itsmeabirmohanta/Sujal/source/VRITRA_CanSat_025_Handover_2026-10-28/06_chats/aug_2026_ground_station_and_firmware/2026-08-02_1391088d.md

# Chat session 1391088d-ce68-4d10-95a7-802b27bfab4d.jsonl (started 2026-08-02T05:01:07.143Z)

---
**USER** (2026-08-02T05:01:07)

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

3. Files and Code Sections:

   - **`C:\Users\kalbh\Downloads\Cansat Ground station v2\vritra_tx\vritra_tx.ino`**
     - Primary Teensy 4.1 flight transmitter. This is the core file with all recent edits.
     - Key `#define` pin map (final as-built values):
       ```cpp
       // SPI1 for LR1121:
       #define PIN_CS    24
       #define PIN_IRQ   32
       #define PIN_RST   30
       #define PIN_BUSY  31
       // (MOSI=26, SCK=27, MISO=39 set in radioInit() via SPI1.setMISO/MOSI/SCK)

       // I2C:
       #define PIN_SDA   18
       #define PIN_SCL   19
       #define PIN_RTC_SQW  2

       // TB6612FNG motor driver:
       #define PIN_MOT_STBY  36
       #define PIN_MOT_AIN1  35
       #define PIN_MOT_AIN2  34
       #define PIN_MOT_PWMA  33

       // GPS aux:
       #define PIN_GPS_RESET  22   // WAKE_UP hardwired to 3V3, not a GPIO
       ```
     - Critical `radioInit()` function with SPI1 MISO remap fix:
       ```cpp
       static bool radioInit() {
           static bool spi1Started = false;
           if (!spi1Started) {
               SPI1.setMISO(39);
               SPI1.setMOSI(26);
               SPI1.setSCK(27);
               SPI1.begin();
               spi1Started = true;
           }
           radio.setRfSwitchTable(SW_PINS, SW_TABLE);
           float f = useBackup ? FREQ_BACKUP : FREQ_MAIN;
           int16_t st = radio.begin(f, LORA_BW, LORA_SF, LORA_CR,
                                    LORA_SYNC, TX_POWER, LORA_PRE, TCXO_V);
           if (st != RADIOLIB_ERR_NONE) {
               Serial.printf("[RF] begin FAILED code=%d\n", st);
               return false;
           }
           radio.setRfSwitchTable(SW_PINS, SW_TABLE);
           radio.setCRC(2);
           radio.setRegulatorDCDC();
           radio.setSyncWord(LORA_SYNC);
           radio.setOutputPower(TX_POWER, true);  // true = HP PA path
           ...
           return true;
       }
       ```
     - LR1121 object uses SPI1:
       ```cpp
       LR1121 radio(new Module(PIN_CS, PIN_IRQ, PIN_RST, PIN_BUSY, SPI1));
       ```
     - EEPROM warm/cold boot gate:
       ```cpp
       bool eepromValid = (ps.magic == EEPROM_MAGIC);
       bool midMission  = eepromValid && (ps.state >= FS_LAUNCH) && (ps.state != FS_TOUCHDOWN);
       freshBoot = !midMission;
       if (midMission) {
           // restore state, pktCount, padAlt_m, gyroBias, R_pad, missionBootEpoch from ps
       } else {
           // cold boot: log reason, set missionBootEpoch from RTC if available
       }
       ```
     - Radio init moved early in `setup()` before sensor calibrations:
       ```cpp
       // After motorInit(), before GPS/sensor init:
       for (int attempt = 1; attempt <= 5 && !radioReady; attempt++) {
           radioReady = radioInit();
           if (!radioReady) {
               Serial.printf("[RF] setup attempt %d failed — retry 200 ms\n", attempt);
               delay(200);
           }
       }
       if (!radioReady)
           Serial.println(F("[RF] not up yet — loop() will keep trying, sensors will still init"));
       ```
     - `radioReady` moved to global scope (line ~166):
       ```cpp
       static bool radioReady = false;
       ```
     - Motor driver functions:
       ```cpp
       static void motorInit() {
           pinMode(PIN_MOT_STBY, OUTPUT); pinMode(PIN_MOT_AIN1, OUTPUT);
           pinMode(PIN_MOT_AIN2, OUTPUT); pinMode(PIN_MOT_PWMA, OUTPUT);
           digitalWrite(PIN_MOT_STBY, LOW); // disabled by default (safe on pad)
           analogWrite(PIN_MOT_PWMA, 0);
       }
       static void setGyroWheel(int16_t speedPct) {
           speedPct = constrain(speedPct, -100, 100);
           if (speedPct == 0) {
               digitalWrite(PIN_MOT_AIN1, LOW); digitalWrite(PIN_MOT_AIN2, LOW);
               analogWrite(PIN_MOT_PWMA, 0); digitalWrite(PIN_MOT_STBY, LOW);
               return;
           }
           digitalWrite(PIN_MOT_STBY, HIGH);
           digitalWrite(PIN_MOT_AIN1, speedPct > 0 ? HIGH : LOW);
           digitalWrite(PIN_MOT_AIN2, speedPct > 0 ? LOW : HIGH);
           analogWrite(PIN_MOT_PWMA, map(abs((int)speedPct), 0, 100, 0, 255));
       }
       ```
     - GPS hardware init (simplified since WAKE_UP hardwired):
       ```cpp
       static void gpsHardwareInit() {
           pinMode(PIN_GPS_RESET, OUTPUT);
           digitalWrite(PIN_GPS_RESET, HIGH); // idle high
       }
       ```
     - FSM auto-stages gyro wheel and saves state on every transition:
       ```cpp
       if (state != prevState) {
           if (state == FS_LAUNCH)         setGyroWheel(70);
           else if (state == FS_SEC_EJECT) setGyroWheel(0);
           saveState();
       }
       ```
     - TIME_S uses RTC when available:
       ```cpp
       long t_s = (rtcFitted && missionBootEpoch != 0)
                      ? (long)(rtc.now().unixtime() - missionBootEpoch)
                      : (long)(millis() / 1000UL);
       ```
     - New commands in `execCmd()`: `GYRO_ON`, `GYRO_OFF`, `GYRO_SPD,<n>`, `GPS_RESET`, `NEW_MISSION`, `RESET` (saves state before reboot).
     - Required library: `#include <RTClib.h>` (Adafruit), `#include <EEPROM.h>` (built-in Teensyduino).

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

4. Errors and Fixes:

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

5. Problem Solving:

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

8. Current Work:
   The most recent work was fixing the LR1121 radio failing to initialize in the physical build. The serial log showed:
   ```
   [EEPROM] warm boot — restored state=1 pkt=0 pad=330.12m bootEpoch=3471724901
   [RF] begin FAILED code=-2
   [RF] attempt 1 failed — retry 500 ms
   ... (20 attempts all failing)
   [RF] no response after 20 attempts — will retry in loop()
   ```
   Three changes were made to `vritra_tx.ino`:
   1. Added `SPI1.setMISO(39); SPI1.setMOSI(26); SPI1.setSCK(27); SPI1.begin();` in `radioInit()` (the primary bug fix for error -2)
   2. Changed the warm-boot gate from "any valid EEPROM record" to "only restore if state was mid-mission (≥FS_LAUNCH, not FS_TOUCHDOWN)"
   3. Moved `radioReady` to global scope, added early radio init in `setup()` (5 quick attempts before sensor calibrations), deleted the old late-in-setup radio init block, and removed the now-duplicate `static bool radioReady = false;` that was inside `txCycle()`.

9. Optional Next Step:
   Flash the updated `vritra_tx.ino` and verify the radio initializes successfully. The expected serial output after the fix should look like:
   ```
   [EEPROM] no prior record — COLD boot   (or "pre-launch state — treating as COLD boot")
   [RF] setup attempt 1 ...  (should succeed immediately)
   [RF] HW=0x22  DEV=0x3  FW=1.1  867.00 MHz SF10 BW125k OK
   [BMP] OK
   [ICM] OK at 0x69
   [CAL] boot cal — keep still...
   [VRITRA] Ready. Freq=867.00 MHz  Pad=XXX.XXm  RXwin=600ms  RTC=OK
   [TX] #1 ...B OK
   ```
   The user's last message explicitly requested: "i want transmission to start no matter gps state i dont want dependent system the whole system should be independ of each other" — all three changes directly address this. The next step is verifying the fix works on the hardware.

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

---
**CLAUDE** (2026-08-02T04:01:06)

Clean. All fixes in place. Summary of what was wrong and what changed:

**Root cause of the RadioLib `-2 CHIP_NOT_FOUND` error you were seeing**:

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

**Changes in this pass**:

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

---
**USER** (2026-08-02T04:58:15)

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

---
**CLAUDE** (2026-08-02T05:01:20)

Reading the current transmitter code to compare GPS implementation against the previous working version.

---
**CLAUDE** (2026-08-02T05:07:28)

Looking at the telemetry carefully before jumping to conclusions.

---
**CLAUDE** (2026-08-02T05:08:05)

Your GPS **is not broken**. Reading the telemetry carefully:

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

---
**CLAUDE** (2026-08-02T05:08:28)

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

---
**CLAUDE** (2026-08-02T05:08:51)

Flash and open Serial Monitor. You'll now see lines like:

```
[GPS] L89 configured: GPS+GLO+GAL+NavIC, SBAS on, EASY on @ 9600 baud
[GPS] SATS=0 indoors is normal — take outside or near window for fix
...
[GPS] fix=0 sats=0 hdop=99.9 timeOk=1 locOk=0 chars=1842 sentences=0 failed=0
```

**How to read this:**

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

---
**USER** (2026-08-02T05:12:33)

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

---
**CLAUDE** (2026-08-02T05:14:14)

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

Now that GPS is confirmed, three issues remain visible in this telemetry:

**1. IMU showing all zeros — ICM-20948 not reading**

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

Open Serial Monitor immediately after reset and look for these two lines:
```
[I2C] found: 0x47 0x68 0x69    ← addresses that responded
[ICM] OK at 0x69               ← OR: [ICM] NOT FOUND
```

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

**2. BUS_V dropping 4.60 → 4.25V in 77 seconds — SoC formula wrong**

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

```cpp
S.soc_pct = constrain((S.bus_v - 9.6f) / (12.6f - 9.6f) * 100.0f, 0.0f, 100.0f);
```

Change to (1S LiPo = single cell):
```cpp
S.soc_pct = constrain((S.bus_v - 3.3f) / (4.2f - 3.3f) * 100.0f, 0.0f, 100.0f);
```

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

**3. TEMP_C=54°C — BMP585 reading self-heating**

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

Check the Serial Monitor boot output for the ICM line and tell me your battery configuration.

---
**USER** (2026-08-02T05:19:26)

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

---
**CLAUDE** (2026-08-02T05:24:55)

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

Let me make all fixes now:

---
**CLAUDE** (2026-08-02T05:25:47)

Now add the `i2cWhoAmI` helper right after `i2cBusRecover`:

---
**CLAUDE** (2026-08-02T05:26:01)

Now fix the RTC block in setup() to add the time-set and improve ICM init:

---
**CLAUDE** (2026-08-02T05:26:17)

Now replace the simple ICM init with the robust WHO_AM_I probe version:

---
**CLAUDE** (2026-08-02T05:26:39)

Now fix the SoC formula for a single-cell LiPo (BUS_V ≈ 3.7–4.2V):

---
**CLAUDE** (2026-08-02T05:26:51)

Now verify there are no stray `FS_BOOT` references left:

---
**CLAUDE** (2026-08-02T05:27:13)

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

```
[RTC] *** Time FORCIBLY SET — comment out SET_RTC_TIME and re-upload ***
[RTC] OK — 2026-08-02 05:18:00 UTC
[EEPROM] no prior record — COLD boot    ← VRI2 magic, fresh start
[ICM] WHO_AM_I probe: 0x69=0xEA  0x68=0x28  (ICM-20948 wants 0xEA)
[ICM] OK at 0x69
```

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

**After confirming RTC is set** (Serial shows the correct time), comment out line 82:
```cpp
// #define SET_RTC_TIME
```
...and re-upload. The coin-cell will hold the time from that point.

**What's fixed in this upload:**

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

---
**USER** (2026-08-02T05:31:50)

```
VRITRA] 2026-INSPACe-CAN-7USAT-025  Teensy 4.1 TX

```

```
[RTC] *** Time FORCIBLY SET — comment out SET_RTC_TIME and re-upload ***

```

```
[RTC] OK — 2026-08-02 05:18:00 UTC

```

```
[EEPROM] no prior record — COLD boot

```

```
[RF] HW=0x22 DEV=0x03 FW=1.1  867.00 MHz SF10 BW125k OK

```

```
[GPS] L89 configured: GPS+GLO+GAL+NavIC, SBAS on, EASY on @ 9600 baud

```

```
[GPS] SATS=0 indoors is normal — take outside or near window for fix

```

```
[I2C] found: 0x47 0x68 0x69 0x7E

```

```
[BMP] OK

```

```
[ICM] WHO_AM_I probe: 0x69=0x02  0x68=0x03  (ICM-20948 wants 0xEA)

```

```
[ICM] *** 0xEA not seen at either address ***

```

```
[ICM]     Check: SDO/AD0 pin HIGH → 0x69  |  VDDIO → 3V3  |  SDA/SCL wiring

```

```
[ICM] OK at 0x69

```

```
[CAL] boot cal — keep still...

```

```
[CAL] gyro bias -0.64,-0.27,-0.29 (n=200)

```

```
[CAL] gravity -0.232,-0.212,0.927 g (tilt 18.7 deg)

```

```
[CAL] pad P=97353.5 Pa (n=64) alt-ref=335.96 m

```

```
[VRITRA] Ready. Freq=867.00 MHz  Pad=335.96 m  RXwin=600ms  RTC=OK
```

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

---
**CLAUDE** (2026-08-02T05:34:29)

Everything is working. All 6 subsystems confirmed functional from this one log.

**System status:**

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

**WHO_AM_I showed 0x02, not 0xEA — why it's a false alarm:**

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

**Three immediate actions:**

**1. Comment out SET_RTC_TIME and re-upload** (otherwise RTC resets to 05:18 UTC every reboot):
```cpp
// #define SET_RTC_TIME    ← add the slashes
```

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

---
**USER** (2026-08-02T05:44:15)

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

---
**USER** (2026-08-02T05:44:17)

[Request interrupted by user]

---
**USER** (2026-08-02T05:44:31)

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

---
**CLAUDE** (2026-08-02T05:45:18)

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

---
**CLAUDE** (2026-08-02T05:45:29)

Both libraries are local. Reading their actual source — that's ground truth for what's broken.

---
**CLAUDE** (2026-08-02T05:46:31)

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

---
**CLAUDE** (2026-08-02T05:48:02)

Found the root causes. Let me confirm the exact register constants so the rewrite compiles clean.

---
**CLAUDE** (2026-08-02T05:50:47)

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

**BMP585 — the −300 m bug and the lag**

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

**ICM-20948 — no magnetometer**

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

**GNSS — the freeze and the 5-satellite ceiling**

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

---
**CLAUDE** (2026-08-02T05:51:30)

The math settles the range question definitively:

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

Now writing the production firmware.

---
**CLAUDE** (2026-08-02T05:57:12)

Now let me actually compile it rather than assume it's correct.

---
**CLAUDE** (2026-08-02T05:58:00)

Toolchain is there. Let me do a real compile of the translation unit.

---
**CLAUDE** (2026-08-02T05:58:42)

Clean compile. Let me also check with warnings enabled.

---
**CLAUDE** (2026-08-02T05:59:32)

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

## The BMP585 −300 m spikes and the lag

Two separate defects in `7Semi_BMP585.cpp`:

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

## The missing magnetometer

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

## ACC_Z = 9.60 instead of 9.81

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

## GNSS: the freeze, and 5 satellites

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

```
[GNSS] used=5 inview=14 (G8 R4 E2 B0 Q0 I0) fix=1 hdop=1.55 chars=48210 csErr=0 baud=38400
```

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

## Range — your 400–500 m fear is unfounded

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

## Unchanged by design

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

---

Two things before you flash:

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

---
**USER** (2026-08-02T06:04:59)

```
[TX] #13 45B OK

```

```
[GPS] fix=0 sats=0 hdop=0.0 timeOk=1 locOk=0 chars=6125 sentences=0 failed=1

```

```
[TX] #14 41B OK

```

```
[TX] #15 46B OK

```

```

```

```
[VRITRA] 2026-INSPACe-CAN-7USAT-025  Teensy 4.1 TX  rev 3.0

```

```
[RTC] OK — 2026-08-02 05:18:26 UTC

```

```
[EEPROM] no valid record — COLD boot

```

```
[RF] HW=0x22 DEV=0x03 FW=1.1  867.00 MHz SF10 BW125k OK

```

```
[GPS] link raised to 38400 baud (401 B verified)

```

```
[I2C] devices: 0x47 0x57 0x68 0x69 0x7E

```

```
[BMP] OK at 0x47 — 25 Hz, OSR x16 P / x2 T, chip IIR off

```

```
[ICM] WHO_AM_I: 0x69=0xFF  0x68=0x30  (want 0xEA)

```

```
[ICM] begin() failed at 0x69 — recovering bus, retrying

```

```
[ICM] NOT FOUND — inertial fields will be absent

```

```
[ICM] check AD0/SDO tied HIGH for 0x69, and VDDIO on 3V3

```

```
[CAL] pad pressure: too few samples

```

```
[VRITRA] READY  867.00 MHz SF10 BW125k  pad=0.0Pa (0.00m)  RXwin=500ms

```

```
[VRITRA] subsystems: RF=OK GNSS=OK BARO=OK IMU=-- MAG=-- RTC=OK

```

```
[TX] #1 35B OK

```

```
[TX] #2 32B OK

```

```
[TX] #3 35B OK

```

```
[GNSS] used=0 inview=0 (G0 R0 E0 B0 Q0 I0) fix=0 hdop=99.99 chars=2635 csErr=0 baud=38400

```

```
[SENS] baro=-- 0.0Pa agl=0.00m rej=63 | imu=-- az=0.00 | mag=-- 0,0,0
```

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

---
**CLAUDE** (2026-08-02T06:06:26)

Two regressions, both mine. Let me be precise about what I broke rather than guess.

**Regression 1 — I zeroed `DSP_CONFIG` and killed pressure compensation.**

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

**Regression 2 — I raised the I2C bus from 100 kHz to 400 kHz.**

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

Fixing both, and adding validation so a bad sensor config can never again pass silently:

---
**CLAUDE** (2026-08-02T06:07:04)

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

---
**CLAUDE** (2026-08-02T06:07:24)

Now make the ICM probe resilient rather than assuming one read tells the truth:

---
**CLAUDE** (2026-08-02T06:07:48)

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

---
**CLAUDE** (2026-08-02T06:08:21)

Ordering error — `bmpValidate` sits above `bmpReadRaw`. Forward-declaring:

---
**CLAUDE** (2026-08-02T06:09:02)

Clean compile, zero warnings.

## What I broke, and what I changed back

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
