itsmeabirmohanta/Sujal/research/extracted/frequency_page_1.png

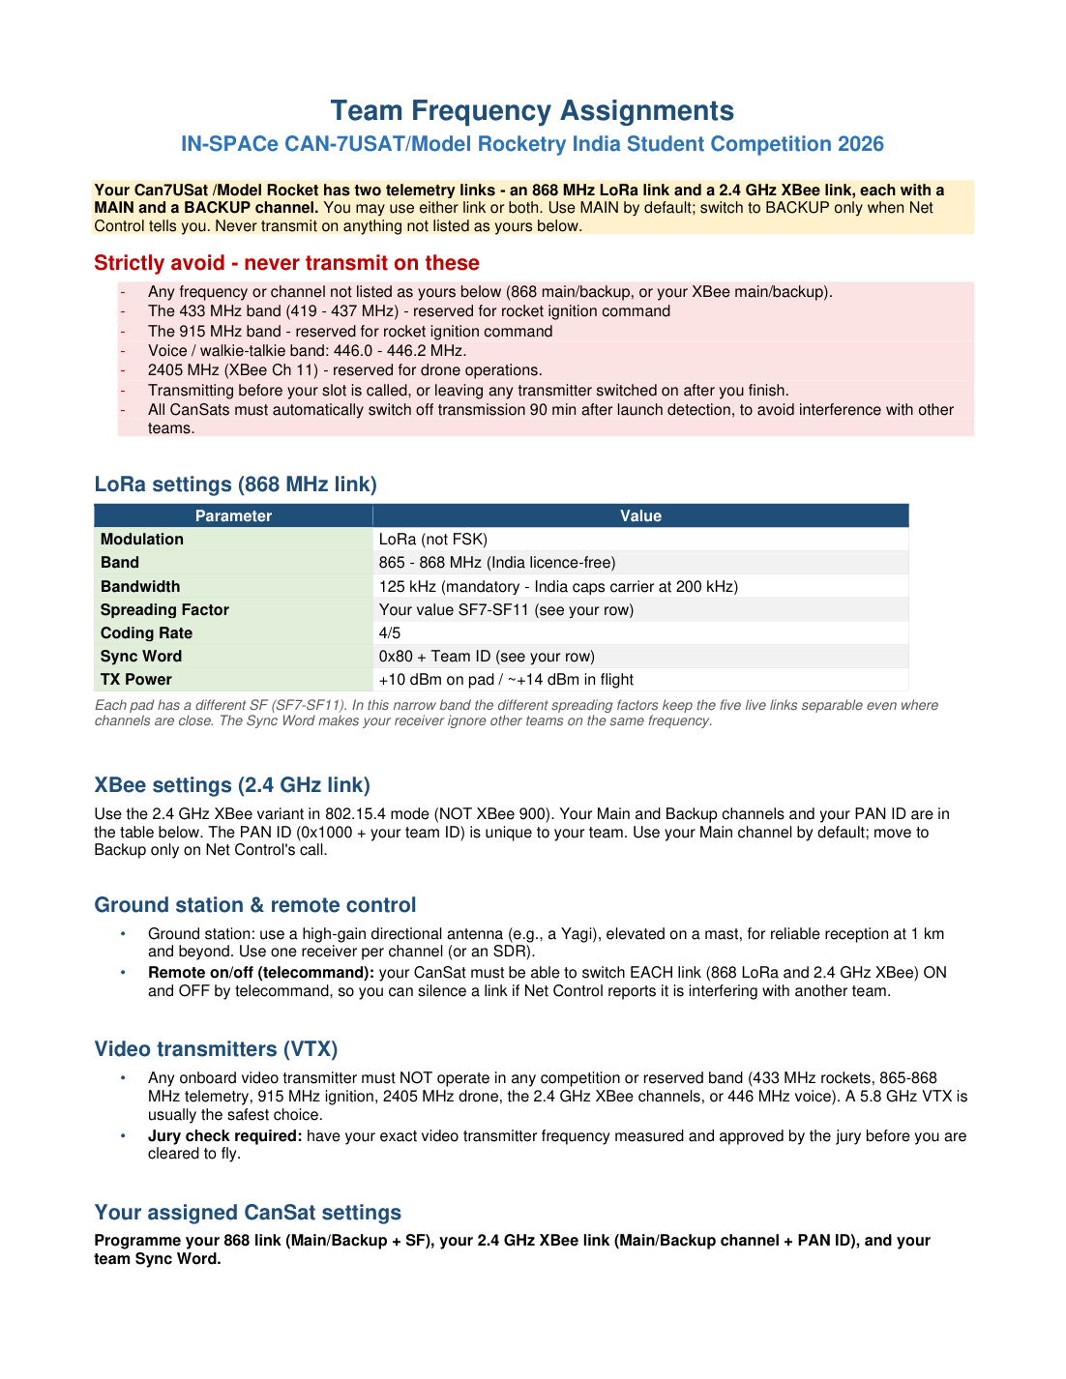
research/extracted/frequency_page_1.png
