itsmeabirmohanta/Sujal/research/extracted/frequency_page_2.png

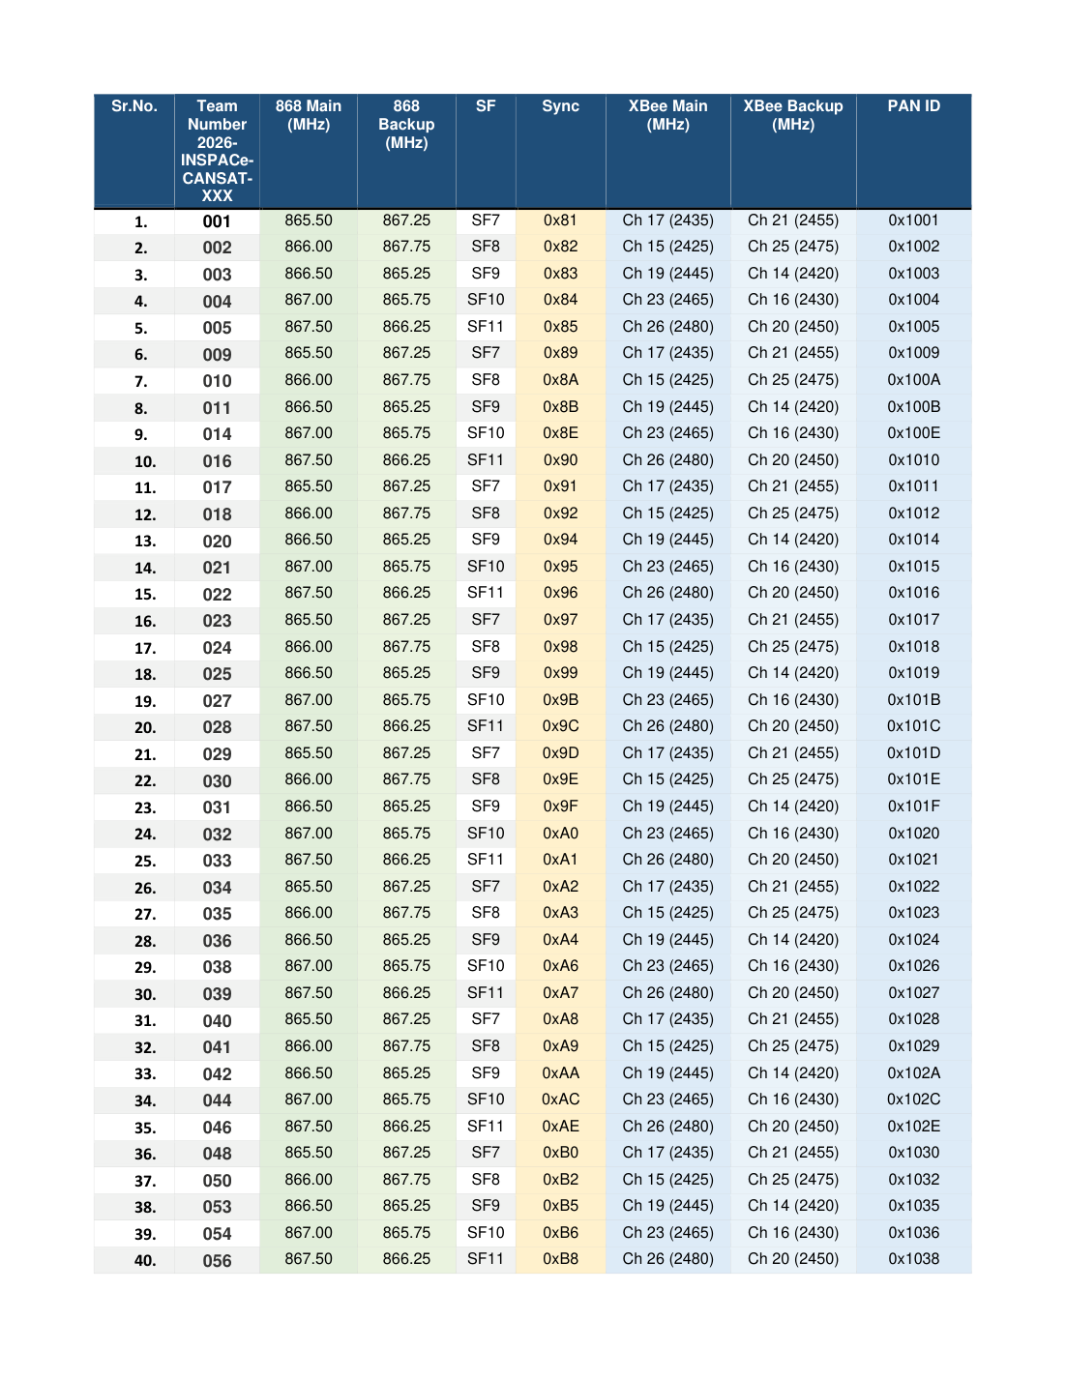
research/extracted/frequency_page_2.png
