itsmeabirmohanta/Sujal/research/extracted/frequency_page_3.png

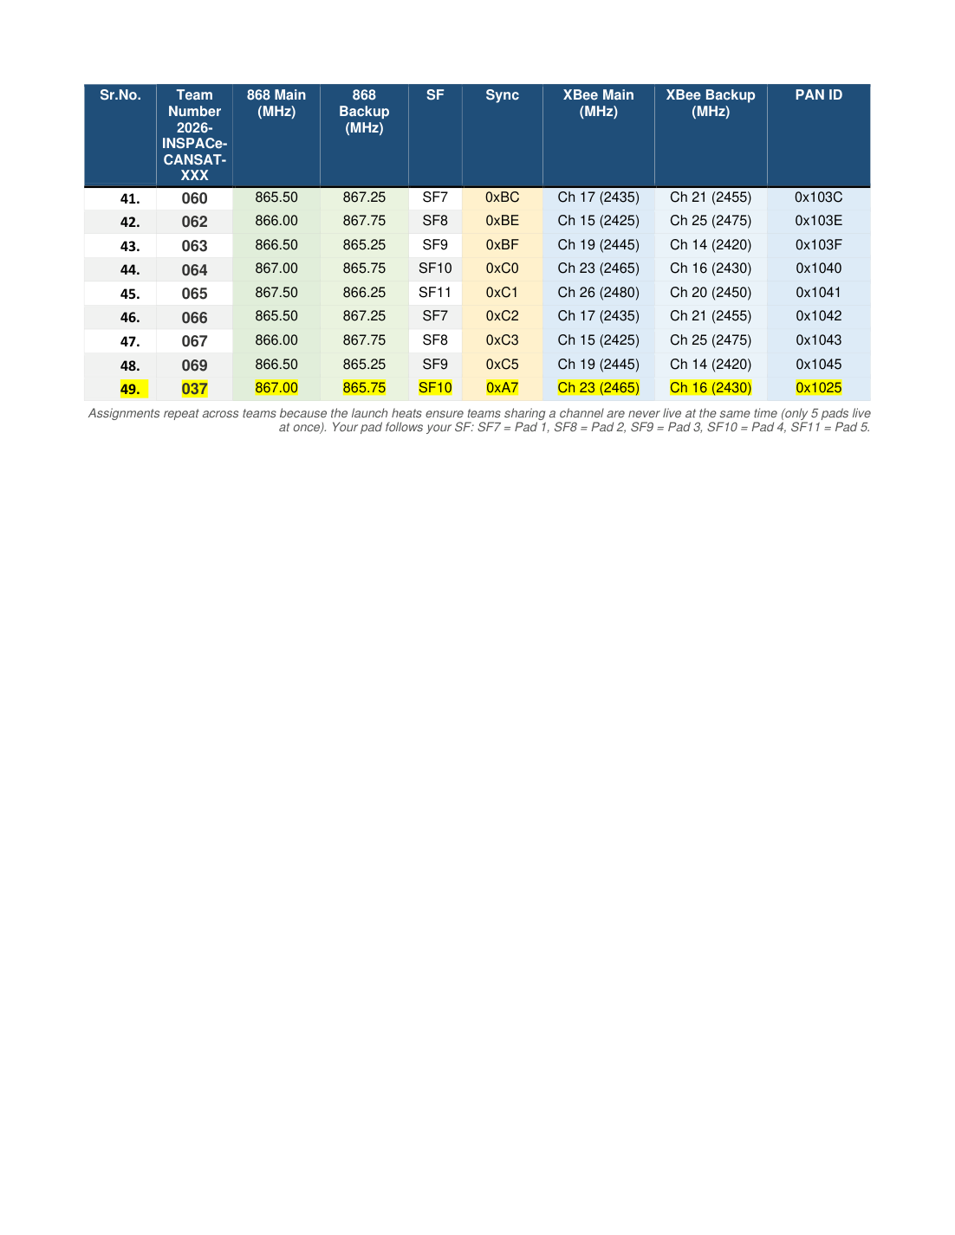
research/extracted/frequency_page_3.png
