itsmeabirmohanta/Sujal/source/VRITRA_CanSat_025_Handover_2026-10-28/03_kicad_current_boards/BOARD1_MAIN_Teensy41/BOARD1_MAIN_1L.png

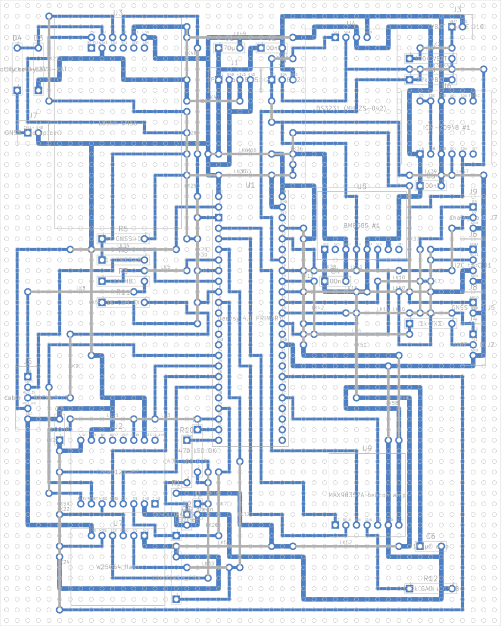
source/VRITRA_CanSat_025_Handover_2026-10-28/03_kicad_current_boards/BOARD1_MAIN_Teensy41/BOARD1_MAIN_1L.png
