itsmeabirmohanta/Sujal/source/VRITRA_CanSat_025_Handover_2026-10-28/03_kicad_current_boards/BOARD2_BACKUP_SENSOR_Teensy41/BOARD2_BACKUP_SENSOR_1L.png

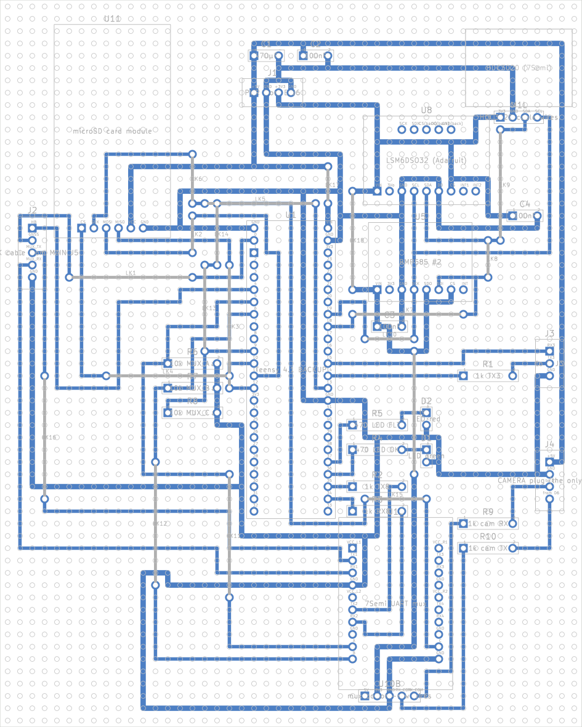
source/VRITRA_CanSat_025_Handover_2026-10-28/03_kicad_current_boards/BOARD2_BACKUP_SENSOR_Teensy41/BOARD2_BACKUP_SENSOR_1L.png
