itsmeabirmohanta/Sujal/source/VRITRA_CanSat_025_Handover_2026-10-28/03_kicad_current_boards/BOARD3_POWER/BOARD3_POWER_1L.png

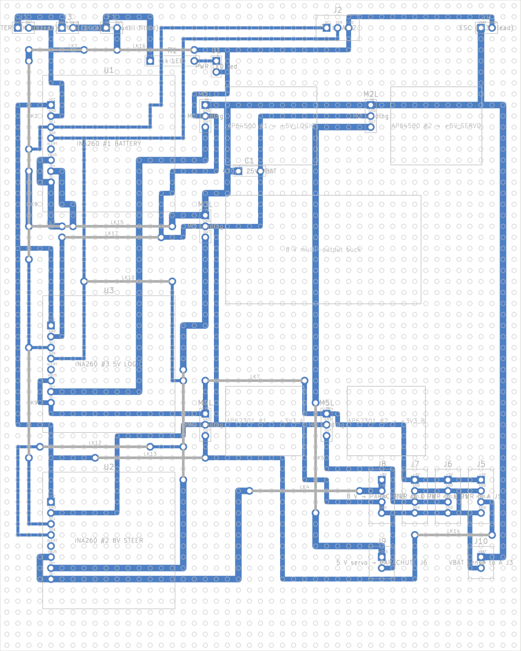
source/VRITRA_CanSat_025_Handover_2026-10-28/03_kicad_current_boards/BOARD3_POWER/BOARD3_POWER_1L.png
