itsmeabirmohanta/Sujal/source/VRITRA_CanSat_025_Handover_2026-10-28/03_kicad_current_boards/BOARD4_PARACHUTE_ESP32-P4-Pico/BOARD4_PICO_BOTTOM.png

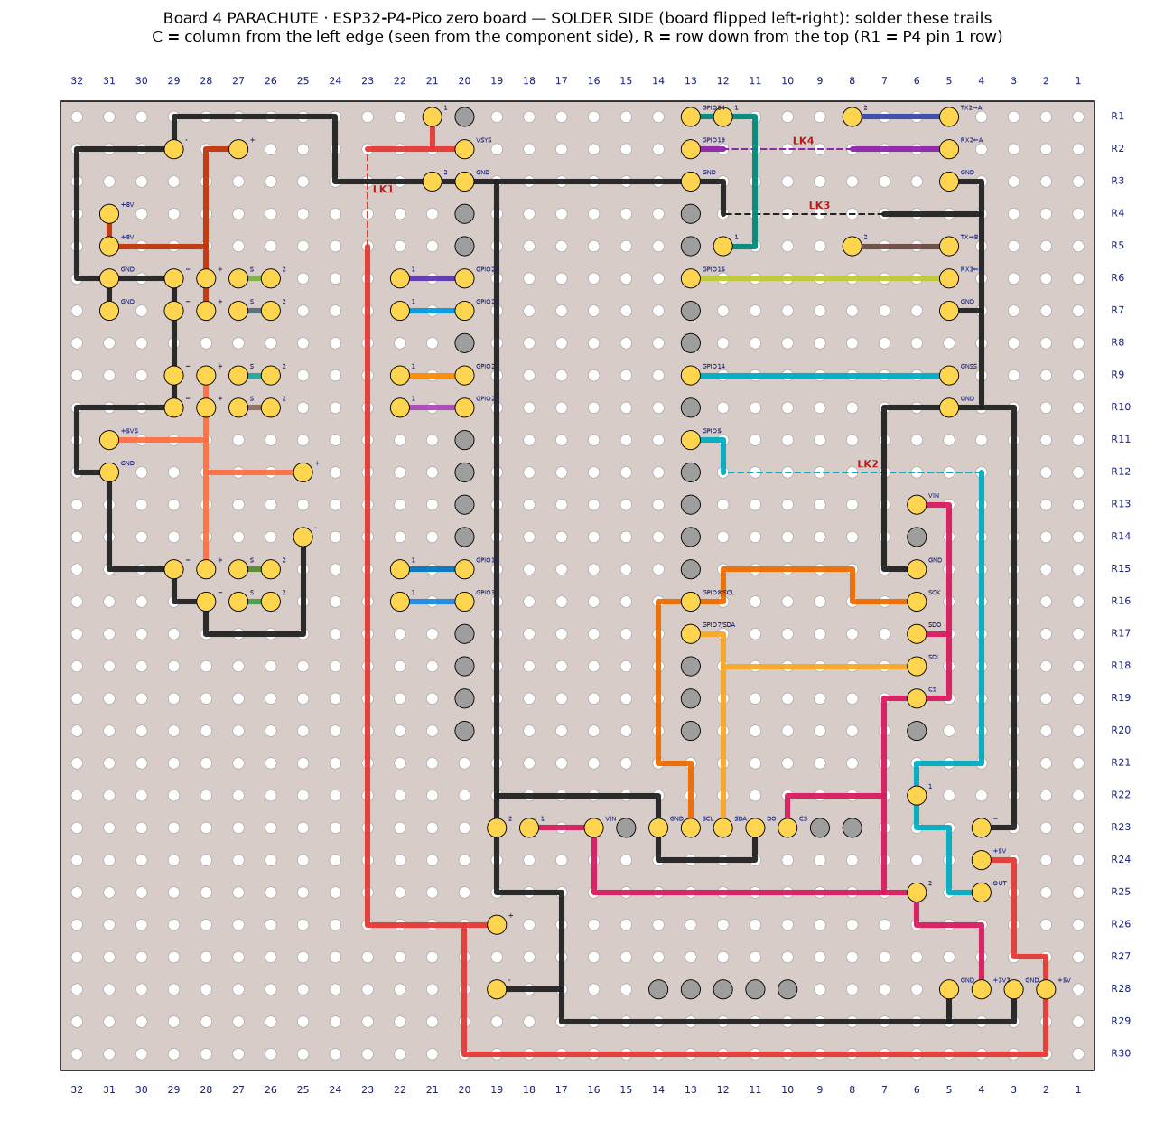
source/VRITRA_CanSat_025_Handover_2026-10-28/03_kicad_current_boards/BOARD4_PARACHUTE_ESP32-P4-Pico/BOARD4_PICO_BOTTOM.png
