itsmeabirmohanta/Sujal/source/VRITRA_CanSat_025_Handover_2026-10-28/03_kicad_current_boards/board_to_board_connectors/BOARD3_POWER_connectors.png

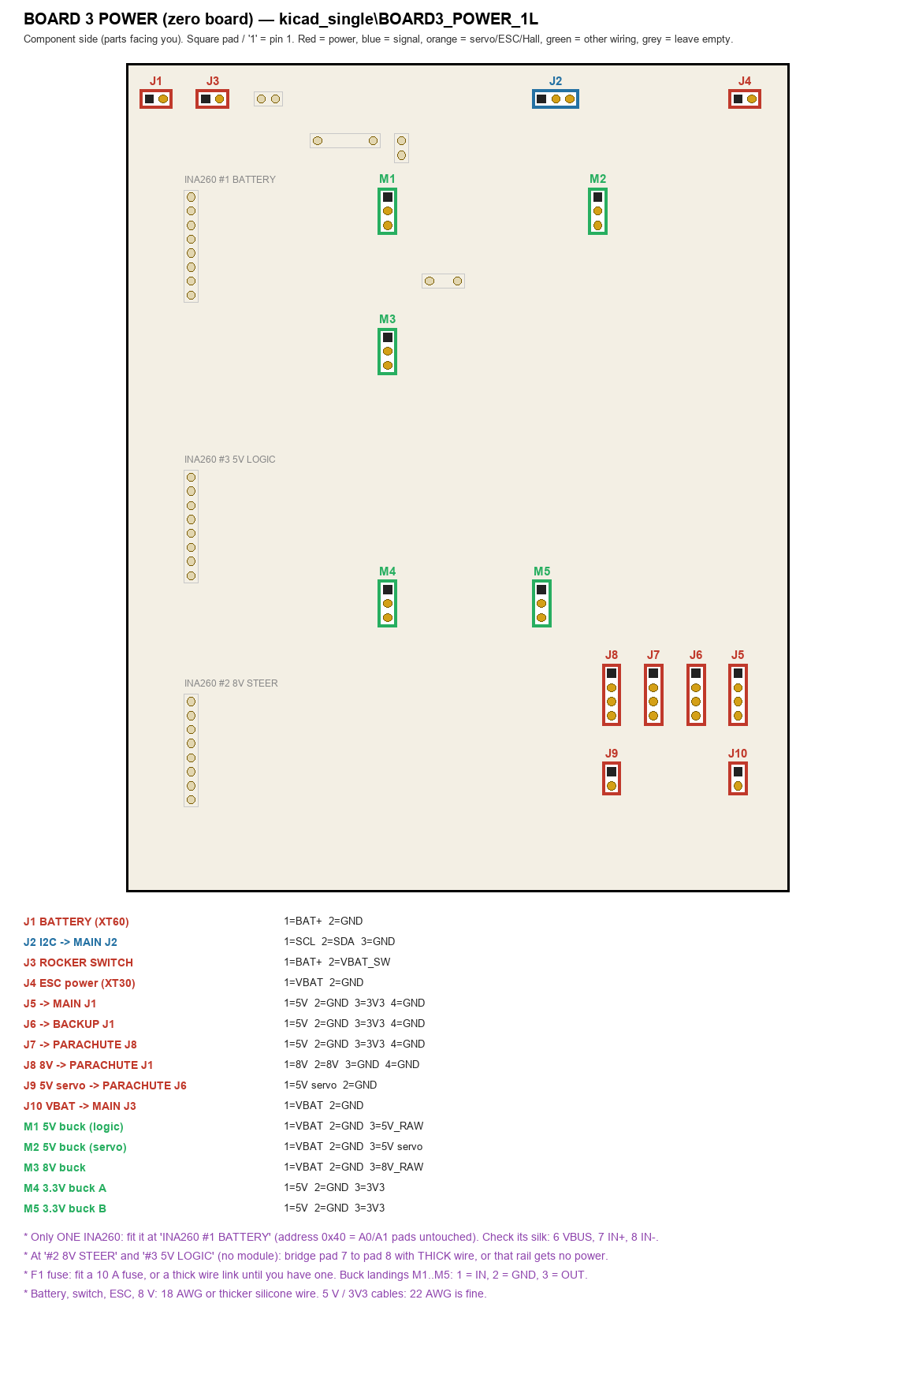
source/VRITRA_CanSat_025_Handover_2026-10-28/03_kicad_current_boards/board_to_board_connectors/BOARD3_POWER_connectors.png
