itsmeabirmohanta/Sujal/source/VRITRA_CanSat_025_Handover_2026-10-28/05_code/vritra-gcs-master_(CURRENT_repo)/firmware/vritra_cam/BOARD2_CAMERA_WIRES.png

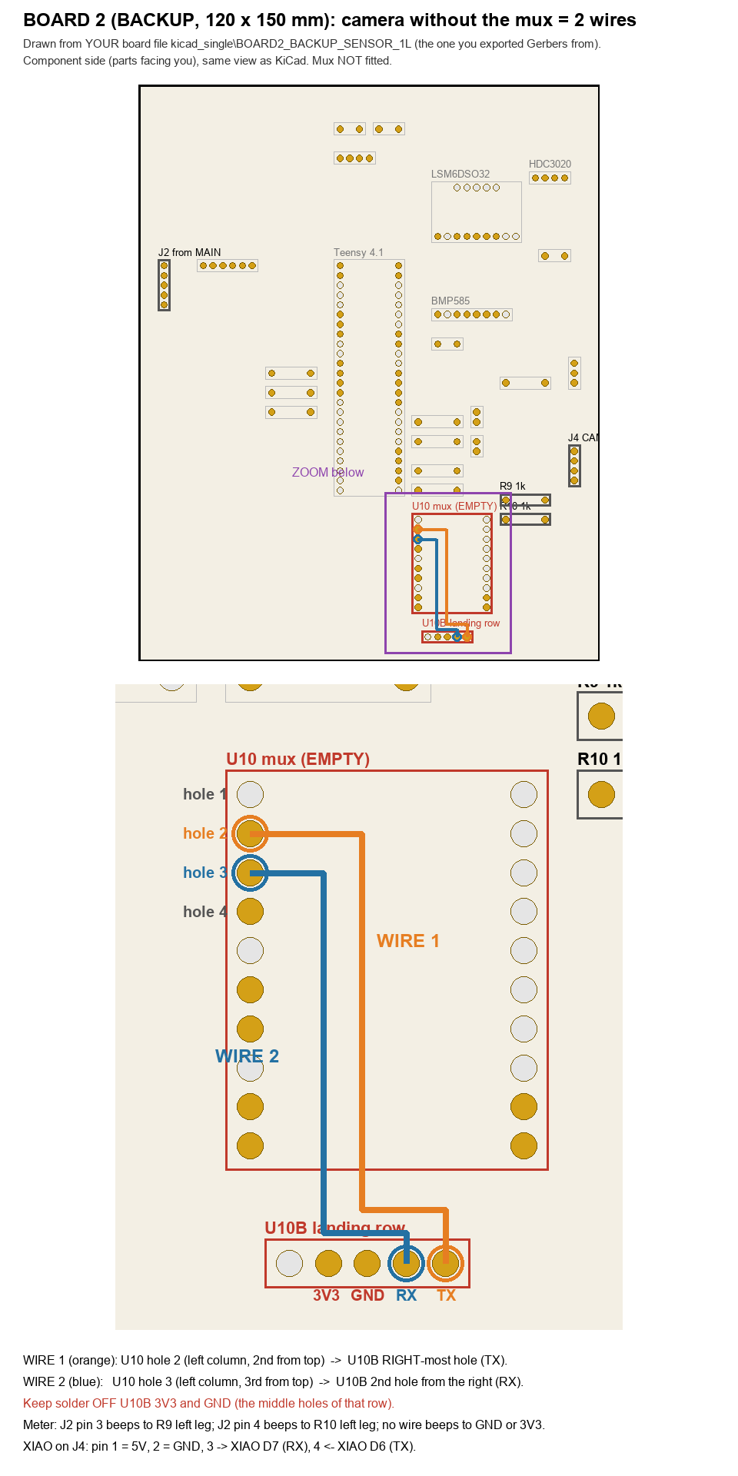
source/VRITRA_CanSat_025_Handover_2026-10-28/05_code/vritra-gcs-master_(CURRENT_repo)/firmware/vritra_cam/BOARD2_CAMERA_WIRES.png
