itsmeabirmohanta/Sujal/deliverables/TEST_EVIDENCE_TEMPLATE.csv

Test_ID | Method_and_acceptance | Status | Named_owner | Build_and_calibration_IDs | Date_UTC | Observed_result | Evidence_path_or_URL | Reviewer
T-PINS | Power-off continuity against ICD; check logic voltages, pull-ups, backfeeding and CS idle states; scope all GNSS listeners at both bauds | PENDING
T-BOOT | Cold/soft resets of each real board; no sweep/throttle; correct journal restore and RF silence; record P4 revision/options | PENDING
T-SENSOR | Read identities/configuration, sample counters and physical units; run supported self-tests; inject disconnects and stuck devices; reject0xFF | PENDING
T-GNSS | Record commands/ACKs/readbacks; measure1/5/10 Hz epochs, UART overflows, constellation trials, reboot and backup retention | PENDING
T-NAV | Reject checksum errors, RMC V, q0/DR, malformed coordinates, NaN, stale GSA, mixed/duplicate epochs, future timestamps and replay/default origins | PENDING
T-BARO | Pressure ramps at glide and drogue rates; physical opening must meet600±10 m including every error and delay | PENDING
T-EVENT | Descending950 m crossing, ascent inhibit, reset below threshold and reset before/during/after10 s exposure; no extra reopening | PENDING
T-INHIBIT | Lift, hover and attached-drone descent without release confirmation; no bay/petri/steering; test delayed/lost confirmation | PENDING
T-FSM | Actual drone profile with transient pressure/shock; correct states0–7, launch clock, pad datum and reset recovery | PENDING
T-LINK | Unplug MAIN, BACKUP and raw GNSS separately; inject CRC/sequence/one-way failures; verify authority and local P4 operation | PENDING
T-TARGET | Partial, repeated, old-session and out-of-area updates; int32 bounds; atomic commit and correct P4 echo | PENDING
T-RF | Capture actual RF CSV/CR/cadence, byte lengths and command slots; test TX ON/OFF, authorised channel switch, power/range and90-minute cutoff | PENDING
T-RESET | Reset at each phase and journal/ACK boundary, including89:59; corrupt one/both slots; no cutoff override or unsafe rollback | PENDING
T-LOG | Disconnect RF; fill/remove/slow SD; force flash timeout; control continues and records retain CRC/source/sample time | PENDING
T-POWER | Actual combined-load endurance for2 h pad plus flight; scope rails at loads; test overshoot, wheel startup, connectors and retention | PENDING
T-HALL/T-WHEEL | Tachometer/PPR agreement, stuck/noisy input, stop response, balance and rotor containment | PENDING
T-TIMING | Capture sample/parse/planner/PWM under full load; verify §8.5 targets, progress watchdog and deadline margins | PENDING
T-GCS/T-ISOLATE | Real serial→plots→judges CSV; missing data stays missing; simulation/replay cannot reach outputs or the flight file | PENDING
T-GLIDE/T-GUIDE | Authorised repeated drops: inflation,1–3 m/s sink, brake sign/response, safe authority, wind observability and independently measured landing error | PENDING
T-BEACON | Measure at least92 dB using the agreed setup, assembled enclosure and representative battery condition | PENDING
