itsmeabirmohanta/Sujal/source/VRITRA_CanSat_025_Handover_2026-10-28/04_handover_and_design_docs/parafoil_study/03_geom/canopy_domed_metres.stl

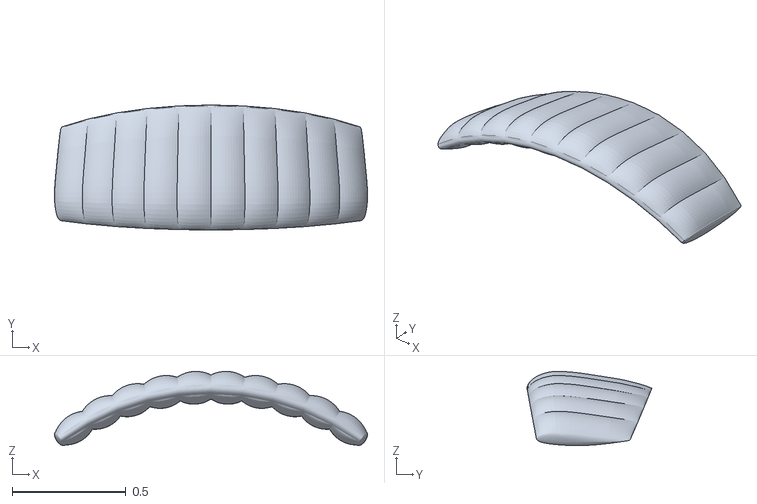
[picture p19: CAD file, 2026-10-28]
source/VRITRA_CanSat_025_Handover_2026-10-28/04_handover_and_design_docs/parafoil_study/03_geom/canopy_domed_metres.stl
1.38 x 0.55 x 0.327
