itsmeabirmohanta/Sujal/source/VRITRA_CanSat_025_Handover_2026-10-28/09_mechanical/VRITRA_CanSat.step

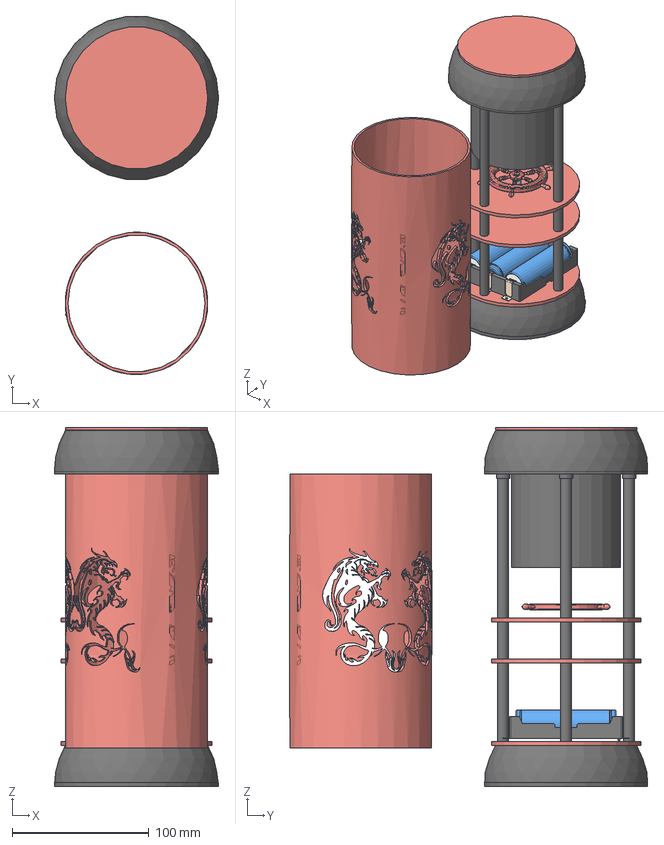
[picture p20: CAD file, 2026-10-28]
source/VRITRA_CanSat_025_Handover_2026-10-28/09_mechanical/VRITRA_CanSat.step
120.0 x 261.6 x 262.1 mm
wholecan
gyroplate x 3
Coreless_Motor_716
Ship wheel
perachute-bay
operplate
shellcanset
Hold_21700_Con_smd_m x 3
Hold_21700_Con_smd_p x 3
Hold_21700-3p_smd
