itsmeabirmohanta/Sujal/source/VRITRA_CanSat_025_Handover_2026-10-28/04_handover_and_design_docs/parafoil_study/03_geom/canopy_lower_metres.stl

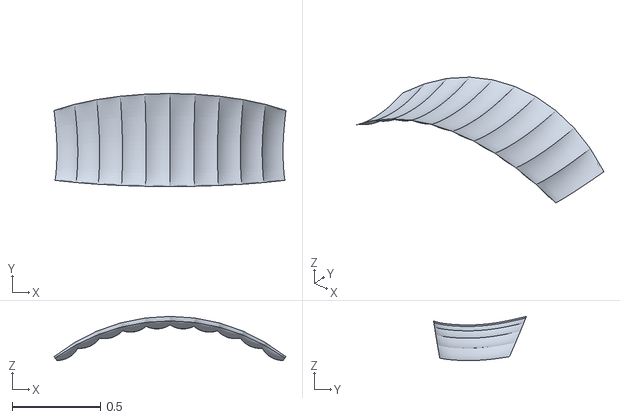
[picture p22: CAD file, 2026-10-28]
source/VRITRA_CanSat_025_Handover_2026-10-28/04_handover_and_design_docs/parafoil_study/03_geom/canopy_lower_metres.stl
1.31 x 0.527 x 0.25
