itsmeabirmohanta/Sujal/(list of files, cad)

Other CAD files:
source/VRITRA_CanSat_025_Handover_2026-10-28/04_handover_and_design_docs/parafoil_study/08_tailor/PF072_cutting_layered.dxf
source/VRITRA_CanSat_025_Handover_2026-10-28/04_handover_and_design_docs/parafoil_study/03_geom/canopy_merged_metres.stl
