itsmeabirmohanta/Sujal/source/VRITRA_CanSat_025_Handover_2026-10-28/03_kicad_current_boards/BOARD1_MAIN_Teensy41/BOARD1_MAIN_1L_BUILD_LIST.md

# VRITRA MAIN board — SINGLE-LAYER build list (same routes as the KiCad file)

Hole = C(column, 1 = left on the component side) R(row, 1 = bottom).
TRAIL = solder trail / bare tinned wire on the solder side, every hole in the run soldered, 90° turns only.
LINK = straight insulated wire link on the component side between the two holes (it jumps over other trails).

## GND
- pins: U1.GND (C27R40), U1.GND (C21R41), U1.GND (C27R27), U2.GND (C14R12), U2.GND (C14R18), U2.GND (C9R18), U3.GND (C14R56), U4.GND (C35R56), U5.GND (C33R36), U6.GND (C42R45), U6.GND (C42R50), U6.FSYNC (C45R50), U7.GND (C9R9), J1.GND (C22R52), J1.GND (C24R52), J2.GND (C28R52), J3.GND (C44R57), J6.GND (C45R33), J9.GND (C45R38), J4.GND (C45R26), J8.GND (C45R30), J5.GND (C3R20), U9.GND (C37R10), R12.2 (C43R4), C6.- (C42R8), J7.GND (C4R47), R8.2 (C43R52), D1.K (C19R11), D2.K (C18R10), C1.- (C23R55), C2.2 (C27R55), C3.2 (C6R20), C4.2 (C33R33), C5.2 (C42R42)
- TRAIL: C27R40→C26R40 · C26R40→C26R43
- TRAIL: C21R43→C21R41
- TRAIL: C21R43→C20R43 · C20R43→C20R45
- TRAIL: C28R45→C31R45 · C31R45→C31R37 · C31R37→C33R37 · C33R37→C33R36
- TRAIL: C33R36→C33R33
- TRAIL: C20R45→C20R56 · C20R56→C27R56 · C27R56→C27R53 · C27R53→C28R53 · C28R53→C28R52
- TRAIL: C23R56→C23R55
- TRAIL: C20R44→C22R44 · C22R44→C22R52
- TRAIL: C22R49→C24R49 · C24R49→C24R52
- TRAIL: C20R54→C15R54 · C15R54→C15R56 · C15R56→C14R56
- TRAIL: C27R56→C27R58 · C27R58→C35R58 · C35R58→C35R56
- TRAIL: C35R58→C44R58 · C44R58→C44R57
- TRAIL: C42R58→C42R52 · C42R52→C43R52
- TRAIL: C42R52→C42R50
- TRAIL: C42R51→C45R51 · C45R51→C45R50
- TRAIL: C42R50→C42R45
- TRAIL: C42R45→C42R42
- TRAIL: C46R43→C46R38 · C46R38→C45R38
- TRAIL: C46R38→C46R33 · C46R33→C45R33
- TRAIL: C46R33→C46R30 · C46R30→C45R30
- TRAIL: C46R30→C46R26 · C46R26→C45R26
- TRAIL: C45R26→C45R25 · C45R25→C28R25 · C28R25→C28R27 · C28R27→C27R27
- TRAIL: C37R18→C37R10
- TRAIL: C37R10→C37R7 · C37R7→C42R7 · C42R7→C42R8
- TRAIL: C42R7→C42R4 · C42R4→C43R4
- TRAIL: C20R46→C4R46 · C4R46→C4R47
- TRAIL: C42R4→C42R3 · C42R3→C29R3 · C29R3→C29R7 · C29R7→C22R7 · C22R7→C22R11 · C22R11→C19R11
- TRAIL: C19R11→C19R10 · C19R10→C18R10
- TRAIL: C18R10→C17R10 · C17R10→C17R11 · C17R11→C14R11 · C14R11→C14R12
- TRAIL: C9R46→C9R36
- TRAIL: C9R26→C10R26 · C10R26→C10R22 · C10R22→C14R22 · C14R22→C14R18
- TRAIL: C11R22→C11R19 · C11R19→C9R19 · C9R19→C9R18
- TRAIL: C11R21→C6R21 · C6R21→C6R20
- TRAIL: C6R20→C3R20
- TRAIL: C3R20→C3R10 · C3R10→C9R10 · C9R10→C9R9
- LINK LK1: C26R43 ↔ C21R43
- LINK LK2: C20R45 ↔ C28R45
- LINK LK3: C42R43 ↔ C46R43
- LINK LK4: C37R25 ↔ C37R18
- LINK LK5: C9R36 ↔ C9R26

## +5V_LOGIC
- pins: J1.+5V (C21R52), U1.VIN (C27R41), C1.+ (C21R55), C2.1 (C25R55), U9.Vin (C38R10), C6.+ (C40R8)
- TRAIL: C21R52→C21R55
- TRAIL: C21R53→C24R53 · C24R53→C24R55 · C24R55→C25R55
- TRAIL: C21R52→C21R45
- TRAIL: C26R45→C27R45 · C27R45→C27R41
- TRAIL: C27R42→C30R42 · C30R42→C30R37 · C30R37→C29R37
- TRAIL: C29R27→C29R26 · C29R26→C38R26
- TRAIL: C38R18→C38R10
- TRAIL: C38R18→C38R21 · C38R21→C33R21 · C33R21→C33R23 · C33R23→C40R23 · C40R23→C40R8
- LINK LK6: C21R45 ↔ C26R45
- LINK LK7: C29R37 ↔ C29R27
- LINK LK8: C38R26 ↔ C38R18

## +3V3_A
- pins: J1.+3V3 (C23R52), U2.3.3V (C8R18), U3.3V3 (C13R56), U3.WAKE (C10R55), U4.VCC (C34R56), U5.VIN (C31R36), U5.SDO (C35R36), U5.CS (C37R36), U6.VIN (C40R45), U7.3V3 (C14R9), R1.2 (C17R13), R2.2 (C17R7), J6.3V3 (C45R34), C3.1 (C6R18), C4.1 (C31R33), C5.1 (C40R42), D3.A (C4R51)
- TRAIL: C23R52→C23R50
- TRAIL: C18R50→C18R52
- TRAIL: C18R57→C13R57 · C13R57→C13R56
- TRAIL: C18R52→C12R52 · C12R52→C12R54 · C12R54→C10R54 · C10R54→C10R55
- TRAIL: C10R54→C6R54 · C6R54→C6R52 · C6R52→C4R52 · C4R52→C4R51
- TRAIL: C18R57→C18R56
- TRAIL: C28R56→C30R56 · C30R56→C30R57 · C30R57→C34R57 · C34R57→C34R56
- TRAIL: C34R56→C34R55 · C34R55→C37R55 · C37R55→C37R57 · C37R57→C41R57 · C41R57→C41R51 · C41R51→C39R51 · C39R51→C39R45 · C39R45→C40R45
- TRAIL: C40R45→C40R42
- TRAIL: C40R42→C40R41 · C40R41→C38R41 · C38R41→C38R37 · C38R37→C37R37 · C37R37→C37R36
- TRAIL: C37R37→C35R37 · C35R37→C35R36
- TRAIL: C35R36→C35R32 · C35R32→C31R32 · C31R32→C31R36
- TRAIL: C41R32→C44R32 · C44R32→C44R34 · C44R34→C45R34
- TRAIL: C34R22→C39R22 · C39R22→C39R8 · C39R8→C38R8
- TRAIL: C28R8→C26R8 · C26R8→C26R10 · C26R10→C23R10 · C23R10→C23R13 · C23R13→C17R13
- TRAIL: C17R8→C17R7
- TRAIL: C17R8→C14R8 · C14R8→C14R9
- TRAIL: C17R7→C21R7 · C21R7→C21R4 · C21R4→C6R4 · C6R4→C6R7
- TRAIL: C6R17→C8R17 · C8R17→C8R18
- TRAIL: C6R17→C6R18
- LINK LK9: C23R50 ↔ C18R50
- LINK LK10: C18R52 ↔ C18R57
- LINK LK11: C18R56 ↔ C28R56
- LINK LK12: C35R32 ↔ C41R32
- LINK LK13: C34R32 ↔ C34R22
- LINK LK14: C38R8 ↔ C28R8
- LINK LK15: C26R8 ↔ C17R8
- LINK LK16: C6R7 ↔ C6R17

## GNSS_VBCKP
- pins: U3.BAT (C10R56), D3.K (C4R55), D4.K (C2R55)
- TRAIL: C10R56→C10R57 · C10R57→C4R57 · C4R57→C4R55
- TRAIL: C4R55→C2R55

## GNSS_CELL
- pins: J7.CELL+ (C3R47), D4.A (C2R51)
- TRAIL: C3R47→C2R47 · C2R47→C2R51

## ICM_1V8
- pins: U6.1V8 (C41R45), U6.CS (C40R50), U6.SDO (C41R50)
- TRAIL: C41R45→C41R50
- TRAIL: C41R50→C40R50

## SDA
- pins: U1.18 (C27R33), U4.SDA (C33R56), U5.SDI (C36R36), U6.SDA (C44R45), J2.SDA (C27R52)
- TRAIL: C27R33→C30R33
- TRAIL: C30R28→C37R28 · C37R28→C37R34 · C37R34→C36R34 · C36R34→C36R36
- TRAIL: C36R35→C39R35 · C39R35→C39R40 · C39R40→C41R40 · C41R40→C41R41 · C41R41→C44R41 · C44R41→C44R45
- TRAIL: C44R44→C46R44 · C46R44→C46R53
- TRAIL: C39R53→C33R53 · C33R53→C33R50 · C33R50→C27R50 · C27R50→C27R52
- TRAIL: C33R53→C33R56
- LINK LK17: C30R33 ↔ C30R28
- LINK LK18: C46R53 ↔ C39R53

## SCL
- pins: U1.19 (C27R34), U4.SCL (C32R56), U5.SCK (C34R36), U6.SCL (C43R45), J2.SCL (C26R52)
- TRAIL: C27R34→C29R34
- TRAIL: C34R34→C34R36
- TRAIL: C34R36→C34R41 · C34R41→C33R41 · C33R41→C33R46 · C33R46→C27R46 · C27R46→C27R48 · C27R48→C38R48 · C38R48→C38R43 · C38R43→C39R43
- TRAIL: C43R43→C43R45
- TRAIL: C27R48→C26R48
- TRAIL: C26R50→C26R52
- TRAIL: C26R52→C26R54
- TRAIL: C28R54→C28R55 · C28R55→C31R55 · C31R55→C31R56 · C31R56→C32R56
- LINK LK19: C29R34 ↔ C34R34
- LINK LK20: C39R43 ↔ C43R43
- LINK LK21: C26R48 ↔ C26R50
- LINK LK22: C26R54 ↔ C28R54

## GNSS_TX
- pins: U3.TX (C11R56), U1.7 (C21R33), R5.1 (C10R37), R6.1 (C10R35)
- TRAIL: C11R56→C11R58 · C11R58→C5R58
- TRAIL: C5R50→C13R50 · C13R50→C13R49 · C13R49→C18R49
- TRAIL: C18R45→C11R45 · C11R45→C11R37 · C11R37→C10R37
- TRAIL: C10R37→C10R35
- TRAIL: C10R36→C15R36 · C15R36→C15R33 · C15R33→C21R33
- LINK LK23: C5R58 ↔ C5R50
- LINK LK24: C18R49 ↔ C18R45

## GNSS_RX
- pins: U3.RX (C12R56), U1.8 (C21R32)
- TRAIL: C12R56→C12R58 · C12R58→C19R58 · C19R58→C19R55
- TRAIL: C19R45→C19R41
- TRAIL: C19R31→C20R31 · C20R31→C20R32 · C20R32→C21R32
- LINK LK25: C19R55 ↔ C19R45
- LINK LK26: C19R41 ↔ C19R31

## GNSS_RST
- pins: U3.RST (C9R56), U1.6 (C21R34)
- TRAIL: C9R56→C5R56 · C5R56→C5R54 · C5R54→C3R54 · C3R54→C3R48 · C3R48→C14R48 · C14R48→C14R47 · C14R47→C18R47
- TRAIL: C18R37→C19R37
- TRAIL: C19R34→C21R34
- LINK LK27: C18R47 ↔ C18R37
- LINK LK28: C19R37 ↔ C19R34

## LORA_CS
- pins: U2.CS (C13R12), U1.29 (C21R21), R1.1 (C17R9)
- TRAIL: C13R12→C13R10 · C13R10→C15R10 · C15R10→C15R9 · C15R9→C17R9
- TRAIL: C17R9→C21R9
- TRAIL: C21R15→C22R15 · C22R15→C22R21 · C22R21→C21R21
- LINK LK29: C21R9 ↔ C21R15

## LORA_BUSY
- pins: U2.BUSY (C8R12), U1.24 (C21R26)
- TRAIL: C8R12→C8R13 · C8R13→C5R13
- TRAIL: C5R23→C5R27 · C5R27→C13R27 · C13R27→C13R26 · C13R26→C21R26
- LINK LK30: C5R13 ↔ C5R23

## LORA_RST
- pins: U2.RESET (C9R12), U1.25 (C21R25)
- TRAIL: C9R12→C9R14 · C9R14→C5R14 · C5R14→C5R19 · C5R19→C7R19 · C7R19→C7R20
- TRAIL: C15R20→C15R25 · C15R25→C21R25
- LINK LK31: C7R20 ↔ C15R20

## LORA_IRQ
- pins: U2.DIO9 (C13R18), U1.30 (C21R20)
- TRAIL: C13R18→C13R20
- TRAIL: C19R20→C21R20
- LINK LK32: C13R20 ↔ C19R20

## MOSI1
- pins: U1.26 (C21R24), U2.MOSI (C11R12), U7.MOSI (C10R9)
- TRAIL: C21R24→C16R24 · C16R24→C16R17 · C16R17→C11R17 · C11R17→C11R12
- TRAIL: C11R15→C6R15
- TRAIL: C6R8→C10R8 · C10R8→C10R9
- LINK LK33: C6R15 ↔ C6R8

## SCK1
- pins: U1.27 (C21R23), U2.CLK (C12R12), U7.SCK (C11R9)
- TRAIL: C21R23→C17R23 · C17R23→C17R15 · C17R15→C12R15 · C12R15→C12R12
- TRAIL: C17R16→C20R16 · C20R16→C20R15
- TRAIL: C20R5→C11R5 · C11R5→C11R9
- LINK LK34: C20R15 ↔ C20R5

## MISO1
- pins: U1.39 (C27R24), U2.MISO (C10R12), U7.MISO (C12R9)
- TRAIL: C27R24→C44R24 · C44R24→C44R2 · C44R2→C6R2
- TRAIL: C6R11→C10R11 · C10R11→C10R12
- TRAIL: C10R11→C12R11 · C12R11→C12R9
- LINK LK35: C6R2 ↔ C6R11

## FLASH_CS
- pins: U1.9 (C21R31), U7.CS (C13R9), R2.1 (C17R3)
- TRAIL: C21R31→C22R31 · C22R31→C22R22 · C22R22→C23R22 · C23R22→C23R16
- TRAIL: C23R6→C22R6
- TRAIL: C18R6→C13R6 · C13R6→C13R9
- TRAIL: C22R6→C22R3 · C22R3→C17R3
- LINK LK36: C23R16 ↔ C23R6
- LINK LK37: C22R6 ↔ C18R6

## HB_OUT
- pins: U1.5 (C21R35), R3.1 (C10R33)
- TRAIL: C21R35→C18R35 · C18R35→C18R34
- TRAIL: C14R34→C12R34 · C12R34→C12R33 · C12R33→C10R33
- LINK LK38: C18R34 ↔ C14R34

## HB_J5
- pins: R3.2 (C14R33), J5.HB (C3R24)
- TRAIL: C14R33→C14R32 · C14R32→C13R32
- TRAIL: C3R32→C3R24
- LINK LK39: C13R32 ↔ C3R32

## CAM_TX
- pins: U1.1 (C21R39), R11.1 (C10R31)
- TRAIL: C21R39→C19R39
- TRAIL: C19R29→C13R29 · C13R29→C13R31 · C13R31→C10R31
- LINK LK40: C19R39 ↔ C19R29

## CAM_TX_J
- pins: R11.2 (C14R31), J5.MUX_TX (C3R22)
- TRAIL: C14R31→C18R31 · C18R31→C18R30 · C18R30→C20R30 · C20R30→C20R28 · C20R28→C7R28
- TRAIL: C7R22→C3R22
- LINK LK41: C7R28 ↔ C7R22

## CAM_RX
- pins: J5.MUX_RX (C3R21), U1.0 (C21R40)
- TRAIL: C3R21→C2R21 · C2R21→C2R36 · C2R36→C7R36
- TRAIL: C17R36→C17R40 · C17R40→C21R40
- LINK LK42: C7R36 ↔ C17R36

## AMP_DIN
- pins: U1.2 (C21R38), U9.DIN (C34R10)
- TRAIL: C21R38→C25R38 · C25R38→C25R34 · C25R34→C26R34 · C26R34→C26R17 · C26R17→C34R17 · C34R17→C34R10

## AMP_LRC
- pins: U1.3 (C21R37), U9.LRC (C32R10)
- TRAIL: C21R37→C24R37 · C24R37→C24R26 · C24R26→C25R26 · C25R26→C25R14 · C25R14→C29R14 · C29R14→C29R11 · C29R11→C32R11 · C32R11→C32R10

## AMP_BCLK
- pins: U1.4 (C21R36), U9.BCLK (C33R10)
- TRAIL: C21R36→C22R36 · C22R36→C22R32 · C22R32→C23R32 · C23R32→C23R25 · C23R25→C24R25 · C24R25→C24R11 · C24R11→C27R11 · C27R11→C27R9 · C27R9→C33R9 · C33R9→C33R10

## AMP_SD
- pins: U1.37 (C27R22), U9.SD (C36R10)
- TRAIL: C27R22→C28R22 · C28R22→C28R20 · C28R20→C36R20 · C36R20→C36R10

## AMP_GAIN
- pins: U9.GAIN (C35R10), R12.1 (C39R4)
- TRAIL: C35R10→C35R9 · C35R9→C36R9 · C36R9→C36R4 · C36R4→C39R4

## TX3
- pins: U1.14 (C27R29), R4.1 (C39R29)
- TRAIL: C27R29→C28R29 · C28R29→C28R28 · C28R28→C29R28
- TRAIL: C39R28→C39R29
- LINK LK43: C29R28 ↔ C39R28

## TX3_J4
- pins: R4.2 (C43R29), J4.TX3 (C45R27)
- TRAIL: C43R29→C43R27 · C43R27→C45R27

## RX3
- pins: U1.15 (C27R30), J4.RX3 (C45R28)
- TRAIL: C27R30→C33R30
- TRAIL: C43R30→C44R30 · C44R30→C44R29 · C44R29→C45R29 · C45R29→C45R28
- LINK LK44: C33R30 ↔ C43R30

## GNSS_D
- pins: R5.2 (C14R37), J8.GNSS (C45R31)
- TRAIL: C14R37→C15R37 · C15R37→C15R43 · C15R43→C18R43
- TRAIL: C28R43→C28R44
- TRAIL: C28R47→C37R47 · C37R47→C37R42 · C37R42→C39R42
- TRAIL: C39R32→C39R31 · C39R31→C45R31
- LINK LK45: C18R43 ↔ C28R43
- LINK LK46: C28R44 ↔ C28R47
- LINK LK47: C39R42 ↔ C39R32

## GNSS_B
- pins: R6.2 (C14R35), J5.GNSS (C3R23)
- TRAIL: C14R35→C11R35 · C11R35→C11R34 · C11R34→C6R34 · C6R34→C6R28 · C6R28→C4R28 · C4R28→C4R23 · C4R23→C3R23

## VBAT_SENSE
- pins: J3.VBAT (C43R57), R7.1 (C39R54)
- TRAIL: C43R57→C43R55
- TRAIL: C40R55→C40R54 · C40R54→C39R54
- LINK LK48: C43R55 ↔ C40R55

## BUS_V
- pins: R7.2 (C43R54), R8.1 (C39R52), U1.20 (C27R35)
- TRAIL: C43R54→C43R53
- TRAIL: C40R53→C40R52 · C40R52→C39R52
- TRAIL: C39R52→C34R52 · C34R52→C34R49 · C34R49→C25R49 · C25R49→C25R39 · C25R39→C26R39 · C26R39→C26R35 · C26R35→C27R35
- LINK LK49: C43R53 ↔ C40R53

## SDA1
- pins: U1.17 (C27R32), J6.SDA1 (C45R36)
- TRAIL: C27R32→C29R32
- TRAIL: C38R32→C38R27 · C38R27→C41R27 · C41R27→C41R30
- TRAIL: C41R36→C45R36
- LINK LK50: C29R32 ↔ C38R32
- LINK LK51: C41R30 ↔ C41R36

## SCL1
- pins: U1.16 (C27R31), J6.SCL1 (C45R35)
- TRAIL: C27R31→C36R31 · C36R31→C36R33
- TRAIL: C40R33→C41R33
- TRAIL: C41R35→C45R35
- LINK LK52: C36R33 ↔ C40R33
- LINK LK53: C41R33 ↔ C41R35

## ENV_UV
- pins: U1.22 (C27R37), J9.UV (C45R39)
- TRAIL: C27R37→C28R37 · C28R37→C28R36 · C28R36→C30R36 · C30R36→C30R34
- TRAIL: C38R34→C43R34
- TRAIL: C43R38→C44R38 · C44R38→C44R39 · C44R39→C45R39
- LINK LK54: C30R34 ↔ C38R34
- LINK LK55: C43R34 ↔ C43R38

## ENV_O3
- pins: U1.23 (C27R38), J9.O3 (C45R40)
- TRAIL: C27R38→C29R38
- TRAIL: C29R29→C34R29 · C34R29→C34R30
- TRAIL: C39R30→C40R30
- TRAIL: C40R36→C40R37 · C40R37→C42R37 · C42R37→C42R40 · C42R40→C45R40
- LINK LK56: C29R38 ↔ C29R29
- LINK LK57: C34R30 ↔ C39R30
- LINK LK58: C40R30 ↔ C40R36

## LED_OK
- pins: U1.31 (C21R19), R9.1 (C19R19)
- TRAIL: C21R19→C19R19

## LED_OK_A
- pins: R9.2 (C19R15), D1.A (C19R12)
- TRAIL: C19R15→C19R14 · C19R14→C20R14
- TRAIL: C20R12→C19R12
- LINK LK59: C20R14 ↔ C20R12

## LED_FLT
- pins: U1.32 (C21R18), R10.1 (C18R18)
- TRAIL: C21R18→C18R18

## LED_FLT_A
- pins: R10.2 (C18R14), D2.A (C18R11)
- TRAIL: C18R14→C16R14 · C16R14→C16R12 · C16R12→C18R12 · C18R12→C18R11
