itsmeabirmohanta/Sujal/source/VRITRA_CanSat_025_Handover_2026-10-28/03_kicad_current_boards/BOARD2_BACKUP_SENSOR_Teensy41/BOARD2_BACKUP_SENSOR_1L_BUILD_LIST.md

# VRITRA BACKUP_SENSOR board — SINGLE-LAYER build list (same routes as the KiCad file)

Hole = C(column, 1 = left on the component side) R(row, 1 = bottom).
TRAIL = solder trail / bare tinned wire on the solder side, every hole in the run soldered, 90° turns only.
LINK = straight insulated wire link on the component side between the two holes (it jumps over other trails).

## GND
- pins: U1.GND (C27R40), U1.GND (C21R41), U1.GND (C27R27), U5.GND (C33R36), U8.GND (C33R44), U8.DO (C36R44), J1.GND (C22R52), J1.GND (C24R52), J2.GND (C3R37), J3.GND (C45R29), J4.GND (C45R21), D1.K (C35R22), D2.K (C35R25), C1.- (C23R55), C2.2 (C27R55), C3.2 (C33R33), C4.2 (C44R42), U10.GND (C29R12), U10.GND (C36R6), U10B.GND (C32R3), R6.2 (C18R30), R7.2 (C18R28), R8.2 (C18R26), U11.GND (C12R41), M1L.GND (C42R50)
- TRAIL: C27R40→C28R40 · C28R40→C28R44 · C28R44→C15R44 · C15R44→C15R41 · C15R41→C21R41
- TRAIL: C15R41→C12R41
- TRAIL: C28R42→C33R42 · C33R42→C33R44
- TRAIL: C33R44→C33R45 · C33R45→C36R45 · C36R45→C36R44
- TRAIL: C33R42→C33R36
- TRAIL: C33R36→C33R33
- TRAIL: C28R44→C28R47 · C28R47→C22R47 · C22R47→C22R53 · C22R53→C24R53 · C24R53→C24R52
- TRAIL: C23R53→C23R55
- TRAIL: C23R54→C27R54 · C27R54→C27R55
- TRAIL: C36R44→C36R41 · C36R41→C44R41 · C44R41→C44R42
- TRAIL: C27R54→C42R54 · C42R54→C42R50
- TRAIL: C25R44→C25R27 · C25R27→C30R27 · C30R27→C30R24 · C30R24→C35R24 · C35R24→C35R25
- TRAIL: C35R24→C36R24 · C36R24→C36R22 · C36R22→C35R22
- TRAIL: C31R24→C31R16 · C31R16→C20R16 · C20R16→C20R25 · C20R25→C18R25 · C18R25→C18R30
- TRAIL: C30R16→C30R12 · C30R12→C29R12
- TRAIL: C36R22→C36R21 · C36R21→C45R21
- TRAIL: C44R21→C44R29 · C44R29→C45R29
- TRAIL: C29R12→C14R12 · C14R12→C14R13 · C14R13→C12R13 · C12R13→C12R2 · C12R2→C32R2 · C32R2→C32R3
- TRAIL: C32R3→C32R6 · C32R6→C36R6
- TRAIL: C20R20→C3R20 · C3R20→C3R37

## +5V_LOGIC
- pins: J1.+5V (C21R52), U1.VIN (C27R41), C1.+ (C21R55), C2.1 (C25R55), J4.+5V (C45R22), U11.VCC (C11R41)
- TRAIL: C21R52→C21R55
- TRAIL: C21R55→C21R56 · C21R56→C25R56 · C25R56→C25R55
- TRAIL: C21R52→C21R46 · C21R46→C27R46
- TRAIL: C27R43→C27R41
- TRAIL: C21R46→C11R46 · C11R46→C11R41
- TRAIL: C25R56→C46R56 · C46R56→C46R22 · C46R22→C45R22
- LINK LK1: C27R46 ↔ C27R43

## +3V3_B
- pins: J1.+3V3 (C23R52), U5.VIN (C31R36), U5.SDO (C35R36), U5.CS (C37R36), U8.VIN (C31R44), U8.CS (C37R44), C3.1 (C31R33), C4.1 (C42R42), U10B.3V3 (C31R3), M1L.3V3 (C41R50)
- TRAIL: C23R52→C23R51 · C23R51→C31R51 · C31R51→C31R44
- TRAIL: C31R48→C37R48 · C37R48→C37R44
- TRAIL: C37R48→C39R48 · C39R48→C39R50 · C39R50→C41R50
- TRAIL: C37R45→C40R45 · C40R45→C40R42 · C40R42→C42R42
- TRAIL: C31R44→C29R44
- TRAIL: C29R36→C31R36
- TRAIL: C31R36→C31R33
- TRAIL: C31R33→C32R33 · C32R33→C32R31 · C32R31→C35R31 · C35R31→C35R36
- TRAIL: C35R35→C37R35 · C37R35→C37R36
- TRAIL: C34R21→C34R7 · C34R7→C31R7 · C31R7→C31R3
- LINK LK2: C29R44 ↔ C29R36
- LINK LK3: C34R31 ↔ C34R21

## SD_CS
- pins: U1.10 (C21R30), U11.CS (C7R41)
- TRAIL: C21R30→C19R30 · C19R30→C19R29
- TRAIL: C9R29→C7R29 · C7R29→C7R41
- LINK LK4: C19R29 ↔ C9R29

## SD_SCK
- pins: U1.13 (C27R28), U11.SCK (C8R41)
- TRAIL: C27R28→C26R28 · C26R28→C26R43
- TRAIL: C17R43→C16R43
- TRAIL: C16R47→C9R47 · C9R47→C9R42 · C9R42→C8R42 · C8R42→C8R41
- LINK LK5: C26R43 ↔ C17R43
- LINK LK6: C16R43 ↔ C16R47

## SD_MOSI
- pins: U1.11 (C21R29), U11.MOSI (C9R41)
- TRAIL: C21R29→C23R29 · C23R29→C23R39 · C23R39→C22R39 · C22R39→C22R42 · C22R42→C16R42
- TRAIL: C16R39→C9R39 · C9R39→C9R41
- LINK LK7: C16R42 ↔ C16R39

## SD_MISO
- pins: U1.12 (C21R28), U11.MISO (C10R41)
- TRAIL: C21R28→C19R28
- TRAIL: C19R38→C19R40 · C19R40→C10R40 · C10R40→C10R41
- LINK LK8: C19R28 ↔ C19R38

## CAM_TX_J
- pins: J2.MUX_TX (C3R39), U10.TX1 (C29R14)
- TRAIL: C3R39→C4R39 · C4R39→C4R29
- TRAIL: C4R19→C4R18 · C4R18→C19R18 · C19R18→C19R15 · C19R15→C28R15 · C28R15→C28R14 · C28R14→C29R14
- LINK LK9: C4R29 ↔ C4R19

## CAM_RX
- pins: J2.MUX_RX (C3R38), U10.RX1 (C29R13)
- TRAIL: C3R38→C2R38 · C2R38→C2R15 · C2R15→C18R15 · C18R15→C18R13 · C18R13→C29R13

## MUX_A
- pins: U1.5 (C21R35), U10.A (C29R7), R6.1 (C14R30)
- TRAIL: C21R35→C18R35 · C18R35→C18R33 · C18R33→C14R33 · C14R33→C14R30
- TRAIL: C14R30→C12R30 · C12R30→C12R21 · C12R21→C19R21
- TRAIL: C19R11→C19R7 · C19R7→C29R7
- LINK LK10: C19R21 ↔ C19R11

## MUX_B
- pins: U1.6 (C21R34), U10.B (C29R6), R7.1 (C14R28)
- TRAIL: C21R34→C19R34 · C19R34→C19R32 · C19R32→C16R32 · C16R32→C16R28 · C16R28→C14R28
- TRAIL: C14R28→C13R28 · C13R28→C13R22
- TRAIL: C13R12→C13R6 · C13R6→C29R6
- LINK LK11: C13R22 ↔ C13R12

## MUX_C
- pins: U1.9 (C21R31), U10.C (C36R7), R8.1 (C14R26)
- TRAIL: C21R31→C17R31 · C17R31→C17R27 · C17R27→C14R27 · C14R27→C14R26
- TRAIL: C17R38→C18R38
- TRAIL: C18R43→C24R43 · C24R43→C24R17 · C24R17→C30R17 · C30R17→C30R19
- TRAIL: C35R19→C35R7 · C35R7→C36R7
- LINK LK12: C17R31 ↔ C17R38
- LINK LK13: C18R38 ↔ C18R43
- LINK LK14: C30R19 ↔ C35R19

## CAM_COM_TX
- pins: U10B.TX_COM (C34R3), R9.1 (C38R17)
- TRAIL: C34R3→C35R3 · C35R3→C35R5 · C35R5→C37R5 · C37R5→C37R17 · C37R17→C38R17

## CAM_TO_XIAO
- pins: R9.2 (C42R17), J4.to D7 (C45R20)
- TRAIL: C42R17→C42R20 · C42R20→C45R20

## CAM_FROM_XIAO
- pins: J4.from D6 (C45R19), R10.2 (C42R15)
- TRAIL: C45R19→C45R15 · C45R15→C42R15

## CAM_COM_RX
- pins: R10.1 (C38R15), U10B.RX_COM (C33R3)
- TRAIL: C38R15→C38R2 · C38R2→C33R2 · C33R2→C33R3

## SDA
- pins: U1.18 (C27R33), U5.SDI (C36R36), U8.SDA (C35R44), M1L.SDA (C43R50)
- TRAIL: C27R33→C29R33 · C29R33→C29R34
- TRAIL: C38R34→C39R34 · C39R34→C39R37 · C39R37→C36R37 · C36R37→C36R36
- TRAIL: C39R37→C40R37
- TRAIL: C40R40→C35R40 · C35R40→C35R44
- TRAIL: C40R40→C41R40
- TRAIL: C41R49→C43R49 · C43R49→C43R50
- LINK LK15: C29R34 ↔ C38R34
- LINK LK16: C40R37 ↔ C40R40
- LINK LK17: C41R40 ↔ C41R49

## SCL
- pins: U1.19 (C27R34), U5.SCK (C34R36), U8.SCL (C34R44), M1L.SCL (C44R50)
- TRAIL: C27R34→C28R34 · C28R34→C28R35 · C28R35→C30R35 · C30R35→C30R32
- TRAIL: C34R32→C34R36
- TRAIL: C34R36→C34R44
- TRAIL: C34R39→C45R39 · C45R39→C45R50 · C45R50→C44R50
- LINK LK18: C30R32 ↔ C34R32

## GNSS_IN
- pins: J2.GNSS (C3R40), U1.0 (C21R40)
- TRAIL: C3R40→C2R40 · C2R40→C2R42 · C2R42→C6R42 · C6R42→C6R37
- TRAIL: C16R37→C20R37 · C20R37→C20R40 · C20R40→C21R40
- LINK LK19: C6R37 ↔ C16R37

## HB_IN
- pins: J2.HB (C3R41), U1.4 (C21R36)
- TRAIL: C3R41→C5R41 · C5R41→C5R28 · C5R28→C10R28 · C10R28→C10R35 · C10R35→C15R35 · C15R35→C15R36 · C15R36→C21R36

## TX3
- pins: U1.14 (C27R29), R1.1 (C38R29)
- TRAIL: C27R29→C38R29

## TX3_J
- pins: R1.2 (C42R29), J3.TX3 (C45R30)
- TRAIL: C42R29→C42R30 · C42R30→C45R30

## RX3
- pins: J3.RX3 (C45R31), U1.15 (C27R30)
- TRAIL: C45R31→C38R31 · C38R31→C38R30 · C38R30→C27R30

## TX8
- pins: U1.35 (C27R20), R2.1 (C29R20)
- TRAIL: C27R20→C29R20

## TX8_J
- pins: R2.2 (C33R20), U10.TX2 (C29R10)
- TRAIL: C33R20→C32R20 · C32R20→C32R10 · C32R10→C29R10

## RX8_J
- pins: U10.RX2 (C29R9), R3.2 (C33R18)
- TRAIL: C29R9→C30R9 · C30R9→C30R8 · C30R8→C33R8 · C33R8→C33R18

## RX8
- pins: R3.1 (C29R18), U1.34 (C27R19)
- TRAIL: C29R18→C29R19 · C29R19→C27R19

## LED_OK
- pins: U1.36 (C27R21), R4.1 (C29R23)
- TRAIL: C27R21→C29R21 · C29R21→C29R23

## LED_OK_A
- pins: R4.2 (C33R23), D1.A (C35R23)
- TRAIL: C33R23→C35R23

## LED_FLT
- pins: U1.37 (C27R22), R5.1 (C29R25)
- TRAIL: C27R22→C28R22 · C28R22→C28R25 · C28R25→C29R25

## LED_FLT_A
- pins: R5.2 (C33R25), D2.A (C35R26)
- TRAIL: C33R25→C33R26 · C33R26→C35R26
