itsmeabirmohanta/Sujal/source/VRITRA_CanSat_025_Handover_2026-10-28/03_kicad_current_boards/BOARD3_POWER/BOARD3_POWER_1L_BUILD_LIST.md

# VRITRA POWER board — SINGLE-LAYER build list (same routes as the KiCad file)

Hole = C(column, 1 = left on the component side) R(row, 1 = bottom).
TRAIL = solder trail / bare tinned wire on the solder side, every hole in the run soldered, 90° turns only.
LINK = straight insulated wire link on the component side between the two holes (it jumps over other trails).

## SCL
- pins: J2.SCL (C30R57), U1.SCL (C5R48), U2.SCL (C5R12), U3.SCL (C5R28)
- TRAIL: C30R57→C15R57 · C15R57→C15R50 · C15R50→C14R50 · C14R50→C14R48 · C14R48→C5R48
- TRAIL: C5R48→C4R48 · C4R48→C4R46 · C4R46→C3R46
- TRAIL: C3R36→C3R28 · C3R28→C5R28
- TRAIL: C3R18→C3R12 · C3R12→C5R12
- LINK LK1: C3R46 ↔ C3R36
- LINK LK2: C3R28 ↔ C3R18

## SDA
- pins: J2.SDA (C31R57), U1.SDA (C5R47), U2.SDA (C5R11), U3.SDA (C5R27)
- TRAIL: C31R57→C31R56 · C31R56→C17R56 · C17R56→C17R47 · C17R47→C5R47
- TRAIL: C8R47→C8R27 · C8R27→C5R27
- TRAIL: C16R34→C16R25 · C16R25→C17R25
- TRAIL: C17R19→C14R19
- TRAIL: C4R19→C2R19 · C2R19→C2R11 · C2R11→C5R11
- LINK LK3: C8R34 ↔ C16R34
- LINK LK4: C17R25 ↔ C17R19
- LINK LK5: C14R19 ↔ C4R19

## GND
- pins: J1.BAT− (C3R57), U1.GND (C5R49), U2.GND (C5R13), U3.GND (C5R29), M1L.GND (C19R49), M2L.GND (C34R49), M3L.GND (C19R39), M4L.GND (C19R21), M5L.GND (C30R21), D1.K (C20R53), J4.GND (C45R57), J2.GND (C32R57), J5.GND (C44R15), J5.GND (C44R13), J6.GND (C41R15), J6.GND (C41R13), J7.GND (C38R15), J7.GND (C38R13), J8.GND (C35R14), J8.GND (C35R13), J9.GND (C35R8), J10.GND (C44R8), C1.- (C24R44)
- TRAIL: C3R57→C5R57 · C5R57→C5R52 · C5R52→C6R52 · C6R52→C6R49 · C6R49→C5R49
- TRAIL: C5R55→C8R55
- TRAIL: C18R55→C21R55 · C21R55→C21R51 · C21R51→C18R51 · C18R51→C18R49 · C18R49→C19R49
- TRAIL: C21R53→C20R53
- TRAIL: C19R49→C20R49 · C20R49→C20R44 · C20R44→C16R44 · C16R44→C16R42 · C16R42→C15R42 · C15R42→C15R38 · C15R38→C17R38 · C17R38→C17R39 · C17R39→C19R39
- TRAIL: C19R39→C24R39 · C24R39→C24R44
- TRAIL: C21R55→C32R55 · C32R55→C32R57
- TRAIL: C24R44→C24R49 · C24R49→C34R49
- TRAIL: C32R57→C32R58 · C32R58→C45R58 · C45R58→C45R57
- TRAIL: C20R39→C20R21 · C20R21→C19R21
- TRAIL: C20R21→C30R21
- TRAIL: C28R21→C28R16 · C28R16→C30R16 · C30R16→C30R14 · C30R14→C35R14
- TRAIL: C35R14→C35R13
- TRAIL: C35R13→C38R13
- TRAIL: C38R13→C42R13 · C42R13→C42R15 · C42R15→C38R15
- TRAIL: C42R13→C44R13
- TRAIL: C42R15→C44R15
- TRAIL: C36R13→C36R8 · C36R8→C35R8
- TRAIL: C43R13→C43R8 · C43R8→C44R8
- TRAIL: C6R38→C6R29 · C6R29→C5R29
- TRAIL: C19R21→C17R21 · C17R21→C17R20 · C17R20→C11R20 · C11R20→C11R13 · C11R13→C5R13
- LINK LK6: C8R55 ↔ C18R55
- LINK LK7: C15R38 ↔ C6R38

## BAT+
- pins: J1.BAT+ (C2R57), J3.SW_A (C6R57)
- TRAIL: C2R57→C2R58 · C2R58→C6R58 · C6R58→C6R57

## VBAT_SW
- pins: J3.SW_B (C7R57), F1.IN (C10R57), R1.1 (C14R54)
- TRAIL: C7R57→C10R57
- TRAIL: C10R57→C10R58 · C10R58→C14R58 · C14R58→C14R54

## VBAT_F
- pins: F1.OUT (C11R57), U1.IN+ (C5R44)
- TRAIL: C11R57→C11R55
- TRAIL: C3R55→C3R54
- TRAIL: C3R44→C3R39
- TRAIL: C7R39→C7R41 · C7R41→C6R41 · C6R41→C6R44 · C6R44→C5R44
- LINK LK8: C11R55 ↔ C3R55
- LINK LK9: C3R54 ↔ C3R44
- LINK LK10: C3R39 ↔ C7R39

## VBAT
- pins: U1.IN- (C5R43), U1.VBUS (C5R45), M1L.IN (C19R50), M2L.IN (C34R50), M3L.IN (C19R40), J4.VBAT (C44R57), J10.VBAT (C44R9), C1.+ (C22R44)
- TRAIL: C5R43→C4R43 · C4R43→C4R45 · C4R45→C5R45
- TRAIL: C5R43→C5R39 · C5R39→C6R39
- TRAIL: C16R39→C16R40 · C16R40→C19R40
- TRAIL: C19R40→C19R42 · C19R42→C21R42 · C21R42→C21R44 · C21R44→C22R44
- TRAIL: C21R44→C21R50 · C21R50→C19R50
- TRAIL: C21R50→C34R50
- TRAIL: C34R50→C44R50 · C44R50→C44R57
- TRAIL: C44R50→C46R50 · C46R50→C46R9 · C46R9→C44R9
- LINK LK11: C6R39 ↔ C16R39

## LED_A
- pins: R1.2 (C18R54), D1.A (C20R54)
- TRAIL: C18R54→C20R54

## 8V_RAW
- pins: M3L.OUT (C19R38), U2.IN+ (C5R8)
- TRAIL: C19R38→C19R30 · C19R30→C17R30 · C17R30→C17R26
- TRAIL: C17R16→C17R8 · C17R8→C5R8
- LINK LK12: C17R26 ↔ C17R16

## +8V_STEER
- pins: U2.IN- (C5R7), U2.VBUS (C5R9), J8.+8V (C35R16), J8.+8V (C35R15)
- TRAIL: C5R7→C4R7 · C4R7→C4R9 · C4R9→C5R9
- TRAIL: C5R7→C22R7 · C22R7→C22R15 · C22R15→C23R15
- TRAIL: C33R15→C35R15
- TRAIL: C35R15→C35R16
- LINK LK13: C23R15 ↔ C33R15

## 5V_RAW
- pins: M1L.OUT (C19R48), U3.IN+ (C5R24)
- TRAIL: C19R48→C19R45 · C19R45→C13R45 · C13R45→C13R24 · C13R24→C5R24

## +5V_LOGIC
- pins: U3.IN- (C5R23), U3.VBUS (C5R25), J5.+5V (C44R16), J6.+5V (C41R16), J7.+5V (C38R16), M4L.IN (C19R22), M5L.IN (C30R22)
- TRAIL: C5R23→C4R23 · C4R23→C4R25 · C4R25→C5R25
- TRAIL: C5R23→C5R22 · C5R22→C19R22
- TRAIL: C19R22→C19R25
- TRAIL: C28R25→C28R22 · C28R22→C30R22
- TRAIL: C30R22→C31R22 · C31R22→C31R21 · C31R21→C37R21 · C37R21→C37R16 · C37R16→C38R16
- TRAIL: C38R16→C41R16
- TRAIL: C41R16→C44R16
- LINK LK14: C19R25 ↔ C28R25

## +5V_SERVO
- pins: M2L.OUT (C34R48), J9.+5VS (C35R9)
- TRAIL: C34R48→C29R48 · C29R48→C29R23
- TRAIL: C29R13→C29R10 · C29R10→C35R10 · C35R10→C35R9
- LINK LK15: C29R23 ↔ C29R13

## +3V3_A
- pins: M4L.OUT (C19R20), J5.+3V3_A (C44R14), U1.VCC (C5R50), U2.VCC (C5R14), U3.VCC (C5R30)
- TRAIL: C19R20→C19R18
- TRAIL: C9R18→C5R18 · C5R18→C5R14
- TRAIL: C5R18→C5R21 · C5R21→C2R21 · C2R21→C2R37 · C2R37→C5R37 · C5R37→C5R30
- TRAIL: C2R37→C2R50 · C2R50→C5R50
- TRAIL: C19R18→C26R18 · C26R18→C26R7 · C26R7→C38R7 · C38R7→C38R11
- TRAIL: C45R11→C45R14 · C45R14→C44R14
- LINK LK16: C19R18 ↔ C9R18
- LINK LK17: C38R11 ↔ C45R11

## +3V3_B
- pins: M5L.OUT (C30R20), J6.+3V3_B (C41R14), J7.+3V3_B (C38R14)
- TRAIL: C30R20→C30R17 · C30R17→C36R17 · C36R17→C36R14 · C36R14→C38R14
- TRAIL: C38R14→C41R14
