itsmeabirmohanta/Sujal/source/VRITRA_CanSat_025_Handover_2026-10-28/03_kicad_current_boards/BOARD4_PARACHUTE_ESP32-P4-Pico/BOARD4_PARACHUTE_PICO_BUILD_LIST.md

# VRITRA Board 4 PARACHUTE — ESP32-P4-Pico zero board — BUILD LIST

**Hole numbers:** C = column counted from the LEFT edge of the board (C1 = the first hole column, beside the LSM6DSO32). R = row counted DOWN from the TOP (R1 = the top hole row = the row of P4 pin 1 / GPIO54).
TRAIL = solder trail / bare tinned wire on the SOLDER side through every hole of the run, 90° turns only.
LINK = insulated wire on the COMPONENT side between the two holes (it jumps over other trails).

## 0. Before you start
- The ESP32-P4-Pico STAYS where it is: left pins in **C13 R1..R20** (pin 1 GPIO54 = C13 R1, the top row), right pins in **C20 R1..R20** (pin 40 VBUS = C20 R1). Count every other hole from these.
- REMOVE the LSM6DSO32, the BMP585 and all temporary header pins / Dupont wires (grey, black, yellow, green).
- Refit the **BMP585** with its 8 pins in **C6 R13..R20**: VIN at the TOP (C6R13), INT at the bottom (C6R20), its board lying to the RIGHT (toward the P4). Chip side up.
- Refit the **LSM6DSO32** with its 9-pin row in **R23 C8..C16**: INT2 at C8, VIN at C16, its board hanging DOWN (toward R29). Chip side up. Do NOT fit the 5-pin back row.
- Both are rotations of how they sat before (no flipping): labels stay readable from above.

## 1. Firmware pin map (ESP32-P4-Pico)

| signal | P4 pin | GPIO |
|---|---|---|
| SCL | 16 | GPIO8 |
| SDA | 17 | GPIO7 |
| STEER_L | 35 | GPIO20 |
| STEER_R | 34 | GPIO21 |
| BAY_LID | 32 | GPIO22 |
| PETRI | 31 | GPIO23 |
| SERVO_X | 26 | GPIO32 |
| ESC | 25 | GPIO33 |
| TX2 | 1 | GPIO54 |
| RX2 | 2 | GPIO19 |
| RX3 | 6 | GPIO16 |
| GNSS_IN | 9 | GPIO14 |
| HALL | 11 | GPIO5 |
| +5V_LOGIC in | 39 | VSYS |
| GND | 3, 38 | GND |

Never connect P4 pins 36 (3V3 OUT), 37 (3V3_EN), 40 (VBUS), 30 (RUN), 19/20 (USB). GPIO46/47/48 (pins 24/22/21) stay free: they run on the microSD LDO supply.

## 2. Parts to fit (hole of every pin)

- **U1** ESP32-P4-Pico: GPIO54 C13R1, GPIO19 C13R2, GND C13R3, GPIO18 C13R4, GPIO17 C13R5, GPIO16 C13R6, GPIO15 C13R7, GND C13R8, GPIO14 C13R9, GPIO6 C13R10, GPIO5 C13R11, GPIO4 C13R12, GND C13R13, GPIO3 C13R14, GPIO2 C13R15, GPIO8/SCL C13R16, GPIO7/SDA C13R17, GND C13R18, GPIO24/DM C13R19, GPIO25/DP C13R20, GPIO48 C20R20, GPIO47 C20R19, GND C20R18, GPIO46 C20R17, GPIO33 C20R16, GPIO32 C20R15, GPIO27 C20R14, GND C20R13, GPIO26 C20R12, RUN C20R11, GPIO23 C20R10, GPIO22 C20R9, GND C20R8, GPIO21 C20R7, GPIO20 C20R6, 3V3_OUT C20R5, 3V3_EN C20R4, GND C20R3, VSYS C20R2, VBUS C20R1
- **U6** LSM6DSO32 (Adafruit): VIN C16R23, 3Vo C15R23, GND C14R23, SCL C13R23, SDA C12R23, DO C11R23, CS C10R23, INT1 C9R23, INT2 C8R23, SCX C14R28, SDX C13R28, CS(back) C12R28, DO(back) C11R28, GND(back) C10R28
- **U5** BMP585 (7Semi): VIN C6R13, 3V3 C6R14, GND C6R15, SCK C6R16, SDO C6R17, SDI C6R18, CS C6R19, INT C6R20
- **R1** 330: 1 C22R6, 2 C26R6
- **R2** 330: 1 C22R7, 2 C26R7
- **R3** 330: 1 C22R9, 2 C26R9
- **R4** 330: 1 C22R10, 2 C26R10
- **R9** 330: 1 C22R15, 2 C26R15
- **R5** 330: 1 C22R16, 2 C26R16
- **J10** A20CLM LEFT steer (8 V): − C29R6, + C28R6, S C27R6
- **J11** A20CLM RIGHT steer (8 V): − C29R7, + C28R7, S C27R7
- **J12** MG90S #1 PARACHUTE BAY: − C29R9, + C28R9, S C27R9
- **J13** MG90S #2 PETRI PLATE: − C29R10, + C28R10, S C27R10
- **J16** MG90S #3 EXTRA: − C29R15, + C28R15, S C27R15
- **J14** ESC signal: − C28R16, S C27R16
- **J1** 8 V steer in (POWER J8): +8V C31R4, +8V C31R5, GND C31R6, GND C31R7
- **C1** 470µF 8V rail: + C27R2, - C29R2
- **J6** 5 V servo in (POWER J9): +5VS C31R11, GND C31R12
- **C2** 470µF 5VS rail: + C25R12, - C25R14
- **R7** 1k TX2→A: 1 C12R1, 2 C8R1
- **J2** UART from MAIN J4: TX2→A C5R1, RX2←A C5R2, GND C5R3
- **R8** 1k TX→B: 1 C12R5, 2 C8R5
- **J3** UART to BACKUP J3: TX→B C5R5, RX3←B C5R6, GND C5R7
- **J5** GNSS from MAIN J8: GNSS C5R9, GND C5R10
- **J15** HALL sensor plug: − C4R23, +5V C4R24, OUT C4R25
- **R6** 10k HALL↑3V3: 1 C6R22, 2 C6R25
- **J8** logic PWR (POWER J7): +5V C2R28, GND C3R28, +3V3 C4R28, GND C5R28
- **C3** 470µF logic: + C19R26, - C19R28
- **C4** 100nF at VSYS: 1 C21R1, 2 C21R3
- **C5** 100nF: 1 C18R23, 2 C19R23

## 3. Every net — trails and links

### GND
- pins: U5.GND (C6R15), J10.− (C29R6), J11.− (C29R7), J12.− (C29R9), J13.− (C29R10), J16.− (C29R15), J14.− (C28R16), J15.− (C4R23), J2.GND (C5R3), J5.GND (C5R10), J3.GND (C5R7), J1.GND (C31R6), J1.GND (C31R7), J6.GND (C31R12), J8.GND (C3R28), J8.GND (C5R28), C1.- (C29R2), C2.- (C25R14), C3.- (C19R28), C4.2 (C21R3), C5.2 (C19R23), U6.GND (C14R23), U6.DO (C11R23), U1.GND (C13R3), U1.GND (C20R3)
- TRAIL: C6R15→C7R15 · C7R15→C7R10 · C7R10→C5R10
- TRAIL: C5R10→C4R10 · C4R10→C4R7 · C4R7→C5R7
- TRAIL: C4R7→C4R3 · C4R3→C5R3
- TRAIL: C4R4→C7R4
- TRAIL: C12R4→C12R3 · C12R3→C13R3
- TRAIL: C13R3→C20R3
- TRAIL: C20R3→C21R3
- TRAIL: C21R3→C24R3 · C24R3→C24R1 · C24R1→C29R1 · C29R1→C29R2
- TRAIL: C29R2→C32R2 · C32R2→C32R6 · C32R6→C29R6
- TRAIL: C29R6→C29R7
- TRAIL: C31R6→C31R7
- TRAIL: C29R7→C29R9
- TRAIL: C29R9→C29R10
- TRAIL: C29R10→C32R10 · C32R10→C32R12 · C32R12→C31R12
- TRAIL: C31R12→C31R15 · C31R15→C29R15
- TRAIL: C29R15→C29R16 · C29R16→C28R16
- TRAIL: C28R16→C28R17 · C28R17→C25R17 · C25R17→C25R14
- TRAIL: C4R10→C3R10 · C3R10→C3R23 · C3R23→C4R23
- TRAIL: C19R3→C19R25 · C19R25→C17R25 · C17R25→C17R29 · C17R29→C3R29 · C3R29→C3R28
- TRAIL: C5R29→C5R28
- TRAIL: C17R28→C19R28
- TRAIL: C19R22→C14R22 · C14R22→C14R23
- TRAIL: C14R23→C14R24 · C14R24→C11R24 · C11R24→C11R23
- LINK LK1: C7R4 ↔ C12R4

### +8V_STEER
- pins: J1.+8V (C31R4), J1.+8V (C31R5), C1.+ (C27R2), J10.+ (C28R6), J11.+ (C28R7)
- TRAIL: C31R4→C31R5
- TRAIL: C31R5→C28R5 · C28R5→C28R6
- TRAIL: C28R6→C28R7
- TRAIL: C28R5→C28R2 · C28R2→C27R2

### +5V_SERVO
- pins: J6.+5VS (C31R11), C2.+ (C25R12), J12.+ (C28R9), J13.+ (C28R10), J16.+ (C28R15)
- TRAIL: C31R11→C28R11 · C28R11→C28R10
- TRAIL: C28R10→C28R9
- TRAIL: C28R11→C28R12 · C28R12→C25R12
- TRAIL: C28R12→C28R15

### +5V_LOGIC
- pins: J8.+5V (C2R28), C3.+ (C19R26), C4.1 (C21R1), J15.+5V (C4R24), U1.VSYS (C20R2)
- TRAIL: C2R28→C2R27 · C2R27→C3R27 · C3R27→C3R24 · C3R24→C4R24
- TRAIL: C2R28→C2R30 · C2R30→C20R30 · C20R30→C20R26 · C20R26→C19R26
- TRAIL: C20R26→C23R26 · C23R26→C23R5
- TRAIL: C23R2→C20R2
- TRAIL: C21R2→C21R1
- LINK LK2: C23R5 ↔ C23R2

### +3V3_B
- pins: J8.+3V3 (C4R28), U5.VIN (C6R13), U5.SDO (C6R17), U5.CS (C6R19), R6.2 (C6R25), C5.1 (C18R23), U6.VIN (C16R23), U6.CS (C10R23)
- TRAIL: C4R28→C4R26 · C4R26→C6R26 · C6R26→C6R25
- TRAIL: C6R25→C7R25 · C7R25→C7R19 · C7R19→C6R19
- TRAIL: C6R19→C5R19 · C5R19→C5R17 · C5R17→C6R17
- TRAIL: C7R22→C10R22 · C10R22→C10R23
- TRAIL: C5R17→C5R13 · C5R13→C6R13
- TRAIL: C7R25→C16R25 · C16R25→C16R23
- TRAIL: C16R23→C18R23

### SDA
- pins: U5.SDI (C6R18), U6.SDA (C12R23), U1.GPIO7/SDA (C13R17)
- TRAIL: C6R18→C12R18 · C12R18→C12R17 · C12R17→C13R17
- TRAIL: C12R18→C12R23

### SCL
- pins: U5.SCK (C6R16), U6.SCL (C13R23), U1.GPIO8/SCL (C13R16)
- TRAIL: C6R16→C8R16 · C8R16→C8R15 · C8R15→C12R15 · C12R15→C12R16 · C12R16→C13R16
- TRAIL: C13R16→C14R16 · C14R16→C14R21 · C14R21→C13R21 · C13R21→C13R23

### GNSS_IN
- pins: J5.GNSS (C5R9), U1.GPIO14 (C13R9)
- TRAIL: C5R9→C13R9

### STEER_L
- pins: R1.1 (C22R6), U1.GPIO20 (C20R6)
- TRAIL: C22R6→C20R6

### STEER_L_S
- pins: R1.2 (C26R6), J10.S (C27R6)
- TRAIL: C26R6→C27R6

### STEER_R
- pins: R2.1 (C22R7), U1.GPIO21 (C20R7)
- TRAIL: C22R7→C20R7

### STEER_R_S
- pins: R2.2 (C26R7), J11.S (C27R7)
- TRAIL: C26R7→C27R7

### BAY_LID
- pins: R3.1 (C22R9), U1.GPIO22 (C20R9)
- TRAIL: C22R9→C20R9

### BAY_LID_S
- pins: R3.2 (C26R9), J12.S (C27R9)
- TRAIL: C26R9→C27R9

### PETRI
- pins: R4.1 (C22R10), U1.GPIO23 (C20R10)
- TRAIL: C22R10→C20R10

### PETRI_S
- pins: R4.2 (C26R10), J13.S (C27R10)
- TRAIL: C26R10→C27R10

### SERVO_X
- pins: R9.1 (C22R15), U1.GPIO32 (C20R15)
- TRAIL: C22R15→C20R15

### SERVO_X_S
- pins: R9.2 (C26R15), J16.S (C27R15)
- TRAIL: C26R15→C27R15

### ESC
- pins: R5.1 (C22R16), U1.GPIO33 (C20R16)
- TRAIL: C22R16→C20R16

### ESC_S
- pins: R5.2 (C26R16), J14.S (C27R16)
- TRAIL: C26R16→C27R16

### RX2
- pins: J2.RX2←A (C5R2), U1.GPIO19 (C13R2)
- TRAIL: C5R2→C8R2
- TRAIL: C12R2→C13R2
- LINK LK3: C8R2 ↔ C12R2

### TX2
- pins: R7.1 (C12R1), R8.1 (C12R5), U1.GPIO54 (C13R1)
- TRAIL: C12R1→C13R1
- TRAIL: C12R1→C11R1 · C11R1→C11R5 · C11R5→C12R5

### TX2_A
- pins: R7.2 (C8R1), J2.TX2→A (C5R1)
- TRAIL: C8R1→C5R1

### TX2_B
- pins: R8.2 (C8R5), J3.TX→B (C5R5)
- TRAIL: C8R5→C5R5

### RX3
- pins: J3.RX3←B (C5R6), U1.GPIO16 (C13R6)
- TRAIL: C5R6→C13R6

### HALL
- pins: J15.OUT (C4R25), R6.1 (C6R22), U1.GPIO5 (C13R11)
- TRAIL: C4R25→C5R25 · C5R25→C5R23 · C5R23→C6R23 · C6R23→C6R22
- TRAIL: C6R22→C6R21 · C6R21→C4R21 · C4R21→C4R12
- TRAIL: C12R12→C12R11 · C12R11→C13R11
- LINK LK4: C4R12 ↔ C12R12

## 4. Test before plugging anything in
1. Meter on beep, NO power: +5V_LOGIC, +3V3_B, +8V_STEER, +5V_SERVO each to GND → must NOT beep. +8V_STEER to +5V_SERVO → must NOT beep.
2. Each signal trail to its neighbours → must NOT beep.
3. POWER board only (no P4 / servos): J8 shows 5 V and 3.3 V on the right pins.
4. Then plug the P4-Pico power, then servos one at a time.
