itsmeabirmohanta/Sujal/source/VRITRA_CanSat_025_Handover_2026-10-28/06_chats/oct_2026_board_build/2026-10-01_849af9bc.md

# Chat session 849af9bc-5c53-44bb-949d-39d1a647c90e.jsonl (started 2026-10-01T17:38:14.201Z)

---
**USER** (2026-10-01T17:38:14)

@"C:\Users\kalbh\Downloads\PROJECT_HANDOFF.md" @"C:\Users\kalbh\Downloads\VRITRA_All_Boards_KiCad10_Guide_rev6.md" @"C:\Users\kalbh\Documents\KiCad\cansat final pcb\Board 1.zip"
read this whole the pcb i was connecting is having some pins errors first read all three file to understand what i am doing then we will do one things explore option how we willl approach this problem new solution and ways we can solve this simple lovely working pcb is what i want first read all also see cansat project from my claude account don't hesitate i want proper working pcbc with kicad design rule followed but in proper structured way

---
**CLAUDE** (2026-10-01T17:38:18)

I've read the handoff. Now the KiCad guide and the Board 1 zip.

---
**CLAUDE** (2026-10-01T17:39:39)

I've read the handoff, the rev 6.3 guide (up to the start of Part D) and the Board 1 project. A search of your other sessions found only ground-station and rocketry work. I found no earlier PCB discussion apart from one hit on the `.history` folder, so the handoff is my source for the PCB history.

## What is wrong with Board 1 right now

The zip shows a schematic with correct pin numbering. Your "pin errors" are not wiring or numbering mistakes.

**Pin and net check (fine)**
- Every symbol pin number matches its footprint pad number: Teensy 48/48, mux 25/25, Core1121 16/16, L89 12/12, and so on.
- The Teensy pins are the guide's 6.3 map, and the mux is wired A→MUX_SEL, B→GND.

**DRC (50 violations)**
- **22 errors are `pth_inside_courtyard`.** U1 (Teensy) and U5 (amp) overlap, and U7 (DS3231) overlaps U4 (flash) and U6 (BMP585).
- **55 unconnected pads.** Nothing has been routed yet, so these are just ratsnest lines.
- **1 keepout hit.** The Ø13 mm antenna-hole footprint sits inside its own keepout. That one is harmless and can be waived.
- **About 25 silkscreen warnings and 7 isolated-copper warnings.** These are cosmetic.

**Audit script (`board_audit_report.txt`)**
- U9 (mux) and U7 (DS3231) are still on Board 1, so neither agreed fix has been applied.
- U2, U5, U7 and U8 are on the opposite side from the placement plan.
- There are about 45 same-side courtyard overlaps. The largest is U3 (L89) over U9 (mux), 35×22 mm.
- The `.history` folder and the `_restore_backup` folder suggest you hit a KiCad restore recently.
- `VRITRA_symbols.kicad_sym` is only 5.8 KB, against 49 KB in the `.bak`. The schematic references `L89_GNSS`, `Teensy_4.1` and others. If you have not already confirmed those are in the current library, I will check before touching anything else.

So the real problem is the one in your handoff: too many large breakout modules for a Ø110 mm disc. Routing before fixing that will not help.

## Ways to solve it

| | Approach | Effort | Risk | Verdict |
|---|---|---|---|---|
| **A** | Re-partition and keep all modules as through-hole breakouts. Delete U7 and use the Teensy's built-in RTC with a CR2032 on VBAT. Move U9 to Board 3. Place the remaining six modules (Teensy, L89, Core1121, flash, amp, BMP585) on the disc. | Low | Low | **Recommended** |
| **B** | Option A, plus drop the W25Q64 and log environmental data to the Teensy's microSD. This frees another 22×18 mm and makes routing much easier. | Low | Low | Good add-on to A |
| **C** | Hybrid bare-SMD chips (L89, flash, BMP585). | High | High | Not for this deadline. It needs new footprints, reflow, and RF/GNSS layout risk. |
| **D** | Use the opposite side properly. A back-mounted module's body can sit under the Teensy as long as no pin hole lands inside another module's body. I would write per-side courtyards. | Medium | Medium | Fallback only if A+B still does not fit |

Option A is already shown to fit by your solver, with 1.2 mm gaps and 1 mm edge margin. B gives routing room for a clean 4-layer layout.

## Plan

1. **Replace the Board 1 layout from scratch.** I would not nudge the current one. The plan:
   - Keep the schematic and libraries.
   - Remove U7 and U9, and add a VBAT/CR2032 pad.
   - Re-place the six modules by script with real courtyards.
   - Put the Teensy at the edge nearest J2, L89 and Core1121 at opposite edges, and the amp away from the L89.
2. **Route power first.** Keep the +3V3 and GND planes as they are. Use 0.2 mm signal tracks, short SPI and I²S runs, and route the L89 and radio away from the amp.
3. **Run DRC to zero.** Waive only the antenna-keepout item.
4. **Check pins against the physical modules.** This covers the footprints marked PHOTO or VERIFY in the guide, especially the Core1121 castellations and the mux bottom row.
5. **Move the mux to Board 3** in the same way, and do Boards 4, 2, 5 and 3 afterward. Board 4 comes first because it feeds the others.

## Two decisions before I edit anything

1. Do you confirm dropping the DS3231 and using Teensy RTC plus CR2032? The mission clock only needs "time since power-up". If you want the time kept across a power loss, keep the CR2032.
2. Should I also drop the W25Q64 (option B), or keep it?

I will not edit your files until KiCad is closed. The `.lck` files are present, and I will work on a copy in a new folder rather than overwriting the original.

---
**USER** (2026-10-01T18:04:25)

i am deleting the board schematic lets work on this again now i think we will do differently so now we will do 4 layer pcb. teensy will mountted on front side and with all other component attached to front side also. we will attach gnss and lora and other main mosule that we can fit from current u1 to u9 properly but this time teensy will have connectors all other board as we are spreadign our other module to other board this connectors will pic data address bus and give it to teensy jst connectors all properly map tell me click by clcick instructuon first see how and which which component we can fix we are changing entire structure of this board so we are freeto put any module any way we like so i need no errors now. simple 3 layers pcb front will be simple, 2 layer will be 3.3v. and gnd and 4 th will be our routing it may also consist of watch or some type of smd compoennt we have to use read entire chat and propsoe an perfect plain mountung board structure remainber i need 4 holes for rod and 12 mm hole for antenna in middle of pcb in circular design 110mm pcb

---
**USER** (2026-10-01T18:04:27)

[Request interrupted by user]
