itsmeabirmohanta/Sujal/source/VRITRA_CanSat_025_Handover_2026-10-28/06_chats/oct_2026_board_build/2026-10-01_d74a0cce.md

# Chat session d74a0cce-95e8-4d7a-af8c-1f3f6454eabe.jsonl (started 2026-10-01T17:38:14.201Z)

---
**USER** (2026-10-01T17:38:14)

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

---
**CLAUDE** (2026-10-01T17:38:18)

I've read the handoff. Now the KiCad guide and the Board 1 zip.

---
**CLAUDE** (2026-10-01T17:39:39)

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

## What is wrong with Board 1 right now

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

## Ways to solve it

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

## Plan

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

## Two decisions before I edit anything

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

---
**USER** (2026-10-01T18:04:40)

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

---
**CLAUDE** (2026-10-01T18:06:32)

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

---
**USER** (2026-10-01T18:10:46)

[Request interrupted by user]

---
**USER** (2026-10-01T18:20:01)

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

---
**CLAUDE** (2026-10-01T18:21:25)

Python's available. Let me measure every footprint's real pad span and courtyard.

---
**CLAUDE** (2026-10-01T18:22:00)

Found the root cause. Let me confirm it directly.

---
**CLAUDE** (2026-10-01T18:22:28)

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

---
**CLAUDE** (2026-10-01T18:24:01)

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

---
**CLAUDE** (2026-10-01T18:37:09)

API Error: Can't reach the API server — check your internet or DNS (ENOTFOUND)

---
**USER** (2026-10-01T18:43:10)

Try again

---
**CLAUDE** (2026-10-01T18:44:00)

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

---
**CLAUDE** (2026-10-01T18:46:00)

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

---
**CLAUDE** (2026-10-01T18:47:37)

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

---
**CLAUDE** (2026-10-01T18:51:50)

Hand-iterating is the exact failure mode from last time. Let me check the constrained solver.

---
**CLAUDE** (2026-10-01T18:53:09)

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

---
**CLAUDE** (2026-10-01T18:54:23)

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

---
**CLAUDE** (2026-10-01T18:54:51)

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

---
**USER** (2026-10-01T22:47:39)

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

---
**CLAUDE** (2026-10-01T22:48:39)

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

## Root cause

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

## The fix

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

Do that swap and tell me once F8 comes back clean — then we move into placement.

---
**USER** (2026-10-01T22:54:43)

[image attached]
i did this and saved still 

<pasted_content id="96c6">
Processing symbol 'C1:Capacitor_THT:CP_Radial_D10.0mm_P5.00mm'.
Processing symbol 'R1:Resistor_THT:R_Axial_DIN0207_L6.3mm_D2.5mm_P10.16mm_Horizontal'.
Processing symbol 'C2:Capacitor_THT:CP_Radial_D10.0mm_P5.00mm'.
Processing symbol 'J6:Connector_JST:JST_EH_B3B-EH-A_1x03_P2.50mm_Vertical'.
Processing symbol 'C3:Capacitor_THT:CP_Radial_D10.0mm_P5.00mm'.
Processing symbol 'R3:Resistor_THT:R_Axial_DIN0207_L6.3mm_D2.5mm_P10.16mm_Horizontal'.
Processing symbol 'J1:Connector_JST:JST_EH_B3B-EH-A_1x03_P2.50mm_Vertical'.
Processing symbol 'J5:Connector_JST:JST_EH_B5B-EH-A_1x05_P2.50mm_Vertical'.
Processing symbol 'J2:Connector_JST:JST_EH_B3B-EH-A_1x03_P2.50mm_Vertical'.
Processing symbol 'J7:Connector_JST:JST_EH_B4B-EH-A_1x04_P2.50mm_Vertical'.
Processing symbol 'J3:Connector_JST:JST_EH_B4B-EH-A_1x04_P2.50mm_Vertical'.
Processing symbol 'R2:Resistor_THT:R_Axial_DIN0207_L6.3mm_D2.5mm_P10.16mm_Horizontal'.
Processing symbol 'J4:Connector_JST:JST_EH_B3B-EH-A_1x03_P2.50mm_Vertical'.
Processing symbol 'J8:Connector_JST:JST_EH_B10B-EH-A_1x10_P2.50mm_Vertical'.
Processing symbol 'R4:Resistor_THT:R_Axial_DIN0207_L6.3mm_D2.5mm_P10.16mm_Horizontal'.
Processing symbol 'R5:Resistor_THT:R_Axial_DIN0207_L6.3mm_D2.5mm_P10.16mm_Horizontal'.
Processing symbol 'R6:Resistor_THT:R_Axial_DIN0207_L6.3mm_D2.5mm_P10.16mm_Horizontal'.
Processing symbol 'R7:Resistor_THT:R_Axial_DIN0207_L6.3mm_D2.5mm_P10.16mm_Horizontal'.
Processing symbol 'R8:Resistor_THT:R_Axial_DIN0207_L6.3mm_D2.5mm_P10.16mm_Horizontal'.
Processing symbol 'R9:Resistor_THT:R_Axial_DIN0207_L6.3mm_D2.5mm_P10.16mm_Horizontal'.
Processing symbol 'U1:VRITRA_footprints:Teensy 4.1_hdr'.
Processing symbol 'U5:VRITRA_footprints:LSM6DSO32_hdr'.
Processing symbol 'U2:VRITRA_footprints:Core1121xf Lora'.
Processing symbol 'U3:VRITRA_footprints:L89_hdr'.
Processing symbol 'U4:VRITRA_footprints:BMP585_hdr8'.
Processing symbol 'U6:VRITRA_footprints:MAX98357A_hdr7'.
Processing symbol 'U7:VRITRA_footprints:W25Q64_hdr6'.
Processing symbol 'U8:Package_TO_SOT_SMD:SOT-23-6'.
Add J8 (footprint 'Connector_JST:JST_EH_B10B-EH-A_1x10_P2.50mm_Vertical').
Add R4 (footprint 'Resistor_THT:R_Axial_DIN0207_L6.3mm_D2.5mm_P10.16mm_Horizontal').
Add C1 (footprint 'Capacitor_THT:CP_Radial_D10.0mm_P5.00mm').
Add R5 (footprint 'Resistor_THT:R_Axial_DIN0207_L6.3mm_D2.5mm_P10.16mm_Horizontal').
Add C2 (footprint 'Capacitor_THT:CP_Radial_D10.0mm_P5.00mm').
Add R6 (footprint 'Resistor_THT:R_Axial_DIN0207_L6.3mm_D2.5mm_P10.16mm_Horizontal').
Add C3 (footprint 'Capacitor_THT:CP_Radial_D10.0mm_P5.00mm').
Add R7 (footprint 'Resistor_THT:R_Axial_DIN0207_L6.3mm_D2.5mm_P10.16mm_Horizontal').
Add J2 (footprint 'Connector_JST:JST_EH_B3B-EH-A_1x03_P2.50mm_Vertical').
Add R8 (footprint 'Resistor_THT:R_Axial_DIN0207_L6.3mm_D2.5mm_P10.16mm_Horizontal').
Add J3 (footprint 'Connector_JST:JST_EH_B4B-EH-A_1x04_P2.50mm_Vertical').
Add R9 (footprint 'Resistor_THT:R_Axial_DIN0207_L6.3mm_D2.5mm_P10.16mm_Horizontal').
Add J4 (footprint 'Connector_JST:JST_EH_B3B-EH-A_1x03_P2.50mm_Vertical').
Add J1 (footprint 'Connector_JST:JST_EH_B3B-EH-A_1x03_P2.50mm_Vertical').
Add J5 (footprint 'Connector_JST:JST_EH_B5B-EH-A_1x05_P2.50mm_Vertical').
Add U2 (footprint 'VRITRA_footprints:Core1121xf Lora').
Add J6 (footprint 'Connector_JST:JST_EH_B3B-EH-A_1x03_P2.50mm_Vertical').
Add U3 (footprint 'VRITRA_footprints:L89_hdr').
Add J7 (footprint 'Connector_JST:JST_EH_B4B-EH-A_1x04_P2.50mm_Vertical').
Add U4 (footprint 'VRITRA_footprints:BMP585_hdr8').
Add U1 (footprint 'VRITRA_footprints:Teensy 4.1_hdr').
Add U5 (footprint 'VRITRA_footprints:LSM6DSO32_hdr').
Add R1 (footprint 'Resistor_THT:R_Axial_DIN0207_L6.3mm_D2.5mm_P10.16mm_Horizontal').
Add U6 (footprint 'VRITRA_footprints:MAX98357A_hdr7').
Add R2 (footprint 'Resistor_THT:R_Axial_DIN0207_L6.3mm_D2.5mm_P10.16mm_Horizontal').
Add U7 (footprint 'VRITRA_footprints:W25Q64_hdr6').
Add R3 (footprint 'Resistor_THT:R_Axial_DIN0207_L6.3mm_D2.5mm_P10.16mm_Horizontal').
Add U8 (footprint 'Package_TO_SOT_SMD:SOT-23-6').
Total warnings: 0, errors: 0.
</pasted_content id="96c6">

---
**CLAUDE** (2026-10-01T22:55:25)

**0 errors, 0 warnings — that's the milestone.** All 28 parts imported clean, every symbol pin matches its footprint pad exactly. Let me confirm the U6 fix actually landed in the saved file before we move on.

---
**CLAUDE** (2026-10-01T22:55:52)

Hold on — the symbol is still `Audio:MAX98357A` (17-pin bare chip), not the swap I recommended. Yet F8 shows 0 errors now. Let me check what actually changed — likely the footprint itself got edited instead.

---
**CLAUDE** (2026-10-01T22:56:12)

That's the concern — **the footprint still only has 7 pads**, same file, unchanged since September. The symbol still has 17 pins. The 0-errors result this time is because you're importing into a **brand-new, empty PCB** — every line says "Add X," not "Update X." When KiCad adds a footprint fresh, it doesn't complain about unmatched pins; it just silently drops any schematic pin that has no corresponding pad. The error only fires when it's trying to *update* an existing placement and finds a pad that used to be there is now missing.

That means **pin 14 (LRCLK) and pin 16 (BCLK) on U6 almost certainly have no copper pad on the PCB right now** — the mismatch didn't get fixed, it just stopped being reported. Let me check the actual PCB file to confirm.

---
**USER** (2026-10-01T22:56:22)

[Request interrupted by user]
