itsmeabirmohanta/Sujal/source/VRITRA_CanSat_025_Handover_2026-10-28/06_chats/oct_2026_board_build/2026-10-19_ba867180.md

# Chat session ba867180-0e4c-46aa-83c8-880180ab871c.jsonl (started 2026-10-19T18:05:31.212Z)

---
**USER** (2026-10-19T18:05:31)

@"D:\Download\Cansat\cansat_competition_guidelines_3 (1).pdf" @"D:\Download\Cansat\2026-INSPACe-CAN-7USAT-025 CDR .pdf" @"C:\Users\kalbh\AppData\Local\Packages\5319275A.WhatsAppDesktop_cv1g1gvanyjgm\LocalState\sessions\559C81B58E53F0EDA6C1FA928A3638EE30225390\transfers\2026-42\CAN7USAT Team_Frequency_Assignments_19_10.pdf" @"C:\Users\kalbh\AppData\Local\Packages\5319275A.WhatsAppDesktop_cv1g1gvanyjgm\LocalState\sessions\559C81B58E53F0EDA6C1FA928A3638EE30225390\transfers\2026-42\A0_PF072-CANSAT-parts.pdf" @"C:\Users\kalbh\AppData\Local\Packages\5319275A.WhatsAppDesktop_cv1g1gvanyjgm\LocalState\sessions\559C81B58E53F0EDA6C1FA928A3638EE30225390\transfers\2026-42\PF072-CANSAT-parts.pdf" @"C:\Users\kalbh\AppData\Local\Packages\5319275A.WhatsAppDesktop_cv1g1gvanyjgm\LocalState\sessions\559C81B58E53F0EDA6C1FA928A3638EE30225390\transfers\2026-42\PF072-CANSAT-parts (1).pdf" @"C:\Users\kalbh\AppData\Local\Packages\5319275A.WhatsAppDesktop_cv1g1gvanyjgm\LocalState\sessions\559C81B58E53F0EDA6C1FA928A3638EE30225390\transfers\2026-42\parachute_LE.zip"

<pasted_content id="f7c9">
CAN-7USAT RAM-AIR PARACHUTE — AUTONOMOUS ENGINEERING VALIDATION AND SIMULATION
<project_identity>
<project_name>CAN-7USAT CanSat Precision Landing System</project_name>
<primary_objective>
Perform a complete, evidence-based engineering validation of my CanSat's
ram-air parachute design, including analytical calculations, GNU Octave
verification, ANSYS simulations, aerodynamic performance evaluation,
structural integrity assessment, flight feasibility, and precision
landing feasibility.
</primary_objective>
<working_mode>
Operate as an autonomous engineering workflow using the available Claude
Code tools, background tasks, terminal, installed applications, scripts,
and simulation interfaces where supported. Minimize my intervention while
asking essential questions whenever missing information prevents reliable
engineering conclusions.
</working_mode>
<engineering_standard>
Prioritize physical correctness, traceability, reproducibility, validated
numerical methods, and evidence-backed conclusions. Never fabricate
simulation results, software capabilities, hardware specifications,
or successful test outcomes.
</engineering_standard>
</project_identity>
<role_and_responsibilities>
Act as a multidisciplinary engineering team with expertise in:

```
1. CanSat systems engineering and competition requirements.
2. Ram-air parachute aerodynamics and parafoil flight mechanics.
3. Parachute inflation, deployment dynamics, and aerodynamic loading.
4. Computational fluid dynamics (CFD) and finite element analysis (FEA).
5. Structural mechanics, textile materials, seams, suspension lines,
   risers, attachment points, and payload integration.
6. Servo-actuated steering, control geometry, and flight dynamics.
7. GNU Octave numerical analysis, independent calculation verification,
   sensitivity analysis, and engineering plotting.
8. ANSYS Workbench and relevant ANSYS solvers, meshing, boundary conditions,
   convergence studies, and post-processing.
9. Automated engineering workflows, background-task monitoring, and
   reproducible technical documentation.

Make decisions using engineering evidence, not assumptions or visual
appearance alone.
```

</role_and_responsibilities>
<project_context>
<mission>
I am developing CAN-7USAT, a CanSat intended to descend from approximately
600 m altitude and achieve a controlled, precise landing using a ram-air
parachute.
</mission>

```
<payload>
    <total_mass unit="kg">1.0</total_mass>
    <mass_definition>
        The stated 1.0 kg is the current nominal total CanSat mass. Verify
        whether this includes the parachute, deployment plate, servos,
        batteries, suspension lines, and all associated hardware. Do not
        assume that every configuration has the same total mass.
    </mass_definition>
</payload>

<deployment_sequence>
    <stage id="1">
        The CanSat descends toward the deployment altitude with the
        currently planned deployment arrangement.
    </stage>
    <stage id="2">
        At approximately 600 m altitude, a servo-actuated mechanism releases
        or ejects the plate carrying the drogue parachute. Determine the
        actual intended function of the drogue, the plate, and the release
        mechanism from the project documents. Do not assume their precise
        sequence or mechanical behavior until verified.
    </stage>
    <stage id="3">
        After the drogue and plate have been released or separated, the
        ram-air parachute is intended to provide the controlled descent.
        The exact inflation, extraction, separation, and transition sequence
        must be established from the CDR, drawings, and my answers.
    </stage>
    <stage id="4">
        From approximately 600 m down to ground level, the intended system
        uses the ram-air parachute to glide toward the designated landing
        area. Servo-actuated steering is intended to adjust the flight path.
    </stage>
</deployment_sequence>

<critical_design_question>
    Verify whether the proposed deployment arrangement is mechanically and
    aerodynamically feasible. In particular, establish how the ram-air
    canopy is extracted, inflates, becomes load-bearing, and is connected
    to the payload. Determine whether the drogue is intended to stabilize,
    extract, or otherwise assist deployment, and whether the plate remains
    attached to any part of the flight system.

    Identify potential line entanglement, canopy inversion, asymmetric
    inflation, excessive opening shock, unstable transition, and payload
    oscillation risks. Evaluate these as engineering questions requiring
    evidence rather than assuming that the mechanism will work.
</critical_design_question>
```

</project_context>
<reference_designs_and_documents>
<source priority="1">
<name>Existing Claude Code CanSat project conversation</name>
<instructions>
Retrieve and review relevant prior project discussions and available
project context using accessible conversation history, files, and
project artifacts. Determine what has already been decided, what
has been calculated, and what remains unresolved. Do not assume
that previous conversation history is accessible if the current
environment does not expose it. If it is unavailable, identify the
limitation and continue using the supplied files.
</instructions>
</source>

```
<source priority="2">
    <name>Critical Design Review (CDR)</name>
    <instructions>
        Read the complete CDR and extract the mission concept, deployment
        sequence, mass budget, dimensions, mechanical arrangement, electronic
        architecture, control strategy, operational constraints, and
        competition requirements. Use the actual document content to
        understand what I am building.
    </instructions>
</source>

<source priority="3">
    <name>Competition guidelines and mission documentation</name>
    <instructions>
        Identify all mandatory deployment, descent, landing, safety, and
        operational requirements. Separate mandatory competition criteria
        from my design preferences. Establish measurable acceptance criteria
        for the parachute system wherever the documents permit.
    </instructions>
</source>

<source priority="4">
    <name>Ram-air parachute design package</name>
    <instructions>
        Inspect every supplied ZIP archive and relevant project file,
        including CAD models, geometry, drawings, dimensions, fabric
        specifications, airfoil sections, rib profiles, cell arrangement,
        suspension-line layout, steering-line attachment locations, control
        dimensions, mass estimates, and previous calculations.

        Inventory the files before modifying or extracting them. Preserve
        the original data and create a separate working directory for
        derived files, scripts, models, meshes, and simulation results.
    </instructions>
</source>

<source priority="5">
    <name>Previous HFSS simulation project</name>
    <instructions>
        Inspect the previous HFSS project and associated screenshots,
        procedures, settings, and result files to understand the existing
        ANSYS installation, project structure, interface conventions, and
        available workflow. Reuse only methods that are technically
        appropriate to the new problem.

        HFSS is an electromagnetic solver. Do not use electromagnetic
        results as evidence of parachute aerodynamic or structural
        performance. Identify the appropriate ANSYS products and solvers
        for fluid flow, structural mechanics, and any required coupled
        analyses.
    </instructions>
</source>
```

</reference_designs_and_documents>
<known_hardware>
<steering_servo>
<manufacturer_model>AGFRC B26CLM V2</manufacturer_model>
<advertised_torque>10.5 kgf-cm, subject to verification</advertised_torque>
<advertised_speed>0.080 s, operating voltage and specified rotation range to be verified</advertised_speed>
<advertised_voltage>8.4 V maximum advertised HV rating; verify the actual allowable voltage range</advertised_voltage>
<advertised_features>
Titanium gears, coreless motor, aluminum middle case,
programmable servo.
</advertised_features>
<reference_url>https://amzn.in/d/059tyStF</reference_url>
<validation_instructions>
Verify the manufacturer's datasheet or reliable product documentation.
Do not treat the advertised torque, speed, or maximum voltage as
sufficient evidence of steering suitability.

```
        Determine the required steering-line force, servo output torque,
        control-arm radius, steering travel, angular range, response time,
        current draw, power supply requirements, and margin against stall.
        Account for mechanical friction, line tension, aerodynamic loads,
        transient loads, and the actual operating voltage.
    </validation_instructions>
</steering_servo>
```

</known_hardware>
<target_landing_site>
<mission_name>CAN-7USAT Competition Landing Site</mission_name>
<latitude unit="degrees_north">26.717535</latitude>
<longitude unit="degrees_east">84.301543</longitude>
<requirement>
The competition specifies the coordinates above as the targeted landing
site. Local wind vectors may cause the actual landing position to vary.
The flight-control software must support adjustment of the target or
associated guidance parameters when permitted by the mission requirements.
</requirement>
<validation_instructions>
Establish a geographic coordinate convention and convert coordinates
consistently when required by the flight-dynamics model. Evaluate how
wind speed, wind direction, wind shear, launch conditions, glide
performance, and control authority influence landing dispersion.

```
    Distinguish the designated target coordinate from the actual launch
    coordinate and initial horizontal position. Do not assume that the
    launch location is the same as the target.

    Do not assume the system has a GPS receiver, wind sensor, altitude
    sensor, or other particular sensor unless verified in the hardware
    inventory or confirmed by me.
</validation_instructions>
```

</target_landing_site>
<phase_0_environment_and_inventory>
<objective>
Establish the actual state of the computer, installed software,
available hardware resources, project files, and simulation tools before
beginning computationally expensive work.
</objective>

```
<tasks>
    <task id="0.1">
        Identify the operating system, version, architecture, CPU model,
        core/thread count, RAM capacity, available memory, GPU model,
        graphics capabilities, storage capacity, available disk space,
        and relevant drivers using safe, read-only system inspection.
    </task>

    <task id="0.2">
        Identify installed engineering software and available licenses,
        including GNU Octave, ANSYS products, Workbench, Fluent, Mechanical,
        SpaceClaim or Discovery, CAD tools, mesh utilities, Python,
        MATLAB if installed, and relevant supporting applications.
    </task>

    <task id="0.3">
        Determine exact application versions and executable locations
        where accessible. Distinguish software that is installed from
        software that can actually launch and run with the available
        license and dependencies.
    </task>

    <task id="0.4">
        Check whether ANSYS Fluent and ANSYS Mechanical are available and
        licensed. Identify any other relevant CFD, structural, explicit
        dynamics, or multiphysics capabilities actually installed.
    </task>

    <task id="0.5">
        Inventory the project directories, ZIP archives, documents,
        spreadsheets, CAD files, images, scripts, solver projects, and
        existing results. Identify corrupted, inaccessible, duplicated,
        missing, or ambiguous files.
    </task>

    <task id="0.6">
        Determine whether headless execution, command-line solving,
        batch scripting, journal files, Python automation, and background
        processes are supported by the installed applications.
    </task>

    <task id="0.7">
        Create an environment report containing detected versions,
        resource limitations, software availability, license status,
        relevant paths, and recommended simulation methods.
    </task>
</tasks>

<restrictions>
    Begin with read-only inspection. Do not change system settings,
    install software, activate licenses, edit environment variables,
    terminate unrelated processes, or modify original project files
    without authorization.

    Never request or expose license credentials, passwords, authentication
    tokens, or other secrets in reports.
</restrictions>
```

</phase_0_environment_and_inventory>
<phase_1_project_understanding>
<objective>
Reconstruct the actual design and requirements from the supplied
documents before making engineering assumptions.
</objective>

```
<tasks>
    <task id="1.1">Read the CDR and competition guidelines completely.</task>
    <task id="1.2">Inspect the ram-air parachute design and all related files.</task>
    <task id="1.3">Reconstruct the deployment mechanism and flight sequence.</task>
    <task id="1.4">Extract all known dimensions, masses, materials, and operating conditions.</task>
    <task id="1.5">Identify previous calculations, assumptions, and simulation results.</task>
    <task id="1.6">Compare the actual design against the competition requirements.</task>
    <task id="1.7">Create a design-parameter register with units, source files, confidence, and status.</task>
</tasks>

<parameter_register>
    Track at least the following where applicable:

    - Total system mass and individual component masses.
    - Canopy span, chord, planform area, aspect ratio, and projected area.
    - Airfoil profile, cell count, rib geometry, inlet geometry, and canopy volume.
    - Fabric type, thickness, density, permeability, and strength.
    - Seam construction and strength.
    - Suspension-line number, length, material, strength, and attachment geometry.
    - Riser and payload attachment geometry.
    - Steering-line attachment points, control-line travel, and mechanical limits.
    - Drogue dimensions, material, mass, and function.
    - Deployment plate dimensions, mass, release geometry, and separation method.
    - Servo model, operating voltage, torque, speed, travel, and control-arm geometry.
    - Deployment altitude, expected air density, wind conditions, and initial velocity.
    - Sensor configuration, actuator interfaces, power budget, and control update rate.
    - Required landing accuracy and permitted landing area.

    For every parameter, record its value, unit, source, uncertainty or
    confidence, and whether it has been measured, calculated, assumed,
    or confirmed by documentation.
</parameter_register>
```

</phase_1_project_understanding>
<phase_2_clarification_gate>
<objective>
Ask me the questions required to establish a defensible simulation model.
</objective>

```
<instructions>
    Review the supplied material first. Do not ask questions whose answers
    are already explicitly available in the files. Group unresolved
    questions by importance.

    Classify each missing item as:
    A. Critical: simulation cannot be trusted without this information.
    B. Important: simulation can proceed with bounded assumptions or
       sensitivity analysis.
    C. Optional: useful for refining later analysis.

    Present a concise, prioritized question list after the initial
    inventory. Ask multiple related questions together when that reduces
    unnecessary interaction.

    Do not wait for my response to perform independent work that does not
    depend on the missing information. Continue inventory, analytical
    setup, software checks, and preliminary calculations using clearly
    labelled provisional assumptions.

    Do not silently replace missing values with invented dimensions,
    material properties, deployment conditions, or control behavior.
</instructions>

<critical_questions_to_resolve>
    Determine whether the 1 kg mass includes all deployment and recovery
    hardware; whether the ram-air canopy is already fabricated or only
    designed; whether a CAD model and exact dimensions are available;
    which material and line specifications are known; how the canopy is
    packed, extracted, and inflated; what happens to the drogue and plate;
    the number and placement of steering servos; the available sensors;
    the actual launch conditions; the required landing accuracy; and the
    wind envelope used for validation.

    These are investigation targets, not assumptions about my answers.
</critical_questions_to_resolve>
```

</phase_2_clarification_gate>
<phase_3_gnu_octave_analytical_validation>
<objective>
Build an independently checkable mathematical model of the descent,
glide, loading, control requirements, and landing dispersion before
relying on ANSYS simulations.
</objective>

```
<rule>
    GNU Octave is the first numerical analysis environment to use. Verify
    its installation and execute small test calculations before developing
    the full model.
</rule>

<required_analyses>
    <analysis id="3.1" name="Mass and weight">
        Verify the mass budget, total mass, gravitational force, and
        component load contributions. Use SI units consistently.
    </analysis>

    <analysis id="3.2" name="Atmospheric properties">
        Determine atmospheric density, pressure, temperature, and
        gravitational assumptions appropriate to the expected altitude.
        Document the selected atmospheric model and environmental limits.
    </analysis>

    <analysis id="3.3" name="Canopy geometry">
        Calculate the relevant geometric quantities from the supplied
        design, including planform area, aspect ratio, chord distribution,
        and any available projected-area or volume estimates.
    </analysis>

    <analysis id="3.4" name="Descent and glide">
        Estimate glide speed, vertical descent rate, horizontal speed,
        glide ratio, descent duration, and approximate range using a
        physically justified aerodynamic model and documented assumptions.
    </analysis>

    <analysis id="3.5" name="Aerodynamic loading">
        Calculate dynamic pressure and estimated aerodynamic forces
        over the defined operating envelope. Evaluate sensitivity to
        velocity, air density, angle of attack, and configuration.
    </analysis>

    <analysis id="3.6" name="Deployment loads">
        Establish a preliminary model for opening and transient loads.
        Identify which parameters are unknown and why steady-state
        aerodynamic calculations cannot predict opening shock reliably.
    </analysis>

    <analysis id="3.7" name="Structural loads">
        Estimate loads on suspension lines, risers, canopy panels,
        seams, attachment points, and payload connections using an
        appropriate load-sharing model. Include asymmetric loading where
        feasible.
    </analysis>

    <analysis id="3.8" name="Servo and steering">
        Estimate steering-line loads, required torque, control travel,
        response requirements, and actuator margin. Compare the calculated
        demand with verified servo specifications.
    </analysis>

    <analysis id="3.9" name="Wind and landing dispersion">
        Simulate a justified range of wind speeds and directions, including
        relevant changes with altitude. Estimate landing-position
        sensitivity and distinguish uncontrolled drift from steerable
        guidance performance.
    </analysis>

    <analysis id="3.10" name="Uncertainty and sensitivity">
        Determine which unknown parameters have the largest effect on
        glide performance, structural loading, and landing accuracy.
        Use parameter sweeps or Monte Carlo analysis when appropriate.
    </analysis>
</required_analyses>

<numerical_quality>
    Use explicit units, dimensional consistency, documented equations,
    physically valid assumptions, and numerical checks. Compare independent
    formulations where practical. Test limiting cases and confirm that
    computed outputs are physically plausible.

    Create readable plots for canopy geometry, descent trajectory,
    velocity, forces, wind sensitivity, steering response, and landing
    dispersion wherever the model supports them.

    Do not present a simplified steady-state calculation as a validated
    transient flight simulation.
</numerical_quality>

<deliverables>
    Save documented Octave scripts, parameter files, calculation outputs,
    plots, and a calculation report in the project working directory.
    Preserve the original design files and make the calculations repeatable.
</deliverables>
```

</phase_3_gnu_octave_analytical_validation>
<phase_4_ansys_simulation_strategy>
<objective>
Select and execute the appropriate ANSYS analyses based on the actual
geometry, available licenses, material data, and computer resources.
</objective>

```
<solver_selection>
    <fluid_analysis>
        Prefer ANSYS Fluent if it is installed, licensed, and suitable for
        the required aerodynamic model. Evaluate other available solvers
        only when technically justified.

        Identify the appropriate steady-state or transient formulation,
        turbulence treatment, fluid domain, inlet and outlet boundaries,
        ground or symmetry conditions where applicable, and the necessary
        near-canopy mesh resolution.

        Model the ram-air parachute as the geometry and physics permit.
        A rigid-canopy external-flow model may provide useful aerodynamic
        information, but it cannot by itself establish flexible-canopy
        inflation, fabric deformation, or deployment reliability.
    </fluid_analysis>

    <structural_analysis>
        Prefer ANSYS Mechanical when it is installed, licensed, and
        appropriate for the available geometry and material information.

        Assess canopy panels, suspension lines, seams, risers, attachment
        points, deployment hardware, and the payload interface. Select
        appropriate structural idealizations and contact or connection
        representations.

        Evaluate stress, strain, deformation, load transfer, and failure
        indicators only to the extent supported by the chosen material
        models and structural representation.
    </structural_analysis>

    <coupled_analysis>
        Determine whether fluid-structure interaction is necessary and
        technically feasible. If it is required but unavailable, document
        the limitation and develop a defensible alternative analysis plan.

        Distinguish static structural loading, transient structural
        response, external-flow aerodynamics, inflation dynamics, and
        coupled fluid-structure behavior. Do not claim that one analysis
        proves all of these phenomena.
    </coupled_analysis>

    <deployment_analysis>
        Treat deployment, inflation, and opening shock as separate
        high-priority engineering questions. Identify the data and solver
        capabilities required to assess them.

        If the actual release mechanism or flexible inflation behavior
        cannot be represented reliably, report that limitation and specify
        the additional modeling or physical testing required.
    </deployment_analysis>
</solver_selection>

<simulation_stages>
    <stage id="4.1">
        Confirm software availability, licensing, geometry compatibility,
        and available compute resources.
    </stage>
    <stage id="4.2">
        Import or reconstruct the design geometry and verify dimensions,
        coordinate systems, orientation, units, and component connections.
    </stage>
    <stage id="4.3">
        Repair geometry only in derived working copies and document every
        modification.
    </stage>
    <stage id="4.4">
        Create a preliminary mesh and inspect quality, thin features,
        gaps, interfaces, and near-wall resolution requirements.
    </stage>
    <stage id="4.5">
        Establish physically justified material properties, boundary
        conditions, operating conditions, and load cases.
    </stage>
    <stage id="4.6">
        Run a low-cost pilot case and confirm solver stability before
        launching expensive simulations.
    </stage>
    <stage id="4.7">
        Evaluate mesh sensitivity and numerical convergence. Where
        appropriate, compare at least three systematically refined meshes.
    </stage>
    <stage id="4.8">
        Execute the primary aerodynamic and structural cases. Add
        transient or coupled cases when the available model and resources
        justify them.
    </stage>
    <stage id="4.9">
        Extract relevant aerodynamic coefficients, pressure distributions,
        force estimates, structural response, load paths, and failure
        indicators.
    </stage>
    <stage id="4.10">
        Compare ANSYS results with independent GNU Octave estimates and
        explain significant discrepancies.
    </stage>
</simulation_stages>

<simulation_matrix>
    Develop a case matrix covering nominal operation, low and high
    operating speeds, relevant atmospheric conditions, reasonable
    geometric or material uncertainty, and asymmetric loading where
    appropriate.

    Include steering configurations or angles of attack only when the
    corresponding geometry and operating range are supported by the design
    data.

    For each case, record the objective, model fidelity, inputs, outputs,
    mesh, convergence status, runtime, and limitations.
</simulation_matrix>

<convergence_and_validation>
    Check solver residuals, force convergence, mass balance where applicable,
    mesh quality, mesh sensitivity, time-step sensitivity for transient
    analyses, and sensitivity to material and boundary-condition assumptions.

    Do not interpret solver completion as proof of physical accuracy.
    Separate numerical convergence from experimental validation.

    If material strength, fabric permeability, seam strength, or line
    strength is unknown, explicitly limit the corresponding safety
    conclusion. Do not invent failure limits.
</convergence_and_validation>
```

</phase_4_ansys_simulation_strategy>
<phase_5_flight_dynamics_and_precision_landing>
<objective>
Determine whether the canopy has a credible path to controlled descent
and precision landing under the actual mission conditions.
</objective>

```
<tasks>
    <task id="5.1">
        Construct a flight-dynamics model appropriate to the available
        aerodynamic data, including horizontal motion, vertical descent,
        wind-relative airspeed, and gravity.
    </task>
    <task id="5.2">
        Establish the relationship between steering-line displacement,
        aerodynamic control input, turning behavior, and flight-path
        response. Do not assume a steering law without supporting data.
    </task>
    <task id="5.3">
        Evaluate whether the remaining altitude after deployment provides
        enough time for extraction, inflation, stabilization, navigation,
        and steering.
    </task>
    <task id="5.4">
        Evaluate descent time and reachable landing regions under multiple
        wind conditions, accounting for the actual initial position.
    </task>
    <task id="5.5">
        Determine whether the available sensors and actuators support
        target-relative navigation and closed-loop steering.
    </task>
    <task id="5.6">
        Identify actuator saturation, insufficient control authority,
        delayed inflation, payload oscillation, and other conditions
        that could prevent precise landing.
    </task>
    <task id="5.7">
        Establish quantitative landing-error metrics using the competition
        tolerance if provided. If no tolerance is available, report the
        predicted dispersion without inventing a pass/fail threshold.
    </task>
</tasks>

<targeting_requirements>
    Use the specified target coordinates as the nominal geographic target.
    Account for actual launch position, navigation uncertainty, local
    wind vectors, and model uncertainty.

    Do not claim that precise landing is achievable solely because the
    canopy can glide. Precision landing additionally requires sufficient
    steering authority, reliable state estimation, adequate control time,
    and a suitable guidance strategy.
</targeting_requirements>
```

</phase_5_flight_dynamics_and_precision_landing>
<phase_6_autonomous_execution_and_background_monitoring>
<objective>
Execute the engineering workflow with minimal intervention while
maintaining visibility, reproducibility, and process safety.
</objective>

```
<background_execution>
    Use Claude Code background tasks, task monitoring, terminal processes,
    and other available mechanisms only where supported by the installed
    environment.

    Determine which long-running tasks can genuinely execute concurrently
    and which must remain sequential. Do not assume that a background task
    continues running after a session ends unless the environment confirms
    that behavior.
</background_execution>

<task_management>
    Maintain a task ledger with:
    - Task identifier and description.
    - Dependencies and priority.
    - Input and output files.
    - Current status.
    - Start time and last observed progress.
    - Exit status and error details.
    - Validation status and next action.

    Monitor actual process output, log files, exit codes, solver progress,
    and generated result files. Distinguish running, completed, failed,
    interrupted, and blocked tasks.
</task_management>

<parallel_execution>
    Run independent activities concurrently when this is safe and efficient,
    such as document inspection, environment inventory, and independent
    preliminary calculations.

    Respect dependencies between geometry preparation, meshing, solver
    execution, and post-processing. Avoid launching multiple memory-intensive
    simulations when the laptop cannot support them.
</parallel_execution>

<failure_recovery>
    On failure, capture the error message and relevant logs, diagnose the
    cause, and make a targeted correction when justified.

    Preserve failed-run evidence. Do not repeatedly retry an identical
    failing task without a reason. Do not silently weaken convergence
    criteria, alter physics, remove components, or change boundary conditions
    simply to obtain a successful run.

    Retry with a reduced pilot case only when doing so helps diagnose the
    problem. Label simplified results accordingly.
</failure_recovery>

<autonomy_limits>
    Proceed autonomously with reversible, low-risk engineering tasks,
    file inspection, scripts, calculations, and simulation setup.

    Ask before destructive file operations, installation or licensing
    changes, system configuration changes, purchases, external uploads,
    or any action that could compromise the computer or project data.

    Do not disable operating-system protections or execute untrusted
    scripts merely to automate a simulation.
</autonomy_limits>
```

</phase_6_autonomous_execution_and_background_monitoring>
<phase_7_quality_assurance>
<objective>
Ensure that every engineering conclusion is traceable, reproducible,
and appropriately qualified.
</objective>

```
<mandatory_checks>
    <check>Verify SI units and coordinate conventions throughout the project.</check>
    <check>Confirm that the modeled geometry matches the supplied design.</check>
    <check>Verify that all mass and load calculations are internally consistent.</check>
    <check>Check input files and model parameters for missing or invalid values.</check>
    <check>Verify that solver logs and exit codes support reported completion.</check>
    <check>Check numerical convergence and mesh sensitivity where applicable.</check>
    <check>Compare analytical predictions with numerical results.</check>
    <check>Document assumptions, uncertainty, and model limitations.</check>
    <check>Confirm that plotted results correspond to actual simulation outputs.</check>
    <check>Ensure that the original source files remain unchanged.</check>
    <check>Re-run relevant scripts to confirm reproducibility.</check>
</mandatory_checks>

<evidence_policy>
    Never invent numerical values, screenshots, solver completion, convergence,
    safety factors, material properties, or test results.

    Clearly distinguish:
    - Verified input data.
    - Assumed input data.
    - Analytical estimates.
    - Numerical simulation outputs.
    - Experimentally validated results.
    - Unresolved questions.

    If a solver or software component is unavailable, report that fact
    instead of simulating its completion in a report.
</evidence_policy>
```

</phase_7_quality_assurance>
<phase_8_final_engineering_report>
<objective>
Produce a professional engineering assessment that answers whether the
current ram-air parachute design is feasible for the intended CanSat
mission and identifies what remains necessary before flight.
</objective>

```
<required_report_sections>
    <section>1. Executive summary and overall assessment.</section>
    <section>2. Mission requirements and competition constraints.</section>
    <section>3. Verified computer, software, and hardware inventory.</section>
    <section>4. Reconstructed parachute design and deployment sequence.</section>
    <section>5. Design parameter register and unresolved inputs.</section>
    <section>6. GNU Octave analytical calculations and validation.</section>
    <section>7. ANSYS solver selection, setup, and simulation methodology.</section>
    <section>8. Mesh quality, convergence, and numerical verification.</section>
    <section>9. Aerodynamic performance and predicted glide behavior.</section>
    <section>10. Structural integrity and load assessment.</section>
    <section>11. Deployment, inflation, and opening-load assessment.</section>
    <section>12. Servo capability and steering-control feasibility.</section>
    <section>13. Wind sensitivity and landing dispersion.</section>
    <section>14. Limitations, uncertainties, and failure modes.</section>
    <section>15. Design modifications ranked by engineering priority.</section>
    <section>16. Physical testing and flight-readiness recommendations.</section>
    <section>17. Final conclusions and outstanding work.</section>
</required_report_sections>

<final_decision>
    Provide separate assessments for:

    A. Steady-state aerodynamic feasibility.
    B. Glide performance and descent time.
    C. Structural strength under modeled loads.
    D. Deployment and inflation feasibility.
    E. Servo and steering authority.
    F. Precision landing feasibility.
    G. Overall mission readiness.

    For each assessment, state:
    - The conclusion.
    - The evidence supporting it.
    - The applicable operating conditions.
    - The remaining uncertainty.
    - The next action required.

    Use one of these statuses where justified:
    PASS — the defined criterion is met by adequate evidence.
    CONDITIONAL — the available evidence supports feasibility only under
    stated assumptions or restricted operating conditions.
    FAIL — the defined criterion is not met.
    NOT VERIFIED — available evidence is insufficient to determine the result.

    Do not issue PASS merely because a simulation completed successfully.
    Do not label the overall system flight-ready without adequate evidence
    for deployment, inflation, structural loading, control, and landing.
</final_decision>
```

</phase_8_final_engineering_report>
<project_directory_and_artifacts>
<instructions>
First identify the existing project root. Use the project's established
directory structure if one exists. Otherwise, create a clearly named
working directory without moving or overwriting original files.

```
    Organize generated files into appropriate subdirectories for:
    - inventory and source references
    - extracted design parameters
    - GNU Octave scripts and results
    - CAD and geometry preparation
    - ANSYS models and solver outputs
    - mesh and convergence studies
    - flight-dynamics and landing analysis
    - plots and figures
    - logs and background-task records
    - engineering reports

    Use descriptive filenames, consistent units, versioned configurations,
    and reproducible scripts. Maintain a manifest that maps results back
    to their inputs and simulation settings.
</instructions>
```

</project_directory_and_artifacts>
<immediate_execution_instructions>
Begin now.

```
1. Inspect the accessible project conversation context and all supplied
   project files.
2. Read the CDR and competition guidelines.
3. Inventory the computer, software, licenses, and computational resources.
4. Inspect the ram-air parachute design and previous HFSS project.
5. Produce an initial findings report identifying what is known, missing,
   contradictory, or potentially infeasible.
6. Ask the prioritized critical questions that cannot be answered from
   the supplied files.
7. Start independent GNU Octave setup and preliminary calculations using
   only clearly labelled assumptions.
8. Select the appropriate ANSYS simulation strategy after confirming
   actual solver availability and input-data adequacy.
9. Execute simulations in stages, monitor progress, validate results,
   and recover from errors when justified.
10. Compare the numerical outputs with analytical calculations.
11. Produce the complete engineering report and a clear readiness assessment.

Do not stop after listing a proposed workflow. Perform the available work,
inspect actual outputs, and report the real progress achieved.

Do not claim access to files, prior conversations, installed applications,
licenses, or background processes that you cannot actually access.

If a required tool is unavailable, continue with the best technically valid
alternative and identify the limitation explicitly.

The ultimate question is:

"Given my actual ram-air parachute geometry, 1 kg nominal CanSat mass,
deployment arrangement at approximately 600 m, available servo and control
hardware, competition requirements, and expected wind conditions, is the
proposed system aerodynamically feasible, structurally adequate, capable
of controlled gliding, and capable of achieving the required landing
accuracy?"

Answer this question using verified data and reproducible engineering
evidence, not assumptions presented as facts.
```

</immediate_execution_instructions
</pasted_content id="f7c9">

---
**CLAUDE** (2026-10-19T18:05:37)

I'll start by reading the source documents and inventorying the environment in parallel.

---
**CLAUDE** (2026-10-19T18:05:43)

PDF rendering needs poppler. Let me check what text-extraction tools exist on this machine.

---
**CLAUDE** (2026-10-19T18:05:57)

Octave isn't on PATH. Let me check for ANSYS, Octave installs, and Python PDF libraries.

---
**CLAUDE** (2026-10-19T18:06:12)

Critical finding: Octave **is** installed, but the only ANSYS products are Electromagnetics (HFSS/Maxwell), Lumerical (photonics), and SCADE — no Fluent, no Mechanical, no Workbench. Let me confirm.

---
**CLAUDE** (2026-10-19T18:06:30)

There's prior project context in the working directory. Let me read it and inspect the parachute package.

---
**CLAUDE** (2026-10-19T18:06:45)

Found the real design data: this is an LEparagliding (open-source paraglider design tool) output package. Let me read the geometry report and line plan directly from the archive.

---
**CLAUDE** (2026-10-19T18:06:56)

Area = 0.71 m², total line length 18.30 m. Now the full geometry report.

---
**CLAUDE** (2026-10-19T18:07:58)

Now I have hard geometry. Let me verify the ANSYS situation and read the remaining design data.

---
**CLAUDE** (2026-10-19T18:08:19)

Confirmed ANSYS location. Let me verify exactly which solvers exist, and extract the PDF text (no PDF tooling is installed, so I'll use Python's stdlib).

---
**CLAUDE** (2026-10-19T18:10:46)

Understood — I'll fold software installation into the plan (I can't install while in plan mode, but I'll pin down exactly what's needed and where it goes). Let me check what install channels are available.

---
**CLAUDE** (2026-10-19T18:10:58)

MATLAB is installed too, plus a full MinGW64 toolchain (gcc/gfortran/cmake). Let me read the ANSYS scan result.

---
**CLAUDE** (2026-10-19T18:11:15)

Correction: the **full** ANSYS 2026 R1 stack is actually installed — Fluent, CFX, MAPDL/Mechanical, LS-DYNA, Workbench, SpaceClaim and System Coupling are all present. My earlier read of the registry was incomplete. The open question is now licensing.

---
**CLAUDE** (2026-10-19T18:11:45)

Octave 11.3.0 is verified working. MATLAB is deactivated (`.deact` license, no `matlab.exe`) — so Octave is the correct choice. Now the decisive question: does ANSYS licensing actually grant Fluent/Mechanical?

---
**CLAUDE** (2026-10-19T18:12:08)

Decisive finding: ANSYS binaries are all present, but **no license path is configured and no features can be retrieved** — it's set to web/elastic licensing, which needs an Ansys account sign-in. Now let me extract the PDF text (no PDF tooling exists, so I'll use Python stdlib).

---
**CLAUDE** (2026-10-19T18:12:18)

The heredoc mangled backslashes. Let me avoid them entirely.

---
**CLAUDE** (2026-10-19T18:14:33)

While that runs, let me verify the core feasibility numbers in Octave (computation only, no files written).

---
**CLAUDE** (2026-10-19T18:15:09)

Real numbers now. Let me check the PDF extraction.

---
**CLAUDE** (2026-10-19T18:15:19)

The regex is too slow. Let me use a linear scanner instead.

---
**CLAUDE** (2026-10-19T18:15:33)

Text is there but mixed with binary. Let me filter to printable text and search for the requirements.

---
**CLAUDE** (2026-10-19T18:17:07)

I have enough to plan. Let me resolve four decisions that materially change the work.

---
**CLAUDE** (2026-10-19T18:26:52)

Good — and you're right to push back on the ANSYS conclusion. My `-printavail` query returned *"Requested action STATUS is not supported in Ansys Common Licensing"*, which means the **query method** is unsupported for web/elastic licensing — not that you lack a license. Let me verify properly.

---
**CLAUDE** (2026-10-19T18:27:02)

No FlexLM variables — consistent with account-based elastic licensing. Let me find the actual checkout evidence in the licensing logs.

---
**CLAUDE** (2026-10-19T18:27:25)

There's a Fluent license log from today. Let me read it (skipping the auth token file — that holds credentials).

---
**CLAUDE** (2026-10-19T18:27:41)

**Confirmed — you were right and I was wrong.** Fluent checked out `cfd_base`, `cfd_solve_level1` and `cfd_solve_level2` ("Shared Web") at 23:52:47 today and was still heartbeating at 23:56:42. The `-printavail` failure was purely a CLI limitation under Ansys Common Licensing, exactly as its error said. Let me check what else is entitled and look up your cord.

---
**CLAUDE** (2026-10-19T18:28:32)

Everything needed is now established. Writing the plan.

---
**CLAUDE** (2026-10-19T18:37:27)

Understood — headless/batch first, GUI only as a later visual check, and independently verify that LEparagliding's own numbers are right. Let me confirm the headless entry points and check whether the zip's STLs are actually meshable.

---
**CLAUDE** (2026-10-19T18:38:20)

Found a critical issue. Let me settle it by computing the STL surface area — this is decisive.

---
**CLAUDE** (2026-10-19T18:39:21)

**Decisive finding — and it validates the design tool.** The STLs are in **centimetres**, not mm: the lower-surface area computes to 0.7057 m² against LEparagliding's stated 0.71 m² (0.6% agreement), and the projected areas match 0.67 m². Importing these as mm would make the canopy 10× too small and 100× off in area — silently invalidating every CFD result.

---
**CLAUDE** (2026-10-19T18:39:35)

Let me rewrite the plan with headless-first execution.

---
**CLAUDE** (2026-10-19T18:41:40)

Plan approved. Starting with Step 1 — installs — and setting up the working tree in parallel.

---
**CLAUDE** (2026-10-19T18:41:49)

While conda runs, let me build the working tree and stage read-only source copies.

---
**CLAUDE** (2026-10-19T18:42:17)

Now Step 2 — test MAPDL/LS-DYNA entitlement with a trivial batch job.

---
**CLAUDE** (2026-10-19T18:43:10)

MAPDL **ran and completed successfully** — structural track is unblocked. Let me confirm the license feature and the solve result.

---
**CLAUDE** (2026-10-19T18:43:24)

Both tracks confirmed licensed: **`ansys` = Ansys Mechanical Enterprise**, plus `HPC_PARALLEL` (4 cores) and the Fluent CFD features. (The test's UZMAX=0 is a quirk of my node-selection order, not a solver problem — the purpose was the license check, which passed.) Let me check the installs.

---
**CLAUDE** (2026-10-19T18:43:38)

Conda is still resolving. Let me check it and run pip in the meantime — far faster for these wheels.

---
**CLAUDE** (2026-10-19T18:46:49)

pip reported a **package hash mismatch** — worth diagnosing rather than forcing past. Let me check the conda result and pip's configuration.

---
**CLAUDE** (2026-10-19T18:47:05)

Diagnosed: **network instability, not tampering** — conda hit repeated `IncompleteRead`/"Connection broken" errors and pip's hash mismatch is the same truncated download. No proxy, no pip config, no condarc. Retrying resiliently, smallest-and-most-critical first.

---
**CLAUDE** (2026-10-19T18:48:56)

All installed. Now the critical gap — reading the actual competition rules and CDR.

---
**CLAUDE** (2026-10-19T18:49:12)

Got the real rules (40 pages). Now the sections that actually constrain the parafoil.

---
**CLAUDE** (2026-10-19T18:49:46)

Verbatim rules secured — and one **major** finding. Let me extract the CDR and record the requirements.

---
**CLAUDE** (2026-10-19T18:50:29)

Significant conflicts surfacing. Let me pull the CDR's parafoil design section and mass budget in full.

---
**CLAUDE** (2026-10-19T18:50:55)

Found a major problem: **the CDR describes a completely different canopy from the one in the zip.** Let me get the mass budget, then record everything.

---
**CLAUDE** (2026-10-19T18:51:31)

Now I have the full picture. Let me record the discrepancy register and build the Octave model.

---
**CLAUDE** (2026-10-19T18:52:36)

Now the core Octave model with full drag build-up.

---
**CLAUDE** (2026-10-19T18:53:51)

Important — and this **overturns my earlier hypothesis**. The build-up gives GR *higher* than LE's claim, not lower, and it surfaces a more serious problem. Let me bracket the sensitivity and check the sizing.

---
**CLAUDE** (2026-10-19T18:54:28)

The picture is now clear and it inverts my earlier concern. Let me get the real wind and elevation data — that decides the precision-landing verdict.

---
**CLAUDE** (2026-10-19T18:54:43)

Let me check what wind the CDR itself assumed, and search better sources.

---
**CLAUDE** (2026-10-19T18:54:54)

The CDR's wind analysis cites a MATLAB simulation but **states no wind speed and no dispersion radius** — and MATLAB is deactivated here, so it can't be reproduced. Let me get real wind data.

---
**CLAUDE** (2026-10-19T18:55:29)

Good data: **October/November are the calmest months** at the nearest station (Gorakhpur, ~50 km) — mean surface wind ~1.3–2.0 m/s. But winds at 600 m are stronger. Let me build the trajectory and dispersion model, which is the actual mission answer.

---
**CLAUDE** (2026-10-19T19:00:02)

The deterministic cases reveal the real problem — and it's a guidance issue, not an aerodynamic one. Let me verify by fixing the guidance.

---
**CLAUDE** (2026-10-19T19:09:45)

The Monte Carlo is slow in interpreted Octave — letting it run. Meanwhile, Step 6 geometry prep with the unit gate.

---
**CLAUDE** (2026-10-19T19:10:08)

Unit gate passes on all four checks. Now the guidance comparison result.

---
**CLAUDE** (2026-10-19T19:10:25)

My energy-managed law underperformed — that's a bug in my implementation (its final phase drops target tracking), not a verdict on energy management. But the Monte Carlo reveals the real driver: **21% of cases have wind exceeding airspeed**, which no guidance law can fix. Let me fix the guidance and test the smaller canopy.

---
**CLAUDE** (2026-10-19T19:11:03)

While that runs, let me prepare the CFD geometry. The STLs are open surfaces, so let me examine the boundary loops to close them headlessly.

---
**CLAUDE** (2026-10-19T19:11:26)

Clean topology — 264 boundary edges in exactly 6 loops, zero non-manifold. Let me close it headlessly.

---
**CLAUDE** (2026-10-19T19:11:56)

Watertight. But the enclosed volume (8.7 L) is below my expectation, so let me verify the airfoil profile directly rather than trust it.

---
**CLAUDE** (2026-10-19T19:12:24)

That measurement is invalid — slicing a *arched* wing in global z captures the vault slope, not the local profile (hence thickness wrongly growing toward the tip). The profile must be read from the 2D rib data instead; noting that limitation and moving on, since Fluent will give the real coefficients. Let me check the decisive area trade-off.

---
**CLAUDE** (2026-10-19T19:12:45)

Letting that run. Let me check the Fluent license seat situation before launching batch — the earlier checkout showed `1/1/1/1`, i.e. a single seat.

---
**CLAUDE** (2026-10-19T19:13:14)

Seat is free (previous Fluent exited at 23:59:26, no Ansys processes running). Let me run a cheap Fluent Meshing pilot to validate the headless path.

---
**CLAUDE** (2026-10-19T19:20:51)

Fluent Meshing launches headless correctly — but `read-boundary-mesh` is the wrong command for STL. Let me query the actual import menu.

---
**CLAUDE** (2026-10-19T19:21:34)

Menu listing doesn't echo in journal mode. Let me write an ASCII STL and test the likely commands directly.

---
**CLAUDE** (2026-10-19T19:27:22)

Let me find the valid TUI command names directly from the installation.

---
**CLAUDE** (2026-10-19T19:27:39)

Fluent's TUI is compiled, so let me probe candidates empirically — one per run, since a TUI error aborts the journal.

---
**CLAUDE** (2026-10-19T19:33:23)

The area trade-off finished — that's the decisive result. Let me read it, and see what arguments `/file/import/cad` wants.

---
**CLAUDE** (2026-10-19T19:36:16)

**That is the decisive result.** Let me capture it, then continue the Fluent import chain.

---
**CLAUDE** (2026-10-19T19:38:59)

Found the critical prompt — **"Length unit"**, which is exactly where the unit trap bites. My STL is already in metres. Let me continue the chain.

---
**CLAUDE** (2026-10-19T19:44:37)

**Fluent headless import proven** — 15624 facets, `LengthUnit: [m]`, bounding box 1.368 × 0.550 × 0.324 m, exactly matching the unit gate. Let me save the validated recipe and write up the findings, since the canopy-area result is time-critical for cutting cloth.

---
**USER** (2026-10-19T19:47:59)

go with the design the software created as the cdr design was rough please take the github software design parameter

---
**CLAUDE** (2026-10-19T19:48:14)

Locking in the LEparagliding geometry — 0.71 m², 11 cells. That's your call and it's a reasonable one: it's the tool-generated design with real rib geometry, versus the CDR's hand-sized estimate. The wind-penetration risk stays on the record, and I'll quantify what it costs you in the final report rather than re-litigating it.

Let me get the authoritative design parameters, starting with the rib profile I couldn't measure off the arched 3D surface.

---
**CLAUDE** (2026-10-19T19:48:36)

This is the 2D cutting data in **mm** (the STLs were cm — two different units in one package, worth noting). It confirms LE's areas again: 0.7146 / 0.6694 m². Let me extract the real rib profile.

---
**CLAUDE** (2026-10-19T19:48:54)

Good — 6 ribs, 5 extrados, 7 intrados panels (consistent with 12 ribs / 11 cells mirrored). Let me check the polyline format.

---
**CLAUDE** (2026-10-19T19:49:04)

Now I have the format — the `seam` closed polyline is the true aerodynamic profile. Let me extract all six ribs.

---
**CLAUDE** (2026-10-19T19:49:51)

**Chord validation is exact** — all six measured seam chords match `lep-out.txt` to the millimetre (55.00/54.45/52.80/50.05/46.20/41.25 cm). LEparagliding's output is internally consistent. But my chord axis ran TE→LE, so let me fix the orientation.

---
**CLAUDE** (2026-10-19T19:50:27)

Now clean and consistent across all ribs: **t/c = 19.1% at x/c = 0.308**, camber only **~1.1%**, TE gap 0.89%. The CDR's claimed 14% thickness and 9% camber are both wrong; its 32% thickness position was right.

That low camber matters — it means my assumed CL0 = 0.40 was too high. Let me correct it from the real profile.

---
**CLAUDE** (2026-10-19T19:51:22)

This materially improves the verdict — and **the three sources now converge**: GR 2.37 (measured profile) against LE's 2.70 and the CDR's 2.50. Let me re-run the dispersion with the corrected aero.

---
**CLAUDE** (2026-10-19T19:51:47)

While that runs, let me check the LEparagliding source to confirm its parameter conventions.

---
**CLAUDE** (2026-10-19T19:52:13)

LEparagliding isn't on GitHub — it's GPL Fortran from laboratoridenvol.com (its own run-log confirms: *"Pere Casellas, GNU GPL 3.0"*). I've taken the parameters from its actual output files for your wing, which is the better source anyway. Now the Fluent meshing chain.

---
**CLAUDE** (2026-10-19T19:57:23)

Fluent 2026 R1's meshing TUI is restructured — the classic commands are gone, replaced by the Python workflow API. Let me test the `-py` journal path.

---
**CLAUDE** (2026-10-19T20:02:40)

**Breakthrough** — the Python workflow API works: Watertight Geometry workflow with 11 tasks. Let me read the dispersion result and introspect the workflow arguments.

---
**CLAUDE** (2026-10-19T20:02:52)

Good result with the real parameters: **CEP50 = 29.5 m, 88% within 100 m, R-08 satisfied in 99.3% of runs**, and the blow-away risk drops to 12.3%. Now the Fluent mesh — let me introspect the workflow arguments.

---
**CLAUDE** (2026-10-19T20:03:56)

Arguments return empty until set — I'll set them directly. For external flow I'll build the farfield box into the STL so one mesh serves all angles of attack (velocity vector changes, not the mesh).

---
**CLAUDE** (2026-10-19T20:04:26)

Now the full meshing journal, run in background since meshing takes time.

---
**CLAUDE** (2026-10-19T20:04:48)

While the mesh builds, let me update the findings with the corrected results for your chosen design.

---
**CLAUDE** (2026-10-19T20:05:38)

Fix is clear — `MeshUnit` implied a mesh-file import. Let me set the format explicitly.

---
**CLAUDE** (2026-10-19T20:06:23)

Fluent is telling me STL counts as a *mesh* file, not CAD. Let me use `FileFormat="Mesh"`.

---
**CLAUDE** (2026-10-19T20:06:57)

While the mesh builds, let me close out the structural gap (D-03) analytically — LE never solved the line loads.

---
**CLAUDE** (2026-10-19T20:07:28)

Significant structural finding. Let me check the mesh.

---
**CLAUDE** (2026-10-19T20:07:36)

Need the exact argument names. Let me introspect the task state properly.

---
**CLAUDE** (2026-10-19T20:08:25)

No schema introspection available. For `Mesh` format the argument is `MeshFileName`, not `FileName`. Let me test the variants.

---
**CLAUDE** (2026-10-19T20:09:22)

**Import works** — `MeshFileName` + `MeshUnit`. Fluent imported 15584 faces and auto-fixed 177 reversed normals on my cap triangles. Running the full mesh now.

---
**USER** (2026-10-19T20:11:46)

<task-notification>
<task-id>bw6nscgak</task-id>
<tool-use-id>toolu_01Jq4kqV2WPiwH4s5LeDkUYj</tool-use-id>
<output-file>C:\Users\kalbh\AppData\Local\Temp\claude\D--linux-Software-Claude\ba867180-0e4c-46aa-83c8-880180ab871c\tasks\bw6nscgak.output</output-file>
<status>completed</status>
<summary>Background command "Wait for pilot mesh to finish" completed (exit code 0)</summary>
</task-notification>

---
**CLAUDE** (2026-10-19T20:12:05)

Out of memory during surface meshing — my `MinSize` 6 mm with proximity sizing across a 300 m³ domain exploded the size field. Let me coarsen the pilot and scope sizing to curvature only.

---
**CLAUDE** (2026-10-19T20:12:44)

While the mesh retries, let me build an independent vortex-lattice check using LE's own rib arch angles — this also validates the geometry a third way.

---
**CLAUDE** (2026-10-19T20:13:27)

**Geometry now validated four independent ways** — rebuilding the arch from LE's rib beta angles reproduces projected span 1.3243 m (states 1.32), vault arrow 0.2215 m (states 0.22), flat span 1.4200 m (exact), flattening 0.067 (states 0.06) and flat area 0.7146 m² (matches its 2D file exactly).

My hand-rolled VLM is wrong though — negative CL and a lift slope ~8× too high. I won't report those numbers; Fluent is the authoritative tool and is already running. Let me check it.

---
**CLAUDE** (2026-10-19T20:13:34)

Still surface meshing. Let me record the geometry validation and set a wait.

---
**CLAUDE** (2026-10-19T20:14:25)

Failing while writing the size-function file — the octree spanning 0.02 m to a 300 m³ box is blowing up memory. Let me pre-tessellate the box faces myself and skip Fluent's surface remeshing entirely.

---
**CLAUDE** (2026-10-19T20:14:45)

Domain rebuilt: 45 m³, 18120 facets, farfield pre-tessellated. Disk has 312 GB free so that wasn't it. Let me volume-mesh directly, skipping Fluent's surface remeshing.

---
**CLAUDE** (2026-10-19T20:16:21)

All workflow tasks now pass except the final volume fill — poly-hexcore refines its octree to my ~10 mm canopy facets, which exhausts memory. Let me remesh the canopy coarser and use tetrahedral fill.

---
**CLAUDE** (2026-10-19T20:18:45)

Now it's failing to allocate just ~2 GB on a 25 GB machine — that points to system memory pressure, not mesh size. Let me check before coarsening further.

---
**CLAUDE** (2026-10-19T20:19:05)

13.4 GB free but only **8.1 GB free commit** — and there are orphaned `fl2610`/`cx2610` processes from my failed runs. Let me check and clean those up.

---
**CLAUDE** (2026-10-19T20:19:13)

All six are orphans from my own failed runs (00:43, 00:51, 01:27). Cleaning them up.

---
**CLAUDE** (2026-10-19T20:20:01)

Can't terminate those (need elevation), but they only hold ~1.4 GB. The binding limit is **8.1 GB free commit**. Let me make one focused attempt with a half-model and symmetry plane, which halves everything.

---
**CLAUDE** (2026-10-19T20:23:20)

The allocation request is **identical (1.94 GB) for both a 300 m³ full model and a 22.5 m³ half model** — so this isn't mesh size, it's a fixed ~2 GB allocation the OS refuses. Further coarsening is pointless. But the "skip surface meshing" path failed differently, so let me try that on the half model.

---
**CLAUDE** (2026-10-19T20:24:21)

Mesh written. But `cells: 0` is suspicious for a 680 KB file — let me verify it actually has volume cells by loading it in the solver.

---
**CLAUDE** (2026-10-19T20:25:36)

Confirmed: **the mesh has zero volume cells** — "invalid grid". The skip-surface path produced a surface-only mesh because Share Topology's intersect failed. Fluent itself points to SpaceClaim for the boolean.

I've made six substantive 3D meshing attempts; two independent blockers, both environmental. I'll stop there and report it honestly rather than fake a result. Let me instead run the structural FEA, building the model directly from my triangle data — no mesher needed.

---
**CLAUDE** (2026-10-19T20:26:40)

Membrane-only shells have no bending stiffness, so unconstrained regions are singular — classic element formulation error. Let me use a full shell and a linear first pass.

---
**CLAUDE** (2026-10-19T20:27:46)

The FEA converged with zero errors, but the numbers are **not trustworthy** and I won't report them as results: 0.53 m deflection on a 0.55 m chord and 842 MPa in nylon (≈10× its strength) mean the model is under-constrained — my 24 heuristic fixed nodes don't represent 24 lines in tension, and a membrane this floppy needs geometric nonlinearity, which failed on excessive thickness change.

Let me record that honestly and consolidate the final report.

---
**USER** (2026-10-19T20:34:05)

Run a 2D RANS of the rib section instead - it avoids the 3D meshing blocker and pins down CD0, which is the dominant assumption.

---
**CLAUDE** (2026-10-19T20:34:48)

Good call — 2D sidesteps the blocker entirely and pins the dominant unknown. Let me start by cleaning up the airfoil coordinates.

---
**CLAUDE** (2026-10-19T20:35:38)

Clean closed loop: 64 points, upper/lower both monotonic, TE gap 0.75% chord, total thickness 19.4%. Now the structured O-grid.

---
**CLAUDE** (2026-10-19T20:36:46)

Grid is valid — all 26640 cells have consistent orientation (uniformly negative by my formula, no sign crossings), first layer exactly 6×10⁻⁵ m, outer radius 13.75 m. Now writing the Fluent mesh, determining face orientation geometrically.

---
**USER** (2026-10-19T20:36:49)

[Request interrupted by user]

---
**USER** (2026-10-20T05:02:43)

--continue

---
**CLAUDE** (2026-10-20T05:02:52)

Continuing — writing the Fluent `.msh` with geometrically-determined face orientation.

---
**CLAUDE** (2026-10-20T05:03:22)

Face count satisfies the Euler check exactly: (4×26640 + 480)/2 = 53520. Let me verify Fluent accepts it.

---
**CLAUDE** (2026-10-20T05:04:40)

A clean global orientation flip — all faces left-handed, all volumes negative. My cell-column order is inverted from Fluent's convention. Let me swap and retest.

---
**CLAUDE** (2026-10-20T05:05:47)

SIGSEGV — the swap was the wrong fix. The real issue is grid *handedness*: my quad ordering is clockwise because the airfoil loop is CCW with fluid outside. Let me reverse the loop so cells come out CCW, and regenerate.

---
**CLAUDE** (2026-10-20T05:08:14)

My cell areas are now all positive, yet Fluent still reports negative volumes — proving the sign comes from my **face normal convention**, not grid handedness. I used normal = (dy, −dx); Fluent uses the +90° rotation (−dy, dx). Let me flip just that.

---
**CLAUDE** (2026-10-20T05:10:03)

Mesh is valid now — **all volumes positive**, total 524 m³, only 5 of 53520 faces left-handed. One degenerate cell sits at the blunt trailing edge. Let me improve it and set up the solve.

---
**CLAUDE** (2026-10-20T05:20:24)

My script lacked `exit()` so Fluent hung at the prompt. Let me kill it and use the Python solver API with try/except ladders — in Python mode exceptions are catchable, so I can discover the right calls in a single run.

---
**CLAUDE** (2026-10-20T05:21:37)

Full Python API works. Let me set up the case and run the first AoA, learning the remaining attribute names in the same run.

---
**CLAUDE** (2026-10-20T05:31:56)

Learned what I needed: `velocity_specification_method` accepts 'Components', and report definitions must be created before access. Let me write the complete solve.

---
**CLAUDE** (2026-10-20T05:40:30)

CL/CD came back `None` and it finished suspiciously fast — iteration likely never ran. Let me check.

---
**CLAUDE** (2026-10-20T05:41:44)

**It did solve** — 363 iteration lines and full `.dat.h5` solution files for all four angles. Only the CL/CD *retrieval* failed (`get_active_value` doesn't exist). Let me extract the coefficients from the saved solutions.

---
**CLAUDE** (2026-10-20T05:43:08)

Those are wrong — CL *decreasing* with AoA and only ~0.05. Let me check whether the inlet velocity was actually applied.

---
**CLAUDE** (2026-10-20T05:44:39)

Inlet was applied correctly ([4.6965, 0.7111] = 4.75 m/s at 8.61°). But the lift slope is ~170× too small, so the flow isn't responding to AoA at all. Let me check convergence.

---
**CLAUDE** (2026-10-20T05:46:07)

Flow is solving correctly (inlet 4.75 m/s, no-slip wall, 970 iterations/case, velocity residuals ~1e-6 though continuity plateaued at ~3e-3). So the issue is the coefficient itself. Let me get the raw force in newtons and normalise by hand.

---
**CLAUDE** (2026-10-20T05:47:53)

**All four cases have bit-identical forces** (Fx = 0.2148 N, Fy = 0.4182 N) — the AoA change never took effect; my differing CL values were just the same force rotated. State carried over inside my loop. Let me run each angle in its own clean Fluent process.

---
**CLAUDE** (2026-10-20T06:02:51)

Now AoA takes effect and the magnitudes are right (lift slope ≈ 0.096/deg = 5.5/rad, textbook for a thick section at Re 1.7×10⁵). But the sign is inverted — `(cos α, −sin α)` is *negative* incidence. Let me re-run with the correct sign.

---
**CLAUDE** (2026-10-20T06:03:02)

While that runs (~28 min for 7 angles), let me build a parameterised mesh generator for the independence check.

---
**CLAUDE** (2026-10-20T06:03:51)

Three grid levels ready (13 280 / 26 640 / 53 640 cells, ~2× refinement). Let me check the sweep.

---
**CLAUDE** (2026-10-20T06:21:14)

Negative drag is unphysical — let me check whether my `sed` actually applied and look at the raw forces.

---
**CLAUDE** (2026-10-20T06:21:24)

My `sed` missed line 18 (it's combined with `ux=` on one line), so the freestream was still at negative incidence while the force rotation used positive — hence the nonsense. Let me fix it properly.

---
**CLAUDE** (2026-10-20T06:40:29)

Now the polar is physically sound: lift slope 0.109/deg (= 6.26/rad ≈ 2π, textbook), CL0 = 0.033 consistent with the 1.1% camber, CD0 = 0.029, max L/D ≈ 17.6 near 11°. Let me get the two pending points and run mesh independence.

---
**CLAUDE** (2026-10-20T06:40:50)

While those run, let me prepare the CFD-calibrated Octave model.

---
**CLAUDE** (2026-10-20T06:41:26)

Strong result — and it validates both published glide ratios. Let me check mesh independence and re-run the dispersion with CFD-calibrated aero.

---
**CLAUDE** (2026-10-20T06:52:36)

While that completes, let me write up the CFD results.

---
**CLAUDE** (2026-10-20T06:53:25)

Design point confirmed: **CL 0.863, CD 0.0529, L/D 16.3 at 8.61°** — matching the 0.053 I used. Let me get the Monte Carlo.

---
**CLAUDE** (2026-10-20T06:53:33)

Nine Fluent processes are competing for CPU (mesh-independence runs plus leftovers), slowing Octave. Let me wait for both.

---
**CLAUDE** (2026-10-20T06:54:11)

Something's stuck — 9 Fluent processes and no output for ~15 min. Given there's only one CFD license seat, leftovers may be holding it. Let me check.

---
**CLAUDE** (2026-10-20T06:54:37)

Nothing is stuck — there are **2 CFD seats** (not 1), both mesh-independence runs are progressing, and the Monte Carlo is just slow (3.3M interpreted loop steps). But I accidentally launched Octave twice. Let me kill the duplicate and wait.

---
**CLAUDE** (2026-10-20T06:59:45)

The 2D RANS is done and it pinned the assumption everything rested on.

**Design point (8.61°, Re 1.68×10⁵, k-ω SST):** CL 0.863, CD 0.053, L/D 16.3. Full polar from 0–14°, lift slope 0.109/deg (= 2π, textbook).

**Two independent confirmations fell out of it:**
- Reducing the CFD 2D lift slope by Helmbold for AR 2.62 gives **3.11 /rad** against the **3.108** the analytical model had been using with no CFD input — agreement to three figures.
- Both published glide ratios turn out physically reachable: LE's 2.70 needs an inlet/roughness drag increment of 0.075, the CDR's 2.50 needs 0.090, and both sit inside Lingard's published 0.05–0.13 band for ram-air canopies. **I withdraw my earlier suggestion that LE's 2.70 was optimistic** — my own first-pass 3.54 was the outlier, caused by assuming CL0 = 0.40 before the profile was measured.

**Recalibrated mission result** (3000-run Monte Carlo): GR 2.59, Vz 2.24 m/s, Vx 5.80 m/s. The tail improves sharply because airspeed is ~30% higher than my pre-CFD estimate — CEP90 falls 299 → 92.5 m, CEP95 527 → 183 m, and blow-away probability 19.8% → **7.7%**. Median accuracy is unchanged at ~30 m; the area question only ever affected the tail.

**Two things you should not read past:**
1. **Mesh independence is not demonstrated.** Coarse→medium moved CD by 14% and L/D by 17%, so the medium grid isn't in the asymptotic range. Treat CD 0.053 as ±15% until the fine grid (53 640 cells, running now) lands.
2. **R-08 compliance dropped to 95%**, from 99.3%. The CFD-measured CL0 of 0.033 (not the 0.13 I'd assumed) lowers trim CL and raises sink rate, so ~1 run in 20 breaches the 3 m/s ceiling. The violation is on the **fast** side, which means rigging the canopy with *less* incidence than the designed 8.61° is the dangerous build error — keep suspended mass ≤ ~0.9 kg and err nose-up.

Worth noting on method: each angle had to run in its own Fluent process. A shared-session loop silently reused one converged field and returned identical forces at every angle — I caught that and discarded those numbers.

While the fine grid finishes, what would you like next — the **final consolidated 17-section engineering report with the readiness assessment**, or should I **rebuild the canopy FEA** properly using LE's actual line-anchor coordinates as LINK180 tension elements (the earlier attempt gave invalid numbers I rejected)?

---
**USER** (2026-10-20T07:03:56)

<task-notification>
<task-id>bs8tptx93</task-id>
<tool-use-id>toolu_01KMdGZjcxAZYDhqvXS6Ut53</tool-use-id>
<output-file>C:\Users\kalbh\AppData\Local\Temp\claude\D--linux-Software-Claude\ba867180-0e4c-46aa-83c8-880180ab871c\tasks\bs8tptx93.output</output-file>
<status>completed</status>
<summary>Background command "Fix freestream sign and rerun full sweep" completed (exit code 0)</summary>
</task-notification>

---
**CLAUDE** (2026-10-20T07:04:01)

That notification is the already-collected sweep. Let me check the fine-grid result, which closes the mesh-independence caveat.

---
**CLAUDE** (2026-10-20T07:04:10)

The fine-grid run crashed. Let me diagnose.

---
**CLAUDE** (2026-10-20T07:04:24)

Zero iterations — it segfaulted during mesh partitioning, so the fine mesh itself is likely malformed. My generator never validated cell areas for the coarse/fine grids. Let me check.

---
**CLAUDE** (2026-10-20T07:04:56)

Found it: **the fine grid has 64 crossed cells** (negative area) near the outer blending zone — my generator's fault, not Fluent's. Coarse and medium are clean. Let me fix the generator with a pure radial fan outboard, which can't cross.

---
**CLAUDE** (2026-10-20T07:05:30)

The gate correctly refused to write a bad mesh — but the 64 crossed cells aren't in the outer zone, so my fan fix missed them. Let me locate them precisely.

---
**CLAUDE** (2026-10-20T07:05:59)

Found it: the fan started at j=134 (4.8 m out) but the crossings are at j≈117–122, inside the *marching* region. Let me start the fan much earlier — beyond ~1.5 chords a radial far field is perfectly adequate.

---
**CLAUDE** (2026-10-20T07:06:28)

Worse — the abrupt switch to the fan jumps each point radially, creating bad cells. The fan must preserve the marched radius at j0 and grow from there. Let me fix that. (Coarse and medium from the earlier successful run are still valid on disk.)

---
**CLAUDE** (2026-10-20T07:06:49)

All three grids are now clean, fine included. Since the generator changed, let me re-run all three at the design point for a consistent study.

---
**CLAUDE** (2026-10-20T07:17:24)

CL is now converging well (+0.8% coarse→medium, vs −5.8% before the generator fix), though CD still moves +9%. Note the medium CD shifted 0.0529 → 0.0495 on the corrected mesh. Let me get the fine grid.

---
**CLAUDE** (2026-10-20T07:17:38)

The three-grid study is nearly done — coarse and medium are in, fine is solving.

**Mesh independence so far** (design point 8.61°):

| Grid | Cells | CL | CD | L/D |
|---|---|---|---|---|
| coarse | 13 280 | 0.9076 | 0.0454 | 19.99 |
| medium | 26 640 | 0.9147 | 0.0495 | 18.48 |
| fine | 53 640 | solving | | |

Two things worth flagging:

**I had to fix my own mesh generator, and it changed the answer.** The fine grid originally segfaulted Fluent with zero iterations. That wasn't Fluent's fault — my generator was producing 64 cells with negative area where the normal-marching blended into the far field. Starting a radial fan at 2 chords and anchoring it to the marched radius (rather than jumping to an absolute radius) fixed it, and I added a hard validation gate that refuses to write any mesh containing non-positive cells. All three grids now pass at zero.

**The corrected mesh supersedes the design-point number I sent earlier.** CD at 8.61° moves from 0.0529 to **0.0495**, and CL from 0.863 to 0.915. That's within the ±15% band I flagged, and it also makes CL convergence much healthier — coarse→medium is now +0.8% on CL (it was −5.8% before the fix). CD is still moving +9% between those two levels, so the fine grid is the one that decides whether this is converged.

The mission conclusions don't shift materially from this: a ~6% lower CD nudges the glide ratio slightly favourable, and nothing in the dispersion or R-08 picture depends on that margin. I'll re-run the Richardson extrapolation and update the aerodynamic numbers once the fine grid lands.

I'll report the completed study when it finishes. In the meantime the choice from before still stands — the **final consolidated 17-section engineering report with the readiness assessment**, or **rebuilding the canopy FEA** with LE's actual line-anchor coordinates as LINK180 tension elements? If you don't have a preference I'll start on the report, since it's the deliverable the competition documentation needs and the FEA can follow.

---
**USER** (2026-10-20T07:21:36)

Rebuild the canopy FEA using LE's actual line anchor coordinates as LINK180 tension elements with geometric nonlinearity.

---
**CLAUDE** (2026-10-20T07:22:21)

Good — this is worth doing properly. LE gives per-line midpoint coordinates plus exact lengths, so I can reconstruct the whole cascade geometry exactly and self-validate it against the stated lengths.

---
**CLAUDE** (2026-10-20T07:22:51)

Topology is clear from the `ap` column: riser (carries 3) → 2 mains (carry 2 and 1) → 3 uppers at ribs 2/4/6. Let me reconstruct the node positions and validate against the stated lengths.

---
**CLAUDE** (2026-10-20T07:23:51)

**Plans A, B and C reconstruct to within 0.08%** — all validated. Plan 4 (brakes) fails because brake lines route to the servo, not the karabiner; LE's own load column shows 0.00 for them, so excluding them from a flight/opening load case is physically correct.

One correction this surfaces: the 24 listed lines are **one side only** (3 risers + 6 mains + 9 uppers + 6 brakes), so the full canopy needs ~36.6 m of cord, ~43 m with loops — against your 60 m. Tighter than the 21.66 m I quoted earlier.

---
**CLAUDE** (2026-10-20T07:24:31)

Anchors snap within 13–29 mm and the z values track the arch correctly. Now building the model with tension-only links and geometric nonlinearity.

---
**CLAUDE** (2026-10-20T07:26:20)

"DOF LIMIT EXCEEDED" — and the cause is a physics error on my part: **uniform internal pressure on a closed surface produces zero net force**, so the lines never tensioned and the canopy drifted as a rigid body. The load must be the net aerodynamic force. Let me apply it as distributed nodal lift instead, which is unambiguous.

---
**CLAUDE** (2026-10-20T07:26:53)

Mesh independence finished. Let me collect it while the FEA runs.

---
**CLAUDE** (2026-10-20T07:27:14)

Full three-grid study with Richardson extrapolation:

---
**CLAUDE** (2026-10-20T07:27:50)

Both cases still diverge. The root cause is fundamental: a 0.05 mm membrane held by 18 tension-only lines has no stiffness until it tensions, and quasi-static membrane inflation genuinely doesn't converge — that's why real parafoil work uses explicit dynamics.

So let me answer the actual engineering question instead: **how is load shared between the lines?** That needs the cascade truss and the load distribution, not the fabric.

---
**CLAUDE** (2026-10-20T07:28:40)

Key finding: **load sharing is 4.76:1, not equal.** Let me also note why a pure truss FEA can't work here — each anchor connects to only one line, so it has 2 unrestrained DOF (the fabric provides that restraint). The cascade is statically determinate, so let me solve it exactly instead.

---
**CLAUDE** (2026-10-20T07:29:15)

This converged and is **self-validating in two independent ways**: the riser force vector sum closes to 2.6% of the applied load, and its chordwise tilt is 12.4° — matching LE's stated canopy assiette of 11.71°.

---
**CLAUDE** (2026-10-20T07:30:20)

Now the final consolidated report.

---
**CLAUDE** (2026-10-20T07:32:04)

Shell quoting broke on the long document. Let me use the Write tool instead.

---
**USER** (2026-10-20T08:13:10)

Can I give that dimension inzip file to my tailor so he can stitch that parachute will it work that is what I want check the simulation also I think monte carlo simulation failed

---
**CLAUDE** (2026-10-20T08:13:24)

Two things to answer. Let me check the Monte Carlo first, since you may be right.

---
**CLAUDE** (2026-10-20T08:13:37)

The Monte Carlo **did** complete — exit code 0 with full results. What got killed were two `until … sleep` polling loops I'd started to watch for the result, not the simulation. But your instinct deserves a real check rather than reassurance, so let me re-run it to confirm reproducibility while I answer the tailor question.

---
**CLAUDE** (2026-10-20T08:14:17)

Now I can answer the tailor question concretely. Let me check the DXF layer structure, which is what a plotter/tailor actually needs.

---
**CLAUDE** (2026-10-20T08:15:10)

Now the key practical findings. Let me build what your tailor actually needs — the raw DXF isn't usable as-is.

---
**CLAUDE** (2026-10-20T08:15:48)

DXF validates: 2428 polylines, 36 labelled parts, layers separated, units declared. Now the instruction sheet.

---
**CLAUDE** (2026-10-20T08:16:48)

Octave is running (163 s CPU so far). Let me wait for it so I can answer your Monte Carlo question definitively.

---
**CLAUDE** (2026-10-20T08:20:46)

Both runs are **byte-identical, line for line** — the Monte Carlo is fine and exactly reproducible.

---
**CLAUDE** (2026-10-20T08:21:09)

The Monte Carlo did not fail — I re-ran it in a fresh Octave session and got byte-identical results, exit code 0. For the tailor I built a layered, mirrored, unit-declared cutting DXF plus an instruction sheet, because the zip's DXF is genuinely not usable as it is.

**On the Monte Carlo.** What you saw stop were two *polling loops* I'd started — shell `until grep …; do sleep; done` watchers that sit there checking for the result. Killing those had no effect on the simulation, which had already finished. To be sure rather than just reassuring you, I ran it again from scratch; both runs agree to the last digit (CEP50 30.6 m, CEP90 92.5 m, 91.5% within 100 m, R-08 met in 95.0%). The RNG is seeded, so that's a genuine reproducibility check, not a coincidence.

**On giving the zip to your tailor — don't, not as-is.** Three things in it would wreck the canopy:

1. **Cut lines, stitch lines and alignment marks are all on one layer** (layer "0"). He physically cannot tell which line to cut and which to sew.
2. **8 mm seam allowance is already included** in the cut line. If he adds his own on top — which any tailor would assume — every panel comes out 8 mm oversize and nothing assembles.
3. **Only half the wing is in the file.** It has 6 ribs and 10 panels; the canopy needs **12 ribs and 20 panels**. Everything must be cut twice, mirrored.

The two files I just sent fix all three: separate CUT (red) / SEAM (green) / MARK (blue) layers, all 36 parts already mirrored and labelled, millimetres declared in the header.

Two things in the instructions that genuinely matter:

- **The ribs have 4 vent holes each** that must be cut out (≈33×81, 33×80, 33×64, 21×42 mm). Miss them and the cells can't equalise pressure.
- **Grain direction is a guess.** The design file tags it `grainSource: "assumed-from-plan-layout"` — the software picked 90°, the designer never specified it. Ripstop stretches far more on the bias, so this needs a deliberate decision before cutting.

**Will it work?** The pattern produces exactly the canopy I analysed, and that canopy is sound: descent 2.2 m/s (inside the 1–3 m/s rule), glide ratio 2.5–2.7, forward speed 5.8 m/s, line strength margin ≥9× even at opening shock. Two caveats stitching can't fix: **inflation is still unverified** (nobody has specified the fabric's permeability — only a drop test settles it), and **line-length accuracy is critical** — below about 7° angle of attack the descent rate breaches 3 m/s, and the design trim is 8.61°, so you have only ~1.6° of margin. Err nose-up.

Also tell him to buy **~3.5 m of 1.5 m-wide ripstop 40D**, and to verify the plot before cutting: part `rib-1-R` must measure 559.8 mm on the red line and 550.0 mm on the green one.

Would you like me to **add a stitching assembly order** (which panel joins which rib, in sequence) **and a line-rigging jig sheet** with cut lengths under tension — that's the other half of what a tailor and you would need? Or should I leave the tailor pack as it is and go after the **CanSat structure at 20–30 g**, which is the one outright FAIL item in the report?

---
**USER** (2026-10-20T08:35:06)

Can you do simulation and then perform those simulation in ansys fluid in gui so I will get exact idea how that parachute will work in cansat 1 kg at 600m. And the zip ok but weather the dimension in it are right my tailor can make exact parachute given in that zip file

---
**CLAUDE** (2026-10-20T08:35:31)

Two things: verify the zip's dimensions are *sewable* (a different check from what I've done), and give you something visual. Let me start with the dimension check since that's blocking your tailor.

---
**CLAUDE** (2026-10-20T08:36:11)

My proxy was wrong — half the perimeter of a long thin panel is one long edge *plus* one short edge, which is exactly the ~160–180 mm discrepancy (the panel width). Let me isolate the long edges properly.

---
**CLAUDE** (2026-10-20T08:36:48)

**That settles it — and the answer is yes.** Look at the consecutive panels: `extrados-panel-2`'s shorter edge is 587.00 mm and `extrados-panel-3`'s longer edge is 586.92 mm. Panel 4→5 share 539.57 mm *exactly*. My independently measured edges also reproduce LE's own section-6 verification numbers (592.90, 586.97, 569.18, 539.53, 498.03, 440.54) to within 0.04 mm.

The ~16 mm gap against my rib-arc figure is my comparison being wrong, not the pattern — the rib outline I measured isn't the same path the panel attaches along.

---
**CLAUDE** (2026-10-20T08:37:17)

Understood — you want a straight go/no-go: **stitch it or not, and will it survive the fall.** Let me run exactly that at your 1.0 kg.

---
**CLAUDE** (2026-10-20T08:37:44)

Clear answer. Let me write it up.

---
**CLAUDE** (2026-10-20T08:38:31)

Now the visual side. Let me solve the design point and render the flow fields.

---
**CLAUDE** (2026-10-20T08:38:52)

While that solves, let me generate the mission plots — the 600 m descent at 1 kg.

---
**CLAUDE** (2026-10-20T08:39:43)

gnuplot isn't available so it fell back to fltk, which needs a display. Let me check what toolkits exist.

---
**CLAUDE** (2026-10-20T08:39:57)

gnuplot *is* available — my `graphics_toolkit` call didn't stick. Let me set it properly.

---
**CLAUDE** (2026-10-20T08:40:14)

The `\n` became a literal newline. Let me fix that line.

---
**CLAUDE** (2026-10-20T08:40:33)

The gnuplot toolkit isn't initialising (its binary isn't on PATH). Rather than keep fighting it, let me have Octave emit the data and plot with matplotlib, which is headless-safe.

---
**CLAUDE** (2026-10-20T08:42:19)

The heredoc ate a backslash, turning `\t` into a tab. Let me use forward slashes.

---
**CLAUDE** (2026-10-20T08:42:52)

Let me check the Fluent render and then open the GUI as you asked.

---
**CLAUDE** (2026-10-20T08:44:00)

Solved at your 1 kg trim: **CL 0.902, CD 0.047, L/D 19.0** at Re 2.37×10⁵. Let me check the image step and open the GUI.

---
**CLAUDE** (2026-10-20T08:44:14)

The headless run can't render — I launched with `-g` (no graphics), so the display commands are stuck. Since you want the GUI anyway, let me launch it properly with the converged case loaded.

---
**CLAUDE** (2026-10-20T08:45:17)

Fluent GUI is open — window title confirms `[2d, dp, pbns, sstkw, 4-processes]`, so the SST k-ω case loaded. Let me confirm the data came in.

---
**CLAUDE** (2026-10-20T08:45:53)

**Yes — stitch it.** The minimum safety factor anywhere in the canopy is 6.2× at the worst opening shock the rules allow, and at your 1.0 kg it descends at 2.41 m/s, inside the required 1–3 m/s. The zip's dimensions are verified correct two independent ways. The Fluent GUI is now open with the converged case.

**Will it survive the fall? Yes, comfortably.**

| Load case | g on 1 kg | worst line | safety factor |
|---|---|---|---|
| Steady glide | 1.0 | 1.1 N | **177×** |
| Opening at 14.4 m/s | 12.2 | 13.8 N | **14.5×** |
| Opening at 18 m/s | 19.1 | 21.5 N | **9.3×** |
| Opening at 22 m/s (worst the rules allow) | 28.4 | 32.1 N | **6.2×** |

Fabric and seams are at **under 0.5% of capacity** (203–2188× margin). The fabric will not tear and the seams will not pull. Recovery systems are normally designed to 1.5–2×, so you have three to four times more margin than you need.

**Are the zip dimensions right? Yes.** Consecutive panels must share an edge length or they can't be sewn — `extrados-panel-4` and `-5` share 539.57 mm *identically*, and the others match within 0.08 mm. My measurements also reproduce LEparagliding's own verification numbers to 0.04 mm, from a separate file. The pattern is self-consistent to under a tenth of a millimetre.

I need to correct something: earlier in this turn I printed a check showing 16–36 mm mismatches. **That was my error, not the pattern's** — I compared panel edges against the wrong path around the rib outline. The pattern is fine.

**At your 1.0 kg from 600 m:** descent 2.41 m/s, 249 s (4.1 min) to ground, forward speed 6.25 m/s, glide range 1555 m. CFD at that trim gives CL 0.902, CD 0.047, L/D 19.0 at Re 2.37×10⁵. The four plots show the descent profile, ground tracks (it loops to burn off surplus altitude, then lands 15–46 m from the pad), the 400-run dispersion (CEP50 32 m), and the measured polar.

**Two things stitching won't settle**, so don't skip them:
- **Will it inflate properly?** Unknown — nobody has specified the fabric's air permeability. The canopy won't break, but it could open slowly or unevenly. Only a drop test from 100–400 m answers this.
- **Your CanSat, not the parachute.** Opening shock is 12–28 g; your CDR sized the structure for 11.1 G. The parachute is fine — the body and riser anchor are the open question.

Also: cut **everything twice, mirrored** (12 ribs, 20 panels, 4 tabs), don't miss the **4 vent holes per rib**, and remember the 8 mm seam allowance is already in the cut line.

Would you like me to **walk you through reading the pressure and velocity contours in the Fluent window** that's now open, or shall I move on to **checking whether the CanSat body and riser attachment survive 20–30 g** — the one remaining FAIL item?

---
**USER** (2026-10-20T08:50:52)

@"C:\Users\kalbh\AppData\Local\Packages\5319275A.WhatsAppDesktop_cv1g1gvanyjgm\LocalState\sessions\559C81B58E53F0EDA6C1FA928A3638EE30225390\transfers\2026-42\parachute_LE.zip"
is this zip ok so this dimension are right? and will it slow my cansat while falling from 600m meter will it show it down to 3m/s. and i want you to build exactly this parachute in gui simualtion no dummy and verify this zip file dimension i can stitch

---
**CLAUDE** (2026-10-20T08:51:16)

Let me take your third point seriously — the real 3D canopy, not the 2D section. I haven't tried inspecting what the region detection actually produces, which is where it failed before.

---
**CLAUDE** (2026-10-20T08:52:49)

Now I can see the real cause: **"1 disconnected regions detected"** and the canopy faces are being treated as **baffles** (zero-thickness internal walls), not as the boundary of a void — because I stripped the root cap off the half model. Let me use the full closed canopy and inspect the regions properly.

---
**CLAUDE** (2026-10-20T08:54:02)

**Breakthrough** — with the full closed canopy, Capping succeeds and it finds **3 regions, 0 voids**: the outer fluid plus the two canopy lobes (the design has a zero-thickness central cell, so it caps as two closed bodies). And `volumetric_regions` exposes `list` / `change_type` / `tet`. Let me set the region types explicitly and mesh.

---
**CLAUDE** (2026-10-20T08:54:20)

While that builds, let me restate the two answers precisely, because the 3 m/s question has a subtlety worth being exact about.

---
**CLAUDE** (2026-10-20T08:55:49)

**The 3D mesh built — 26.2 MB**, and "delete dead zones" confirms the canopy interiors were removed leaving the fluid. Let me verify it has real cells.

---
**CLAUDE** (2026-10-20T08:57:10)

Stray text in my command. Let me read the log.

---
**CLAUDE** (2026-10-20T08:57:41)

**The 3D mesh is real and valid: 907,419 tetrahedral cells**, 1.82 M faces, all volumes positive, total 45.000 m³ matching the domain exactly. Now let me solve the actual 3D canopy at your 1 kg / 600 m condition.

---
**CLAUDE** (2026-10-20T09:08:12)

The 3D solve is running (907k cells). Let me check its progress.

---
**CLAUDE** (2026-10-20T09:08:29)

Good — only one fluid zone (`bot_zm`), so the canopy interiors were correctly deleted, and the canopy surfaces are proper wall zones. 135 of 400 iterations done. Let me wait for it.

---
**CLAUDE** (2026-10-20T09:18:58)

280/400 done, ~9 min left. The continuity residual has climbed to ~4700 though, which suggests the sliver cells at the canopy centreline are hurting convergence. Let me see it through.

---
**CLAUDE** (2026-10-20T09:29:08)

The 3D run **diverged** — continuity residual climbed monotonically from 0.39 to 3×10⁷ and the forces came out as 10²¹ N, which is pure garbage. **I'm discarding those numbers; they are not a result.**

The cause is the sliver cells I flagged: the design's zero-thickness central cell means my two capped canopy lobes nearly touch at x=0, giving orthogonal quality 3×10⁻⁸. Let me retry with the standard remedy for poor-quality meshes.

---
**CLAUDE** (2026-10-20T09:29:31)

Let me check the retry's trend before reporting.

---
**CLAUDE** (2026-10-20T09:33:01)

Pseudo-transient is holding — continuity at 0.10 and falling, versus the previous run which climbed. ~30 min to go.

---
**USER** (2026-10-20T09:51:58)

Yes - open the converged 3D case in the Fluent GUI and show me the pressure and velocity on the canopy.

---
**CLAUDE** (2026-10-20T09:52:03)

Let me wait for the solve to finish, then open it.

---
**CLAUDE** (2026-10-20T10:02:23)

Stable now (no divergence) but **plateaued** — continuity oscillating 0.19–0.37 with no downward trend across 429 iterations. Let me see the forces.

---
**CLAUDE** (2026-10-20T10:08:02)

Still non-physical — 2.68×10⁸ N of lift, i.e. "27 million kg". **Two 3D attempts, both garbage; I'm not going to dress either up as a result.** Let me confirm the diagnosis before telling you what's actually wrong.

---
**CLAUDE** (2026-10-20T10:09:54)

Diagnosis confirmed, and it's decisive: **inlet pressure ranges −3.8 MPa to +53.8 MPa**, where physically it should be within ±50 Pa. Six orders of magnitude wrong. The zone list also shows `interior--canopy` with wall/shadow pairs — so the canopy interiors are **sealed fluid pockets with no pressure datum**, which makes pressure run away, compounded by the sliver cells.

Let me open the GUI with what I can honestly show you.

---
**CLAUDE** (2026-10-20T10:11:03)

GUI is open with the converged case (`rib_1kg_design`). Let me also render the images — my earlier attempt failed only because I used `-g` (no graphics).

---
**USER** (2026-10-20T10:23:27)

Fix the 3D geometry - remove the trapped interior fluid pockets and the sliver cells at the centreline, then re-solve.

---
**CLAUDE** (2026-10-20T10:23:53)

Let me look at the actual root-loop geometry first — merging the two lobes is the fix that kills both problems at once, but only if the point sets can be welded.

---
**CLAUDE** (2026-10-20T10:24:36)

**Found it, and the fix is simple.** The two root loops sit at x = +0.0001 and −0.0001 m — a **0.2 mm slot** at the centreline (LEparagliding's zero-thickness central cell), and their (y,z) point sets are *identical*. My capping sealed each lobe separately, leaving that 0.2 mm gap as a fluid slot. Snapping to x=0 and welding merges them into one body.

---
**CLAUDE** (2026-10-20T10:25:06)

**Fixed.** The two root loops merged and vanished (264 → 136 boundary edges), it's now **watertight, zero non-manifold, and ONE single connected body** instead of two. The 0.2 mm slot is gone. Volume 8.73 L, bbox unchanged at 1.368 × 0.550 × 0.324 m. Let me rebuild the domain and mesh.

---
**CLAUDE** (2026-10-20T10:26:40)

Now **2 regions instead of 3** (one merged interior), and the canopy region was deleted. Let me verify the slivers are actually gone — that's the critical check.

---
**CLAUDE** (2026-10-20T10:28:06)

**Decisive improvement: minimum orthogonal quality is now 0.1005, up from 3.46×10⁻⁸** — a factor of three million. Only one fluid zone. Let me re-solve and check the pressure magnitudes immediately.

---
**CLAUDE** (2026-10-20T10:38:43)

**This is converging properly now** — continuity at 1.9×10⁻³ (was 3×10⁷), velocities at 10⁻⁷, all dropping monotonically. The merged geometry plus deleting the interior cell zone fixed it. ~34 min to run.

---
**USER** (2026-10-20T10:45:14)

<task-notification>
<task-id>bepnk7pmt</task-id>
<tool-use-id>toolu_01FrhyzoaRVZ4gnpdosX2mXa</tool-use-id>
<output-file>C:\Users\kalbh\AppData\Local\Temp\claude\D--linux-Software-Claude\ba867180-0e4c-46aa-83c8-880180ab871c\tasks\bepnk7pmt.output</output-file>
<status>completed</status>
<summary>Background command "Collect fixed 3D solve result" completed (exit code 0)</summary>
</task-notification>

---
**CLAUDE** (2026-10-20T10:45:29)

Residuals are already excellent — continuity 4.7×10⁻⁴, velocities 3.6×10⁻⁸. Let me let it finish.

---
**CLAUDE** (2026-10-20T10:55:46)

365/600 done, residuals fully converged (continuity 3.1×10⁻⁴). ~18 min left.

---
**CLAUDE** (2026-10-20T11:06:04)

500/600. Let me wait for the last stretch.

---
**CLAUDE** (2026-10-20T11:15:05)

**The 3D solve is now numerically valid.** Inlet pressure max is **0.94 Pa** (was 54 MPa), residuals fully converged (continuity 2.6×10⁻⁴, velocities 2.2×10⁻⁸).

But note what it says: CD = 0.0290, CL = −0.0328. That's **zero angle of attack** — I set the freestream straight along the chord. And it's a striking cross-check: the 2D run at α=0 gave CD 0.0290 and |CL| 0.0334. Identical. Let me now run it at the actual 8.61° trim.

---
**USER** (2026-10-20T11:46:39)

Open the converged 3D trim case in the Fluent GUI when it finishes and report CL, CD and the lift in kg.

---
**CLAUDE** (2026-10-20T11:46:53)

Freestream set correctly at 8.61° (0, 6.6245, 1.0030 m/s), 418/600 done, converged. Let me wait for it.

---
**CLAUDE** (2026-10-20T12:02:04)

Pressures are now physical (Cp from −2.9 to +1.03, textbook airfoil range) and it's converged — but **lift is only 0.61 N, supporting 0.062 kg instead of 1.0 kg.** That's wrong by ~16×, so let me find out why before reporting it as a result.

---
**CLAUDE** (2026-10-20T12:03:58)

Found the real cause. Area integrates to 1.6043 m² — the full canopy, so the force integration is complete. But look at the lift slope: CL went from −0.033 at 0° to +0.035 at 8.61°, i.e. **0.008/deg against an expected 0.054/deg — seven times too small.** Let me confirm why.

---
**CLAUDE** (2026-10-20T12:05:40)

Confirmed definitively: **y+ on the canopy averages 100 (range 0.45–260) with no prism boundary layers at all** — the first cell sits up to 13 mm off a 0.55 m chord. That cannot resolve circulation, which is exactly why the lift slope is 7× too low. The 2D mesh had y+ ≈ 1 with 112 graded layers.

Let me open the GUI on it as you asked.

---
**USER** (2026-10-20T12:25:02)

Add prism boundary layers to the 3D mesh so y+ is around 1, then re-solve and report the corrected 3D lift.

---
**CLAUDE** (2026-10-20T12:25:27)

Let me compute the required first-layer height and add scoped prism layers.

---
**CLAUDE** (2026-10-20T12:25:49)

Physical BL thickness at the trailing edge is 17.1 mm (3.1% chord), so **20 layers at growth 1.20 gives 18.4 mm** — a good match. First layer 9.84×10⁻⁵ m puts the cell centre at y+ ≈ 1. Let me add them, scoped to the canopy only.

---
**CLAUDE** (2026-10-20T12:36:25)

**Prism layers added successfully** — 20 layers, h1 = 9.84×10⁻⁵ m, rate 1.2, scoped to the canopy. Volume meshing now. Let me wait.

---
**CLAUDE** (2026-10-20T12:39:03)

Mesh written at **52.9 MB** (double the previous), consistent with 20 prism layers. Let me verify it before solving.

---
**CLAUDE** (2026-10-20T12:40:43)

Prism layers are in — **1,650,664 cells** with 1,484,156 mixed (wedge+tet) in the fluid zone. One concern: minimum orthogonal quality is 3.7×10⁻⁵ at the wingtip, where prisms collapse on the capped tip. Pseudo-transient handled worse before, and I have the pressure sanity gate to catch garbage. Let me solve.

---
**CLAUDE** (2026-10-20T12:51:26)

1.48M cells makes this much slower — ~1.75 h estimated. Let me watch the trend to see if it's converging before committing to the wait.

---
**CLAUDE** (2026-10-20T13:00:43)

It's **diverging exponentially** — continuity 1.0 → 2.8 → 7×10⁸ → 7×10¹² → 2×10¹⁸. No point running the remaining 417 iterations.

---
**CLAUDE** (2026-10-20T13:01:02)

Let me record this properly.

---
**USER** (2026-10-20T13:16:28)

Rebuild the wingtip geometry with smoothly curved closures so the prism layers do not collapse, then re-mesh and re-solve.

---
**CLAUDE** (2026-10-20T13:16:53)

Let me build smooth ellipsoidal tip closures instead of flat fans.

---
**CLAUDE** (2026-10-20T13:17:30)

Watertight and one body, but **130 non-manifold edges** — my last ring collapses onto the apex (at θ=π/2 all points coincide), creating degenerate triangles. Let me fix the ring distribution.

---
**CLAUDE** (2026-10-20T13:18:03)

**Watertight manifold now** — 0 boundary edges, 0 non-manifold, one body, span only +9.1 mm (0.7%). Let me rebuild the domain and re-mesh with prisms; orthogonal quality is the decisive test.

---
**CLAUDE** (2026-10-20T13:35:11)

My tip diagnosis was **wrong**. The bad cell is at (0.656, 0.451, −0.227) — that's 82% of chord, i.e. the **trailing edge**, not the tip, and it's unchanged by the domes (4.01e-5 vs 3.68e-5).

The real cause: my 18.4 mm prism stack is **thicker than the 3 mm trailing edge**, so layers from the upper and lower skins collide. Let me size the stack to fit.

---
**CLAUDE** (2026-10-20T13:45:40)

The table shows 10 layers = 2.55 mm, which still exceeds the 1.5 mm budget — I should have picked 6. Let me see the quality it gives, then correct.

---
**CLAUDE** (2026-10-20T13:56:09)

Still meshing, and there's a telling warning: duplicate nodes at y = 0.528 m — 96% of chord, the trailing edge again. That confirms the collision. Let me see the quality it lands on.

---
**USER** (2026-10-20T14:14:18)

<task-notification>
<task-id>biwxu5870</task-id>
<tool-use-id>toolu_018HgHaX7B1oDqiGgU3GVv2Y</tool-use-id>
<output-file>C:\Users\kalbh\AppData\Local\Temp\claude\D--linux-Software-Claude\ba867180-0e4c-46aa-83c8-880180ab871c\tasks\biwxu5870.output</output-file>
<status>completed</status>
<summary>Background command "Final check of 10-layer mesh quality" completed (exit code 0)</summary>
</task-notification>

---
**CLAUDE** (2026-10-20T14:14:50)

The 10-layer attempt never produced a mesh — it hung in volume meshing and I've stopped waiting on it. That's consistent with the arithmetic rather than surprising: a 2.55 mm stack into a 3 mm trailing edge means the layers from both skins interpenetrate, and the mesher reported duplicate nodes at 96% of chord before stalling.

**Where the 3D stands, plainly:**

What I did fix is real and verified — the centreline fault. LEparagliding leaves a 0.2 mm slot between the two half-wings, my capping turned that into two lobes with a sliver gap, and welding them into one body took minimum orthogonal quality from 3.5×10⁻⁸ to **0.1005**. That mesh solves cleanly: continuity 2.6×10⁻⁴, pressures 0.94 Pa where they had been 54 MPa, and Cp from −2.9 to +1.03. It also cross-validates the 2D work — **at zero incidence both give CD = 0.0290**, independently.

What I could not fix is the lift. That needs y+ ≈ 1, which needs prism layers, and:

| tip treatment | layers | stack | min ortho quality | worst cell |
|---|---|---|---|---|
| none | 0 | — | **0.1005** | — |
| flat fan | 20 | 18.4 mm | 3.68×10⁻⁵ | 82% chord |
| **smooth dome** | 20 | 18.4 mm | **4.01×10⁻⁵** | 82% chord |

The domes changed nothing, which told me my tip diagnosis was wrong. The blocker is the **3 mm trailing edge**: a stack must stay under ~1.5 mm, so only 4–6 layers fit, and that resolves about 1 mm of a 17 mm boundary layer. Fewer layers is therefore not a route to a trustworthy lift either — it would still under-predict by a large factor.

So I'm not going to produce a 3D lift number by tuning layer counts, and I won't quote the ones I got (CL 0.035, lift 0.062 kg) as anything but evidence of an under-resolved mesh.

**What this does not change:** the 2D RANS stands on its own — y+ ≈ 1, 112 graded layers, three systematically refined grids, Richardson extrapolation with GCI 9.4%, and it reproduces both LEparagliding's stated glide ratio of 2.70 and the CDR's 2.50 with physically reasonable inlet drag. Your descent rate of 2.41 m/s at 1.0 kg, the 9.3× minimum structural margin, the CEP50 of ~30 m, and the decision to stitch all rest on that and on the closed-form work — none of it on the 3D case.

Two ways forward, and I'd genuinely recommend the first: **stop the 3D here**, since it would refine numbers rather than change any conclusion, and the drop test is what would actually tell you something new. Or if you want it closed out properly, I can **add local trailing-edge size controls** — a refined TE surface mesh with a locally thinned prism stack — which is the correct fix but a real meshing exercise with no guarantee on this machine's memory. Which would you prefer?

---
**USER** (2026-10-20T14:34:00)

<task-notification>
<task-id>bc1lwft78</task-id>
<tool-use-id>toolu_01MAGB6FZYbYN7jea8PpG2Bp</tool-use-id>
<output-file>C:\Users\kalbh\AppData\Local\Temp\claude\D--linux-Software-Claude\ba867180-0e4c-46aa-83c8-880180ab871c\tasks\bc1lwft78.output</output-file>
<status>completed</status>
<summary>Background command "Size prism stack to fit the trailing edge and re-mesh" completed (exit code 0)</summary>
</task-notification>

---
**CLAUDE** (2026-10-20T14:34:44)

The 10-layer attempt has now reported in, and it also failed — with an additional cause I should correct the record on: `Error: Invalid object domain_domed`. My `sed` renamed the geometry file but the mesher's internal object reference didn't match cleanly, so the run errored before producing a mesh. So that attempt tells us nothing about whether 10 layers would have meshed — it died for a scripting reason, not a geometric one.

That doesn't change the conclusion, though. The arithmetic stands on its own: a 10-layer stack is 2.55 mm into a 3 mm trailing edge, so the layers would collide regardless, and the mesher had already warned about duplicate nodes at 96% of chord on the earlier run. Only 4–6 layers fit, and those resolve ~1 mm of a 17 mm boundary layer — not enough to give a trustworthy lift.

So the position is unchanged from my last message:

- **Fixed and verified:** the centreline fault — min orthogonal quality 3.5×10⁻⁸ → 0.1005, solve converges, pressures physical, and 3D matches 2D at zero incidence (CD 0.0290 both).
- **Not achieved:** a trustworthy 3D lift. It needs proper trailing-edge mesh treatment, not a different layer count.
- **Unaffected:** descent rate 2.41 m/s at 1.0 kg, 9.3× minimum structural margin, CEP50 ≈ 30 m, and the decision to stitch — all rest on the 2D RANS and closed-form work.

My question from before is still open: **stop the 3D here** (my recommendation — it would refine numbers rather than change any conclusion, and a drop test would tell you far more), or have me **add local trailing-edge size controls** with a locally thinned prism stack to close it out properly?

---
**USER** (2026-10-20T14:34:54)

Stop the 3D work. The 2D result and the stitching decision are what matter.

---
**CLAUDE** (2026-10-20T14:34:59)

Understood — stopping the 3D work there. Let me clean up and verify the deliverables are intact.

---
**USER** (2026-10-20T16:26:37)

so should i do stich the parachute from zip file that that opensource software gavee

---
**CLAUDE** (2026-10-20T16:27:07)

**Yes. Stitch it.**

The dimensions in that zip are correct. I verified them two independent ways — LEparagliding's own panel-vs-rib check agrees to 0.009 mm, and my own measurement found consecutive panels share their edge lengths to under 0.1 mm (panels 4 and 5 share 539.57 mm exactly). The pattern is self-consistent to under a tenth of a millimetre, so your tailor can make the exact canopy from it.

And it will survive. Minimum safety factor anywhere in the canopy is **6.2×** at the worst opening shock the rules allow; fabric and seams sit under 0.5% of capacity. At your 1.0 kg it descends at **2.41 m/s**, inside the required 1–3 m/s.

Three things though, or it will go wrong:

1. **Give him `PF072_cutting_layered.dxf`, not the raw zip.** The zip's DXF has cut lines, stitch lines and alignment marks all on one layer so he can't tell them apart — and it already includes 8 mm seam allowance. If he adds his own on top, every panel comes out oversize and nothing assembles.
2. **Cut everything twice, mirrored** — 12 ribs, 20 panels, 4 tabs. The zip only contains half the wing.
3. **Cut the 4 vent holes in every rib.** Miss them and the cells can't equalise pressure.

Then two things that aren't the tailor's job but decide whether it works:

- **Line lengths.** The canopy is designed to hang at 8.61°; below about 7° the descent rate breaks the 3 m/s rule, so you have ~1.6° of margin. Measure under light tension and err slightly nose-up.
- **Drop test it from 100–400 m before the rocket.** Inflation depends on the fabric's air permeability, which nobody has specified — that's the one thing no simulation here could settle, and the only remaining unknown about the canopy itself.

Go ahead and cut the cloth.

---
**USER** (2026-10-20T16:27:55)

so you simulated that parachute  in ansys right what is it proper desent rate how much will it slow my cansat

---
**CLAUDE** (2026-10-20T16:28:21)

Yes — but let me be precise about what ANSYS actually did, because it matters.

**What ANSYS Fluent computed:** the airflow over your rib section — lift and drag coefficients. At the 8.61° design point: **CL 0.90 ± 0.015, CD 0.056 ± 0.005**, sectional L/D ≈ 16. That ran on three systematically refined meshes with y+ ≈ 1 and Richardson extrapolation (GCI 9.4%), so those coefficients are solid.

**What ANSYS did not compute:** the descent rate itself. No CFD does — you get coefficients, then solve the force balance. That part is the Octave calculation, fed by the Fluent numbers.

I should also be straight that the **3D** Fluent run never gave usable lift — that's the work you just told me to stop. The trustworthy aerodynamics is the 2D section plus the low-aspect-ratio correction, which Fluent itself confirmed (its 2D lift slope reduced by Helmbold gives 3.11/rad against the 3.108 I'd assumed).

**How much it slows your CanSat, at 1.0 kg:**

| | speed |
|---|---|
| Under the drag chute, before deployment | ~18 m/s |
| **Under the parafoil, at 600 m** | **2.41 m/s** |
| Near the ground (denser air) | 2.34 m/s |
| Forward speed at touchdown | 6.25 m/s |

So it slows the fall from about **18 m/s to 2.4 m/s — a factor of roughly 7.5**. Descent takes **249 s (4.1 minutes)** from 600 m.

Against the competition requirement of 1–3 m/s, **2.41 m/s sits in the middle of the band** — about 0.6 m/s of margin on the fast side and 1.4 m/s on the slow side. Across my full uncertainty sweep (drag, mass, trim angle) it stays in roughly 2.0–2.6 m/s, and the rule was met in 95% of 3000 Monte Carlo runs. The 5% that failed were all on the *fast* side, from rigging the canopy flatter than 8.61° — which is why I keep pressing on line-length accuracy.

One thing to expect: it lands moving **forward at 6.25 m/s**, not dropping vertically. It's a glider, so plan the recovery and the beacon for a canopy that arrives with horizontal speed.

---
**USER** (2026-10-22T09:50:26)

<task-notification>
<task-id>bygwgi1ke</task-id>
<tool-use-id>toolu_01QuceG6cqYp4EVxTcczvsiZ</tool-use-id>
<status>stopped</status>
<summary>Background shell command didn't finish before the previous session ended</summary>
<note>No completion record was found for it in the previous session. It may have been stopped (via the UI, Monitor timeout, or agent teardown — these leave no transcript marker), or it may have been running when the previous Claude Code process exited. Check the output file for partial results before assuming it completed.</note>
</task-notification>
