itsmeabirmohanta/Sujal/source/VRITRA_CanSat_025_Handover_2026-10-28/06_chats/oct_2026_board_build/2026-10-22_7410ad31.md

# Chat session 7410ad31-36ff-475f-af06-3a5aa0db1baf.jsonl (started 2026-10-22T11:29:07.142Z)

---
**USER** (2026-10-22T11:29:07)

@"D:\Download\Cansat\cansat_competition_guidelines_3 (1).pdf" @"D:\Download\Cansat\2026-INSPACe-CAN-7USAT-025 CDR .pdf" @"C:\Users\kalbh\AppData\Local\Packages\5319275A.WhatsAppDesktop_cv1g1gvanyjgm\LocalState\sessions\38FF2A4DC39F78F10F356A7EEC2BB7B8A8105F52\transfers\2026-43\CAN7USAT Team_Frequency_Assignments_19_10.pdf"
this is most important project we have i need your full attentation here i have kicad  circuit and pcb here. i want you you to do:-

1. see all pcb circuit and schematic and verify if i do this pin in real life then will that circuit will operate properly without any error espically bootstrap and difffent type of hardware pin error
2. use your embedded skills to verify if those are correct take a look at my cdr understand what i am doing what my project it and what my approcah is.in cdr there are images i want you to properly see those to. install any pdfskill you want for it which will consume less tokens. also create a folder in which there will four files in that folder which will serve as your memory so even when i message or ask something or ask you to change as you are professional hardware enginner. so when i ask to do some thing or tell you to do chages in code you can see whole file and properly apply there your ai will not hallincate and dont give any pin that you  think will work i need proper pin connection properly after verifiying the module and weather the next pin will owrk properly as this is a satellite project.
3. read guidelines and understand what i am doing and what exactly i need. 
4. first i did build pcb but i need to verify weather all my system is working. fortunately i am building a tht pcb. so i already all the modules. i am assemblying zero board but this zero board is final i want to do structrual testing in diffent design but still same i want all this connection like i am fitting this double side zero pcb in my final cansat. i have (4) dual side 12cm width and 15 cm length zero board. i am building a circuit on this to keep it in my cansat. this three board will be places vertically in middle of my cansat. and 1 board will be dedicated to stir the ram air parachute.
5. i want you to first arrange all component that i currently have in proper order or spacing and show me that in image so i can place component accordingly. so i can run traces or proper soldered pcb lines properly . i am thinking of teensy primary place on 1 board which faces outward which will have with it gnss. 
6. i currently have :-

7semi BMP585 Pressure and altitude sensing 3 (Quantity-2) 
LSM6DSO32 (Adafruit) 6-DOF IMU and gyroscope 2 
7semi ICM-20948 7Semi 9-DOF IMU and magnetometer 8 (Quantity-2) 
7Semi HDC3020 RH Digital Relative Humidity & Temperature Sensor 1

7semi W25Q64 SPI Flash In-flight data backup 1.5 
INA226 Voltage and current monitoring 5 
memory card module
DS3231N RTC Real-time clock 3 
Teensy 4.1 Primary and backup flight controller MCU 12 (Quantity-2) 
XIAO ESP32-S3 Sense Camera module 1
Teensy 4.0 Secondary ejection control MCU 10 
LR1121 LoRa Transceiver Telemetry communication 2 
Bandwidth  T antenna 865 MHz CanSat antenna  
L89ha GPS NavIC, GPS, and GLONASS GNSS module 6.7 
AGFRC A20BHM Paraglider line control 18 (Quantity-2) 
MG90S Servo Secondary deployment/ Bio gel lid 12.5 (Quantity-2) 
2205 2300KV BLDC Motor
40A ESC 
AP64500 5V 5A Buck 
Servo power regulator 
AP62301 3.3V 2A Buck 
1.8V voltage regulation 
XT30 Connector Battery connection 
Capacitors (470µF + 0.1µF) 
Power filtering and stabilization 
Resistors (0.1Ω, 4.7kΩ, 330Ω, 10kΩ) Signal conditioning and protection 
Diodes  
Protection and switching 
Molicell 21700 5000mAh 3s Lithium-ion battery 
M9N GPS module for gnss module

1 teensy 4.1 is primary
1 teensy 4.1 for backup
1 teensy 4.0 is for servo paraglide control 

i need 2 mg90s servo output one to release the drogue parachute.
1 is to open petri plate 

the paraglide servo is this https://www.agf-rc.com/agfrc-a20clm-10-2kg-compact-coreless-digital-servo-p6530997.html i am using 2 of this. to steir the ram air parachute.

ask any question you want first read all cdr and all and also check this C:\Users\kalbh\Downloads\vritra-gcs-master\vritra-gcs-master this is gcs install this gcs software and also add autodetect in com port which is working read all ask all the quesstion you hvae dont assume anything ask me everthing. also if you have any doubt ask. i will do additional senor or environement senor i have afterward check all data properly do that

---
**CLAUDE** (2026-10-22T11:30:08)

Installed PyMuPDF so I can pull text from the three PDFs cheaply and render only the pages that matter as images. Extracting them now.

---
**CLAUDE** (2026-10-22T11:30:44)

Reading the rest of the CDR (FSM, algorithm, test results), then I'll render the schematic/layout figures as images.

---
**CLAUDE** (2026-10-22T11:31:37)

Still reading — CDR done (text + schematic/layout figures); now the competition guidelines.

---
**CLAUDE** (2026-10-22T11:32:28)

Guidelines read. Now exporting netlists from all five KiCad schematics so I can check every Teensy/module pin against the real pin capabilities.

---
**CLAUDE** (2026-10-22T11:33:26)

Netlists checked. Now looking at the GCS source to see how it picks the COM port.

---
**CLAUDE** (2026-10-22T11:34:06)

Writing the COM-port auto-detect into the GCS now (backing up the original file first), then I'll install its dependencies and test it.

---
**CLAUDE** (2026-10-22T11:35:29)

Order is safe (UI built before the first mode call). Now testing the detector with a simulated gateway and launching the GCS headless.

---
**CLAUDE** (2026-10-22T11:37:21)

Same crash on the original, untouched GCS — so it's pre-existing, not from my change. Pinning down where it crashes with Python's faulthandler.

---
**CLAUDE** (2026-10-22T11:38:12)

GCS auto-detect works: unit tests pass and the headless GUI scan finds the fake gateway and connects. Now building the standalone `VRITRA_GCS.exe` in the background while I write the memory files.

---
**CLAUDE** (2026-10-22T11:38:28)

While the .exe builds, I'm confirming the steering-servo specs from the AGFRC page you linked (voltage and current decide the power rail).

---
**CLAUDE** (2026-10-22T11:39:25)

Specs confirmed (A20CLM: 4.8–8.4 V, 6.8 kg·cm at 5 V / 10.2 at 8.4 V, stall current not published). Now writing the 4-file project memory folder.

---
**CLAUDE** (2026-10-22T11:42:34)

.exe built. Adding a pointer to this folder in my persistent memory, then I'll report back.

---
**CLAUDE** (2026-10-22T11:43:08)

I've read everything, checked the KiCad design pin by pin, built your memory folder and added auto-detect to the GCS. I have not drawn the board layout yet: I need your answers first, especially on board orientation (Q1).

## 1. Important: your radio settings have changed
The organisers' sheet from 19 Oct gives team 025 different settings from your CDR, GCS and firmware:

| | CDR / GCS / firmware now | Official 19-Oct sheet |
|---|---|---|
| Main | 867.00 MHz | **866.50 MHz** |
| Backup | 865.75 MHz | **865.25 MHz** |
| Spreading factor | SF10 | **SF9** (launch pad 3) |
| Sync word | 0x98 | **0x99** |

The sheet also requires:
- a telecommand that switches each radio link on and off;
- automatic transmit-off 90 minutes after launch;
- Wi-Fi and Bluetooth turned off on the XIAO camera.

I haven't changed the GCS or firmware constants yet; that's Q13.

## 2. KiCad check (rev E, all 5 boards)
I exported the netlists and checked every Teensy pin against what that pin can actually do (serial, SPI, I²C, PWM, analog, the power-off and program pins). **I found no pin errors.** The I²S pins, the UART pairs (Serial1/2/3/7/8), the PWM pins for servos and ESC, and the ICM-20948 CS/SDO pins on the module's 1.8 V pin are all correct.

The real risk is the difference between the KiCad design and the parts you own. The design uses parts not on your list: TPL5010, the SN74 logic chips, MAX98357A, INA260, DFR1015 and the UART mux. So the zero board needs its own simplified wiring. I've drafted it in `03_PIN_MAP_AND_WIRING.md`, reusing the already-checked Board 1 pins wherever possible.

## 3. Hardware traps for the zero board
- **INA226:** if your module's shunt resistor is 0.1 Ω, it can only measure up to 0.82 A. Use it for bus voltage only (telemetry field 7), and never run servo or ESC current through it.
- **microSD module:** the common blue module doesn't release its MISO line, so it must be the only device on its SPI bus. That's why it goes alone on the Teensy 4.0. The two 4.1s use their built-in card slots.
- **DS3231 (ZS-042):** this module tries to charge its backup cell. Remove the charging resistor if you use a CR2032.
- **ICM-20948:** connect CS and SDO to the module's 1V8 pin, never to 3.3 V. Set the address to 0x69 so it doesn't clash with the DS3231 at 0x68.
- **XIAO Sense:** don't use D8, D9 or D10 (the camera's SD card uses them). Leave D2 free, because it's a boot strapping pin.
- **Teensy:**
  - Nothing connects to the On/Off or Program pins.
  - Cut the VIN–VUSB pad if USB and external 5 V will be connected together.
  - None of the pins tolerate 5 V, so pull the Hall sensor output up to 3.3 V.
- **Signals between boards:** put a 1 kΩ resistor in series at the driving end of every one, so a powered board can't feed current into an unpowered Teensy.
- **A20CLM servo:** at 5 V it gives only 6.8 kg·cm (10.2 needs 8.4 V), and AGFRC publishes no stall current, so you'll need to measure it. Your CDR says A20BHM, but the part you own is the A20CLM.
- **Missing from your list but required by the rules:** a beacon of at least 92 dB, a Hall sensor for the gyro spin rate (field 14), an external switch with LED, and a BMS.

## 4. Board geometry problem (blocks the layout image)
A 120 mm-wide board standing upright inside your Ø124 mm body only fits within about 15 mm of the centre. The four rods (at 47 mm from centre) also cut across any board through the middle. If "vertical" instead means stacked like the CDR, the 12×15 boards must be cut down to Ø110 discs.

## 5. Memory folder: [VRITRA_ZeroBoard_Memory](VRITRA_ZeroBoard_Memory)
- `01_PROJECT_CONTEXT.md`: the mission rules, the radio assignment and the architecture.
- `02_HARDWARE_INVENTORY.md`: every part you own, with what I verified and what I haven't.
- `03_PIN_MAP_AND_WIRING.md`: the draft pin map and power tree.
- `04_DECISIONS_CHANGELOG.md`: the open questions, decisions, change log, and the rules I'll follow before touching any pin or code.

## 6. GCS
- Dependencies are installed and `gcs\dist\VRITRA_GCS.exe` is built.
- There's a new **Auto-detect** button. It listens on each COM port without sending anything. It connects to the port showing the gateway's startup message, or failing that to one carrying your telemetry lines. It also runs automatically if you start Live mode without choosing a port.
- My tests and a headless run of the GCS passed. I haven't tried it with your real gateway yet.
- The original file is saved as `vritra_gcs.py.orig_before_autodetect`.

## Questions (also in file 04)
1. **Q1:** Does "vertical" mean boards standing on edge along the can's axis, or the stacked plates from the CDR? What are the inner diameter and rod positions of the new structure, and will you cut the boards?
2. **Q2:** How many do you actually own of: LR1121, L89HA, INA226, AP64500, AP62301, XIAO, GNSS antennas and T-antennas? Your list gives masses in grams, not quantities.
3. **Q3:** Which LR1121 module is it? A photo of the pin labels would help.
4. **Q4:** Which microSD module, and which MCU is it for?
5. **Q5:** Which DS3231 module, and what backup cell?
6. **Q6:** Which M9N breakout, and does it have its own antenna?
7. **Q7:** What is the INA226 shunt value, and do you need current or only voltage?
8. **Q8:** Is the AP64500 fixed at 5 V? Are the steering servos OK at 5 V, or do you need 7.4–8.4 V?
9. **Q9:** Do you have a beacon, Hall sensor, switch with LED, and BMS? Which parts?
10. **Q10:** Can you buy a third BMP585 for the Teensy 4.0, or should it get altitude from the primary? The second option means one failure stops the 600 m trigger.
11. **Q11:** Does the "drogue release" MG90S cut the primary parachute free, or open the parafoil bay? Rule 5.4.iv says the primary must stay attached with no ejection mechanism on it.
12. **Q12:** What is the 1.8 V regulator for?
13. **Q13:** Can I update the GCS and firmware to 866.50 / 865.25 MHz, SF9, sync 0x99?
14. **Q14:** Do the power parts (bucks, BMS, XT30s) go on one of the three middle boards, or near the battery?

Photos of each module's pin labels would let me move the remaining unverified items in file 02 to verified.

---
**USER** (2026-10-22T11:50:16)

<pasted_content id="735a">
Traceback (most recent call last):
  File "pyi_rth_pkgres.py", line 177, in <module>
  File "pyi_rth_pkgres.py", line 44, in _pyi_rthook
  File "pyimod02_importers.py", line 457, in exec_module
  File "pkg_resources\__init__.py", line 42, in <module>
  File "pyimod02_importers.py", line 457, in exec_module
  File "plistlib.py", line 70, in <module>
  File "pyimod02_importers.py", line 457, in exec_module
  File "xml\parsers\expat.py", line 4, in <module>
ImportError: DLL load failed while importing pyexpat: The operating system cannot run %1.
</pasted_content id="735a">

---
**CLAUDE** (2026-10-22T11:50:22)

The .exe crashes at startup because a DLL called `libexpat` failed to load. That usually means the build bundled the wrong one, so I'm checking which copy went into the .exe.

---
**CLAUDE** (2026-10-22T11:52:59)

My spec edits were refused because I hadn't opened the file with the Read tool yet, so that rebuild used the unchanged spec. Applying the edits properly now.

---
**CLAUDE** (2026-10-22T11:55:24)

Now it bundles Miniconda's own `libexpat.dll`. Next I'm launching the real .exe for 15 seconds to confirm it starts and stays up.

---
**CLAUDE** (2026-10-22T11:55:46)

The rebuilt .exe starts and shows the main window. Logging the fix in the memory changelog.

---
**CLAUDE** (2026-10-22T11:55:56)

The GCS .exe now starts. I rebuilt it and ran it for 15 seconds: it stayed open with the "VRITRA GCS · 2026-INSPACe-CAN-7USAT-025" window up.

**What was wrong:** your PATH includes an Oracle Database folder (`Downloads\WINDOWS.X64_213000_db_home\bin`) that has its own `libexpat.dll`. When building the .exe, PyInstaller picked up that copy instead of Miniconda's. It doesn't work with this Python, so the .exe crashed at startup with "DLL load failed while importing pyexpat". The bug wasn't in the GCS code itself.

**The fix, in [VRITRA_GCS.spec](../../../Users/kalbh/Downloads/vritra-gcs-master/vritra-gcs-master/gcs/VRITRA_GCS.spec):**
- The build now looks in the Python installation's own DLL folders first, so it always bundles the matching `libexpat.dll` (now from `miniconda3\Library\bin`).
- If a foreign `libexpat` ever gets picked up again, the build stops with a clear error instead of producing a broken .exe.

Your rebuilt file is at `gcs\dist\VRITRA_GCS.exe`. If you rebuild later, `build_exe.bat` uses the same spec, so the fix carries over. I've logged it in `04_DECISIONS_CHANGELOG.md`.

The zero-board layout image still needs your answers to the 14 questions from my previous message, especially Q1 on board orientation and Q2 on how many of each part you have.

---
**USER** (2026-10-22T12:20:58)

[image attached]
[image attached]
[image attached]
[image attached]
1. vertical” mean boards standing on edge along the can’s axis. rod is 8mm in diameter and this pcb will be attached in slots after i 3d print a mount for this pcb which will help it to stay there.
2. waveshare LR1121xf  (2 sender and receiver i am omiting the extra i will use t antenna with this module),  7semi L89HA(1) mounted on primary board, 7semi INA260 (i have 3, 1 is enough all are not required mainly i need battery status and line see the frr review file it will tell you what they expect), 7semi AP64500 (2),  7semi AP62301 (2), XIAO camera (1) , GNSS antennas (1)  and T-antennas (2), also whip antenna that came with lora (2). i also have 4 (KCD1-5-103W-Waterproof Round Rocker Switch-3Pin(ON-OFF-ON) i also have 5 xt60pw-f30gy. i also have red and green led.
3. i have  Core1121 LF/HF Dual-Band LoRa Module, Based on Low-Power LR1121 Transceiver, Suitable For Sub-GHz And 2.4GHz Frequency Bands (https://www.waveshare.com/core1121-xf.htm?sku=31899)
4. i have snl74hc125 module on my sdcard adapter i have also shared pic
5. i have shared the image of rtc clock
6. i dont have m9n antenna i have the gps navic antenna i have shared image of that too. 
7. see the frr document and guide line and gss i think as many as parameter i can show it is better 
8. the buck are of fixed value but for stering servo i have seprate 8v buck 5v buck is for teensyt and other component which required seprate 5v power. remainber two sterring servo gets power from seprate multi output buck
9. i have Hall sensor, switch with LED. omit bms,beacon.
10. i can buy third
11. mg90 dosent relase the drogue shoot or let go of drogue shoot it is attache to ram air parchute. the mg90s open the ram air parachute which will glide the cansat which will be driven by 2 servo which i shared earlier 7 v one. 
12. nothing 
13. yes
14. i think near the battery is good add one more board 

if you have more question please ask

---
**CLAUDE** (2026-10-22T12:22:49)

Thanks, that settles most of it. A few answers change the design. You have one Core1121 in the CanSat (the other is for the ground station), so the backup Teensy has no radio of its own. You have only one GNSS antenna, so the M9N can't work. The INA260 replaces the INA226. The power board becomes a fifth board. I'll update the plan, check the new parts and draw the layout.

---
**CLAUDE** (2026-10-22T12:30:05)

GCS done. Now the flight-computer config.

---
**CLAUDE** (2026-10-22T12:30:46)

Radio settings are updated everywhere. Before finalising the zero-board pins, I'm checking which pins the existing flight firmware already uses. Matching it means less code to change before FRR.

---
**CLAUDE** (2026-10-22T12:34:10)

Real module sizes are extracted. Now solving where three upright boards fit inside the Ø124 mm body alongside four Ø8 mm rods.

---
**CLAUDE** (2026-10-22T12:39:41)

The memory files are updated. The .exe rebuild with the new radio settings is still running; I'll check it when it finishes.

---
**CLAUDE** (2026-10-22T12:40:09)

The placement drawings are ready, and the GCS and firmware now use the new radio settings. The GCS .exe is still rebuilding with those settings, so the copy in `gcs\dist` is the old one until it finishes.

**FRR is in 4 days: 26 Oct, 10:34 AM, on Webex.** You'll show demo videos and results for the mission GUI, telemetry, and battery status and provisions, with the CanSat on camera. Launch is 31 Oct to 3 Nov. So build board A (primary) and board E (power) first.

## Placement sheets
They're in [layout](layout), drawn to scale on your real 120 × 150 mm boards. Grey dots are holes at 2.54 mm pitch, solid boxes are parts you own, and dashed boxes are reserved for parts you don't have yet.

| File | Content |
|---|---|
| `00_cross_section.png` | Top view of the can: how the 3 upright boards, 4 rods and the shell fit together |
| `01_board_A_primary.png` | Teensy 4.1 #1, Core1121, L89HA, BMP585, ICM-20948, DS3231, W25Q64, LEDs, connectors. Every Teensy pin is labelled with its wire |
| `02_board_B_backup.png` | Teensy 4.1 #2, BMP585 #2, LSM6DSO32, XIAO cable connector |
| `03_board_C_environment.png` | HDC3020, plus reserved space for the environmental sensors |
| `04_board_D_parafoil.png` | Teensy 4.0, ICM-20948 #2, SD module, 6 servo/ESC/Hall plugs |
| `05_board_E_power.png` | XT60 battery input, switch, 3× INA260, 2× AP64500, 2× AP62301, 8 V buck, XT30 to ESC |
| `06_harness_overview.png` | Every cable between boards |

**Why the boards aren't all full width:** inside a Ø124 mm body, a 120 mm board only fits exactly on the centre line, and two rods would pass through it. So:
- **A** (primary) keeps the central 100 mm (trim 10 mm per side).
- **B** (backup) is cut to 84 mm and slides between the rods at ±47 mm, which act as its side rails.
- **C** (environment) keeps the central 100 mm.
- **D** (parafoil) and **E** (power) are drawn with 100 mm kept too, as a placeholder until I know where they mount.

## What I changed because of your answers
- **Board A uses the pin map of your working flight firmware (`vritra_fc`), not the KiCad design.** That firmware already runs:
  - the LoRa radio on pins 24/25/26/27/29/30/39;
  - the L89 GNSS on pins 7/8, with reset on pin 6;
  - the battery voltage reading on pin 20;
  - pins 2/3/4/37 kept for the beacon amplifier.

  Wiring it this way means no firmware pin changes for FRR. Pins marked `*` on the sheet are new and will need code.
- **Radio settings:** GCS and all firmware builds now use **866.50 / 865.25 MHz, SF9, sync 0x99**. Nothing has been flashed or tested over the air yet.
- **Battery status for FRR:** three INA260 monitors measure the battery bus, the 8 V steering rail and the 5 V logic rail. Those feed fields the GCS already shows: bus voltage, current, state of charge, servo voltage and current, power, and energy. You'll need firmware to read the INA260s.
- **Only one Core1121 flies,** so backup board B can log but can't transmit.
- **The L89HA has its own built-in antennas** (Quectel datasheet), and its default 9600 baud matches your firmware. Your NavIC antenna is spare, so it could go to the M9N.
- **DS3231:** remove the charging resistor next to the diode, because it would try to charge your non-rechargeable CR2032.
- **SD module:** power it from 5 V, and keep it as the only device on board D's SPI bus.

## Still open (in `04_DECISIONS_CHANGELOG.md`)
- **Q15:** the new structure's inner diameter, rod circle and free height (the box below asks for these).
- **Q16:** check the print on your Core1121 says **HF**. The LF version can't transmit at 866.5 MHz.
- **Q17:** the 8 V buck model and size, the Hall sensor model, and the switch's current rating. The whole battery current flows through that switch.
- **Q18:** you said to leave out the beacon, but rule 5.2.v requires one of at least 92 dB, and FRR checks provisions.
- **Q19 to Q21:** where the NavIC antenna goes, whether to buy a third Core1121 so the backup can transmit, and a photo of the back of an INA260 so I can set its address pads.

There is no Teensy 4.0 parafoil firmware yet, and backup board B and the INA260s need new code. I can start on whichever matters most for FRR once you confirm the dimensions.

Sources: [Waveshare Core1121-XF product page](https://www.waveshare.com/core1121-xf.htm?sku=31899), [Waveshare Core1121-XF wiki](https://www.waveshare.com/wiki/Core1121-XF), [AGFRC A20CLM](https://www.agf-rc.com/agfrc-a20clm-10-2kg-compact-coreless-digital-servo-p6530997.html), [Hubtronics 7Semi INA260](https://hubtronics.in/sensors/ina260-voltage-current-power-monitor-sensor), [Adafruit INA260 pinouts](https://learn.adafruit.com/adafruit-ina260-current-voltage-power-sensor-breakout/pinouts), [TI INA260 EVM guide](https://ti.com/document-viewer/lit/html/SBOU180B/GUID-A6F48B15-120A-413D-9BEA-778901F31B67), [Hubtronics L89HA breakout](https://hubtronics.in/l89ha-breakout-multi-gnss), [Quectel forum: L89HA PSTM commands](https://forums.quectel.com/t/problem-with-pstm-commands-for-l89ha-gnss-module/48222), [Quectel forum: L89 and IRNSS](https://forums.quectel.com/t/use-of-l89-gnss-engine-for-irnss/4335?page=3), [Hubtronics L89HA-S90](https://hubtronics.in/quectel-l89ha-s90-dual-band-gnss-module), [Evelta 7Semi L89 USB dongle](https://evelta.com/7semi-l89-usb-gps-dongle-multi-gnss-engine-for-gps-irnss-glonass-beidou-galileo-and-qzss/), [DigiKey L89HA EVB](https://www.digikey.it/en/products/detail/quectel/L89HAEVB-KIT/16903732), and your `L89-datasheet.pdf`.

---
**USER** (2026-10-22T12:40:18)

<task-notification>
<task-id>b3szzdsd0</task-id>
<tool-use-id>toolu_01KD8c3qKh6pyciJHPPodcCA</tool-use-id>
<output-file>C:\Users\kalbh\AppData\Local\Temp\claude\D--linux-Software-Claude\7410ad31-36ff-475f-af06-3a5aa0db1baf\tasks\b3szzdsd0.output</output-file>
<status>completed</status>
<summary>Background command "Rebuild GCS exe with new radio constants" completed (exit code 0)</summary>
</task-notification>

---
**CLAUDE** (2026-10-22T12:40:42)

The rebuilt GCS .exe is ready at `gcs\dist\VRITRA_GCS.exe` (built 22 Oct, 18:10) and uses the new radio settings: 866.50 / 865.25 MHz, SF9, sync 0x99. I launched it and it ran for 15 seconds with the main window open.

The radios themselves are not on the new settings yet. You still need to flash `vritra_fc` to the CanSat Teensy and `vritra_gs` to the ground-station gateway.

Nothing else has changed. The layout is still waiting on the new structure's inner diameter, rod circle and free height (question Q15).

---
**USER** (2026-10-22T13:08:15)

the cansat is total 13 cm diameter outer and height is 40 cm inner diaameter is 12 cm rod outer dimension is 8 mm

---
**CLAUDE** (2026-10-22T13:09:12)

Thanks, those numbers matter. The inner diameter is **120 mm**, not the 124 mm I assumed, so the usable radius drops to 59 mm (allowing 1 mm wall clearance). That changes which parts fit near board edges. You didn't give the rod-circle diameter. I'll check whether the 94 mm circle from the CDR still fits; if you can choose, it's the one I'd recommend. I'll also add an automatic fit check that tests every part's height against the shell curve at its position, instead of the single 15 mm envelope.

---
**USER** (2026-10-22T13:09:41)

[Request interrupted by user]
