itsmeabirmohanta/Sujal/source/VRITRA_CanSat_025_Handover_2026-10-28/06_chats/oct_2026_board_build/2026-10-22_82db8d36.md

# Chat session 82db8d36-3829-40ca-92d8-a3612cf1d4dd.jsonl (started 2026-10-22T11:29:07.142Z)

---
**USER** (2026-10-22T11:29:07)

@"D:\Download\Cansat\cansat_competition_guidelines_3 (1).pdf" @"D:\Download\Cansat\2026-INSPACe-CAN-7USAT-025 CDR .pdf" @"C:\Users\kalbh\AppData\Local\Packages\5319275A.WhatsAppDesktop_cv1g1gvanyjgm\LocalState\sessions\38FF2A4DC39F78F10F356A7EEC2BB7B8A8105F52\transfers\2026-43\CAN7USAT Team_Frequency_Assignments_19_10.pdf"
this is most important project we have i need your full attentation here i have kicad  circuit and pcb here. i want you you to do:-

1. see all pcb circuit and schematic and verify if i do this pin in real life then will that circuit will operate properly without any error espically bootstrap and difffent type of hardware pin error
2. use your embedded skills to verify if those are correct take a look at my cdr understand what i am doing what my project it and what my approcah is.in cdr there are images i want you to properly see those to. install any pdfskill you want for it which will consume less tokens. also create a folder in which there will four files in that folder which will serve as your memory so even when i message or ask something or ask you to change as you are professional hardware enginner. so when i ask to do some thing or tell you to do chages in code you can see whole file and properly apply there your ai will not hallincate and dont give any pin that you  think will work i need proper pin connection properly after verifiying the module and weather the next pin will owrk properly as this is a satellite project.
3. read guidelines and understand what i am doing and what exactly i need. 
4. first i did build pcb but i need to verify weather all my system is working. fortunately i am building a tht pcb. so i already all the modules. i am assemblying zero board but this zero board is final i want to do structrual testing in diffent design but still same i want all this connection like i am fitting this double side zero pcb in my final cansat. i have (4) dual side 12cm width and 15 cm length zero board. i am building a circuit on this to keep it in my cansat. this three board will be places vertically in middle of my cansat. and 1 board will be dedicated to stir the ram air parachute.
5. i want you to first arrange all component that i currently have in proper order or spacing and show me that in image so i can place component accordingly. so i can run traces or proper soldered pcb lines properly . i am thinking of teensy primary place on 1 board which faces outward which will have with it gnss. 
6. i currently have :-

7semi BMP585 Pressure and altitude sensing 3 (Quantity-2) 
LSM6DSO32 (Adafruit) 6-DOF IMU and gyroscope 2 
7semi ICM-20948 7Semi 9-DOF IMU and magnetometer 8 (Quantity-2) 
7Semi HDC3020 RH Digital Relative Humidity & Temperature Sensor 1

7semi W25Q64 SPI Flash In-flight data backup 1.5 
INA226 Voltage and current monitoring 5 
memory card module
DS3231N RTC Real-time clock 3 
Teensy 4.1 Primary and backup flight controller MCU 12 (Quantity-2) 
XIAO ESP32-S3 Sense Camera module 1
Teensy 4.0 Secondary ejection control MCU 10 
LR1121 LoRa Transceiver Telemetry communication 2 
Bandwidth  T antenna 865 MHz CanSat antenna  
L89ha GPS NavIC, GPS, and GLONASS GNSS module 6.7 
AGFRC A20BHM Paraglider line control 18 (Quantity-2) 
MG90S Servo Secondary deployment/ Bio gel lid 12.5 (Quantity-2) 
2205 2300KV BLDC Motor
40A ESC 
AP64500 5V 5A Buck 
Servo power regulator 
AP62301 3.3V 2A Buck 
1.8V voltage regulation 
XT30 Connector Battery connection 
Capacitors (470µF + 0.1µF) 
Power filtering and stabilization 
Resistors (0.1Ω, 4.7kΩ, 330Ω, 10kΩ) Signal conditioning and protection 
Diodes  
Protection and switching 
Molicell 21700 5000mAh 3s Lithium-ion battery 
M9N GPS module for gnss module

1 teensy 4.1 is primary
1 teensy 4.1 for backup
1 teensy 4.0 is for servo paraglide control 

i need 2 mg90s servo output one to release the drogue parachute.
1 is to open petri plate 

the paraglide servo is this https://www.agf-rc.com/agfrc-a20clm-10-2kg-compact-coreless-digital-servo-p6530997.html i am using 2 of this. to steir the ram air parachute.

ask any question you want first read all cdr and all and also check this C:\Users\kalbh\Downloads\vritra-gcs-master\vritra-gcs-master this is gcs install this gcs software and also add autodetect in com port which is working read all ask all the quesstion you hvae dont assume anything ask me everthing. also if you have any doubt ask. i will do additional senor or environement senor i have afterward check all data properly do that

---
**CLAUDE** (2026-10-22T11:30:08)

Installed PyMuPDF so I can pull text from the three PDFs cheaply and render only the pages that matter as images. Extracting them now.

---
**CLAUDE** (2026-10-22T11:30:44)

Reading the rest of the CDR (FSM, algorithm, test results), then I'll render the schematic/layout figures as images.

---
**CLAUDE** (2026-10-22T11:31:37)

Still reading — CDR done (text + schematic/layout figures); now the competition guidelines.

---
**CLAUDE** (2026-10-22T11:32:28)

Guidelines read. Now exporting netlists from all five KiCad schematics so I can check every Teensy/module pin against the real pin capabilities.

---
**CLAUDE** (2026-10-22T11:33:26)

Netlists checked. Now looking at the GCS source to see how it picks the COM port.

---
**CLAUDE** (2026-10-22T11:34:06)

Writing the COM-port auto-detect into the GCS now (backing up the original file first), then I'll install its dependencies and test it.

---
**CLAUDE** (2026-10-22T11:35:29)

Order is safe (UI built before the first mode call). Now testing the detector with a simulated gateway and launching the GCS headless.

---
**CLAUDE** (2026-10-22T11:37:21)

Same crash on the original, untouched GCS — so it's pre-existing, not from my change. Pinning down where it crashes with Python's faulthandler.

---
**CLAUDE** (2026-10-22T11:38:12)

GCS auto-detect works: unit tests pass and the headless GUI scan finds the fake gateway and connects. Now building the standalone `VRITRA_GCS.exe` in the background while I write the memory files.

---
**CLAUDE** (2026-10-22T11:38:28)

While the .exe builds, I'm confirming the steering-servo specs from the AGFRC page you linked (voltage and current decide the power rail).

---
**CLAUDE** (2026-10-22T11:39:25)

Specs confirmed (A20CLM: 4.8–8.4 V, 6.8 kg·cm at 5 V / 10.2 at 8.4 V, stall current not published). Now writing the 4-file project memory folder.

---
**CLAUDE** (2026-10-22T11:42:34)

.exe built. Adding a pointer to this folder in my persistent memory, then I'll report back.

---
**CLAUDE** (2026-10-22T11:43:08)

I've read everything, checked the KiCad design pin by pin, built your memory folder and added auto-detect to the GCS. I have not drawn the board layout yet: I need your answers first, especially on board orientation (Q1).

## 1. Important: your radio settings have changed
The organisers' sheet from 19 Oct gives team 025 different settings from your CDR, GCS and firmware:

| | CDR / GCS / firmware now | Official 19-Oct sheet |
|---|---|---|
| Main | 867.00 MHz | **866.50 MHz** |
| Backup | 865.75 MHz | **865.25 MHz** |
| Spreading factor | SF10 | **SF9** (launch pad 3) |
| Sync word | 0x98 | **0x99** |

The sheet also requires:
- a telecommand that switches each radio link on and off;
- automatic transmit-off 90 minutes after launch;
- Wi-Fi and Bluetooth turned off on the XIAO camera.

I haven't changed the GCS or firmware constants yet; that's Q13.

## 2. KiCad check (rev E, all 5 boards)
I exported the netlists and checked every Teensy pin against what that pin can actually do (serial, SPI, I²C, PWM, analog, the power-off and program pins). **I found no pin errors.** The I²S pins, the UART pairs (Serial1/2/3/7/8), the PWM pins for servos and ESC, and the ICM-20948 CS/SDO pins on the module's 1.8 V pin are all correct.

The real risk is the difference between the KiCad design and the parts you own. The design uses parts not on your list: TPL5010, the SN74 logic chips, MAX98357A, INA260, DFR1015 and the UART mux. So the zero board needs its own simplified wiring. I've drafted it in `03_PIN_MAP_AND_WIRING.md`, reusing the already-checked Board 1 pins wherever possible.

## 3. Hardware traps for the zero board
- **INA226:** if your module's shunt resistor is 0.1 Ω, it can only measure up to 0.82 A. Use it for bus voltage only (telemetry field 7), and never run servo or ESC current through it.
- **microSD module:** the common blue module doesn't release its MISO line, so it must be the only device on its SPI bus. That's why it goes alone on the Teensy 4.0. The two 4.1s use their built-in card slots.
- **DS3231 (ZS-042):** this module tries to charge its backup cell. Remove the charging resistor if you use a CR2032.
- **ICM-20948:** connect CS and SDO to the module's 1V8 pin, never to 3.3 V. Set the address to 0x69 so it doesn't clash with the DS3231 at 0x68.
- **XIAO Sense:** don't use D8, D9 or D10 (the camera's SD card uses them). Leave D2 free, because it's a boot strapping pin.
- **Teensy:**
  - Nothing connects to the On/Off or Program pins.
  - Cut the VIN–VUSB pad if USB and external 5 V will be connected together.
  - None of the pins tolerate 5 V, so pull the Hall sensor output up to 3.3 V.
- **Signals between boards:** put a 1 kΩ resistor in series at the driving end of every one, so a powered board can't feed current into an unpowered Teensy.
- **A20CLM servo:** at 5 V it gives only 6.8 kg·cm (10.2 needs 8.4 V), and AGFRC publishes no stall current, so you'll need to measure it. Your CDR says A20BHM, but the part you own is the A20CLM.
- **Missing from your list but required by the rules:** a beacon of at least 92 dB, a Hall sensor for the gyro spin rate (field 14), an external switch with LED, and a BMS.

## 4. Board geometry problem (blocks the layout image)
A 120 mm-wide board standing upright inside your Ø124 mm body only fits within about 15 mm of the centre. The four rods (at 47 mm from centre) also cut across any board through the middle. If "vertical" instead means stacked like the CDR, the 12×15 boards must be cut down to Ø110 discs.

## 5. Memory folder: [VRITRA_ZeroBoard_Memory](VRITRA_ZeroBoard_Memory)
- `01_PROJECT_CONTEXT.md`: the mission rules, the radio assignment and the architecture.
- `02_HARDWARE_INVENTORY.md`: every part you own, with what I verified and what I haven't.
- `03_PIN_MAP_AND_WIRING.md`: the draft pin map and power tree.
- `04_DECISIONS_CHANGELOG.md`: the open questions, decisions, change log, and the rules I'll follow before touching any pin or code.

## 6. GCS
- Dependencies are installed and `gcs\dist\VRITRA_GCS.exe` is built.
- There's a new **Auto-detect** button. It listens on each COM port without sending anything. It connects to the port showing the gateway's startup message, or failing that to one carrying your telemetry lines. It also runs automatically if you start Live mode without choosing a port.
- My tests and a headless run of the GCS passed. I haven't tried it with your real gateway yet.
- The original file is saved as `vritra_gcs.py.orig_before_autodetect`.

## Questions (also in file 04)
1. **Q1:** Does "vertical" mean boards standing on edge along the can's axis, or the stacked plates from the CDR? What are the inner diameter and rod positions of the new structure, and will you cut the boards?
2. **Q2:** How many do you actually own of: LR1121, L89HA, INA226, AP64500, AP62301, XIAO, GNSS antennas and T-antennas? Your list gives masses in grams, not quantities.
3. **Q3:** Which LR1121 module is it? A photo of the pin labels would help.
4. **Q4:** Which microSD module, and which MCU is it for?
5. **Q5:** Which DS3231 module, and what backup cell?
6. **Q6:** Which M9N breakout, and does it have its own antenna?
7. **Q7:** What is the INA226 shunt value, and do you need current or only voltage?
8. **Q8:** Is the AP64500 fixed at 5 V? Are the steering servos OK at 5 V, or do you need 7.4–8.4 V?
9. **Q9:** Do you have a beacon, Hall sensor, switch with LED, and BMS? Which parts?
10. **Q10:** Can you buy a third BMP585 for the Teensy 4.0, or should it get altitude from the primary? The second option means one failure stops the 600 m trigger.
11. **Q11:** Does the "drogue release" MG90S cut the primary parachute free, or open the parafoil bay? Rule 5.4.iv says the primary must stay attached with no ejection mechanism on it.
12. **Q12:** What is the 1.8 V regulator for?
13. **Q13:** Can I update the GCS and firmware to 866.50 / 865.25 MHz, SF9, sync 0x99?
14. **Q14:** Do the power parts (bucks, BMS, XT30s) go on one of the three middle boards, or near the battery?

Photos of each module's pin labels would let me move the remaining unverified items in file 02 to verified.

---
**USER** (2026-10-22T11:50:16)

<pasted_content id="735a">
Traceback (most recent call last):
  File "pyi_rth_pkgres.py", line 177, in <module>
  File "pyi_rth_pkgres.py", line 44, in _pyi_rthook
  File "pyimod02_importers.py", line 457, in exec_module
  File "pkg_resources\__init__.py", line 42, in <module>
  File "pyimod02_importers.py", line 457, in exec_module
  File "plistlib.py", line 70, in <module>
  File "pyimod02_importers.py", line 457, in exec_module
  File "xml\parsers\expat.py", line 4, in <module>
ImportError: DLL load failed while importing pyexpat: The operating system cannot run %1.
</pasted_content id="735a">

---
**CLAUDE** (2026-10-22T11:50:22)

The .exe crashes at startup because a DLL called `libexpat` failed to load. That usually means the build bundled the wrong one, so I'm checking which copy went into the .exe.

---
**CLAUDE** (2026-10-22T11:52:59)

My spec edits were refused because I hadn't opened the file with the Read tool yet, so that rebuild used the unchanged spec. Applying the edits properly now.

---
**CLAUDE** (2026-10-22T11:55:24)

Now it bundles Miniconda's own `libexpat.dll`. Next I'm launching the real .exe for 15 seconds to confirm it starts and stays up.

---
**CLAUDE** (2026-10-22T11:55:46)

The rebuilt .exe starts and shows the main window. Logging the fix in the memory changelog.

---
**CLAUDE** (2026-10-22T11:55:56)

The GCS .exe now starts. I rebuilt it and ran it for 15 seconds: it stayed open with the "VRITRA GCS · 2026-INSPACe-CAN-7USAT-025" window up.

**What was wrong:** your PATH includes an Oracle Database folder (`Downloads\WINDOWS.X64_213000_db_home\bin`) that has its own `libexpat.dll`. When building the .exe, PyInstaller picked up that copy instead of Miniconda's. It doesn't work with this Python, so the .exe crashed at startup with "DLL load failed while importing pyexpat". The bug wasn't in the GCS code itself.

**The fix, in [VRITRA_GCS.spec](../../../Users/kalbh/Downloads/vritra-gcs-master/vritra-gcs-master/gcs/VRITRA_GCS.spec):**
- The build now looks in the Python installation's own DLL folders first, so it always bundles the matching `libexpat.dll` (now from `miniconda3\Library\bin`).
- If a foreign `libexpat` ever gets picked up again, the build stops with a clear error instead of producing a broken .exe.

Your rebuilt file is at `gcs\dist\VRITRA_GCS.exe`. If you rebuild later, `build_exe.bat` uses the same spec, so the fix carries over. I've logged it in `04_DECISIONS_CHANGELOG.md`.

The zero-board layout image still needs your answers to the 14 questions from my previous message, especially Q1 on board orientation and Q2 on how many of each part you have.

---
**USER** (2026-10-22T12:20:58)

[image attached]
[image attached]
[image attached]
[image attached]
1. vertical” mean boards standing on edge along the can’s axis. rod is 8mm in diameter and this pcb will be attached in slots after i 3d print a mount for this pcb which will help it to stay there.
2. waveshare LR1121xf  (2 sender and receiver i am omiting the extra i will use t antenna with this module),  7semi L89HA(1) mounted on primary board, 7semi INA260 (i have 3, 1 is enough all are not required mainly i need battery status and line see the frr review file it will tell you what they expect), 7semi AP64500 (2),  7semi AP62301 (2), XIAO camera (1) , GNSS antennas (1)  and T-antennas (2), also whip antenna that came with lora (2). i also have 4 (KCD1-5-103W-Waterproof Round Rocker Switch-3Pin(ON-OFF-ON) i also have 5 xt60pw-f30gy. i also have red and green led.
3. i have  Core1121 LF/HF Dual-Band LoRa Module, Based on Low-Power LR1121 Transceiver, Suitable For Sub-GHz And 2.4GHz Frequency Bands (https://www.waveshare.com/core1121-xf.htm?sku=31899)
4. i have snl74hc125 module on my sdcard adapter i have also shared pic
5. i have shared the image of rtc clock
6. i dont have m9n antenna i have the gps navic antenna i have shared image of that too. 
7. see the frr document and guide line and gss i think as many as parameter i can show it is better 
8. the buck are of fixed value but for stering servo i have seprate 8v buck 5v buck is for teensyt and other component which required seprate 5v power. remainber two sterring servo gets power from seprate multi output buck
9. i have Hall sensor, switch with LED. omit bms,beacon.
10. i can buy third
11. mg90 dosent relase the drogue shoot or let go of drogue shoot it is attache to ram air parchute. the mg90s open the ram air parachute which will glide the cansat which will be driven by 2 servo which i shared earlier 7 v one. 
12. nothing 
13. yes
14. i think near the battery is good add one more board 

if you have more question please ask

---
**CLAUDE** (2026-10-22T12:22:49)

Thanks, that settles most of it. A few answers change the design. You have one Core1121 in the CanSat (the other is for the ground station), so the backup Teensy has no radio of its own. You have only one GNSS antenna, so the M9N can't work. The INA260 replaces the INA226. The power board becomes a fifth board. I'll update the plan, check the new parts and draw the layout.

---
**CLAUDE** (2026-10-22T12:30:05)

GCS done. Now the flight-computer config.

---
**CLAUDE** (2026-10-22T12:30:46)

Radio settings are updated everywhere. Before finalising the zero-board pins, I'm checking which pins the existing flight firmware already uses. Matching it means less code to change before FRR.

---
**CLAUDE** (2026-10-22T12:34:10)

Real module sizes are extracted. Now solving where three upright boards fit inside the Ø124 mm body alongside four Ø8 mm rods.

---
**CLAUDE** (2026-10-22T12:39:41)

The memory files are updated. The .exe rebuild with the new radio settings is still running; I'll check it when it finishes.

---
**CLAUDE** (2026-10-22T12:40:09)

The placement drawings are ready, and the GCS and firmware now use the new radio settings. The GCS .exe is still rebuilding with those settings, so the copy in `gcs\dist` is the old one until it finishes.

**FRR is in 4 days: 26 Oct, 10:34 AM, on Webex.** You'll show demo videos and results for the mission GUI, telemetry, and battery status and provisions, with the CanSat on camera. Launch is 31 Oct to 3 Nov. So build board A (primary) and board E (power) first.

## Placement sheets
They're in [layout](layout), drawn to scale on your real 120 × 150 mm boards. Grey dots are holes at 2.54 mm pitch, solid boxes are parts you own, and dashed boxes are reserved for parts you don't have yet.

| File | Content |
|---|---|
| `00_cross_section.png` | Top view of the can: how the 3 upright boards, 4 rods and the shell fit together |
| `01_board_A_primary.png` | Teensy 4.1 #1, Core1121, L89HA, BMP585, ICM-20948, DS3231, W25Q64, LEDs, connectors. Every Teensy pin is labelled with its wire |
| `02_board_B_backup.png` | Teensy 4.1 #2, BMP585 #2, LSM6DSO32, XIAO cable connector |
| `03_board_C_environment.png` | HDC3020, plus reserved space for the environmental sensors |
| `04_board_D_parafoil.png` | Teensy 4.0, ICM-20948 #2, SD module, 6 servo/ESC/Hall plugs |
| `05_board_E_power.png` | XT60 battery input, switch, 3× INA260, 2× AP64500, 2× AP62301, 8 V buck, XT30 to ESC |
| `06_harness_overview.png` | Every cable between boards |

**Why the boards aren't all full width:** inside a Ø124 mm body, a 120 mm board only fits exactly on the centre line, and two rods would pass through it. So:
- **A** (primary) keeps the central 100 mm (trim 10 mm per side).
- **B** (backup) is cut to 84 mm and slides between the rods at ±47 mm, which act as its side rails.
- **C** (environment) keeps the central 100 mm.
- **D** (parafoil) and **E** (power) are drawn with 100 mm kept too, as a placeholder until I know where they mount.

## What I changed because of your answers
- **Board A uses the pin map of your working flight firmware (`vritra_fc`), not the KiCad design.** That firmware already runs:
  - the LoRa radio on pins 24/25/26/27/29/30/39;
  - the L89 GNSS on pins 7/8, with reset on pin 6;
  - the battery voltage reading on pin 20;
  - pins 2/3/4/37 kept for the beacon amplifier.

  Wiring it this way means no firmware pin changes for FRR. Pins marked `*` on the sheet are new and will need code.
- **Radio settings:** GCS and all firmware builds now use **866.50 / 865.25 MHz, SF9, sync 0x99**. Nothing has been flashed or tested over the air yet.
- **Battery status for FRR:** three INA260 monitors measure the battery bus, the 8 V steering rail and the 5 V logic rail. Those feed fields the GCS already shows: bus voltage, current, state of charge, servo voltage and current, power, and energy. You'll need firmware to read the INA260s.
- **Only one Core1121 flies,** so backup board B can log but can't transmit.
- **The L89HA has its own built-in antennas** (Quectel datasheet), and its default 9600 baud matches your firmware. Your NavIC antenna is spare, so it could go to the M9N.
- **DS3231:** remove the charging resistor next to the diode, because it would try to charge your non-rechargeable CR2032.
- **SD module:** power it from 5 V, and keep it as the only device on board D's SPI bus.

## Still open (in `04_DECISIONS_CHANGELOG.md`)
- **Q15:** the new structure's inner diameter, rod circle and free height (the box below asks for these).
- **Q16:** check the print on your Core1121 says **HF**. The LF version can't transmit at 866.5 MHz.
- **Q17:** the 8 V buck model and size, the Hall sensor model, and the switch's current rating. The whole battery current flows through that switch.
- **Q18:** you said to leave out the beacon, but rule 5.2.v requires one of at least 92 dB, and FRR checks provisions.
- **Q19 to Q21:** where the NavIC antenna goes, whether to buy a third Core1121 so the backup can transmit, and a photo of the back of an INA260 so I can set its address pads.

There is no Teensy 4.0 parafoil firmware yet, and backup board B and the INA260s need new code. I can start on whichever matters most for FRR once you confirm the dimensions.

Sources: [Waveshare Core1121-XF product page](https://www.waveshare.com/core1121-xf.htm?sku=31899), [Waveshare Core1121-XF wiki](https://www.waveshare.com/wiki/Core1121-XF), [AGFRC A20CLM](https://www.agf-rc.com/agfrc-a20clm-10-2kg-compact-coreless-digital-servo-p6530997.html), [Hubtronics 7Semi INA260](https://hubtronics.in/sensors/ina260-voltage-current-power-monitor-sensor), [Adafruit INA260 pinouts](https://learn.adafruit.com/adafruit-ina260-current-voltage-power-sensor-breakout/pinouts), [TI INA260 EVM guide](https://ti.com/document-viewer/lit/html/SBOU180B/GUID-A6F48B15-120A-413D-9BEA-778901F31B67), [Hubtronics L89HA breakout](https://hubtronics.in/l89ha-breakout-multi-gnss), [Quectel forum: L89HA PSTM commands](https://forums.quectel.com/t/problem-with-pstm-commands-for-l89ha-gnss-module/48222), [Quectel forum: L89 and IRNSS](https://forums.quectel.com/t/use-of-l89-gnss-engine-for-irnss/4335?page=3), [Hubtronics L89HA-S90](https://hubtronics.in/quectel-l89ha-s90-dual-band-gnss-module), [Evelta 7Semi L89 USB dongle](https://evelta.com/7semi-l89-usb-gps-dongle-multi-gnss-engine-for-gps-irnss-glonass-beidou-galileo-and-qzss/), [DigiKey L89HA EVB](https://www.digikey.it/en/products/detail/quectel/L89HAEVB-KIT/16903732), and your `L89-datasheet.pdf`.

---
**USER** (2026-10-22T12:40:18)

<task-notification>
<task-id>b3szzdsd0</task-id>
<tool-use-id>toolu_01KD8c3qKh6pyciJHPPodcCA</tool-use-id>
<output-file>C:\Users\kalbh\AppData\Local\Temp\claude\D--linux-Software-Claude\7410ad31-36ff-475f-af06-3a5aa0db1baf\tasks\b3szzdsd0.output</output-file>
<status>completed</status>
<summary>Background command "Rebuild GCS exe with new radio constants" completed (exit code 0)</summary>
</task-notification>

---
**CLAUDE** (2026-10-22T12:40:42)

The rebuilt GCS .exe is ready at `gcs\dist\VRITRA_GCS.exe` (built 22 Oct, 18:10) and uses the new radio settings: 866.50 / 865.25 MHz, SF9, sync 0x99. I launched it and it ran for 15 seconds with the main window open.

The radios themselves are not on the new settings yet. You still need to flash `vritra_fc` to the CanSat Teensy and `vritra_gs` to the ground-station gateway.

Nothing else has changed. The layout is still waiting on the new structure's inner diameter, rod circle and free height (question Q15).

---
**USER** (2026-10-22T13:08:15)

the cansat is total 13 cm diameter outer and height is 40 cm inner diaameter is 12 cm rod outer dimension is 8 mm

---
**CLAUDE** (2026-10-22T13:09:12)

Thanks, those numbers matter. The inner diameter is **120 mm**, not the 124 mm I assumed, so the usable radius drops to 59 mm (allowing 1 mm wall clearance). That changes which parts fit near board edges. You didn't give the rod-circle diameter. I'll check whether the 94 mm circle from the CDR still fits; if you can choose, it's the one I'd recommend. I'll also add an automatic fit check that tests every part's height against the shell curve at its position, instead of the single 15 mm envelope.

---
**USER** (2026-10-22T13:10:10)

also can you show routes the zero pcb is 12 cm wide and height is 15cm of the pcb properly give me pin diagram and component placement and traces

---
**CLAUDE** (2026-10-22T13:22:57)

Now writing the full board-A definition on the 120 × 150 mm board.

---
**CLAUDE** (2026-10-22T13:24:11)

Board A now routes with **0 problems and 0 long jumpers**. Checking how many short hop wires it used, then looking at the images.

---
**CLAUDE** (2026-10-22T13:24:57)

That's 133 short hop wires, too many for a clean hand build; the hop cost I set was too cheap. Testing higher hop costs to find the best balance between hops and trace length.

---
**CLAUDE** (2026-10-22T13:32:05)

My patch script garbled two characters (an encoding issue in the shell heredoc). Fixing the file directly.

---
**CLAUDE** (2026-10-22T13:36:29)

Writing the definitions for boards B, C, D and E. Every Teensy pin on each board gets an independent cross-check against the pin map, just like board A.

---
**CLAUDE** (2026-10-22T13:38:56)

Every board passes placement now. Routing all five and rendering.

---
**CLAUDE** (2026-10-22T13:39:53)

All five boards route with **0 problems**: fully connected, no shared holes, no overlaps, Teensy pins matching the pin map. Hops: A 20, B 0, C 3, D 4, E 0. Spot-checking the D and E sheets.

---
**CLAUDE** (2026-10-22T13:41:11)

Now the whole-CanSat view: every cable, pin to pin, with an automatic check that both ends of each wire carry the same signal.

---
**CLAUDE** (2026-10-22T13:43:43)

All five boards are now placed and routed on the full 120 × 150 mm boards, down to which hole each module pin goes in and which holes every trace runs through. The automatic checks found 0 problems on every board, and all 13 cables check out pin to pin.

**What you get for each board** (in [routing](VRITRA_ZeroBoard_Memory/routing)):
- **`X_top.png` (component side):** each module's outline and the hole every pin goes in, labelled with the pin name and its signal. Thick right-angled lines are the insulated power wires (GND black, 3.3 V orange, 5 V red).
- **`X_bottom.png` (solder side):** what you see after turning the board over, so column 1 is on the right. Solid lines are traces: solder-bridge the holes shown, or lay tinned wire along them. Small arches are hops: a short insulated wire over another trace. Don't solder the hole in the middle of a hop.
- **`X_wiring.md`:** the same thing as a hole list per signal (for example `C21R33→C21R40`), so you can tick it off as you solder.
- **Holes are counted from the bottom-left corner of the component side** (C1 R1). There's a 3 mm clear margin on every edge for your slot mounts.

**Whole CanSat:** `SYSTEM_interconnect.png` shows all five boards, the 13 cables (W1–W13) and the 14 external connections. `CABLES.md` gives every cable pin by pin with wire gauge. Every cable is straight-through (pin 1 to pin 1), so it can't be built crossed.

| Board | Contents | Hops |
|---|---|---|
| A primary | Teensy 4.1, Core1121, L89HA, BMP585, ICM-20948, DS3231, W25Q64, LEDs, J7 GNSS backup cell | 20 |
| B backup | Teensy 4.1, BMP585, LSM6DSO32, XIAO camera connector | 0 |
| C environment | HDC3020 plus ready headers for the future sensors | 3 |
| D parafoil | Teensy 4.0, ICM-20948, BMP585 #3 (to buy), microSD, 2 steering + 2 MG90S servo plugs, ESC, Hall | 4 |
| E power | 3 INA260s, 5 buck modules, battery, switch, fuse, LED, ESC power, all power outputs | 0 |

**Mounting rules I followed, because they change how you solder:**
- **DS3231:** use its 4-pin end with a straight header so it lies flat. The 6-pin right-angle end would make it stand 38 mm tall. Remove the charging resistor, since it would try to charge the CR2032.
- **microSD module:** swap its right-angle header for a straight one so it lies flat, with the card slot at the board edge. Power it from 5 V.
- **GNSS backup:** the L89's BAT pin is fed from 3.3 V and from the coin cell on J7, each through a diode, so the cell can never be charged.
- **Servo and ESC signals:** each goes through a 330 Ω resistor. The Hall sensor output is pulled up to 3.3 V, never 5 V.
- **Battery, ESC and 8 V paths:** thick wire only, never traces. INA260 IN+/IN− take that wire directly.

**Pin changes from the last version** (all logged in file 03):
- **Flash chip-select:** pin 38 → pin 9.
- **UV sensor input:** pin 40 → pin 22.
- **BMP585 and ICM-20948 interrupts:** not wired, because the firmware only polls those sensors.

The firmware needs those updates, plus code for the INA260s and the links to boards B and D.

**Not verified yet:**
- The 7Semi buck modules' pin layout isn't confirmed. Board E gives each one IN/GND/OUT landing holes; run short wires from the module's own labelled pads, so no pin order is assumed.
- The INA260 address pads (0x40 / 0x41 / 0x45) need confirming with an I²C scan.

**Still to answer:**
- Are any of your diodes Schottky type (1N5819, BAT54, SS14)? The two on board A's GNSS backup need one.
- Do you have a coin-cell holder with leads for J7?
- Connector type for the cables: JST-XH (locking, better for the 30 g shock) or Dupont?
- Do you have female headers for all three Teensys?

---
**USER** (2026-10-22T13:55:44)

can you write table of each induviaul model and the pins i am to connect them if i have to add resistory in middle its pin shuld be propely expalined there only

---
**CLAUDE** (2026-10-22T13:56:05)

I'll generate these tables straight from the verified board definitions rather than writing them by hand, so they can't disagree with the routing sheets. Each module gets its own table: every pin, where it goes (Teensy pin or other module pin, with the exact hole), and any resistor, diode or capacitor in between, including which resistor leg goes where.

---
**CLAUDE** (2026-10-22T13:56:45)

The tables come out correctly, but the wording needs work: nested parts all say "on this pin", the GND source is listed twice, and the Teensy pins aren't in numeric order. Tidying that up.

---
**CLAUDE** (2026-10-22T13:57:47)

The tables are in [MODULE_PIN_TABLES.md](VRITRA_ZeroBoard_Memory/routing/MODULE_PIN_TABLES.md), one per module and connector on boards A to E. I generated them from the same board data the routing sheets use, so the two can't disagree.

Each table has four columns:
- **pin:** the module's own pin name.
- **hole:** where that pin goes on the board, as column/row (C21 R35 = column 21 from the left on the component side, row 35 from the bottom).
- **signal:** the signal name, the same one shown on the routing sheets.
- **connect to:** the destination module and pin, with its hole.

**Where a resistor, diode or capacitor sits in the path, both legs are explained in that same row.** For example, Teensy pin 31 on board A reads:

> through **R9 470 LED OK**: leg 1 in C19 R19 (joined to this signal), leg 2 in C19 R15 → through **D1 LED green**: leg A in C19 R12, leg K in C19 R11 → GND rail

So you know which hole each leg goes in and what the far leg connects to. Other examples are the 1 kΩ resistors on the links between boards, the 330 Ω resistors on every servo and ESC signal, the 100k/22k battery-voltage divider, and the two diodes on the GNSS backup cell.

Other things in the file:
- **Unused pins** are marked "not connected — leave open", with the reason where it matters. For example, Teensy pins 33–36 are still driven by the firmware, and the Teensy 3V3 pin must never join the 3.3 V rail.
- **Pins joined on the same module** say so explicitly, such as the ICM-20948's 1V8, CS and SDO.
- **Each board ends with a parts list:** every resistor, LED, diode and capacitor, with both legs' holes and signals and a note on which leg is which polarity.
- **GND, 3.3 V and 5 V** are listed as "rail" connections, insulated wires on the component side. The table names the connector where each rail comes onto the board.

If you change anything in the layout, re-run the generator with `python pin_tables.py` in the `routing` folder and the tables update with it.

---
**USER** (2026-10-23T08:05:10)

ok now tell me all connection properly in chat component wise dont use difficult name use easy name jst connector 2 to 5. properly tell me all pins

---
**CLAUDE** (2026-10-23T08:06:07)

You want every connection listed in plain words, one component at a time, using JST connectors of 2 to 5 pins. Two connectors on my boards have 6 pins (Main board → Sensor board, on both ends), and I sized the JST housings too small (a real 2.5 mm JST-XH housing is wider than its pins). I'll fix both on the boards and re-run all the checks. Then I'll generate the plain-language list from the verified data, so the chat text can't drift from the drawings.

---
**CLAUDE** (2026-10-23T08:07:53)

The shell choked on the long inline script, so I'll write it to a file instead.

---
**CLAUDE** (2026-10-23T08:08:38)

One collision left on the Main board: the I²C-to-Power plug now touches the RTC module, because the real JST housing is wider. Moving the RTC one hole to the right.

---
**CLAUDE** (2026-10-23T08:09:00)

Placement is clean on all five boards. Updating the cable list for the split connector, then re-routing everything.

---
**CLAUDE** (2026-10-23T08:10:11)

All checks pass with the real JST sizes: 5 boards routed with 0 problems, 14 cables with 0 pin mismatches. Generating the plain-language list from that verified data.

---
**CLAUDE** (2026-10-23T08:11:41)

Every connected pin now appears in the list. A second, independent check against the board data found 0 missing lines. Logging the change, then writing it out for you.

---
**CLAUDE** (2026-10-23T08:12:32)

Here is every connection, board by board and module by module. All plugs between boards are **JST-XH 2.5 mm**, in 2-, 3- and 4-pin sizes. Your old 6-pin Main→Sensor plug is now one JST-4 and one JST-3. The JST change has been re-checked: all five boards and all 14 cables pass with 0 problems.

**How to read it**
- **Board names:** Main board (Teensy 4.1 #1), Backup board (Teensy 4.1 #2), Sensor board, Parachute board (Teensy 4.0), Power board.
- **Three shared wires:** "GND wire", "3.3V wire" and "5V wire" are common wires on each board that every GND / 3.3 V / 5 V pin joins to.
- **Resistors in the path** are written in order. For example, "pin 5 → 1k resistor → plug" means one resistor leg goes on pin 5 and the other leg goes to the plug.
- **LED and diode legs:** the anode leg is the long leg (no stripe); the cathode leg is the short leg (stripe side).

---

## MAIN board

**Teensy 4.1 (main)**
- 5 → 1k resistor → JST-3 "to Backup" pin 1
- 6 → GPS RST
- 7 → GPS TX, also 1k resistor → JST-2 "GPS to Parachute" pin 1, also 1k resistor → JST-3 "to Backup" pin 2
- 8 → GPS RX
- 9 → Flash CS, also 10k resistor → 3.3V wire
- 14 → 1k resistor → JST-3 "UART to Parachute" pin 2
- 15 → JST-3 "UART to Parachute" pin 1
- 16 → JST-4 "I2C to Sensor" pin 2
- 17 → JST-4 "I2C to Sensor" pin 1
- 18 → RTC SDA + pressure sensor SDI + IMU SDA + JST-3 "I2C to Power" pin 2
- 19 → RTC SCL + pressure sensor SCK + IMU SCL + JST-3 "I2C to Power" pin 1
- 20 → 100k resistor → JST-2 "Battery sense" pin 1, also 22k resistor → GND wire
- 22 → JST-3 "Analog to Sensor" pin 2
- 23 → JST-3 "Analog to Sensor" pin 1
- 24 → LoRa BUSY
- 25 → LoRa RESET
- 26 → LoRa MOSI + Flash MOSI
- 27 → LoRa CLK + Flash SCK
- 29 → LoRa CS, also 10k resistor → 3.3V wire
- 30 → LoRa DIO9
- 31 → 470Ω resistor → green LED anode; green LED cathode → GND wire
- 32 → 470Ω resistor → red LED anode; red LED cathode → GND wire
- 39 → LoRa MISO + Flash MISO
- all 3 GND pins → GND wire
- VIN → 5V wire
- **Leave empty:** 0, 1, 2, 3, 4, 10, 11, 12, 13, 21, 28, 33–38, 40, 41, and the Teensy's own 3V3 pin (never join it to the 3.3V wire)

**LoRa radio (Core1121)**
- 3.3V → 3.3V wire
- all 3 GND pins → GND wire
- CS → Teensy 29
- CLK → Teensy 27
- MOSI → Teensy 26
- MISO → Teensy 39
- RESET → Teensy 25
- BUSY → Teensy 24
- DIO9 → Teensy 30
- **Leave empty:** 2.4G, DIO8, DIO7, NC, LORA_ANT pad. The T-antenna goes on the module's small u.FL socket.

**GPS (L89HA)**
- 3V3 → 3.3V wire
- GND → GND wire
- WAKE → 3.3V wire
- RST → Teensy 6
- TX → Teensy 7, and the 1k resistors to the Parachute and Backup plugs (see Teensy pin 7)
- RX → Teensy 8
- BAT → cathode of diode D3 (D3 anode → 3.3V wire), also cathode of diode D4 (D4 anode → JST-2 "GPS coin cell" pin 1)
- **Leave empty:** 3D_FIX, SDA, SCL, GEO, JAM

**RTC clock (DS3231)** — use its 4-pin end
- SCL → Teensy 19
- SDA → Teensy 18
- VCC → 3.3V wire
- GND → GND wire
- Remove the charging resistor next to the diode, because a CR2032 must not be charged.

**Pressure sensor (BMP585)**
- VIN → 3.3V wire
- GND → GND wire
- SCK → Teensy 19
- SDI → Teensy 18
- SDO → 3.3V wire (this sets I²C address 0x47)
- CS → 3.3V wire
- **Leave empty:** 3V3, INT

**IMU (ICM-20948)**
- VIN → 3.3V wire
- both GND pins → GND wire
- FSYNC → GND wire
- SCL → Teensy 19
- SDA → Teensy 18
- 1V8, CS and SDO → join these 3 pins to each other only (never to 3.3 V)
- **Leave empty:** ACL, ADA, INT

**Flash memory (W25Q64)**
- 3V3 → 3.3V wire
- GND → GND wire
- CS → Teensy 9
- MOSI → Teensy 26
- SCK → Teensy 27
- MISO → Teensy 39

**Main board plugs** (pin 1 first)
- JST-4 "Power in": +5V, GND, 3.3V, GND
- JST-3 "I2C to Power": SCL, SDA, GND
- JST-2 "Battery sense": VBAT, GND
- JST-3 "UART to Parachute": RX, TX, GND
- JST-2 "GPS to Parachute": GPS, GND
- JST-3 "to Backup": Heartbeat, GPS, GND
- JST-4 "I2C to Sensor": SDA, SCL, 3.3V, GND
- JST-3 "Analog to Sensor": Ozone, UV, GND
- JST-2 "GPS coin cell": Cell+, GND

**Other parts:** a 470µF capacitor and a 100nF capacitor go from the 5V wire to the GND wire, near VIN (470µF + leg on 5V). A 100nF capacitor goes from the 3.3V wire to the GND wire next to the radio, the pressure sensor and the IMU.

---

## BACKUP board

**Teensy 4.1 (backup)**
- 0 → JST-3 "from Main" pin 2
- 4 → JST-3 "from Main" pin 1
- 14 → 1k resistor → JST-3 "to Parachute" pin 2
- 15 → JST-3 "to Parachute" pin 1
- 18 → pressure sensor SDI + IMU SDA
- 19 → pressure sensor SCK + IMU SCL
- 34 → 1k resistor → JST-4 "Camera" pin 4
- 35 → 1k resistor → JST-4 "Camera" pin 3
- 36 → 470Ω resistor → green LED anode; cathode → GND wire
- 37 → 470Ω resistor → red LED anode; cathode → GND wire
- all 3 GND pins → GND wire
- VIN → 5V wire
- **Leave empty:** all other pins, and the Teensy's own 3V3 pin

**Pressure sensor (BMP585 #2)**
- VIN → 3.3V wire
- GND → GND wire
- SCK → Teensy 19
- SDI → Teensy 18
- SDO → 3.3V wire
- CS → 3.3V wire
- **Leave empty:** 3V3, INT

**IMU (LSM6DSO32)**
- VIN → 3.3V wire
- GND → GND wire
- SCL → Teensy 19
- SDA → Teensy 18
- DO → GND wire (this sets I²C address 0x6A)
- CS → 3.3V wire
- **Leave empty:** 3Vo, INT1, INT2

**Backup board plugs**
- JST-4 "Power in": +5V, GND, 3.3V, GND
- JST-3 "from Main": Heartbeat, GPS, GND
- JST-3 "to Parachute": RX, TX, GND
- JST-4 "Camera": +5V, GND, to XIAO D7, from XIAO D6

**Other parts:** 470µF + 100nF capacitors on the 5V wire; 100nF next to each sensor.

---

## SENSOR board (no Teensy)
- JST-4 "I2C from Main": SDA, SCL, 3.3V, GND
- JST-3 "Analog from Main": Ozone, UV, GND
- JST-2 "5V in": +5V (ozone heater only), GND
- HDC3020 cable, soldered: + → 3.3V wire, − → GND wire, D → SDA, C → SCL
- Two spare JST-4 sensor plugs: 3.3V, GND, SDA, SCL
- JST-3 UV sensor plug: 3.3V, GND, UV signal → "Analog from Main" pin 2
- JST-3 ozone sensor plug: +5V, GND, AO
  - AO → 10k resistor → "Analog from Main" pin 1
  - From that same pin 1, a 20k resistor (two 10k in series) goes to GND. This keeps the signal below 3.3 V.
- 4.7k resistors from SDA to 3.3V and from SCL to 3.3V: fit them only if the I²C scan fails.

---

## PARACHUTE board

**Teensy 4.0 (parachute)**
- 0 → JST-2 "GPS from Main" pin 1
- 2 → 330Ω resistor → LEFT steering servo signal
- 3 → 330Ω resistor → RIGHT steering servo signal
- 4 → 330Ω resistor → MG90S #1 (parachute-bay) signal
- 5 → 330Ω resistor → MG90S #2 (petri lid) signal
- 6 → 330Ω resistor → ESC signal
- 7 → JST-3 "UART from Main" pin 2
- 8 → 1k resistor → JST-3 "UART from Main" pin 1, also a second 1k resistor → JST-3 "to Backup" pin 1
- 9 → Hall sensor OUT, also 10k resistor → 3.3V wire
- 10 → SD CS
- 11 → SD MOSI
- 12 → SD MISO
- 13 → SD SCK
- 15 → JST-3 "to Backup" pin 2
- 18 → pressure sensor SDI + IMU SDA
- 19 → pressure sensor SCK + IMU SCL
- both GND pins → GND wire
- VIN → 5V wire
- **Leave empty:** 1, 14, 16, 17, 20–23, and the Teensy's own 3V3 pin

**Pressure sensor (BMP585 #3, to buy)**
- Same wiring as the others: VIN → 3.3V, GND → GND, SCK → Teensy 19, SDI → Teensy 18, SDO → 3.3V, CS → 3.3V

**IMU (ICM-20948 #2)**
- Same wiring as the Main board IMU: VIN → 3.3V, GND → GND, FSYNC → GND, SCL → Teensy 19, SDA → Teensy 18, 1V8 + CS + SDO joined together

**SD card module**
- CS → Teensy 10
- SCK → Teensy 13
- MOSI → Teensy 11
- MISO → Teensy 12
- VCC → 5V wire (it must be 5 V)
- GND → GND wire

**Servo and sensor plugs** (3-pin header: − , + , S)
- LEFT and RIGHT steering servos: − → GND, + → 8V-servo wire, S → 330Ω → Teensy 2 / 3
- MG90S #1 and #2: − → GND, + → 5V-servo wire, S → 330Ω → Teensy 4 / 5
- ESC signal: − → GND, + → leave empty (never use the ESC's red wire), S → 330Ω → Teensy 6
- Hall sensor: − → GND, + → 5V wire, OUT → Teensy 9

**Parachute board plugs**
- JST-4 "Power in": +5V, GND, 3.3V, GND
- JST-3 "UART from Main": TX, RX, GND
- JST-2 "GPS from Main": GPS, GND
- JST-3 "to Backup": TX, RX, GND
- Thick-wire pads: 8V + GND, and 5V-servo + GND
- 470µF capacitors: one on the 8V-servo wire to GND, one on the 5V-servo wire to GND

---

## POWER board
- **Battery and switch path:**
  - Battery + → switch pad 1. Switch pad 2 → fuse → INA260 #1 IN+. INA260 #1 IN− → battery+ wire.
  - Red power LED: switch pad 2 → 1k resistor → LED anode; LED cathode → GND.
  - Battery − → GND wire.
- **INA260 #1 (battery):** VCC → 3.3V wire, GND → GND, SCL / SDA → JST-3 "I2C to Main", VBUS → battery+ wire
- **INA260 #2 (8 V servo line):** VCC → 3.3V, GND → GND, SCL / SDA to the same I²C, IN+ → 8V buck OUT, IN− and VBUS → 8V thick-wire pad
- **INA260 #3 (5 V line):** VCC → 3.3V, GND → GND, SCL / SDA to the same I²C, IN+ → 5V buck #1 OUT, IN− and VBUS → 5V wire
- **5V buck #1:** IN → battery+ wire, GND → GND, OUT → INA260 #3 IN+
- **5V buck #2 (servos):** IN → battery+ wire, GND → GND, OUT → 5V-servo thick-wire pad
- **8V buck:** IN → battery+ wire, GND → GND, OUT → INA260 #2 IN+
- **3.3V buck #1:** IN → 5V wire, GND → GND, OUT → 3.3V wire for the Main board, Sensor board and the INA260s
- **3.3V buck #2:** IN → 5V wire, GND → GND, OUT → pin 3 of "Power to Backup" and "Power to Parachute"
- **ESC:** thick-wire pads battery+ and GND
- **Plugs:**
  - JST-4 "Power to Main", "Power to Backup" and "Power to Parachute": +5V, GND, 3.3V, GND
  - JST-3 "I2C to Main": SCL, SDA, GND
  - JST-2 "Battery sense to Main": VBAT, GND
  - JST-2 "5V to Sensor": +5V, GND

---

## CABLES (every cable is straight: pin 1 to pin 1, pin 2 to pin 2)

| Cable | From | To | Pins |
|---|---|---|---|
| W1 | Power "Power to Main" | Main "Power in" | +5V, GND, 3.3V, GND |
| W2 | Power "Power to Backup" | Backup "Power in" | +5V, GND, 3.3V, GND |
| W3 | Power "Power to Parachute" | Parachute "Power in" | +5V, GND, 3.3V, GND |
| W4 | Power 8V pads | Parachute 8V pads | +8V, GND (18 AWG, thick) |
| W5 | Power 5V-servo pads | Parachute 5V-servo pads | +5V, GND (20 AWG) |
| W6 | Power "I2C to Main" | Main "I2C to Power" | SCL, SDA, GND |
| W7 | Power "Battery sense" | Main "Battery sense" | VBAT, GND |
| W8 | Power "5V to Sensor" | Sensor "5V in" | +5V, GND |
| W9 | Main "to Backup" | Backup "from Main" | Heartbeat, GPS, GND |
| W10 | Main "UART to Parachute" | Parachute "UART from Main" | RX, TX, GND |
| W11 | Main "GPS to Parachute" | Parachute "GPS from Main" | GPS, GND |
| W12 | Backup "to Parachute" | Parachute "to Backup" | RX, TX, GND |
| W13 | Main "I2C to Sensor" | Sensor "I2C from Main" | SDA, SCL, 3.3V, GND |
| W14 | Main "Analog to Sensor" | Sensor "Analog from Main" | Ozone, UV, GND |

**Files in `VRITRA_ZeroBoard_Memory\routing`:**
- `EASY_CONNECTIONS.md` — this same list, generated from the checked board data.
- `MODULE_PIN_TABLES.md` — adds the exact hole for every pin.
- The routing drawings (`A_top.png` to `E_bottom.png`) are regenerated with the new JST plugs.

---
**USER** (2026-10-23T08:17:08)

now ssee all the pin except three buck pcb i want all three sensor board. images and their traces in placement. now remeber i want you to remeber all this traces i want all lines properly run but in pcb way so i want to see all compeont there properly place on three plates and their traces in a way that i am supposed to route but in zero pcb way not like professional pcb. read all our last message gentate image accoridng to table you gave upside

---
**CLAUDE** (2026-10-23T08:17:25)

You want one clear picture for each of the three middle plates (Main, Backup, Sensor), skipping the Power board. Each picture should show the parts in place and every line running along the holes perfboard-style, matching the tables. Right now the parts and the traces are on two separate sheets, and the trace sheet is mirrored. I'll make one combined view per board: parts, every pin, every signal line along the holes, every power wire, with a colour legend in plain words. All of it is drawn from the same verified data as the tables.

---
**CLAUDE** (2026-10-23T08:19:36)

Here are the three middle plates, each as one picture with every part placed and every line routed on your 120 × 150 mm zero board. The Power board is left out, as you asked. I drew them from the same data as the tables I gave you earlier, and all three passed the checks with 0 errors.

**How to read each picture**
- It is drawn as you look at the **component side**, with holes numbered by column (1–47, left to right) and row (1–59, bottom to top).
- **Each part** is a shaded outline. Every pin is a coloured dot with its pin name next to it.
- **A thin line along the holes** is a solder trail or bare tinned wire on the bottom of the board. It's drawn as if you could see through the board, so left and right match the parts on top and you don't have to mirror anything.
- **A small arch** is a short insulated wire jumping over another line. Don't put solder in the hole under the arch.
- **A thick pale line** is an insulated power wire on the top side: GND black, 3.3 V orange, 5 V red.
- **The legend** on the right gives each colour in plain words, such as "GPS TX → Teensy 7", "LoRa CS (29)" or "heartbeat → Backup plug".

**What's on each plate**
- **MAIN:**
  - Left side: the LoRa radio, flash memory, GPS and the GPS coin-cell plug.
  - Right side: the RTC, pressure sensor and IMU.
  - Middle: the Teensy, upright, with USB at the top and the SD card at the bottom (keep both clear).
  - JST plugs on the edges.
  - It needs 21 short hop wires; everything else is a straight solder line.
- **BACKUP:** Teensy, pressure sensor, IMU, camera plug and LEDs, with no hop wires. The dashed area is kept free for a second LoRa radio if you buy one.
- **SENSOR:** the HDC3020 plus ready plugs for future sensors, with no hop wires. I moved the dashed "future sensor" areas into the empty lower half so they no longer sit on top of the plugs.

The board data, router and picture script are saved in `VRITRA_ZeroBoard_Memory\routing`, and the memory notes now point to these three pictures as your build reference. The PARACHUTE board (Teensy 4.0, servos, SD card) has its own placement and trace sheets in the same folder (`D_top.png` and `D_bottom.png`).

---
**USER** (2026-10-23T09:23:49)

[image attached]
Adafruit LSM6DSO32 6-DoF Accelerometer and Gyroscope have 13 legs see image i share

---
**CLAUDE** (2026-10-23T09:24:34)

Thanks for the photo. Counting the holes in it, this board actually has **14 holes, not 13**:
- **Front row (9):** VIN, 3Vo, GND, SCL, SDA, DO, CS, I1, I2
- **Back row (5):** SCX, SDX, CS, DO, GND

Your KiCad footprint also has all 14, so the hole spacing is right. But my Backup-board plan only placed the 9 front holes, so a trace could in theory run through a back-row hole. If you then solder a header there, that would short. I'll add the back row so those 5 holes are kept free, then re-route and re-check.

---
**CLAUDE** (2026-10-23T09:24:53)

The same shell encoding problem as before garbled that line. Fixing it directly in the file.

---
**CLAUDE** (2026-10-23T09:25:02)

Now all 14 holes are placed: front row C31–C39 R44, back row C33–C37 R49. Re-routing the Backup board and regenerating every output that depends on it.

---
**CLAUDE** (2026-10-23T09:25:32)

The Backup board now shows all of the LSM6DSO32's holes. In your photo there are **14 holes, not 13**. Count the back row again: it has 5 holes (SCX, SDX, CS, DO, GND), not 4.

My earlier plan only placed the 9 front holes, so a trace could have run through a back-row hole. I added the back row and re-routed the board. The result: 0 problems, no trace uses any back-row hole, and the cables still match. The updated picture is `B_COMBINED.png`.

**How to fit it on the Backup board**
- **Front row, 9 pins**, at C31 to C39, row 44. Solder a pin header here.

| Pin | Connect to |
|---|---|
| VIN | 3.3V wire |
| 3Vo | leave empty |
| GND | GND wire |
| SCL | Teensy pin 19 (and BMP585 SCK) |
| SDA | Teensy pin 18 (and BMP585 SDI) |
| DO | GND wire (sets I²C address 0x6A) |
| CS | 3.3V wire (selects I²C mode) |
| I1 | leave empty |
| I2 | leave empty |

- **Back row, 5 pins**, at C33 to C37, row 49: SCX, SDX, CS, DO, GND. Don't connect anything to these. The board keeps those holes empty, so if you leave the back row unsoldered, nothing is lost. SCX and SDX are the chip's extra sensor interface, which we don't use.

The 5 back-row hole positions come from your KiCad footprint (12.7 mm behind the front row, starting above the third front pin). Before soldering, set the module on the board and check that the back row lines up with C33 to C37. If it doesn't, tell me and I'll move it.

The pin tables and the plain-word list are updated too.

---
**USER** (2026-10-23T09:42:50)

my camera will not transmitt video signal it has its own esp32 i want just to tell teensy even that will be of primary teensy to start recording and then continue recording no matter what and also i have 7 semi 4 channel mux that you missed and primary teensy will be on no matter what when it fail mux will switch or boot the backup teensy from deep sleep. and the parachute teensy will also get gnss data and priamry board data it should have to make precision landing even tho it has its own sensor in addition to that i mean. also gnss data will be shared between primary teensy and backup and also parachute teensy

---
**CLAUDE** (2026-10-23T09:43:56)

Three of your points are already in the design, and two need changes:
- **Already in:** GPS shared by all three Teensys, the Parachute Teensy getting GPS plus the Main board's data, and the camera recording on its own SD card (no video over radio).
- **Changes:** the camera should be commanded by the **Main** Teensy (right now it hangs off the Backup board), and I missed your **7Semi 4-channel mux**.

Your old KiCad design (rev E) used that mux to switch the camera's UART between Teensys. I'll read its exact pinout from your KiCad files before wiring anything.

---
**CLAUDE** (2026-10-23T09:48:00)

Both boards route with 0 problems and the cables check out. The Backup board's trace length jumped a lot, so I'm looking at both pictures before calling it done.

---
**CLAUDE** (2026-10-23T09:48:57)

I've added the camera control, the 7Semi mux and the Adafruit amp, and re-routed the MAIN and BACKUP boards. Both pass all the checks (0 errors) and all 14 cables still match. The images are updated.

**Camera (record only, commanded by MAIN)**
- MAIN Teensy pin 1 (TX) goes through a 1k resistor to the cable to BACKUP. MAIN pin 0 (RX) comes back on the same cable. This MAIN↔BACKUP cable is now a **JST-5**: Heartbeat, GPS, CAM TX, CAM RX, GND.
- On the BACKUP board, the cable goes to **mux channel 1**. The BACKUP Teensy's own camera port (pin 35 TX, pin 34 RX, each through 1k) goes to **mux channel 2**. The mux's common TX/RX goes through two 1k resistors to the camera plug, then to XIAO D7 (RX) and D6 (TX).
- **Mux control pins:** A = BACKUP pin 5, B = pin 6, C = pin 9. **Each has a 10k resistor to GND**, so the camera stays on MAIN unless the BACKUP Teensy is awake and switches it.
- **Mux power:** its 3V3 pin goes to the 3.3V wire. Set the DIP switches OFF and the VCC jumper to 3V3.
- **Mux bottom row** (5V, 3V3, GND, RX_COM, TX_COM): it sits half a hole off the grid, so solder header pins pointing up and run 5 short wires to the marked holes just below it.
- **XIAO firmware:** start recording on the "REC" command, never stop once started, and keep Wi-Fi and Bluetooth off.

**Beacon amp (Adafruit MAX98357A, on MAIN)** — it uses the pins your flight firmware already drives:

| Amp pin | Connect to |
|---|---|
| LRC | Teensy pin 3 |
| BCLK | Teensy pin 4 |
| DIN | Teensy pin 2 |
| SD | Teensy pin 37 |
| GAIN | 100k resistor to GND (loudest setting, 15 dB) |
| Vin | 5V wire, with a 100µF capacitor |
| GND | GND wire |

The speaker goes on the amp's own screw terminal. Neither speaker terminal is ground.

**Two things I need to be honest about**
1. **The mux cannot switch on its own.** A dead MAIN can't flip it, so the BACKUP Teensy has to notice the missing heartbeat and switch it. Also, the mux can only hand over the camera (two wires). It **cannot hand over the LoRa radio**, which needs 7 SPI and control wires. For real radio failover the BACKUP needs its own second Core1121.
2. **Deep sleep for the BACKUP is risky.** Waking from deep sleep needs a signal change on the heartbeat pin, but a hung MAIN can freeze that line without changing it, so the BACKUP would never wake. Staying awake costs about 0.3 Ah over 3 hours, out of your 5 Ah battery, and the BACKUP can keep logging the whole time. The wiring is the same either way; only the firmware differs.

**Already in the design, no change needed**
- **GPS shared:** the L89 TX goes to MAIN pin 7, and through 1k resistors to BACKUP pin 0 and PARACHUTE pin 0.
- **PARACHUTE data:** it gets that GPS stream plus MAIN's data over the UART cable, on top of its own pressure sensor and IMU, for the precision landing.

**To check**
- MAIN now needs **38 short hop wires**, up from 21. The amp could only go in the free lower-right corner, so its three wires to Teensy pins 2–4 cross under the Teensy. It's buildable; each hop is one short insulated wire.
- **The mux chip:** please read the marking on its main chip. I assumed a 74HC4052-type, which passes signals both ways and selects channel 1 when A, B and C are all low. If it's a different chip, the direction or default channel may change.

The firmware changes this needs are listed in `04_DECISIONS_CHANGELOG.md`. The main one: pins 0 and 1 on MAIN are now the camera port, so the GPS auto-detect must stop using Serial1. I haven't changed the firmware yet.

Sources: [ST M74HC4052](https://st.com/en/switches-and-multiplexers/m74hc4052.html), [ST M74HC4052 (JP)](https://www.st.com/ja/switches-and-multiplexers/m74hc4052.html), [M74HC4052 datasheet](https://www.alldatasheet.com/datasheet-pdf/pdf/23097/STMICROELECTRONICS/M74HC4052.html), [74VHC4052 (Cirkit)](https://docs.cirkitdesigner.com/component/23dba6a0-054b-4bf0-9d6f-1b174d324dc4/74vhc4052), [4052 pinout wiki](https://wiki.adom.inc/p/pg_7sradsj9wv), [74HC4052 datasheet (Integral)](https://integral.by/sites/default/files/pdf/74hc4052e.pdf), [SparkFun 9907](https://sparkfun.com/products/9907), [SparkFun 19539](https://www.sparkfun.com/products/19539), [SparkFun UART Mux Click](https://www.sparkfun.com/mikroe-uart-mux-click.html), [Tayda CD74HC4052](https://www.taydaelectronics.com/cd74hc4052-74hc4052-744052-ic-4-channel-multiplexer.html)

---
**USER** (2026-10-23T09:49:13)

also my  esc and my gyro wheel motor one thing my cyclone 45a blhell_s 2-6s lipo esc can rotate the motor clock wise or anti clock wise no matter how it is connection now its positive and negative is directly connected to my battery but its has 2 pin coming outside of it also place that

---
**CLAUDE** (2026-10-23T09:49:28)

Your Cyclone 45A BLHeli_S ESC: its two thick wires take battery power, and its two small wires are the **signal** and **ground**. Those go on the Parachute board, since the Parachute Teensy (pin 6) controls the wheel. I'll swap the 3-pin ESC header for a proper 2-pin one and re-route that board.

---
**CLAUDE** (2026-10-23T09:50:31)

I've placed your Cyclone 45A ESC on the **PARACHUTE board**. The board re-routed with 0 errors and the cables still match. The updated picture is `D_COMBINED.png`.

**The ESC's 2 small wires** go to a new 2-pin plug on the left edge of the PARACHUTE board, row 33:

| Plug pin | Hole | Connect to |
|---|---|---|
| 1 (−) | C3 R33 | ESC ground wire (usually black or brown) → GND wire |
| 2 (S) | C4 R33 | ESC signal wire (usually white or yellow) → 330Ω resistor → Teensy 4.0 pin 6 |

**The ESC's 2 thick wires (+ and −):** right now they go straight to the battery. Please move them to the **ESC pads on the POWER board**. There they come after the ON/OFF switch, the fuse and INA260 #1. If you leave them on the battery:
- the external switch can't turn the motor off, which is a competition rule;
- the battery status shown at FRR won't include the motor's current.

**Motor direction:** with BLHeli_S, direction is a **setting**, not wiring. You change it in BLHeliSuite or ESC-Configurator through the signal wire:
- **Normal or Reversed** suits a gyro wheel that always spins one way. The Teensy sends 1000 µs (stopped) to 2000 µs (full) at 50 Hz, and must send 1000 µs for about 2 s at power-up to arm the ESC.
- **Bidirectional (3D)** if you want to change direction in flight. Then 1500 µs = stopped, below 1500 spins one way, above 1500 the other.

**One risk to check:** when the 70 g wheel spins up, the motor can briefly draw more than 10 A. That could blow the 10 A fuse, exceed the INA260's 15 A rating or overload the rocker switch. Have the Teensy ramp the throttle up slowly over 3–5 seconds, and measure the current on the bench before flight.

The spin rate for telemetry field 14 still comes from the Hall sensor on PARACHUTE pin 9; this ESC can't report RPM over a plain PWM signal.

---
**USER** (2026-10-23T09:59:46)

[image attached]
[image attached]
as i said that mux is also in case the primary teensy shut down during launchor have any error also for speaker and camera also you missed microsdcard module it has cs,sck,mosi,miso,vcc,gnd it should store everthing that is happening in system with time stamp in excel format on system itself also see that mux properly as shown in image i have done my connection of board 1 check all

---
**CLAUDE** (2026-10-23T10:00:37)

You sent back my own MAIN and BACKUP drawings. You want the mux to cover the **speaker** as well as the camera, you want the **microSD module** to log everything, and you want me to check Board 1 fully. Before answering, I'll run an independent check that doesn't reuse the router:
- every Teensy pin on MAIN against the pin numbers in your flight firmware (`Config.h`)
- every module's supply voltage
- no 5 V or 8 V net touching a Teensy pin
- no two outputs fighting on one line
- unique I²C addresses on each bus

---
**CLAUDE** (2026-10-23T10:01:03)

Those 3 are false alarms: on the POWER board, part "U1" is the INA260, not a Teensy. Fixing the audit to look only at real Teensys.

---
**CLAUDE** (2026-10-23T10:01:44)

I re-checked all five boards with a separate audit that doesn't reuse the routing tool. It found **0 problems**:
- every module gets the right supply voltage
- no Teensy pin touches 5 V, 8 V or the battery
- no line has two outputs fighting each other
- all I²C addresses are unique on each bus
- every MAIN Teensy pin for the LoRa radio, GPS, I²C sensors and beacon amp matches the pin numbers in your flight firmware (`Config.h`)

**The mux, as drawn on the BACKUP board, is correct**

| Mux pin | Connects to |
|---|---|
| TX1 / RX1 (channel 1) | MAIN Teensy, over the MAIN↔BACKUP cable (camera TX / RX) |
| TX2 | BACKUP Teensy pin 35, through 1k |
| RX2 | BACKUP Teensy pin 34, through 1k |
| A / B / C | BACKUP pins 5 / 6 / 9, each with a 10k resistor to GND |
| common TX | 1k resistor → XIAO D7 (RX) |
| common RX | 1k resistor → XIAO D6 (TX) |
| 3V3 | 3.3 V wire |
| GND | GND wire |
| 5V and the VCC_L / VCC_R pins | leave empty |

Because of the pull-downs, the camera stays on MAIN until the BACKUP Teensy deliberately switches it.

**The speaker can't go on the same mux**

Your 7Semi mux switches only **2 wires** (one common TX/RX pair), and the camera already uses them. The amp needs **3 signal wires** (DIN, LRC, BCLK) plus its on/off pin. You have two options; the question box asks which:
- **Buy one 74HC157** (DIP-16, a cheap 4-way switch chip). I'd move the amp and this chip to the BACKUP board. MAIN's sound signals would go there over one JST-5 cable: DIN, LRC, BCLK, SD, GND.
- **Use two more 7Semi muxes**, which give 4 switchable wires.

If the MAIN Teensy only crashes, its firmware watchdog normally reboots it in about a second. The switch-over only matters if MAIN dies completely.

**The microSD module is already in the design**

It's on the **PARACHUTE board** (U7, bottom middle of the picture I just sent):

| SD pin | Connect to |
|---|---|
| CS | Teensy 4.0 pin 10 |
| MOSI | Teensy 4.0 pin 11 |
| MISO | Teensy 4.0 pin 12 |
| SCK | Teensy 4.0 pin 13 |
| VCC | 5 V |
| GND | GND |

That board receives everything: the GPS data, all of MAIN's data and the BACKUP link, plus its own sensors. So it's the right place for the black-box log. It can write a **CSV file**, which opens directly in Excel, with one row per reading and a timestamp from GPS time plus mission seconds. Both Teensy 4.1s also log to their own built-in SD slots. That logging firmware isn't written yet.

**Checking your soldered Board 1**

The two pictures you sent are my drawings, not your board. To check your actual soldering, send clear photos of **both sides** of Board 1, straight from above in good light. I'll compare them hole by hole against the plan.

---
**USER** (2026-10-23T10:03:39)

but i have only one camera and your board 1 and 2 both have connectors for cmaera in total system has 3 camera connecotr

---
**CLAUDE** (2026-10-23T10:03:49)

You have one camera and the system has **only one camera plug**. My labels made it look like three, sorry.

| Plug | What it really is |
|---|---|
| BACKUP **J4** | The **only camera plug**. The XIAO's cable goes here (5V, GND, D7, D6). |
| MAIN **J5** and BACKUP **J2** | The **two ends of one cable** between MAIN and BACKUP (cable W9). Two of its 5 wires carry MAIN's camera commands to the mux, so I labelled those pins "CAM_TX / CAM_RX". |

So the camera signal path is MAIN → cable → mux → J4 → camera. I'll rename those two cable pins so they can't be mistaken for camera plugs, and re-draw.

---
**CLAUDE** (2026-10-23T10:04:59)

There is only **one camera plug** in the whole system. My labels made it look like three, so I've renamed them; the wiring itself hasn't changed.

**The camera plug** is BACKUP board J4, a JST-4. Your XIAO's cable goes here and nowhere else:

| J4 pin | Connect to |
|---|---|
| 1 | +5V |
| 2 | GND |
| 3 | XIAO D7 (RX) |
| 4 | XIAO D6 (TX) |

**MAIN J5 and BACKUP J2 are the two ends of one cable**, the "LINK cable". Nothing plugs into them except that cable. It carries 5 wires between the MAIN and BACKUP Teensys:

| Pin | Name | What it carries |
|---|---|---|
| 1 | HB | MAIN's "I'm alive" heartbeat |
| 2 | GNSS | Copy of the GPS data |
| 3 | MUX_TX | MAIN's camera commands, going to mux channel 1 |
| 4 | MUX_RX | The camera's reply, coming back to MAIN |
| 5 | GND | Ground |

**Camera path:** MAIN Teensy pins 1/0 → LINK cable → mux channel 1 → camera plug J4 → camera. If the MAIN Teensy dies, the BACKUP Teensy switches the mux to channel 2 and takes over the same camera through the same J4 plug.

All checks still pass after the rename: 0 routing problems, 14 cables matching, and 0 audit findings. The updated pictures are attached, and the pin tables and plain-word list now use the new names.

---
**USER** (2026-10-23T22:35:18)

<pasted_content id="33fd">
MAIN board

Teensy 4.1 (main)

5 → 1k resistor → JST-3 “to Backup” pin 1
6 → GPS RST
7 → GPS TX, also 1k resistor → JST-2 “GPS to Parachute” pin 1, also 1k resistor → JST-3 “to Backup” pin 2
8 → GPS RX
9 → Flash CS, also 10k resistor → 3.3V wire
14 → 1k resistor → JST-3 “UART to Parachute” pin 2
15 → JST-3 “UART to Parachute” pin 1
16 → JST-4 “I2C to Sensor” pin 2
17 → JST-4 “I2C to Sensor” pin 1
18 → RTC SDA + pressure sensor SDI + IMU SDA + JST-3 “I2C to Power” pin 2
19 → RTC SCL + pressure sensor SCK + IMU SCL + JST-3 “I2C to Power” pin 1
20 → 100k resistor → JST-2 “Battery sense” pin 1, also 22k resistor → GND wire
22 → JST-3 “Analog to Sensor” pin 2
23 → JST-3 “Analog to Sensor” pin 1
24 → LoRa BUSY
25 → LoRa RESET
26 → LoRa MOSI + Flash MOSI
27 → LoRa CLK + Flash SCK
29 → LoRa CS, also 10k resistor → 3.3V wire
30 → LoRa DIO9
31 → 470Ω resistor → green LED anode; green LED cathode → GND wire
32 → 470Ω resistor → red LED anode; red LED cathode → GND wire
39 → LoRa MISO + Flash MISO
all 3 GND pins → GND wire
VIN → 5V wire
Leave empty: 0, 1, 2, 3, 4, 10, 11, 12, 13, 21, 28, 33–38, 40, 41, and the Teensy’s own 3V3 pin (never join it to the 3.3V wire)

LoRa radio (Core1121)

3.3V → 3.3V wire
all 3 GND pins → GND wire
CS → Teensy 29
CLK → Teensy 27
MOSI → Teensy 26
MISO → Teensy 39
RESET → Teensy 25
BUSY → Teensy 24
DIO9 → Teensy 30
Leave empty: 2.4G, DIO8, DIO7, NC, LORA_ANT pad. The T-antenna goes on the module’s small u.FL socket.

GPS (L89HA)

3V3 → 3.3V wire
GND → GND wire
WAKE → 3.3V wire
RST → Teensy 6
TX → Teensy 7, and the 1k resistors to the Parachute and Backup plugs (see Teensy pin 7)
RX → Teensy 8
BAT → cathode of diode D3 (D3 anode → 3.3V wire), also cathode of diode D4 (D4 anode → JST-2 “GPS coin cell” pin 1)
Leave empty: 3D_FIX, SDA, SCL, GEO, JAM

RTC clock (DS3231) — use its 4-pin end

SCL → Teensy 19
SDA → Teensy 18
VCC → 3.3V wire
GND → GND wire
Remove the charging resistor next to the diode, because a CR2032 must not be charged.

Pressure sensor (BMP585)

VIN → 3.3V wire
GND → GND wire
SCK → Teensy 19
SDI → Teensy 18
SDO → 3.3V wire (this sets I²C address 0x47)
CS → 3.3V wire
Leave empty: 3V3, INT

IMU (ICM-20948)

VIN → 3.3V wire
both GND pins → GND wire
FSYNC → GND wire
SCL → Teensy 19
SDA → Teensy 18
1V8, CS and SDO → join these 3 pins to each other only (never to 3.3 V)
Leave empty: ACL, ADA, INT

Flash memory (W25Q64)

3V3 → 3.3V wire
GND → GND wire
CS → Teensy 9
MOSI → Teensy 26
SCK → Teensy 27
MISO → Teensy 39

Main board plugs (pin 1 first)

JST-4 “Power in”: +5V, GND, 3.3V, GND
JST-3 “I2C to Power”: SCL, SDA, GND
JST-2 “Battery sense”: VBAT, GND
JST-3 “UART to Parachute”: RX, TX, GND
JST-2 “GPS to Parachute”: GPS, GND
JST-3 “to Backup”: Heartbeat, GPS, GND
JST-4 “I2C to Sensor”: SDA, SCL, 3.3V, GND
JST-3 “Analog to Sensor”: Ozone, UV, GND
JST-2 “GPS coin cell”: Cell+, GND

Other parts: a 470µF capacitor and a 100nF capacitor go from the 5V wire to the GND wire, near VIN (470µF + leg on 5V). A 100nF capacitor goes from the 3.3V wire to the GND wire next to the radio, the pressure sensor and the IMU.

BACKUP board

Teensy 4.1 (backup)

0 → JST-3 “from Main” pin 2
4 → JST-3 “from Main” pin 1
14 → 1k resistor → JST-3 “to Parachute” pin 2
15 → JST-3 “to Parachute” pin 1
18 → pressure sensor SDI + IMU SDA
19 → pressure sensor SCK + IMU SCL
34 → 1k resistor → JST-4 “Camera” pin 4
35 → 1k resistor → JST-4 “Camera” pin 3
36 → 470Ω resistor → green LED anode; cathode → GND wire
37 → 470Ω resistor → red LED anode; cathode → GND wire
all 3 GND pins → GND wire
VIN → 5V wire
Leave empty: all other pins, and the Teensy’s own 3V3 pin

Pressure sensor (BMP585 #2)

VIN → 3.3V wire
GND → GND wire
SCK → Teensy 19
SDI → Teensy 18
SDO → 3.3V wire
CS → 3.3V wire
Leave empty: 3V3, INT

IMU (LSM6DSO32)

VIN → 3.3V wire
GND → GND wire
SCL → Teensy 19
SDA → Teensy 18
DO → GND wire (this sets I²C address 0x6A)
CS → 3.3V wire
Leave empty: 3Vo, INT1, INT2

Backup board plugs

JST-4 “Power in”: +5V, GND, 3.3V, GND
JST-3 “from Main”: Heartbeat, GPS, GND
JST-3 “to Parachute”: RX, TX, GND
JST-4 “Camera”: +5V, GND, to XIAO D7, from XIAO D6

Other parts: 470µF + 100nF capacitors on the 5V wire; 100nF next to each sensor.

SENSOR board (no Teensy)
JST-4 “I2C from Main”: SDA, SCL, 3.3V, GND
JST-3 “Analog from Main”: Ozone, UV, GND
JST-2 “5V in”: +5V (ozone heater only), GND
HDC3020 cable, soldered: + → 3.3V wire, − → GND wire, D → SDA, C → SCL
Two spare JST-4 sensor plugs: 3.3V, GND, SDA, SCL
JST-3 UV sensor plug: 3.3V, GND, UV signal → “Analog from Main” pin 2
JST-3 ozone sensor plug: +5V, GND, AO
AO → 10k resistor → “Analog from Main” pin 1
From that same pin 1, a 20k resistor (two 10k in series) goes to GND. This keeps the signal below 3.3 V.
4.7k resistors from SDA to 3.3V and from SCL to 3.3V: fit them only if the I²C scan fails.
PARACHUTE board

Teensy 4.0 (parachute)

0 → JST-2 “GPS from Main” pin 1
2 → 330Ω resistor → LEFT steering servo signal
3 → 330Ω resistor → RIGHT steering servo signal
4 → 330Ω resistor → MG90S #1 (parachute-bay) signal
5 → 330Ω resistor → MG90S #2 (petri lid) signal
6 → 330Ω resistor → ESC signal
7 → JST-3 “UART from Main” pin 2
8 → 1k resistor → JST-3 “UART from Main” pin 1, also a second 1k resistor → JST-3 “to Backup” pin 1
9 → Hall sensor OUT, also 10k resistor → 3.3V wire
10 → SD CS
11 → SD MOSI
12 → SD MISO
13 → SD SCK
15 → JST-3 “to Backup” pin 2
18 → pressure sensor SDI + IMU SDA
19 → pressure sensor SCK + IMU SCL
both GND pins → GND wire
VIN → 5V wire
Leave empty: 1, 14, 16, 17, 20–23, and the Teensy’s own 3V3 pin

Pressure sensor (BMP585 #3, to buy)

Same wiring as the others: VIN → 3.3V, GND → GND, SCK → Teensy 19, SDI → Teensy 18, SDO → 3.3V, CS → 3.3V

IMU (ICM-20948 #2)

Same wiring as the Main board IMU: VIN → 3.3V, GND → GND, FSYNC → GND, SCL → Teensy 19, SDA → Teensy 18, 1V8 + CS + SDO joined together

SD card module

CS → Teensy 10
SCK → Teensy 13
MOSI → Teensy 11
MISO → Teensy 12
VCC → 5V wire (it must be 5 V)
GND → GND wire

Servo and sensor plugs (3-pin header: − , + , S)

LEFT and RIGHT steering servos: − → GND, + → 8V-servo wire, S → 330Ω → Teensy 2 / 3
MG90S #1 and #2: − → GND, + → 5V-servo wire, S → 330Ω → Teensy 4 / 5
ESC signal: − → GND, + → leave empty (never use the ESC’s red wire), S → 330Ω → Teensy 6
Hall sensor: − → GND, + → 5V wire, OUT → Teensy 9

Parachute board plugs

JST-4 “Power in”: +5V, GND, 3.3V, GND
JST-3 “UART from Main”: TX, RX, GND
JST-2 “GPS from Main”: GPS, GND
JST-3 “to Backup”: TX, RX, GND
Thick-wire pads: 8V + GND, and 5V-servo + GND
470µF capacitors: one on the 8V-servo wire to GND, one on the 5V-servo wire to GND
POWER board
Battery and switch path:
Battery + → switch pad 1. Switch pad 2 → fuse → INA260 #1 IN+. INA260 #1 IN− → battery+ wire.
Red power LED: switch pad 2 → 1k resistor → LED anode; LED cathode → GND.
Battery − → GND wire.
INA260 #1 (battery): VCC → 3.3V wire, GND → GND, SCL / SDA → JST-3 “I2C to Main”, VBUS → battery+ wire
INA260 #2 (8 V servo line): VCC → 3.3V, GND → GND, SCL / SDA to the same I²C, IN+ → 8V buck OUT, IN− and VBUS → 8V thick-wire pad
INA260 #3 (5 V line): VCC → 3.3V, GND → GND, SCL / SDA to the same I²C, IN+ → 5V buck #1 OUT, IN− and VBUS → 5V wire
5V buck #1: IN → battery+ wire, GND → GND, OUT → INA260 #3 IN+
5V buck #2 (servos): IN → battery+ wire, GND → GND, OUT → 5V-servo thick-wire pad
8V buck: IN → battery+ wire, GND → GND, OUT → INA260 #2 IN+
3.3V buck #1: IN → 5V wire, GND → GND, OUT → 3.3V wire for the Main board, Sensor board and the INA260s
3.3V buck #2: IN → 5V wire, GND → GND, OUT → pin 3 of “Power to Backup” and “Power to Parachute”
ESC: thick-wire pads battery+ and GND
Plugs:
JST-4 “Power to Main”, “Power to Backup” and “Power to Parachute”: +5V, GND, 3.3V, GND
JST-3 “I2C to Main”: SCL, SDA, GND
JST-2 “Battery sense to Main”: VBAT, GND
JST-2 “5V to Sensor”: +5V, GND
CABLES (every cable is straight: pin 1 to pin 1, pin 2 to pin 2)
Cable	From	To	Pins
W1	Power “Power to Main”	Main “Power in”	+5V, GND, 3.3V, GND
W2	Power “Power to Backup”	Backup “Power in”	+5V, GND, 3.3V, GND
W3	Power “Power to Parachute”	Parachute “Power in”	+5V, GND, 3.3V, GND
W4	Power 8V pads	Parachute 8V pads	+8V, GND (18 AWG, thick)
W5	Power 5V-servo pads	Parachute 5V-servo pads	+5V, GND (20 AWG)
W6	Power “I2C to Main”	Main “I2C to Power”	SCL, SDA, GND
W7	Power “Battery sense”	Main “Battery sense”	VBAT, GND
W8	Power “5V to Sensor”	Sensor “5V in”	+5V, GND
W9	Main “to Backup”	Backup “from Main”	Heartbeat, GPS, GND
W10	Main “UART to Parachute”	Parachute “UART from Main”	RX, TX, GND
W11	Main “GPS to Parachute”	Parachute “GPS from Main”	GPS, GND
W12	Backup “to Parachute”	Parachute “to Backup”	RX, TX, GND
W13	Main “I2C to Sensor”	Sensor “I2C from Main”	SDA, SCL, 3.3V, GND
W14	Main “Analog to Sensor”	Sensor “Analog from Main”	Ozone, UV, GND
</pasted_content id="33fd">

i want you to crate a proper image with all proper line with all traces or in kicad make a project on rectrangular box like my zero pcb i want  you it make a perfect traces and all lines. i want all proper because in images you missed some traces which is problem

---
**CLAUDE** (2026-10-23T22:39:12)

Before building anything, two things:

1. **The list you pasted is out of date.** It's from before the camera mux, the amp and the ESC changes. For example, it still has a JST-3 "to Backup" plug instead of the JST-5 LINK cable, and no amp or mux. The current list is `routing\EASY_CONNECTIONS.md`. I'll build from the current design.
2. **Why the pictures looked like they missed lines.** Every connection exists in the data, and the checker proves it. But I drew the GND / 3.3 V / 5 V wires as pale, see-through lines that overlap and hide under modules, so some pins looked unconnected. That's my drawing's fault.

The fix is what you asked for: a **real KiCad project** for each board, a 120 × 150 mm rectangle on the 2.54 mm hole grid, where **every** connection, power included, is an actual track. Bottom tracks are solder trails; top tracks are insulated wires along the holes. Then **KiCad's own DRC** must report 0 errors and 0 unconnected, which independently proves nothing is missing. The images will be exported from KiCad itself.

---
**CLAUDE** (2026-10-23T22:44:08)

KiCad's own DRC on the SENSOR board: **0 violations of any severity, 0 unconnected**. Building the other four and running KiCad DRC on each.

---
**CLAUDE** (2026-10-23T22:48:27)

**All 5 KiCad boards: 0 DRC violations at every severity, 0 unconnected.** Now exporting the pictures straight from KiCad, so the image is exactly the KiCad design.

---
**CLAUDE** (2026-10-23T22:51:22)

Final independent check: I'll reload each saved KiCad file and confirm every pad's net matches the design data exactly, then archive the old pictures.

---
**CLAUDE** (2026-10-23T22:51:34)

All checks pass. Recording this as the authoritative build reference, then sending the pictures.

---
**CLAUDE** (2026-10-23T22:52:13)

All 5 zero boards are now real KiCad projects. Each is a 120 × 150 mm rectangle with the 2.54 mm hole grid, and every connection, power included, is drawn as an actual track. **KiCad's own DRC reports 0 errors and 0 unconnected items on every board**, so no line is missing.

**Where the files are:** `VRITRA_ZeroBoard_Memory\kicad\`, one folder per board (`ZB_A_MAIN`, `ZB_B_BACKUP`, `ZB_C_SENSOR`, `ZB_D_PARACHUTE`, `ZB_E_POWER`). Each folder has:
- `.kicad_pro` / `.kicad_pcb`: open in KiCad 10 to zoom, click a pad to see its pin name and net, or view in 3D.
- `_KiCad.png`: the picture I just sent, exported by KiCad itself.
- `_BUILD_LIST.md`: every connection as a hole list, so you can tick them off while soldering.

**How to read the pictures**
- **Blue line:** a solder trail or bare tinned wire on the **bottom** side, along the holes shown.
- **Red line:** an **insulated wire on the top** side, lying along the holes. Only its two ends are soldered.
- **Small ring where red meets blue:** the wire goes **through an empty hole** from one side to the other.
- **Square pad:** pin 1. Every pad shows its pin name (VIN, SDA, CS and so on).
- **Hole numbering:** column 1 is on the left and row 1 at the bottom, as seen from the component side.

**Why the old pictures looked like they missed lines:** they drew GND, 3.3 V and 5 V as pale see-through wires that overlapped and hid under the modules. Now every power connection is a solid red or blue line like everything else. I moved the old pictures into `routing\old_superseded_single_layer\` so you don't build from them by mistake.

**One real change:** on the PARACHUTE board, the five servo plugs were stacked in touching rows. That boxed each middle "+" pin in with no free hole beside it, so it couldn't be wired at all. They now have one empty row between each: rows 38, 36, 34, 32 and 30, with the Hall plug at row 28.

**Checks that passed**
- KiCad DRC at every severity: 0 / 0 on all 5 boards.
- Reloading each saved KiCad file: every pad's net matches the design exactly.
- The independent electrical audit and all 14 cable checks still pass.

**The list you pasted is out of date.** It's from before the camera mux, the beacon amp and the ESC were added. For example, it still shows a JST-3 "to Backup" plug instead of the JST-5 LINK cable, and it has no amp or mux. Please use the KiCad files or the current `routing\EASY_CONNECTIONS.md`.

**Count of top wires going through holes:** MAIN 32, BACKUP 6, SENSOR 5, PARACHUTE 7, POWER 15.

---
**USER** (2026-10-23T22:53:34)

can you make it single layer like we are doing in zer board wiyh 90 degree turn

---
**CLAUDE** (2026-10-23T22:53:58)

You want everything on **one layer**: all lines on the solder side, with only straight runs and 90° turns, like normal zero-board work.

On a single layer, two lines can't cross. A real single-sided board solves that the standard way: a short **wire link** (jumper) on the component side that hops over the other line. So my plan:
- all copper on the bottom only, 90° turns only
- a straight wire link wherever two lines must cross
- each link is a proper part in KiCad, so DRC can still prove everything is connected

First I'm checking whether KiCad 10 lets a two-pad link count as one connection.

---
**CLAUDE** (2026-10-23T22:54:05)

KiCad 10 supports wire-link parts: two pads with the same number, flagged as a jumper, count as one connection. Now writing the single-layer router.

---
**CLAUDE** (2026-10-23T23:10:10)

All five still route with the stricter rules: MAIN 55 links, BACKUP 13, SENSOR 6, PARACHUTE 12, POWER 15. Exporting all to KiCad and running DRC.

---
**CLAUDE** (2026-10-23T23:49:00)

API Error: Can't reach the API server — check your internet or DNS (ENOTFOUND)

---
**USER** (2026-10-24T04:29:54)

Try again

---
**CLAUDE** (2026-10-24T04:30:24)

Saved files confirmed: every pad's net matches the design, **0 copper on the top layer** (truly single-layer), and the link counts are as reported. Exporting the pictures from KiCad.

---
**CLAUDE** (2026-10-24T04:31:11)

All five boards are now **single layer**, the way you build a zero board. All copper is on the bottom, with only straight runs and 90° turns. **KiCad's own DRC reports 0 errors and 0 unconnected on every board.** I also reloaded each saved file: every pad's net matches the design, and there is no copper at all on the top layer.

**How to read the pictures**
- **Blue line:** a solder trail on the bottom. Solder every hole along it, or lay bare tinned wire along those holes.
- **Grey line (LK1, LK2…):** a **straight insulated wire link** on the component side. It's only needed where two trails would cross. Solder its two ends; it jumps over the trails underneath.
- **Square pad:** pin 1. Every pad shows its pin name.

**Wire links per board:** MAIN 59, BACKUP 10, SENSOR 4, PARACHUTE 10, POWER 18. MAIN has the most because the Teensy, radio, GPS, flash, amp and five I²C parts all crowd onto one board. I tuned the router to keep that number as low as possible.

**Rules every wire link follows** (both the router and an independent checker enforce them):
- Both ends sit in an **empty hole**, clear of every part, so no end lands under a JST plug, a module or a resistor.
- A link never passes over a component pin or a part that sits flat on the board. The only exception is under a Teensy, which sits up on female headers.
- At most one link end per hole, and no link joins straight onto another link.

**Files, one folder per board in `VRITRA_ZeroBoard_Memory\kicad_single\`:**
- `.kicad_pro` / `.kicad_pcb`: open in KiCad 10 to zoom in, click any pad, or view in 3D.
- `_1L_KiCad.png`: the picture I just sent, exported by KiCad.
- `_1L_BUILD_LIST.md`: every connection as hole runs, such as "TRAIL: C21R33→C21R40" and "LINK LK5: C9R44 ↔ C17R44", so you can tick them off while soldering.

The earlier two-layer version is still in `VRITRA_ZeroBoard_Memory\kicad\` if you ever want it, but **build from the single-layer `kicad_single` files**.

---
**USER** (2026-10-24T06:23:42)

Ok now listen we have much space board 1 is ok but see this i think we should merge board 2 and 3 and 4 will be of power and 5 will be of parachute control i am not putting the senior i don't have see which which sensor i have told in entire chat and put it there with mux and memory card module and create there single layer pcb

---
**CLAUDE** (2026-10-24T06:24:53)

Here's the new plan:

| Board | What it holds |
|---|---|
| **Board 1 MAIN** | Unchanged |
| **Board 2 BACKUP + SENSOR** (merged) | Backup Teensy 4.1, only the sensors you actually own, the 7Semi mux + camera plug, and the **microSD card module** |
| **Board 4 POWER** | Unchanged, except the "5V to Sensor" plug is no longer needed |
| **Board 5 PARACHUTE** | Same as before, minus the microSD module, which moves to Board 2 |

From everything you've told me, the sensors you own are BMP585 ×2, LSM6DSO32 ×1, ICM-20948 ×2 and HDC3020 ×1. The environmental sensors (SCD41, SEN0290, BMV080, AS7343, ML8511, MQ-131) are not owned, so they all go. That makes Board 2 the backup BMP585 #2 + LSM6DSO32 + **HDC3020**. MAIN keeps its BMP585 #1 + ICM-20948 #1, and PARACHUTE keeps ICM-20948 #2 plus the third BMP585 you're buying. Reading the board definitions to edit.

---
**CLAUDE** (2026-10-24T06:25:05)

Applying the merge to the board definitions (backed up first).

---
**CLAUDE** (2026-10-24T06:25:34)

The old microSD line on the Parachute board ran over two lines and my patch only removed the first. Removing the leftover line.

---
**CLAUDE** (2026-10-24T06:25:45)

The HDC3020 wire landing touches the LSM6DSO32 outline by about 1 mm. Moving it one hole to the right.

---
**CLAUDE** (2026-10-24T06:25:52)

All four boards pass placement and the Teensy pin checks. Now updating the helper scripts (cable list, audit, plain list, pin tables, KiCad export) for the four-board layout.

---
**USER** (2026-10-24T06:27:58)

[summary of earlier part of the chat]
This session is being continued from a previous conversation that ran out of context. The summary below covers the earlier portion of the conversation.

<tools-used-before-summary>Bash, Edit, PowerShell, Read, SendUserFile, TaskStop, ToolSearch, WebFetch, WebSearch, Write, mcp__ccd_turn__update_plan, mcp__ccd_turn__wrap_up</tools-used-before-summary>
Summary:
1. Primary Request and Intent:
   - Overall project: Team VRITRA (IN-SPACe CAN-7USAT 2026, Team ID 2026-INSPACe-CAN-7USAT-025) CanSat. The user wants a fully verified, hallucination-free hardware design built on 12 cm × 15 cm double-sided zero (perfboard) boards, with exact pin connections, placement, and traces ("treat this zero board like real board"), plus GCS software with COM autodetect, and a 4-file memory folder to keep context.
   - Earlier explicit requests (completed): verify KiCad schematics/PCB pins (bootstrap/hardware pin errors); read CDR (incl. images), guidelines, frequency assignment; create memory folder (4 files); install GCS and add COM-port autodetect; arrange components on boards with images; per-module pin tables with resistor legs explained; plain-language component-wise connection list using JST connectors of 2–5 pins; combined placement+trace images; KiCad projects with perfect traces (after "images missed some traces"); then SINGLE-LAYER zero-board style with 90° turns.
   - Hardware facts from user: boards stand on edge in can; can OD 130 mm, ID 120 mm, height 400 mm, rods Ø8 mm; boards are full 120 W × 150 H rectangles mounted in 3D-printed slots; only ONE camera (XIAO ESP32-S3 Sense, record-only, MAIN Teensy commands start and it keeps recording); 7Semi 4-channel UART mux (for failover of camera, and user also wants speaker failover); Adafruit MAX98357A amp + speaker; Cyclone 45A BLHeli_S 2–6S ESC (2 thin wires signal+GND; thick wires to battery); GNSS shared to MAIN, BACKUP, PARACHUTE Teensys; parachute Teensy gets GNSS + MAIN data for precision landing; microSD card module (CS, SCK, MOSI, MISO, VCC, GND) should log everything with timestamps in Excel (CSV) format.
   - MOST RECENT REQUEST (in progress): "Ok now listen we have much space board 1 is ok but see this i think we should merge board 2 and 3 and 4 will be of power and 5 will be of parachute control i am not putting the senior i don't have see which which sensor i have told in entire chat and put it there with mux and memory card module and create there single layer pcb"

2. Key Technical Concepts:
   - Teensy 4.1/4.0 pin capabilities (Serial1–8, SPI/SPI1 26/27/39, Wire/Wire1/Wire2, SAI1/SAI2 I²S, PWM, 3.3 V-only I/O, never wire On/Off/Program, Teensy 3V3 pin not to be joined to 3V3 rails).
   - Firmware vritra_fc pin map (MAIN follows it): LoRa CS29 BUSY24 RST25 IRQ30 SPI1 MOSI26 SCK27 MISO39; L89 Serial2 RX7/TX8, RST6; I²C 18/19 @100 kHz; VBAT divider 100k/22k on A6=pin20; beacon SAI2 DIN2 LRCLK3 BCLK4 SD37; pins 33–36 driven by firmware (old TB6612) → keep free.
   - Radio assignment 19-10-2026: 866.50 MHz main / 865.25 backup, SF9, BW125, CR4/5, sync 0x99; TCXO 1.6 V; RF switch DIO5/6.
   - Hole grid: 2.54 mm pitch, 47 columns × 59 rows; hole C1 R1 = bottom-left from component side; X0=(120−46·2.54)/2, Y0=(150−58·2.54)/2; 3 mm edge margin.
   - Routers: single-layer negotiated-congestion (PathFinder) with wire links (zb_router1), 2-layer (zb_router2), earlier single-layer with hops (zb_engine.route).
   - KiCad 10.0.6 pcbnew Python (C:\Program Files\KiCad\10.0\bin\python.exe), kicad-cli DRC (json, --severity-all) and SVG export, PyMuPDF SVG→PNG; jumper pads via fp.SetDuplicatePadNumbersAreJumpers(True).
   - I²C addresses: BMP585 0x47 (SDO→3V3), ICM-20948 0x69 (CS+SDO tied to module 1V8), DS3231 0x68 + AT24C32 0x57, INA260 0x40/0x41/0x45, LSM6DSO32 0x6A (DO→GND, CS→3V3), HDC3020 0x44.
   - microSD (74xx125 buffered) module: VCC 5 V, MISO never tri-states → must be alone on its SPI bus.
   - 7Semi mux BO-10145 assumed 74HC4052-like (bidirectional); A,B,C (C=INH) pulled down 10k → channel 1 (MAIN) default; bottom row (5V,3V3,GND,RX_COM,TX_COM) off-grid → 5 wires to U10B landing holes; DIP OFF, VCC jumper 3V3.

3. Files and Code Sections:
   - D:\linux\Software\Claude\VRITRA_ZeroBoard_Memory\01_PROJECT_CONTEXT.md, 02_HARDWARE_INVENTORY.md, 03_PIN_MAP_AND_WIRING.md (v0.3 header notes boards.py authoritative), 04_DECISIONS_CHANGELOG.md (all decisions/changes logged incl. single-layer build reference entry, open questions Q15–Q25, firmware TODO).
   - C:\Users\kalbh\.claude\projects\D--linux-Software-Claude\memory\project-cansat-zeroboard.md + MEMORY.md index line (auto-memory; latest: single-layer build reference = kicad_single).
   - GCS: C:\Users\kalbh\Downloads\vritra-gcs-master\vritra-gcs-master\gcs\vritra_gcs.py (added §11b COM-port auto-detect: AUTODETECT_LISTEN_S, GATEWAY_MARKERS, classify_serial_line, probe_port, autodetect_candidates, PortAutoDetect; toolbar Auto-detect button; _autodetect_port/_autodetect_poll; auto-scan when LIVE with no port; radio constants 866.50/865.25 SF9 0x99, LORA_SENS_DBM −129.5); VRITRA_GCS.spec (PATH fix for libexpat + guard); backup vritra_gcs.py.orig_before_autodetect; dist\VRITRA_GCS.exe rebuilt.
   - Firmware radio constants updated: firmware\vritra_fc\Config.h, vritra_gs\vritra_gs.ino, esp32rec\esp32rec.ino, vritra_tx\vritra_tx.ino, cdr_tests\test_rf_rx/test_rf_tx (backups *.orig_before_freq19-10). Not flashed.
   - routing\zb_engine.py: Board/Part/Net dataclasses, load_fp/place_fp (from VRITRA_footprints.pretty), place_row (jst=True gives JST-XH body 2.45 along/2.9 across, 2..5 pins), place_2pin (R, C, CP, LED_G, LED_R, D), place_box, fit_check, usable (EDGE=3.0), old route/verify/render.
   - routing\boards.py (SOURCE OF TRUTH): board_a (MAIN), board_b (now "Board 2 BACKUP + SENSOR"), board_c (SENSOR, now removed from BOARDS), board_d (PARACHUTE), board_e (POWER); EXPECT_A/B/D, FORBIDDEN_*; dicts T41_NAMES, T40_NAMES, CORE, L89, BMP, ICM, W25, LSM (14 pins incl. back row SCX, SDX, CS(back), DO(back), GND(back)), MUX, AMP, INA. Backups: boards.py.bak_before_jst, .bak_before_cam_amp, .bak_before_servo_gap, .bak_before_merge.
     - Latest merge edits (applied, checks pass for A,B,D,E):
       ```
       sd = place_row(b, "U11", 7, 41, ["CS","SCK","MOSI","MISO","VCC","GND"], "microSD card module", height=8.0, color=C_SENS, note="straight header, module FLAT\ncard slot → top edge · VCC = 5 V")
       sd.body = (hx(7)+6.35-12.0, hy(41)-2.0, hx(7)+6.35+12.0, hy(41)+42.0)
       place_box(b, "M1", 96.0, 128.0, 118.0, 144.0, "HDC3020 (7Semi)", C_SENS, height=6.0, note="2× M2 screws · JST-PH cable\n+ - D C → 3V3 GND SDA SCL · 0x44")
       place_row(b, "M1L", 41, 50, ["3V3","GND","SDA","SCL"], "HDC3020 cable wires", height=3.0, color=C_SENS)
       Net("SD_CS",[T("10"),("U11","1")]), Net("SD_SCK",[T("13"),("U11","2")]), Net("SD_MOSI",[T("11"),("U11","3")]), Net("SD_MISO",[T("12"),("U11","4")])
       GND += ("U11","6"),("M1L","2"); +5V_LOGIC += ("U11","5"); +3V3_B += ("M1L","1"); SDA += ("M1L","3"); SCL += ("M1L","4")
       EXPECT_B = {"10":"SD_CS","11":"SD_MOSI","12":"SD_MISO","13":"SD_SCK","0":"GNSS_IN",...}
       ```
       Removed dashed U9 2nd-Core1121 box from B; removed U7 SD and its nets from D and EXPECT_D (10–13); removed E J11 and its GND/+5V refs; removed "C" from BOARDS.
     - Other current B content: Teensy U1 (21,40,rot270), BMP585 U5 (31,36), LSM6DSO32 U8 (31,44), J1 PWR (21,52), J2 LINK JST-5 (3,41 down: HB,GNSS,MUX_TX,MUX_RX,GND), J3 to D (45,31), J4 CAMERA plug (45,22: +5V,GND,to D7,from D6), mux U10 (29,15) pins 1–20 + U10B (30,3), R1 1k TX3, R2/R3 1k Serial8 (35 TX/34 RX) to mux ch2, R9/R10 1k cam, R6–R8 10k pull-downs MUX_A(5)/B(6)/C(9), LEDs on 36/37.
     - MAIN (A): unchanged per user; includes amp U9 MAX98357A (32,10) pins LRC3 BCLK4 DIN2 SD37 GAIN→R12 100k→GND, C6 100µF; camera UART Serial1 pin1 TX→R11 1k→J5.3, J5.4→pin0; J6 (I2C to sensor, now spare) and J9 (analog, now spare); J7 GNSS coin cell + D3/D4 Schottky to L89 BAT.
     - PARACHUTE (D): servo headers rows 38/36/34/32/30 (J14 ESC 2-pin ["−","S"] at col 3), Hall J15 row 28, R6 row 26.
   - routing\zb_router1.py: single-layer router; link_blocks(b) (no_end: pins + holes within body ±1.2 mm; no_span: pins + bodies of non-Teensy parts); route1 (STEP 1.0, TURN 0.6, LINK_COST 80.0, LINK_PER_HOLE 0.6, JMAX 10, ITERATIONS 70; no U-turn; no link after link; link_ends per net), split1 → {"trails","links"}, verify1 (connectivity, holes ownership, link rules, no doubled trails, one link end per hole).
   - routing\zb_router2.py (2-layer), routing\kicad_export.py (2-layer KiCad; helpers P, H, mm, rect, text, width, _runs, NAMES={"A":"MAIN","B":"BACKUP","C":"SENSOR","D":"PARACHUTE","E":"POWER"}, write_build_list), routing\kicad_export1.py (single-layer KiCad: link_footprint with jumper pads, OUT=../kicad_single, folder ZB_<X>_<NAME>_1L, BUILD_LIST.md; default loop list("ABCDE")).
   - routing\system_view.py (CABLES W1–W14, EXTERNAL X1–X15, check straight-through, CABLES.md, SYSTEM_interconnect.png), audit.py (SUPPLY, DRIVERS, I2C, FW_PINS vs Config.h; loops "ABCDE"), easy_list.py (EASY_CONNECTIONS.md; BOARD/PART/PLUG maps; loops "ABCDE"), pin_tables.py (MODULE_PIN_TABLES.md; loop "ABCDE"), combined_view.py (old images), old images archived in routing\old_superseded_single_layer\.
   - Outputs: kicad\ZB_<X>_<NAME>\ (2-layer, DRC 0/0), kicad_single\ZB_<X>_<NAME>_1L\ (single-layer, DRC 0/0, links A59 B10 C4 D10 E18) — these predate the merge and must be regenerated.

4. Errors and fixes:
   - GCS exe pyexpat DLL load failure → Oracle DB libexpat on PATH; spec prepends Python DLL dirs and aborts build if libexpat from outside.
   - Offscreen GUI test segfault from QMessageBox in constructor (pre-existing) → test fakes comports/patches warning; added combo addItem if port not listed.
   - Bash heredoc encoding garbled “·”/“→” in boards.py (twice) → fixed with Edit tool; write patch scripts to scratchpad files instead of heredocs.
   - easy_list dedupe bug dropped GND lines across modules → per-module dedupe + independent missing-line check (0 missing).
   - audit false positive (E U1 is INA260) → restrict Teensy check to boards A,B,D.
   - D stacked servo headers boxed in “+” pins (router raised) → one empty row between headers.
   - Single-layer link issues found by KiCad DRC (pth_inside_courtyard, holes_co_located, track_dangling from U-turn loophole) → link_blocks margin, no chained links, one link end per hole, no U-turns, verifier checks; LINK_COST tuned to 80 (45 produced verify problems; exporter refuses unverified boards).
   - Merge patch left a dangling continuation line in board_d → replaced with comment.
   - M1L overlapped LSM6DSO32 body → moved to col 41.
   - User feedback: images missed traces (pale power wires) → KiCad projects with all nets as tracks; user wanted single layer with 90° turns → single-layer router; pasted outdated list → told user current list is EASY_CONNECTIONS.md; only one camera plug (labels confusing) → renamed LINK cable pins.

5. Problem Solving:
   - All routing verified by independent checkers + KiCad DRC (0 violations, 0 unconnected) and reload pad-net comparison (0 mismatches, 0 F.Cu tracks for single layer).
   - Open decisions: speaker failover (buy 74HC157 and move amp to BACKUP, or two more 7Semi muxes); backup Teensy deep sleep (advised always-awake); mux chip marking verification; INA260 address pads; Core1121 HF variant; Schottky diodes; coin-cell holder; connector type; female headers; firmware changes (camera on Serial1 pins 0/1 so remove GNSS Serial1 autodetect, FLASH_CS 9, UV 22, Serial3 link, heartbeat pin 5, LEDs 31/32, INA260 ×3, XIAO REC protocol, backup takeover, parachute firmware, CSV logging).

6. All user messages:
   - Initial long request (verify KiCad pins/bootstrap; read CDR with images, install PDF skill; create 4-file memory folder "so even when i message ... you can see whole file and properly apply ... dont give any pin that you think will work"; read guidelines; zero-board build 4× 12×15 boards, 3 vertical in middle + 1 for ram-air steering; arrange components image; list of parts; teensy roles; MG90S drogue/petri; AGFRC A20CLM link; check GCS at vritra-gcs-master, install, add COM autodetect; "ask any question ... dont assume anything").
   - Pasted traceback of exe pyexpat DLL failure.
   - Answers 1–14 with photos (Core1121, SD module, DS3231, NavIC antenna): boards vertical in slots, rod 8 mm; quantities; INA260 ×3; switches, XT60, LEDs; omit BMS, beacon; buy third BMP585; MG90S opens ram-air; 1.8V nothing; yes update radio; power board near battery (add board).
   - FRR PDFs attached + pasted FRR email excerpt.
   - "the board are rectrangle 12 cm width and 15 cm height"
   - "the cansat is total 13 cm diameter outer and height is 40 cm inner diaameter is 12 cm rod outer dimension is 8 mm"
   - "also can you show routes the zero pcb is 12 cm wide and height is 15cm of the pcb properly give me pin diagram and component placement and traces"
   - "no i think you misunderstoof i cut pcb in 12x15 i want to mount my compoent on zero pcb and route them i need it to be properl done. so i am asking image represnetaion of how i shall attach module and you can generate how i should route traces on zero board and place component"
   - "treat this zero board like real board"
   - "i want all connector like gnss bat connection i want to see how my final cansat will work"
   - "can you write table of each induviaul model and the pins i am to connect them if i have to add resistory in middle its pin shuld be propely expalined there only"
   - "ok now tell me all connection properly in chat component wise dont use difficult name use easy name jst connector 2 to 5. properly tell me all pins"
   - "now ssee all the pin except three buck pcb i want all three sensor board. images and their traces in placement. now remeber i want you to remeber all this traces i want all lines properly run but in pcb way ... read all our last message gentate image accoridng to table you gave upside"
   - Photo of Adafruit LSM6DSO32: "Adafruit LSM6DSO32 6-DoF Accelerometer and Gyroscope have 13 legs see image i share"
   - "my camera will not transmitt video signal it has its own esp32 i want just to tell teensy even that will be of primary teensy to start recording and then continue recording no matter what and also i have 7 semi 4 channel mux that you missed and primary teensy will be on no matter what when it fail mux will switch or boot the backup teensy from deep sleep. and the parachute teensy will also get gnss data and priamry board data ... also gnss data will be shared between primary teensy and backup and also parachute teensy"
   - "also you missed the amp adafruit"
   - "also my esc and my gyro wheel motor one thing my cyclone 45a blhell_s 2-6s lipo esc can rotate the motor clock wise or anti clock wise no matter how it is connection now its positive and negative is directly connected to my battery but its has 2 pin coming outside of it also place that"
   - Sent back MAIN/BACKUP images: "as i said that mux is also in case the primary teensy shut down during launchor have any error also for speaker and camera also you missed microsdcard module it has cs,sck,mosi,miso,vcc,gnd it should store everthing that is happening in system with time stamp in excel format on system itself also see that mux properly as shown in image i have done my connection of board 1 check all"
   - "but i have only one camera and your board 1 and 2 both have connectors for cmaera in total system has 3 camera connecotr"
   - Pasted old plain-language list + "i want you to crate a proper image with all proper line with all traces or in kicad make a project on rectrangular box like my zero pcb i want you it make a perfect traces and all lines. i want all proper because in images you missed some traces which is problem"
   - "can you make it single layer like we are doing in zer board wiyh 90 degree turn"
   - "Try again"
   - "Ok now listen we have much space board 1 is ok but see this i think we should merge board 2 and 3 and 4 will be of power and 5 will be of parachute control i am not putting the senior i don't have see which which sensor i have told in entire chat and put it there with mux and memory card module and create there single layer pcb"
   - No explicit security constraints given by the user (general rules apply).

7. Pending Tasks:
   - Finish the merge: update helper scripts for 4 boards (A MAIN = Board 1, B BACKUP+SENSOR = Board 2, E POWER = Board 4, D PARACHUTE = Board 5): system_view.py (remove W8, W13, W14; X12 → board B M1L HDC3020 cable; pos/colors/titles without "C"; render positions), audit.py (iterate boards.BOARDS keys; I2C table: ("B","SDA") add ("HDC3020",0x44), remove ("A","SDA1"); SUPPLY add ("B","U11","VCC"): V5, remove ("D","U7","VCC")), easy_list.py (BOARD names e.g. "BACKUP + SENSOR board (Board 2)", PLUG/PART for U11, M1L, remove C entries, loops over BOARDS), pin_tables.py (BOARD_TITLE, loop), kicad_export.py NAMES (B → BACKUP_SENSOR) and loops, kicad_export1.py loop + folder naming with board numbers (e.g., ZB1_MAIN_1L, ZB2_BACKUP_SENSOR_1L, ZB4_POWER_1L, ZB5_PARACHUTE_1L), archive old kicad_single C folder.
   - Route single-layer, run KiCad DRC (target 0/0), reload pad-net check, export PNG images, build lists; send images; update 03/04 docs and auto-memory; tell user MAIN J6/J9 are now spare, SD now on Board 2 (backup Teensy pins 10–13), parachute logs via backup over W12 (firmware), env sensors dropped.
   - Still-open user decisions: speaker failover method; backup deep sleep vs awake; photos of soldered Board 1 for checking; various Q22–Q25; firmware work.

8. Current Work:
   Implementing the user's latest request to merge Board 2 (BACKUP) and Board 3 (SENSOR) with only owned sensors (BMP585 #2, LSM6DSO32, HDC3020) plus mux, camera plug and microSD card module, keep Board 1 unchanged, Board 4 = power, Board 5 = parachute, and produce single-layer PCBs. boards.py has been patched and placement/pin checks pass ("A [] B [] D [] E []"). I had just grepped helper scripts for SENSOR-board references:
   ```
   system_view.py:31 W8 ... "C","J3"; :36 W13 "C","J1"; :37 W14 "C","J7"; :53 X12 "C","J2"; :111 pos includes "C"; :113 colors; :116 titles
   audit.py:41 ("A","SDA1"): [("HDC3020",0x44)]; :54 for bk in "ABCDE"
   easy_list.py:11 BOARD includes "C"; :30-32 C plugs; :157,:168 loops "ABCDE"
   pin_tables.py:19 BOARD_TITLE includes C; :133 loop "ABCDE"
   kicad_export.py:30 NAMES; :230 list("ABCDE"); kicad_export1.py:188 list("ABCDE")
   ```

9. Optional Next Step:
   Continue the merge task per the user's request "merge board 2 and 3 and 4 will be of power and 5 will be of parachute control ... put it there with mux and memory card module and create there single layer pcb": update system_view.py, audit.py, easy_list.py, pin_tables.py, kicad_export.py/kicad_export1.py for the 4-board set (no board C), then run `python system_view.py`, `python audit.py`, and `"C:\Program Files\KiCad\10.0\bin\python.exe" kicad_export1.py A B D E`, run kicad-cli DRC on each (expect 0 violations / 0 unconnected), export SVG→PNG, verify pad nets, send the four board images (Board 1 MAIN, Board 2 BACKUP+SENSOR, Board 4 POWER, Board 5 PARACHUTE) and update the memory/changelog.

If you need specific details from before compaction (like exact code snippets, error messages, or content you generated), read the full transcript at: C:\Users\kalbh\.claude\projects\D--linux-Software-Claude\82db8d36-3829-40ca-92d8-a3612cf1d4dd.jsonl
Continue the conversation from where it left off without asking the user any further questions. Resume directly — do not acknowledge the summary, do not recap what was happening, do not preface with "I'll continue" or similar. Pick up the last task as if the break never happened.

The messages after this summary are the most recent messages from before compaction, kept verbatim. The summary was written without seeing them, so something it says has not happened yet may already have happened in them.

---
**CLAUDE** (2026-10-24T06:28:30)

Now route the four boards single-layer and export KiCad.

---
**CLAUDE** (2026-10-24T06:29:07)

Waiting for the router to finish (it negotiates congestion for 70 iterations per board).

---
**CLAUDE** (2026-10-24T06:29:20)

The router is running for the four boards (Board 1, 2, 4, 5). I'll pick up as soon as it finishes, then run KiCad DRC and make the images.

---
**USER** (2026-10-24T06:32:39)

<task-notification>
<task-id>bjydx38ed</task-id>
<tool-use-id>toolu_01MpMa7wnVsGhL3peHJp8Mb4</tool-use-id>
<output-file>C:\Users\kalbh\AppData\Local\Temp\claude\D--linux-Software-Claude\82db8d36-3829-40ca-92d8-a3612cf1d4dd\tasks\bjydx38ed.output</output-file>
<status>completed</status>
<summary>Background command "Archive old boards and export 4 single-layer boards" completed (exit code 0)</summary>
</task-notification>

---
**CLAUDE** (2026-10-24T06:33:04)

All four boards pass KiCad DRC with 0/0. Let me look at the Board 2 picture.

---
**CLAUDE** (2026-10-24T06:33:09)

Board 2 is fully routed on one layer. Now updating the memory files.

---
**CLAUDE** (2026-10-24T06:33:55)

Boards 2 and 3 are now merged, so the CanSat has **4 boards**. All four are routed on one layer (bottom solder trails, straight lines and 90° turns only). KiCad's design check found **0 errors and 0 unconnected pins** on every board. I also reloaded each saved file: every pin is on the right connection and nothing is on the top copper layer.

**The 4 boards**
- **Board 1 MAIN:** no change. Two of its plugs, **J6** (the I²C plug) and **J9** (the analog plug), used to feed the old sensor board. They're now spare, so don't fit them.
- **Board 2 BACKUP + SENSOR:**
  - Backup Teensy 4.1, BMP585 #2 and LSM6DSO32.
  - **HDC3020:** its 4 cable wires solder straight to the board (+ = 3V3, − = GND, D = SDA, C = SCL).
  - 7Semi mux and the one camera plug.
  - **microSD card module:** CS → pin 10, SCK → 13, MOSI → 11, MISO → 12. VCC goes to **5 V**, not 3.3 V. Nothing else shares its SPI bus.
- **Board 4 POWER:** I removed the 5 V plug that fed the sensor board.
- **Board 5 PARACHUTE:** the microSD is gone, so Teensy 4.0 pins 10–13 are free. The parachute data is meant to reach the logger on Board 2 through the 3-wire link cable W12 (the Board 2 ↔ Board 5 link), but the firmware for that isn't written yet.
- **Removed:** the ozone sensor, the UV sensor, the spare sensor sockets and the dashed second radio, because you don't have them. Three cables are gone too (5 V to the sensor board, I²C from MAIN and analog from MAIN), so the harness is **11 cables**. They're still all pin 1 to pin 1, with no mismatches.

**Wire links** (short wires that jump over a trail): Board 1 has 59, Board 2 has 19, Board 4 has 18 and Board 5 has 8.

**What isn't done yet**
- **Firmware:** none of it is written yet. The backup Teensy should log everything to the microSD as a timestamped CSV file that opens in Excel.
- **Old 2-layer files:** the `kicad/` folder still holds the old 5-board version. Use only the single-layer files below. The old single-layer set is moved to `kicad_single/_old_5_boards/`.

I updated the memory folder (files 03 and 04) and my own notes. I also added [check_single.py](VRITRA_ZeroBoard_Memory/routing/check_single.py), which re-runs the design check, the pin check and the pictures in one go.

The pictures are sent above. For each board, the folder has the picture, the KiCad project and a build list of every trail, hole by hole:
- [BOARD1_MAIN_1L](VRITRA_ZeroBoard_Memory/kicad_single/BOARD1_MAIN_1L)
- [BOARD2_BACKUP_SENSOR_1L](VRITRA_ZeroBoard_Memory/kicad_single/BOARD2_BACKUP_SENSOR_1L)
- [BOARD4_POWER_1L](VRITRA_ZeroBoard_Memory/kicad_single/BOARD4_POWER_1L)
- [BOARD5_PARACHUTE_1L](VRITRA_ZeroBoard_Memory/kicad_single/BOARD5_PARACHUTE_1L)

Should I write the CSV logging firmware for the microSD on Board 2 next, or leave it for now?

---
**USER** (2026-10-24T06:50:51)

why is sdo of bmp attached to 3v3

---
**CLAUDE** (2026-10-24T06:51:06)

On the BMP585, **SDO picks the I²C address**. It isn't a data line here.

- SDO → GND gives address **0x46**
- SDO → 3V3 gives address **0x47**

The chip has to see one or the other, so SDO can't be left floating. If it floats, the address can change from one power-up to the next and the Teensy may not find the sensor.

**Why 3V3 and not GND:** your flight firmware ([Config.h:245](C:/Users/kalbh/Downloads/vritra-gcs-master/vritra-gcs-master/firmware/vritra_fc/Config.h:245)) has a comment saying 0x47 showed up in your own I²C scan and 0x46 didn't. That means SDO was already tied high on the board you tested. I copied that so Board 1 behaves the same as the board your firmware already works with.

**On Board 2 it's mainly for consistency.** The other chips on that bus are the LSM6DSO32 (0x6A) and the HDC3020 (0x44), so neither choice would clash. GND would work too, because the firmware tries 0x47 first, then 0x46, and checks the chip ID either way. I kept 3V3 so every BMP585 uses the same wiring and the same address.

Some breakout boards already tie SDO high or low with a resistor or solder jumper. If yours has a jumper set to GND, my 3V3 wire would short it. Check your module before you solder that wire.

---
**USER** (2026-10-24T13:20:20)

11.8 HEIGHT 15 CM WIDTH CAN YOU MAKE THIS AS A PCB SINGLE LAYER THAT I WILL MAKE MY ETCHING PCB TRY TO PUT THE COMPONENT AS CLOSE AS POSSIBLE MAINLY I WANT TO MAKE BOARD 1 AND 2. 3 WILL XERO BOARD OF ZERO BOARD YOU DONT HAVE TO MAKE THAT. MAKE BOARD 4 ALL PROPER ALL JST CONNECOTOR AND FOLLOW ALL BOARD AND DESIGNING RULE AS THIS IS NORMAL COPPER PLATE WITH COPPER TRACES ETCHIED ON IT MAKE IT NATURAL I DONT WANT ANY PROBLEM ALL COMPOENT SHOULD BE PROPERLY PUT AS I AM MAKING A ETCHING PCB AS WEIGHT IS TOO MUCH I AM THINKING OF REDUCING BOARD I WILL STILL USE JST CONNECTOR. MAKE ALL PCB PROPERLY CHECK THAT PCB AND EXPORT THE GREBER FILE.

---
**CLAUDE** (2026-10-24T13:28:09)

Before placing anything I need each module's exact pin pattern and outline, so I'm dumping that from your footprint library.

---
**CLAUDE** (2026-10-24T13:33:22)

I have the footprint geometry I need. Next I'm making the engine's board size configurable so the same verified netlists can be placed on a 150 × 118 mm etched board.

---
**CLAUDE** (2026-10-24T13:33:29)

Now the etched-board router. It works like the zero-board router, but signal traces may also run at 45° (the natural PCB look), and acute corners are banned because etchant gets trapped in them.

---
**CLAUDE** (2026-10-24T13:38:07)

Board 4 now takes the 8 V servo power on a 4-pin JST, with 2 pins for + and 2 for GND, so up to 6 A. That changes the Board 3 end of the same cable, so I'm updating both netlists.

---
**CLAUDE** (2026-10-24T13:39:40)

Netlists still verify. Let me look at the etched placement previews before routing.

---
**CLAUDE** (2026-10-24T13:41:05)

Running the router and KiCad export for all three boards in parallel.

---
**CLAUDE** (2026-10-24T13:41:15)

While that runs, I'll check the Board 2 and Board 4 placement previews.

---
**CLAUDE** (2026-10-24T13:41:33)

Placements look right on all three. While the router runs, I'll check the kicad-cli options for Gerber, drill and PDF export.

---
**CLAUDE** (2026-10-24T13:42:00)

The router is still running on all three boards. I'll continue when it finishes: KiCad DRC, pin checks, then Gerbers.
