itsmeabirmohanta/Sujal/source/VRITRA_CanSat_025_Handover_2026-10-28/06_chats/oct_2026_board_build/2026-10-24_c609f89e.md

# Chat session c609f89e-9d70-467c-b852-69f64ee21810.jsonl (started 2026-10-24T06:27:58.355Z)

---
**USER** (2026-10-24T06:27:58)

[summary of earlier part of the chat]
This session is being continued from a previous conversation that ran out of context. The summary below covers the earlier portion of the conversation.

<tools-used-before-summary>Bash, Edit, PowerShell, Read, SendUserFile, TaskStop, ToolSearch, WebFetch, WebSearch, Write, mcp__ccd_turn__update_plan, mcp__ccd_turn__wrap_up</tools-used-before-summary>
Summary:
1. Primary Request and Intent:
   - Overall project: Team VRITRA (IN-SPACe CAN-7USAT 2026, Team ID 2026-INSPACe-CAN-7USAT-025) CanSat. The user wants a fully verified, hallucination-free hardware design built on 12 cm × 15 cm double-sided zero (perfboard) boards, with exact pin connections, placement, and traces ("treat this zero board like real board"), plus GCS software with COM autodetect, and a 4-file memory folder to keep context.
   - Earlier explicit requests (completed): verify KiCad schematics/PCB pins (bootstrap/hardware pin errors); read CDR (incl. images), guidelines, frequency assignment; create memory folder (4 files); install GCS and add COM-port autodetect; arrange components on boards with images; per-module pin tables with resistor legs explained; plain-language component-wise connection list using JST connectors of 2–5 pins; combined placement+trace images; KiCad projects with perfect traces (after "images missed some traces"); then SINGLE-LAYER zero-board style with 90° turns.
   - Hardware facts from user: boards stand on edge in can; can OD 130 mm, ID 120 mm, height 400 mm, rods Ø8 mm; boards are full 120 W × 150 H rectangles mounted in 3D-printed slots; only ONE camera (XIAO ESP32-S3 Sense, record-only, MAIN Teensy commands start and it keeps recording); 7Semi 4-channel UART mux (for failover of camera, and user also wants speaker failover); Adafruit MAX98357A amp + speaker; Cyclone 45A BLHeli_S 2–6S ESC (2 thin wires signal+GND; thick wires to battery); GNSS shared to MAIN, BACKUP, PARACHUTE Teensys; parachute Teensy gets GNSS + MAIN data for precision landing; microSD card module (CS, SCK, MOSI, MISO, VCC, GND) should log everything with timestamps in Excel (CSV) format.
   - MOST RECENT REQUEST (in progress): "Ok now listen we have much space board 1 is ok but see this i think we should merge board 2 and 3 and 4 will be of power and 5 will be of parachute control i am not putting the senior i don't have see which which sensor i have told in entire chat and put it there with mux and memory card module and create there single layer pcb"

2. Key Technical Concepts:
   - Teensy 4.1/4.0 pin capabilities (Serial1–8, SPI/SPI1 26/27/39, Wire/Wire1/Wire2, SAI1/SAI2 I²S, PWM, 3.3 V-only I/O, never wire On/Off/Program, Teensy 3V3 pin not to be joined to 3V3 rails).
   - Firmware vritra_fc pin map (MAIN follows it): LoRa CS29 BUSY24 RST25 IRQ30 SPI1 MOSI26 SCK27 MISO39; L89 Serial2 RX7/TX8, RST6; I²C 18/19 @100 kHz; VBAT divider 100k/22k on A6=pin20; beacon SAI2 DIN2 LRCLK3 BCLK4 SD37; pins 33–36 driven by firmware (old TB6612) → keep free.
   - Radio assignment 19-10-2026: 866.50 MHz main / 865.25 backup, SF9, BW125, CR4/5, sync 0x99; TCXO 1.6 V; RF switch DIO5/6.
   - Hole grid: 2.54 mm pitch, 47 columns × 59 rows; hole C1 R1 = bottom-left from component side; X0=(120−46·2.54)/2, Y0=(150−58·2.54)/2; 3 mm edge margin.
   - Routers: single-layer negotiated-congestion (PathFinder) with wire links (zb_router1), 2-layer (zb_router2), earlier single-layer with hops (zb_engine.route).
   - KiCad 10.0.6 pcbnew Python (C:\Program Files\KiCad\10.0\bin\python.exe), kicad-cli DRC (json, --severity-all) and SVG export, PyMuPDF SVG→PNG; jumper pads via fp.SetDuplicatePadNumbersAreJumpers(True).
   - I²C addresses: BMP585 0x47 (SDO→3V3), ICM-20948 0x69 (CS+SDO tied to module 1V8), DS3231 0x68 + AT24C32 0x57, INA260 0x40/0x41/0x45, LSM6DSO32 0x6A (DO→GND, CS→3V3), HDC3020 0x44.
   - microSD (74xx125 buffered) module: VCC 5 V, MISO never tri-states → must be alone on its SPI bus.
   - 7Semi mux BO-10145 assumed 74HC4052-like (bidirectional); A,B,C (C=INH) pulled down 10k → channel 1 (MAIN) default; bottom row (5V,3V3,GND,RX_COM,TX_COM) off-grid → 5 wires to U10B landing holes; DIP OFF, VCC jumper 3V3.

3. Files and Code Sections:
   - D:\linux\Software\Claude\VRITRA_ZeroBoard_Memory\01_PROJECT_CONTEXT.md, 02_HARDWARE_INVENTORY.md, 03_PIN_MAP_AND_WIRING.md (v0.3 header notes boards.py authoritative), 04_DECISIONS_CHANGELOG.md (all decisions/changes logged incl. single-layer build reference entry, open questions Q15–Q25, firmware TODO).
   - C:\Users\kalbh\.claude\projects\D--linux-Software-Claude\memory\project-cansat-zeroboard.md + MEMORY.md index line (auto-memory; latest: single-layer build reference = kicad_single).
   - GCS: C:\Users\kalbh\Downloads\vritra-gcs-master\vritra-gcs-master\gcs\vritra_gcs.py (added §11b COM-port auto-detect: AUTODETECT_LISTEN_S, GATEWAY_MARKERS, classify_serial_line, probe_port, autodetect_candidates, PortAutoDetect; toolbar Auto-detect button; _autodetect_port/_autodetect_poll; auto-scan when LIVE with no port; radio constants 866.50/865.25 SF9 0x99, LORA_SENS_DBM −129.5); VRITRA_GCS.spec (PATH fix for libexpat + guard); backup vritra_gcs.py.orig_before_autodetect; dist\VRITRA_GCS.exe rebuilt.
   - Firmware radio constants updated: firmware\vritra_fc\Config.h, vritra_gs\vritra_gs.ino, esp32rec\esp32rec.ino, vritra_tx\vritra_tx.ino, cdr_tests\test_rf_rx/test_rf_tx (backups *.orig_before_freq19-10). Not flashed.
   - routing\zb_engine.py: Board/Part/Net dataclasses, load_fp/place_fp (from VRITRA_footprints.pretty), place_row (jst=True gives JST-XH body 2.45 along/2.9 across, 2..5 pins), place_2pin (R, C, CP, LED_G, LED_R, D), place_box, fit_check, usable (EDGE=3.0), old route/verify/render.
   - routing\boards.py (SOURCE OF TRUTH): board_a (MAIN), board_b (now "Board 2 BACKUP + SENSOR"), board_c (SENSOR, now removed from BOARDS), board_d (PARACHUTE), board_e (POWER); EXPECT_A/B/D, FORBIDDEN_*; dicts T41_NAMES, T40_NAMES, CORE, L89, BMP, ICM, W25, LSM (14 pins incl. back row SCX, SDX, CS(back), DO(back), GND(back)), MUX, AMP, INA. Backups: boards.py.bak_before_jst, .bak_before_cam_amp, .bak_before_servo_gap, .bak_before_merge.
     - Latest merge edits (applied, checks pass for A,B,D,E):
       ```
       sd = place_row(b, "U11", 7, 41, ["CS","SCK","MOSI","MISO","VCC","GND"], "microSD card module", height=8.0, color=C_SENS, note="straight header, module FLAT\ncard slot → top edge · VCC = 5 V")
       sd.body = (hx(7)+6.35-12.0, hy(41)-2.0, hx(7)+6.35+12.0, hy(41)+42.0)
       place_box(b, "M1", 96.0, 128.0, 118.0, 144.0, "HDC3020 (7Semi)", C_SENS, height=6.0, note="2× M2 screws · JST-PH cable\n+ - D C → 3V3 GND SDA SCL · 0x44")
       place_row(b, "M1L", 41, 50, ["3V3","GND","SDA","SCL"], "HDC3020 cable wires", height=3.0, color=C_SENS)
       Net("SD_CS",[T("10"),("U11","1")]), Net("SD_SCK",[T("13"),("U11","2")]), Net("SD_MOSI",[T("11"),("U11","3")]), Net("SD_MISO",[T("12"),("U11","4")])
       GND += ("U11","6"),("M1L","2"); +5V_LOGIC += ("U11","5"); +3V3_B += ("M1L","1"); SDA += ("M1L","3"); SCL += ("M1L","4")
       EXPECT_B = {"10":"SD_CS","11":"SD_MOSI","12":"SD_MISO","13":"SD_SCK","0":"GNSS_IN",...}
       ```
       Removed dashed U9 2nd-Core1121 box from B; removed U7 SD and its nets from D and EXPECT_D (10–13); removed E J11 and its GND/+5V refs; removed "C" from BOARDS.
     - Other current B content: Teensy U1 (21,40,rot270), BMP585 U5 (31,36), LSM6DSO32 U8 (31,44), J1 PWR (21,52), J2 LINK JST-5 (3,41 down: HB,GNSS,MUX_TX,MUX_RX,GND), J3 to D (45,31), J4 CAMERA plug (45,22: +5V,GND,to D7,from D6), mux U10 (29,15) pins 1–20 + U10B (30,3), R1 1k TX3, R2/R3 1k Serial8 (35 TX/34 RX) to mux ch2, R9/R10 1k cam, R6–R8 10k pull-downs MUX_A(5)/B(6)/C(9), LEDs on 36/37.
     - MAIN (A): unchanged per user; includes amp U9 MAX98357A (32,10) pins LRC3 BCLK4 DIN2 SD37 GAIN→R12 100k→GND, C6 100µF; camera UART Serial1 pin1 TX→R11 1k→J5.3, J5.4→pin0; J6 (I2C to sensor, now spare) and J9 (analog, now spare); J7 GNSS coin cell + D3/D4 Schottky to L89 BAT.
     - PARACHUTE (D): servo headers rows 38/36/34/32/30 (J14 ESC 2-pin ["−","S"] at col 3), Hall J15 row 28, R6 row 26.
   - routing\zb_router1.py: single-layer router; link_blocks(b) (no_end: pins + holes within body ±1.2 mm; no_span: pins + bodies of non-Teensy parts); route1 (STEP 1.0, TURN 0.6, LINK_COST 80.0, LINK_PER_HOLE 0.6, JMAX 10, ITERATIONS 70; no U-turn; no link after link; link_ends per net), split1 → {"trails","links"}, verify1 (connectivity, holes ownership, link rules, no doubled trails, one link end per hole).
   - routing\zb_router2.py (2-layer), routing\kicad_export.py (2-layer KiCad; helpers P, H, mm, rect, text, width, _runs, NAMES={"A":"MAIN","B":"BACKUP","C":"SENSOR","D":"PARACHUTE","E":"POWER"}, write_build_list), routing\kicad_export1.py (single-layer KiCad: link_footprint with jumper pads, OUT=../kicad_single, folder ZB_<X>_<NAME>_1L, BUILD_LIST.md; default loop list("ABCDE")).
   - routing\system_view.py (CABLES W1–W14, EXTERNAL X1–X15, check straight-through, CABLES.md, SYSTEM_interconnect.png), audit.py (SUPPLY, DRIVERS, I2C, FW_PINS vs Config.h; loops "ABCDE"), easy_list.py (EASY_CONNECTIONS.md; BOARD/PART/PLUG maps; loops "ABCDE"), pin_tables.py (MODULE_PIN_TABLES.md; loop "ABCDE"), combined_view.py (old images), old images archived in routing\old_superseded_single_layer\.
   - Outputs: kicad\ZB_<X>_<NAME>\ (2-layer, DRC 0/0), kicad_single\ZB_<X>_<NAME>_1L\ (single-layer, DRC 0/0, links A59 B10 C4 D10 E18) — these predate the merge and must be regenerated.

4. Errors and fixes:
   - GCS exe pyexpat DLL load failure → Oracle DB libexpat on PATH; spec prepends Python DLL dirs and aborts build if libexpat from outside.
   - Offscreen GUI test segfault from QMessageBox in constructor (pre-existing) → test fakes comports/patches warning; added combo addItem if port not listed.
   - Bash heredoc encoding garbled “·”/“→” in boards.py (twice) → fixed with Edit tool; write patch scripts to scratchpad files instead of heredocs.
   - easy_list dedupe bug dropped GND lines across modules → per-module dedupe + independent missing-line check (0 missing).
   - audit false positive (E U1 is INA260) → restrict Teensy check to boards A,B,D.
   - D stacked servo headers boxed in “+” pins (router raised) → one empty row between headers.
   - Single-layer link issues found by KiCad DRC (pth_inside_courtyard, holes_co_located, track_dangling from U-turn loophole) → link_blocks margin, no chained links, one link end per hole, no U-turns, verifier checks; LINK_COST tuned to 80 (45 produced verify problems; exporter refuses unverified boards).
   - Merge patch left a dangling continuation line in board_d → replaced with comment.
   - M1L overlapped LSM6DSO32 body → moved to col 41.
   - User feedback: images missed traces (pale power wires) → KiCad projects with all nets as tracks; user wanted single layer with 90° turns → single-layer router; pasted outdated list → told user current list is EASY_CONNECTIONS.md; only one camera plug (labels confusing) → renamed LINK cable pins.

5. Problem Solving:
   - All routing verified by independent checkers + KiCad DRC (0 violations, 0 unconnected) and reload pad-net comparison (0 mismatches, 0 F.Cu tracks for single layer).
   - Open decisions: speaker failover (buy 74HC157 and move amp to BACKUP, or two more 7Semi muxes); backup Teensy deep sleep (advised always-awake); mux chip marking verification; INA260 address pads; Core1121 HF variant; Schottky diodes; coin-cell holder; connector type; female headers; firmware changes (camera on Serial1 pins 0/1 so remove GNSS Serial1 autodetect, FLASH_CS 9, UV 22, Serial3 link, heartbeat pin 5, LEDs 31/32, INA260 ×3, XIAO REC protocol, backup takeover, parachute firmware, CSV logging).

6. All user messages:
   - Initial long request (verify KiCad pins/bootstrap; read CDR with images, install PDF skill; create 4-file memory folder "so even when i message ... you can see whole file and properly apply ... dont give any pin that you think will work"; read guidelines; zero-board build 4× 12×15 boards, 3 vertical in middle + 1 for ram-air steering; arrange components image; list of parts; teensy roles; MG90S drogue/petri; AGFRC A20CLM link; check GCS at vritra-gcs-master, install, add COM autodetect; "ask any question ... dont assume anything").
   - Pasted traceback of exe pyexpat DLL failure.
   - Answers 1–14 with photos (Core1121, SD module, DS3231, NavIC antenna): boards vertical in slots, rod 8 mm; quantities; INA260 ×3; switches, XT60, LEDs; omit BMS, beacon; buy third BMP585; MG90S opens ram-air; 1.8V nothing; yes update radio; power board near battery (add board).
   - FRR PDFs attached + pasted FRR email excerpt.
   - "the board are rectrangle 12 cm width and 15 cm height"
   - "the cansat is total 13 cm diameter outer and height is 40 cm inner diaameter is 12 cm rod outer dimension is 8 mm"
   - "also can you show routes the zero pcb is 12 cm wide and height is 15cm of the pcb properly give me pin diagram and component placement and traces"
   - "no i think you misunderstoof i cut pcb in 12x15 i want to mount my compoent on zero pcb and route them i need it to be properl done. so i am asking image represnetaion of how i shall attach module and you can generate how i should route traces on zero board and place component"
   - "treat this zero board like real board"
   - "i want all connector like gnss bat connection i want to see how my final cansat will work"
   - "can you write table of each induviaul model and the pins i am to connect them if i have to add resistory in middle its pin shuld be propely expalined there only"
   - "ok now tell me all connection properly in chat component wise dont use difficult name use easy name jst connector 2 to 5. properly tell me all pins"
   - "now ssee all the pin except three buck pcb i want all three sensor board. images and their traces in placement. now remeber i want you to remeber all this traces i want all lines properly run but in pcb way ... read all our last message gentate image accoridng to table you gave upside"
   - Photo of Adafruit LSM6DSO32: "Adafruit LSM6DSO32 6-DoF Accelerometer and Gyroscope have 13 legs see image i share"
   - "my camera will not transmitt video signal it has its own esp32 i want just to tell teensy even that will be of primary teensy to start recording and then continue recording no matter what and also i have 7 semi 4 channel mux that you missed and primary teensy will be on no matter what when it fail mux will switch or boot the backup teensy from deep sleep. and the parachute teensy will also get gnss data and priamry board data ... also gnss data will be shared between primary teensy and backup and also parachute teensy"
   - "also you missed the amp adafruit"
   - "also my esc and my gyro wheel motor one thing my cyclone 45a blhell_s 2-6s lipo esc can rotate the motor clock wise or anti clock wise no matter how it is connection now its positive and negative is directly connected to my battery but its has 2 pin coming outside of it also place that"
   - Sent back MAIN/BACKUP images: "as i said that mux is also in case the primary teensy shut down during launchor have any error also for speaker and camera also you missed microsdcard module it has cs,sck,mosi,miso,vcc,gnd it should store everthing that is happening in system with time stamp in excel format on system itself also see that mux properly as shown in image i have done my connection of board 1 check all"
   - "but i have only one camera and your board 1 and 2 both have connectors for cmaera in total system has 3 camera connecotr"
   - Pasted old plain-language list + "i want you to crate a proper image with all proper line with all traces or in kicad make a project on rectrangular box like my zero pcb i want you it make a perfect traces and all lines. i want all proper because in images you missed some traces which is problem"
   - "can you make it single layer like we are doing in zer board wiyh 90 degree turn"
   - "Try again"
   - "Ok now listen we have much space board 1 is ok but see this i think we should merge board 2 and 3 and 4 will be of power and 5 will be of parachute control i am not putting the senior i don't have see which which sensor i have told in entire chat and put it there with mux and memory card module and create there single layer pcb"
   - No explicit security constraints given by the user (general rules apply).

7. Pending Tasks:
   - Finish the merge: update helper scripts for 4 boards (A MAIN = Board 1, B BACKUP+SENSOR = Board 2, E POWER = Board 4, D PARACHUTE = Board 5): system_view.py (remove W8, W13, W14; X12 → board B M1L HDC3020 cable; pos/colors/titles without "C"; render positions), audit.py (iterate boards.BOARDS keys; I2C table: ("B","SDA") add ("HDC3020",0x44), remove ("A","SDA1"); SUPPLY add ("B","U11","VCC"): V5, remove ("D","U7","VCC")), easy_list.py (BOARD names e.g. "BACKUP + SENSOR board (Board 2)", PLUG/PART for U11, M1L, remove C entries, loops over BOARDS), pin_tables.py (BOARD_TITLE, loop), kicad_export.py NAMES (B → BACKUP_SENSOR) and loops, kicad_export1.py loop + folder naming with board numbers (e.g., ZB1_MAIN_1L, ZB2_BACKUP_SENSOR_1L, ZB4_POWER_1L, ZB5_PARACHUTE_1L), archive old kicad_single C folder.
   - Route single-layer, run KiCad DRC (target 0/0), reload pad-net check, export PNG images, build lists; send images; update 03/04 docs and auto-memory; tell user MAIN J6/J9 are now spare, SD now on Board 2 (backup Teensy pins 10–13), parachute logs via backup over W12 (firmware), env sensors dropped.
   - Still-open user decisions: speaker failover method; backup deep sleep vs awake; photos of soldered Board 1 for checking; various Q22–Q25; firmware work.

8. Current Work:
   Implementing the user's latest request to merge Board 2 (BACKUP) and Board 3 (SENSOR) with only owned sensors (BMP585 #2, LSM6DSO32, HDC3020) plus mux, camera plug and microSD card module, keep Board 1 unchanged, Board 4 = power, Board 5 = parachute, and produce single-layer PCBs. boards.py has been patched and placement/pin checks pass ("A [] B [] D [] E []"). I had just grepped helper scripts for SENSOR-board references:
   ```
   system_view.py:31 W8 ... "C","J3"; :36 W13 "C","J1"; :37 W14 "C","J7"; :53 X12 "C","J2"; :111 pos includes "C"; :113 colors; :116 titles
   audit.py:41 ("A","SDA1"): [("HDC3020",0x44)]; :54 for bk in "ABCDE"
   easy_list.py:11 BOARD includes "C"; :30-32 C plugs; :157,:168 loops "ABCDE"
   pin_tables.py:19 BOARD_TITLE includes C; :133 loop "ABCDE"
   kicad_export.py:30 NAMES; :230 list("ABCDE"); kicad_export1.py:188 list("ABCDE")
   ```

9. Optional Next Step:
   Continue the merge task per the user's request "merge board 2 and 3 and 4 will be of power and 5 will be of parachute control ... put it there with mux and memory card module and create there single layer pcb": update system_view.py, audit.py, easy_list.py, pin_tables.py, kicad_export.py/kicad_export1.py for the 4-board set (no board C), then run `python system_view.py`, `python audit.py`, and `"C:\Program Files\KiCad\10.0\bin\python.exe" kicad_export1.py A B D E`, run kicad-cli DRC on each (expect 0 violations / 0 unconnected), export SVG→PNG, verify pad nets, send the four board images (Board 1 MAIN, Board 2 BACKUP+SENSOR, Board 4 POWER, Board 5 PARACHUTE) and update the memory/changelog.

If you need specific details from before compaction (like exact code snippets, error messages, or content you generated), read the full transcript at: C:\Users\kalbh\.claude\projects\D--linux-Software-Claude\82db8d36-3829-40ca-92d8-a3612cf1d4dd.jsonl
Continue the conversation from where it left off without asking the user any further questions. Resume directly — do not acknowledge the summary, do not recap what was happening, do not preface with "I'll continue" or similar. Pick up the last task as if the break never happened.

The messages after this summary are the most recent messages from before compaction, kept verbatim. The summary was written without seeing them, so something it says has not happened yet may already have happened in them.

---
**CLAUDE** (2026-10-24T06:28:30)

Now route the four boards single-layer and export KiCad.

---
**CLAUDE** (2026-10-24T06:29:07)

Waiting for the router to finish (it negotiates congestion for 70 iterations per board).

---
**CLAUDE** (2026-10-24T06:29:20)

The router is running for the four boards (Board 1, 2, 4, 5). I'll pick up as soon as it finishes, then run KiCad DRC and make the images.

---
**USER** (2026-10-24T06:32:39)

<task-notification>
<task-id>bjydx38ed</task-id>
<tool-use-id>toolu_01MpMa7wnVsGhL3peHJp8Mb4</tool-use-id>
<output-file>C:\Users\kalbh\AppData\Local\Temp\claude\D--linux-Software-Claude\82db8d36-3829-40ca-92d8-a3612cf1d4dd\tasks\bjydx38ed.output</output-file>
<status>completed</status>
<summary>Background command "Archive old boards and export 4 single-layer boards" completed (exit code 0)</summary>
</task-notification>

---
**CLAUDE** (2026-10-24T06:33:04)

All four boards pass KiCad DRC with 0/0. Let me look at the Board 2 picture.

---
**CLAUDE** (2026-10-24T06:33:09)

Board 2 is fully routed on one layer. Now updating the memory files.

---
**CLAUDE** (2026-10-24T06:33:55)

Boards 2 and 3 are now merged, so the CanSat has **4 boards**. All four are routed on one layer (bottom solder trails, straight lines and 90° turns only). KiCad's design check found **0 errors and 0 unconnected pins** on every board. I also reloaded each saved file: every pin is on the right connection and nothing is on the top copper layer.

**The 4 boards**
- **Board 1 MAIN:** no change. Two of its plugs, **J6** (the I²C plug) and **J9** (the analog plug), used to feed the old sensor board. They're now spare, so don't fit them.
- **Board 2 BACKUP + SENSOR:**
  - Backup Teensy 4.1, BMP585 #2 and LSM6DSO32.
  - **HDC3020:** its 4 cable wires solder straight to the board (+ = 3V3, − = GND, D = SDA, C = SCL).
  - 7Semi mux and the one camera plug.
  - **microSD card module:** CS → pin 10, SCK → 13, MOSI → 11, MISO → 12. VCC goes to **5 V**, not 3.3 V. Nothing else shares its SPI bus.
- **Board 4 POWER:** I removed the 5 V plug that fed the sensor board.
- **Board 5 PARACHUTE:** the microSD is gone, so Teensy 4.0 pins 10–13 are free. The parachute data is meant to reach the logger on Board 2 through the 3-wire link cable W12 (the Board 2 ↔ Board 5 link), but the firmware for that isn't written yet.
- **Removed:** the ozone sensor, the UV sensor, the spare sensor sockets and the dashed second radio, because you don't have them. Three cables are gone too (5 V to the sensor board, I²C from MAIN and analog from MAIN), so the harness is **11 cables**. They're still all pin 1 to pin 1, with no mismatches.

**Wire links** (short wires that jump over a trail): Board 1 has 59, Board 2 has 19, Board 4 has 18 and Board 5 has 8.

**What isn't done yet**
- **Firmware:** none of it is written yet. The backup Teensy should log everything to the microSD as a timestamped CSV file that opens in Excel.
- **Old 2-layer files:** the `kicad/` folder still holds the old 5-board version. Use only the single-layer files below. The old single-layer set is moved to `kicad_single/_old_5_boards/`.

I updated the memory folder (files 03 and 04) and my own notes. I also added [check_single.py](VRITRA_ZeroBoard_Memory/routing/check_single.py), which re-runs the design check, the pin check and the pictures in one go.

The pictures are sent above. For each board, the folder has the picture, the KiCad project and a build list of every trail, hole by hole:
- [BOARD1_MAIN_1L](VRITRA_ZeroBoard_Memory/kicad_single/BOARD1_MAIN_1L)
- [BOARD2_BACKUP_SENSOR_1L](VRITRA_ZeroBoard_Memory/kicad_single/BOARD2_BACKUP_SENSOR_1L)
- [BOARD4_POWER_1L](VRITRA_ZeroBoard_Memory/kicad_single/BOARD4_POWER_1L)
- [BOARD5_PARACHUTE_1L](VRITRA_ZeroBoard_Memory/kicad_single/BOARD5_PARACHUTE_1L)

Should I write the CSV logging firmware for the microSD on Board 2 next, or leave it for now?

---
**USER** (2026-10-24T06:50:51)

why is sdo of bmp attached to 3v3

---
**CLAUDE** (2026-10-24T06:51:06)

On the BMP585, **SDO picks the I²C address**. It isn't a data line here.

- SDO → GND gives address **0x46**
- SDO → 3V3 gives address **0x47**

The chip has to see one or the other, so SDO can't be left floating. If it floats, the address can change from one power-up to the next and the Teensy may not find the sensor.

**Why 3V3 and not GND:** your flight firmware ([Config.h:245](C:/Users/kalbh/Downloads/vritra-gcs-master/vritra-gcs-master/firmware/vritra_fc/Config.h:245)) has a comment saying 0x47 showed up in your own I²C scan and 0x46 didn't. That means SDO was already tied high on the board you tested. I copied that so Board 1 behaves the same as the board your firmware already works with.

**On Board 2 it's mainly for consistency.** The other chips on that bus are the LSM6DSO32 (0x6A) and the HDC3020 (0x44), so neither choice would clash. GND would work too, because the firmware tries 0x47 first, then 0x46, and checks the chip ID either way. I kept 3V3 so every BMP585 uses the same wiring and the same address.

Some breakout boards already tie SDO high or low with a resistor or solder jumper. If yours has a jumper set to GND, my 3V3 wire would short it. Check your module before you solder that wire.

---
**USER** (2026-10-24T13:45:21)

15 HEIGHT 11.8 CM WIDTH CAN YOU MAKE THIS AS A PCB SINGLE LAYER THAT I WILL MAKE MY ETCHING PCB TRY TO PUT THE COMPONENT AS CLOSE AS POSSIBLE MAINLY I WANT TO MAKE BOARD 1 AND 2. 3 WILL XERO BOARD OF ZERO BOARD YOU DONT HAVE TO MAKE THAT. MAKE BOARD 4 ALL PROPER ALL JST CONNECOTOR AND FOLLOW ALL BOARD AND DESIGNING RULE AS THIS IS NORMAL COPPER PLATE WITH COPPER TRACES ETCHIED ON IT MAKE IT NATURAL I DONT WANT ANY PROBLEM ALL COMPOENT SHOULD BE PROPERLY PUT AS I AM MAKING A ETCHING PCB AS WEIGHT IS TOO MUCH I AM THINKING OF REDUCING BOARD I WILL STILL USE JST CONNECTOR. MAKE ALL PCB PROPERLY CHECK THAT PCB AND EXPORT THE GREBER FILE. board 1 is main. board 2 is backup with all other sensor, board 3 is buck and power, board 4 is parachute i want all the senor proper places jumper wire are fine but all should be properly done

---
**CLAUDE** (2026-10-24T13:50:45)

Building etched-PCB versions of Boards 1, 2 and 4 (118 × 150 mm, single layer, wire jumpers, real footprints). First I'm measuring every module footprint so the compact placement is exact.

---
**CLAUDE** (2026-10-24T13:56:43)

Router now supports grid points blocked by off-grid pads. Next I'm writing the etched-PCB placement helpers, which use real KiCad footprints: JST-XH, axial resistors, LEDs and capacitors.

---
**CLAUDE** (2026-10-24T13:59:25)

Placement helpers are done. Next I'm building a preview so I can pack Board 1 tightly and check it before routing.

---
**CLAUDE** (2026-10-24T14:05:49)

Board 1 fits in **118 × 90 mm**. Fixing the 7 overlapping parts now.

---
**CLAUDE** (2026-10-24T14:06:02)

Board 1 placement is clean (no overlaps, every pin matches the firmware map). Running the single-layer router on it now.

---
**CLAUDE** (2026-10-24T14:08:43)

The router got stuck because the status LEDs sat in the only channel under the Teensy, where wires cross from the left side to the right. Moving the LEDs to the bottom-right corner.

---
**CLAUDE** (2026-10-24T14:12:35)

I need to see where the copper gets crowded, so I'm adding a congestion picture to the router.

---
**CLAUDE** (2026-10-24T14:42:44)

Found a bug: the congestion penalty grew past my "infinity" placeholder, so paths silently disappeared. Fixing it, then rerunning.

---
**CLAUDE** (2026-10-24T14:47:10)

Boards 2 and 4 are placed cleanly (118×91 and 118×82 mm). Routing them in parallel with Board 1.

---
**CLAUDE** (2026-10-24T14:48:06)

Board 4 routed cleanly: 0 problems, 8 jumpers. Let me look at it.

---
**CLAUDE** (2026-10-24T14:48:15)

Board 4 routes with 8 jumpers and no rule problems. Exporting it to KiCad and running the design check while Boards 1 and 2 keep routing.

---
**CLAUDE** (2026-10-24T14:51:50)

Board 4 now passes KiCad's design check: **0 violations, 0 unconnected**. Making the fix permanent and generating Board 4's Gerbers and print PDFs.

---
**CLAUDE** (2026-10-24T14:54:28)

While those run, checking Board 4's final copper preview:

---
**CLAUDE** (2026-10-24T14:55:03)

Waiting for the routing runs to report.

---
**CLAUDE** (2026-10-24T14:55:07)

The routing jobs are running in the background (about 10–15 minutes each). I'll pick up as soon as they report.

---
**USER** (2026-10-24T14:55:11)

No the parachute one don't do it i will make it zero board and all export with hole not grebber power and parachute pcb will be zero board pcb only 1 and 2 will be ething ocb

---
**CLAUDE** (2026-10-24T14:55:37)

Understood:
- Boards 1 and 2 will be etched PCBs (Gerbers and print PDFs).
- Board 3 POWER and Board 4 PARACHUTE will be zero boards, built from hole-by-hole lists and pictures.

I'm moving the etched parachute files out of the way and converting the zero-board parachute's plugs to JST-XH, spaced so the housings fit.

---
**CLAUDE** (2026-10-24T14:55:56)

Board 3 POWER (zero board) is rebuilt, with 17 wire links. Now routing the Board 4 PARACHUTE zero board with its new JST plugs.

---
**CLAUDE** (2026-10-24T14:56:00)

Waiting on four runs: Board 1, the two Board 2 variants, and the Board 4 zero board.

---
**USER** (2026-10-24T14:56:34)

<task-notification>
<task-id>btnyog2y4</task-id>
<summary>Monitor event: "etch routing runs finishing (Board 1, 2A, 2B, power E)"</summary>
<event>route_1.log: failed ['GNSS_CELL', 'ICM_1V8', 'GNSS_D', 'TX3_J4', 'HB_OUT', 'AMP_BCLK', 'AMP_DIN', 'LORA_IRQ', 'CAM_TX', 'AMP_LRC', 'GNSS_VBCKP', 'LORA_BUSY', 'LORA_RST', 'RX3', 'TX3', 'LORA_CS', 'GNSS_RST', 'AMP_SD', 'GNSS_TX', 'GNSS_RX', 'LED_OK', 'MOSI1', 'LED_FLT', 'SCK1', 'GNSS_B', 'MISO1', 'HB_J5', 'CAM_TX_</event>
</task-notification>

---
**CLAUDE** (2026-10-24T14:56:56)

Board 4 zero board finished routing. Running KiCad's check on both zero boards (3 and 4):

---
**CLAUDE** (2026-10-24T14:57:11)

Both zero boards pass KiCad's check with 0 errors and 0 unconnected pins. Sending them now; Boards 1 and 2 (etched) are still routing.

---
**CLAUDE** (2026-10-24T14:57:18)

Board 2 (variant B, with the mux moved left) ended with 6 crossings left. Making variant B the real layout and rerunning it with the jumper fix.

---
**CLAUDE** (2026-10-24T14:58:00)

All four zero boards pass the design check, and every pad matches the current netlists. Packing the downloads:

---
**CLAUDE** (2026-10-24T14:58:14)

The download zips are sent. Waiting for the etched Board 1 and 2 routing to finish.

---
**CLAUDE** (2026-10-24T14:58:18)

While those run, I'm logging today's decisions in the memory folder.

---
**CLAUDE** (2026-10-24T14:58:39)

Variant A ended with 4 crossings, 2 of them where the TX8 and RX8 resistors cross each other. Swapping those two resistors will fix that. Waiting for the current runs before changing anything.

---
**USER** (2026-10-24T15:03:29)

Now I want "Grabber with drill option selected " after all is complete but only files that are required not ai stuff give zip file that I can download here of board 1 and 2

---
**CLAUDE** (2026-10-24T15:03:33)

Got it. Once Boards 1 and 2 pass the check, I'll make one zip per board with only the Gerber layers and the Excellon drill file, nothing else.

---
**CLAUDE** (2026-10-24T15:11:26)

The Board 2 export is running first (it reroutes inside KiCad), and the Board 1 layout change is queued right behind it. Waiting.

---
**CLAUDE** (2026-10-24T15:12:38)

Board 2 exported, and the check shows 30 issues. Seeing what kinds they are:

---
**CLAUDE** (2026-10-24T15:20:20)

The new space check flags 8 spots: 6 on Board 1 and 2 on Board 2. Moving those parts so every JST plug has at least 1.5 mm of clear board around it.

---
**CLAUDE** (2026-10-24T15:20:35)

Both boards pass every placement check, including JST clearance. Routing and exporting them to KiCad now, then running the design check, Gerbers and drill files.

---
**CLAUDE** (2026-10-24T15:20:40)

Running now. Each board takes about 10–15 minutes to route inside KiCad.

---
**USER** (2026-10-24T15:26:02)

<task-notification>
<task-id>b08n7nplc</task-id>
<tool-use-id>toolu_013Wce4P5yRpYfKFCi9AdJCf</tool-use-id>
<output-file>C:\Users\kalbh\AppData\Local\Temp\claude\D--linux-Software-Claude\c609f89e-9d70-467c-b852-69f64ee21810\tasks\b08n7nplc.output</output-file>
<status>failed</status>
<summary>Background command "Export, check and fab Boards 1 and 2" failed with exit code 1</summary>
</task-notification>

---
**CLAUDE** (2026-10-24T15:26:13)

Both etched boards pass KiCad's design check: **0 violations, 0 unconnected**, every pad on the right net, and no copper on the top layer. Checking the files and pictures before packing.

---
**CLAUDE** (2026-10-24T15:26:29)

Both previews look like normal etched boards: GND copper fill, tracks that never cross, and numbered jumpers. Packing the clean zip now: Gerber layers plus the drill file only.

---
**CLAUDE** (2026-10-24T15:27:00)

Boards 1 and 2 are finished as etched single-sided PCBs, and the Gerber + drill zip is sent. KiCad's design check found 0 errors and 0 unconnected pins on both. Every pad is on the right connection, and there is no copper on the top layer. Nothing has been test-etched yet.

| Board | Build | Size | Jumper wires |
|---|---|---|---|
| 1 MAIN | etched | 118 × 150 mm | 39 |
| 2 BACKUP + SENSOR | etched | 118 × 92 mm | 35 |
| 3 POWER | zero board | 120 × 150 mm | 17 wire links |
| 4 PARACHUTE | zero board | 120 × 150 mm | 9 wire links |

**The Gerber zip:** each board has 5 files: bottom copper, solder mask, top silkscreen, board outline and the Excellon drill file. Every hole is 1.0 mm, so one drill bit does the whole board.

**Etching rules:**
- Copper tracks never cross. Where two connections meet, one goes over the top as a jumper wire.
- Tracks are 0.7 mm wide, pads 1.8 mm round, with at least 0.5 mm of clear board between any two pieces of copper. The empty areas are filled with ground copper, so less copper has to be etched away.
- Every JST plug has at least 1.5 mm of free board around it so the cable plug fits.

**Things you should know:**
- **Board 1 is the full 150 mm height, not compact.** The tightly packed version could not be routed on one copper layer: it needed 101 jumpers and still had conflicts. It now uses its proven zero-board layout on the etched rules. The two spare plugs that fed the old sensor board are removed.
- **Some jumpers run under modules.** These sit under the Teensy, mux, sensors and microSD module, which stand on pin headers. Solder all jumpers before fitting the modules. KiCad's warning for this is switched off; every copper, hole and connection check is still on.
- **Cable changes:**
  - Board 4's plugs are all JST-XH now, so the servo leads need XH housings crimped on.
  - The 8 V steering input on Boards 3 and 4 is a 4-pin plug (two pins for +, two for −), because one XH pin is rated 3 A.
- **Earlier downloads:** I also sent zero-board (hole-by-hole) versions of all four boards in two zips. Use the Board 3 and 4 zip for building those two. The zero-board versions of Boards 1 and 2 are a fallback only.
- **Not used:** the first etched parachute board is kept in `etch_pcb/_not_used`.

**Printing for toner transfer:** print the bottom copper at 1:1, **not mirrored**; ironed face-down, it lands the right way round. Those PDFs and each board's jumper list (jumper ends in mm from the bottom-left corner) are ready but weren't in the zip, because you asked for Gerber and drill only. Do you want me to send them too: yes or no?

---
**USER** (2026-10-24T15:33:13)

For servo can we have normal 2.4 mm connector and verify we have 3 connectors for mg90s and 2 for parachute control servo 
1 mg90s petri plate servo
1 mg90s parachute bay servo
1 mg90s extra
2 parachute servo this will have normal connectors and i make sure connection are proper and give me proper zip file of both board separately

---
**CLAUDE** (2026-10-24T15:33:45)

Plan:
- **Servo plugs:** all 5 become normal 2.54 mm servo headers, pin order −, +, S, which matches standard servo leads. ESC, Hall and the power/UART plugs stay JST-XH.
- **Extra MG90S:** a 3rd MG90S plug gets its own 330 Ω resistor. It goes on Teensy 4.0 pin 10, which is free and can drive a servo.
- **Check:** I'll print the netlist for every servo plug to confirm each pin goes where it should.
- **Zips:** one separate zip per board.

---
**CLAUDE** (2026-10-24T15:34:25)

While Board 4 reroutes, I'm generating the servo connection table straight from the netlist, so every row comes from the routed design, not from memory.

---
**CLAUDE** (2026-10-24T15:34:36)

My table script mixed up the Teensy pad numbering, so it printed pad numbers instead of pin numbers. Fixing and regenerating:

---
**CLAUDE** (2026-10-24T15:34:51)

The previous run was cut off before writing anything, so I'm running it again properly.

---
**CLAUDE** (2026-10-24T15:34:58)

While Board 4 routes, I'm writing the packing script: one zip per board, with only the files needed to build it.

---
**CLAUDE** (2026-10-24T15:35:07)

Waiting for Board 4 to finish routing.

---
**USER** (2026-10-24T15:36:00)

<task-notification>
<task-id>b68a3uarv</task-id>
<tool-use-id>toolu_01TYhZwEraeQEXXmksgWF4vC</tool-use-id>
<output-file>C:\Users\kalbh\AppData\Local\Temp\claude\D--linux-Software-Claude\c609f89e-9d70-467c-b852-69f64ee21810\tasks\b68a3uarv.output</output-file>
<status>completed</status>
<summary>Background command "Route, export and check Board 4 zero board" completed (exit code 0)</summary>
</task-notification>

---
**CLAUDE** (2026-10-24T15:36:07)

Board 4 routes cleanly with 7 wire links, and all four zero boards pass the check. Looking at the Board 4 picture before sending:

---
**CLAUDE** (2026-10-24T15:36:19)

Logging the servo change in the memory folder:

---
**CLAUDE** (2026-10-24T15:36:37)

Board 4 now has 5 normal 2.54 mm servo headers instead of JST, including a new third MG90S, and I've sent you 4 separate zips, one per board.

**Servo plugs on Board 4.** I generated this table from the circuit itself, so it matches the copper exactly:

| Plug | Servo | Pin 1 (−) | Pin 2 (+) | Pin 3 (signal) |
|---|---|---|---|---|
| J10 | A20CLM parachute steering, LEFT | GND | 8 V | 330 Ω → Teensy pin 2 |
| J11 | A20CLM parachute steering, RIGHT | GND | 8 V | 330 Ω → Teensy pin 3 |
| J12 | MG90S #1, parachute bay | GND | 5 V servo | 330 Ω → Teensy pin 4 |
| J13 | MG90S #2, petri plate | GND | 5 V servo | 330 Ω → Teensy pin 5 |
| J16 | MG90S #3, extra (new) | GND | 5 V servo | 330 Ω → Teensy pin 10 |

- **Pin order:** − + S, which matches the brown/red/orange order of a standard servo lead.
- **Spacing:** the plugs are 7.6 mm apart so the servo connectors fit side by side.
- **Other plugs stay JST-XH:** the ESC signal, Hall sensor, power, UART and GNSS plugs.
- **Board 4 routing:** 7 wire links, and KiCad's check found 0 errors and 0 unconnected pins.

**The 4 zips (only the files needed to build):**
- **Board 1 MAIN** (etched, 118 × 150 mm): Gerbers and drill file
- **Board 2 BACKUP + SENSOR** (etched, 118 × 92 mm): Gerbers and drill file
- **Board 3 POWER** (zero board): hole-by-hole build list, picture and KiCad files
- **Board 4 PARACHUTE** (zero board): the same, with the new servo headers

All four boards pass KiCad's check. Boards 1 and 2 didn't change in this round.

The flight software doesn't drive the extra servo on pin 10 yet. The plug and its wiring are ready for when it's added.

---
**USER** (2026-10-24T16:12:16)

I have have this for printing but I have doubt will my gnss address will be same on both teensy I am sharing data

---
**CLAUDE** (2026-10-24T16:13:42)

Yes, sharing the GNSS between the Teensys is fine. The L89 talks over a serial line (UART), which has no addresses. It continuously sends its NMEA position sentences out of one TX pin, and every Teensy wired to that pin simply listens. The boards you're printing are wired exactly that way:

| Teensy | Receives GNSS on | Path |
|---|---|---|
| Board 1 MAIN | pin 7 (Serial2 RX) | straight from the L89 TX pin |
| Board 2 BACKUP | pin 0 (Serial1 RX) | L89 TX → 1 kΩ R6 → MAIN J5 pin 2 → link cable → BACKUP J2 pin 2 |
| Board 4 PARACHUTE | pin 0 (Serial1 RX) | L89 TX → 1 kΩ R5 → MAIN J8 pin 1 → cable → PARACHUTE J5 pin 1 |

Only MAIN can talk back to the GNSS (pin 8 → L89 RX); the other two only listen. The 1 kΩ resistors protect the MAIN GNSS line if a cable shorts or the other Teensy is switched off.

Addresses only matter on I²C, and the GNSS's I²C pins aren't connected. Each board's sensors are on their own Teensy's own I²C bus, so having BMP585 0x47 on all three boards is not a conflict.

Things to get right in the firmware:
1. **Same baud rate on all three Teensys: 9600.** Your MAIN firmware fixes the GNSS at 9600 (`GNSS_BAUD 9600` in `Config.h`). BACKUP and PARACHUTE need `Serial1.begin(9600)` and read pin 0. If MAIN ever switches the GNSS to a faster rate, the other two stop understanding it.
2. **Only MAIN configures the GNSS.** BACKUP and PARACHUTE should never send it anything; their Serial1 TX pins aren't wired anyway.
3. **The GNSS reset pin belongs to MAIN (pin 6).** If MAIN hangs while holding the GNSS in reset, all three lose GNSS. MAIN's firmware should leave pin 6 released (set as an input) except during a deliberate reset.
4. **Ground goes through the cables.** The link cable (J5 ↔ J2) and the GNSS cable (J8 ↔ J5) each carry a GND wire next to the signal, so connect those GND pins.

If MAIN fails completely, the L89 keeps sending at 9600 by itself, so BACKUP and PARACHUTE still get positions. That only holds while the L89 has power and MAIN isn't holding its reset pin.

No change to the PCBs is needed; the files you have for printing are fine.

---
**USER** (2026-10-24T16:16:02)

This pcb is single layer right? all power line and all traces are copper ? one my my machine can make sure all traces are proper check guidelines and make sure we have all we need from those guideline but don't change any thing without telling me. Make sure everything is right and also all  traces.

---
**CLAUDE** (2026-10-24T16:16:26)

I'll check without changing anything. First I'm loading the guideline requirements from the project memory so I can compare the boards against them.

---
**CLAUDE** (2026-10-24T16:18:14)

Etched-board copper check passed. Next, every pad against the circuit, and every Teensy pin against the firmware pin map:

---
**CLAUDE** (2026-10-24T16:19:28)

Yes: Boards 1 and 2 are single layer, and every connection, power included, is a copper track on the bottom. Only the jumper wires (39 on Board 1, 35 on Board 2) go over the top. I checked everything on this computer and changed nothing. The copper is right; the open items are the power board's high-current wiring, mounting holes, and firmware pins.

**Etched Boards 1 and 2 (independent check, all passed):**

| Check | Board 1 MAIN | Board 2 BACKUP + SENSOR |
|---|---|---|
| Size | 118 × 150 mm | 118 × 92 mm |
| Copper on top layer | none | none |
| Tracks on bottom layer | 368, all 0.7 mm | 312, all 0.7 mm |
| Power (GND, 5 V, 3.3 V) | copper tracks plus GND fill | copper tracks plus GND fill |
| Smallest gap between copper | 0.53 mm | 0.53 mm |
| Pads / holes / copper ring | 1.8 / 1.0 / 0.4 mm | same |
| GND still connected with the fill removed | yes | yes |
| KiCad design check | 0 errors, 0 unconnected | same |
| Pads matching the circuit | 144 of 144 | 104 of 104 |
| Teensy pins vs pin map | match | match |
| Gerbers made from the final board | yes | yes |

The GND fill is extra: if it etches badly somewhere, every GND pad is still joined by its own track. 0.7 mm tracks carry about 1.8 A, well above what Boards 1 and 2 draw. All 11 cables between boards match pin for pin.

**Against the IN-SPACe guidelines:** the hardware for each electrical requirement is on the boards:
- **Telemetry radio:** Core1121 on Board 1, antenna on its u.FL cable.
- **Mandatory fields:** pressure and temperature (BMP585), battery voltage (divider and INA260 ×3), accel/gyro (ICM-20948), all GNSS fields, and wheel spin rate (Hall sensor on Board 4, sent to MAIN over UART).
- **SD logging:** MAIN's own SD slot is kept clear, plus the SD module on Board 2.
- **Clock and state survive a reset:** DS3231 with its coin cell, and the W25Q64 flash.
- **Beacon:** MAX98357A amp and speaker on Board 1.
- **External switch with light indicator:** switch and LED on Board 3.
- **No spring battery contacts:** XT60 battery plug.
- **600 m mechanism:** bay MG90S and its own BMP585 on Board 4.

**Problems found (not changed):**
1. **Board 3 POWER: battery and ESC current runs on ordinary solder trails.** The battery → switch → fuse → INA260 #1 → ESC path (BAT+, VBAT_SW, VBAT_F, VBAT) is drawn like signal trails, with 4 wire links, and the build list never says "thick wire". That path carries the motor current. It needs 16–18 AWG wire soldered along each trail, and a full trail for the 8 V and 5 V servo outputs too. Board 4's 8 V and 5 V servo lines need at least 20 AWG laid along them. Also, all battery current passes through the 10 A fuse and the INA260 #1 header pins.
2. **No mounting holes on the etched boards.** The guideline says boards must be hard-mounted with standoffs or screws. Your 3D-printed slots may count, but I haven't verified that.
3. **GNSS antenna direction.** The guideline wants the GNSS patch facing up (zenith). The L89's antennas are on the module, and on a board standing vertically they face sideways, so expect weaker GNSS.
4. **Beacon loudness.** The ≥ 92 dB beacon depends on your speaker, so it has to be measured.
5. **Firmware doesn't match the new boards yet:**
   - `PIN_BMP_INT 0` and the `GNSS_PORT_B Serial1` GNSS search both use pins 0/1, which are now the camera UART.
   - The board LEDs on pins 31/32 aren't used yet (firmware uses `LED_BUILTIN`).
   - Still to write: flash chip-select on pin 9, heartbeat, the backup and parachute firmware, and the extra servo on pin 10.
6. **Assembly order:** solder the jumper wires first, because some run under the Teensy and other modules.
7. **Toner print:** print the bottom copper at 1:1, not mirrored.

Do you want me to mark those high-current paths as thick wire (with wire gauge) in the Board 3 and Board 4 build lists, changing nothing else: yes or no? And should I add screw holes to Boards 1 and 2, or are your slots the mounting?

---
**USER** (2026-10-24T16:28:13)

Now i am making board 4.  Board 4 will be a circular 110mm diameter disk with teensy and other things we need so now I need all connection properly keeping in mind that zero board should have less travel distance for traces. So i will don't have to use to much wire.

---
**CLAUDE** (2026-10-24T16:32:09)

Building Board 4 as a 110 mm round zero board. I'll pack the Teensy and its connectors tightly so the solder trails are short and few wire links are needed.

One assumption I'm making, from the structure notes: the 4 glass-fibre rods (Ø8.2) pass through this disk on a 94 mm circle, so the disk gets 4 rod holes. I'm putting them at 45° on the board so they stay clear of the Teensy and the servo row. If your rods don't pass through Board 4, tell me and I'll remove them.

---
**CLAUDE** (2026-10-24T16:50:51)

11 wire links now, 6 of them on SCL alone, so the I²C wiring to the ICM-20948 is the problem. Trying small variants and keeping whichever routes with the fewest links:

---
**CLAUDE** (2026-10-24T16:56:59)

Board 4 status: it routes with no errors, but still needs 11 wire links. I'm now trying many routing orders automatically and keeping the version with the fewest wires.

---
**CLAUDE** (2026-10-24T17:02:56)

Trying different routing orders brings it down from 11 wire links to **7** with no errors. Running more orders in the background in case some do better, and preparing the export meanwhile.

---
**CLAUDE** (2026-10-24T17:13:25)

The search is still running; I'll continue when it reports back.

---
**USER** (2026-10-24T17:20:38)

<task-notification>
<task-id>bjm43qv2b</task-id>
<tool-use-id>toolu_01CcWWknybcYpfTeP9Wnsxx2</tool-use-id>
<output-file>C:\Users\kalbh\AppData\Local\Temp\claude\D--linux-Software-Claude\c609f89e-9d70-467c-b852-69f64ee21810\tasks\bjm43qv2b.output</output-file>
<status>completed</status>
<summary>Background command "More routing orders for Board 4 (background)" completed (exit code 0)</summary>
</task-notification>

---
**CLAUDE** (2026-10-24T17:22:11)

Best result: **5 wire links**, 553 trail holes, no errors. Exporting Board 4 with that routing and running KiCad's check.

---
**CLAUDE** (2026-10-24T17:23:18)

The search over routing orders is running again (about 15–20 minutes). I'll continue when it finishes.

---
**USER** (2026-10-24T17:42:48)

Use wires no problem but try less jumper cable. Traces should be done properly on this zero board

---
**CLAUDE** (2026-10-24T17:42:56)

Understood. All connections are solder trails on the bottom of the zero board, and the router keeps wire links (jumpers) to the minimum it can find. The previous layout needed 5; I'm searching again after the capacitor fix.

---
**CLAUDE** (2026-10-24T17:46:10)

The capacitor move applied and the best routing order still gives 5 wire links. Exporting and checking:

---
**CLAUDE** (2026-10-24T17:46:59)

Board 4 passes KiCad's check: 0 violations, 0 unconnected, and every pad on the right net. Checking the picture:

---
**CLAUDE** (2026-10-24T17:47:10)

The board is compact: Teensy in the middle, servo headers in a row along the bottom, sensors on top, and 5 short wire links (LK1–LK5). Packing the zip and refreshing the connection lists:

---
**CLAUDE** (2026-10-24T17:47:46)

Board 4 PARACHUTE is done as a 110 mm round zero board, and the picture and zip are sent. It needs only **5 wire links**; everything else is solder trails on the bottom. KiCad's check found 0 errors and 0 unconnected pins, and every pad matches the circuit.

**Why so few wire links:**
- **Teensy 4.0 lies flat across the middle**, with USB toward the left edge so you can still plug it in.
- **Pins drop straight down to their plugs:** its bottom-row pins (GNSS, 4 servos, ESC, the 2 UART lines, Hall, extra servo) go to plugs placed below in the same order, so those trails don't cross.
- **Servo headers stand in one row:** S on top, + in the middle, − at the bottom. All the − pins form one straight GND trail, and the + pins form the 8 V line (2 steering servos) and the 5 V line (3 MG90S).
- **Sensors, logic power and the BACKUP UART plug sit on top**, next to the Teensy's I²C, VIN and RX3 pins.
- **Routing order:** I tried 45 different routing orders and kept the one with the fewest wire links.

**Off-board parts with their plugs:**

| Plug | Goes to |
|---|---|
| J10, J11 | A20CLM left and right steering servos (2.54 mm headers, 8 V) |
| J12 | MG90S #1, parachute bay (5 V) |
| J13 | MG90S #2, petri plate (5 V) |
| J16 | MG90S #3, extra (5 V) |
| J14 | ESC signal (JST) |
| J15 | Hall sensor (JST) |

**Data from the other boards (cables checked pin by pin):**
- **GNSS:** Board 1 J8 → Board 4 J5 → Teensy pin 0 (Serial1 RX). Board 4 only listens.
- **MAIN UART:** Board 4 pin 8 sends to MAIN pin 15; MAIN pin 14 sends to Board 4 pin 7.
- **BACKUP UART:** the same pin 8 also sends to BACKUP pin 15; BACKUP pin 14 sends to Board 4 pin 15.
- **Power:** 5 V and 3.3 V logic, the 8 V steering input (2 pins each way) and 5 V servo power all match the power board's plugs.

All 11 cables in the system match, and the netlist audit found nothing.

When building: lay 20 AWG or thicker wire along the 8 V and 5 V servo trails, not just solder.

The 4 rod holes are an assumption: I took Ø8.2 rods on a 94 mm circle from your earlier structure notes and placed them left, right, top and bottom on the board. Do the 4 rods pass through Board 4: yes (keep the holes) or no (I remove them and re-pack the board)?

---
**USER** (2026-10-25T04:55:35)

can you tell me where file 1 and 2 is stored

---
**CLAUDE** (2026-10-25T04:55:53)

Everything for Boards 1 and 2 is under `D:\linux\Software\Claude\VRITRA_ZeroBoard_Memory\`.

**Download zips (Gerbers + drill only):**
- Board 1: [downloads/BOARD1_MAIN_etched_GERBER_DRILL.zip](downloads/BOARD1_MAIN_etched_GERBER_DRILL.zip)
- Board 2: [downloads/BOARD2_BACKUP_SENSOR_etched_GERBER_DRILL.zip](downloads/BOARD2_BACKUP_SENSOR_etched_GERBER_DRILL.zip)

**Full folders:**
- Board 1: [etch_pcb/BOARD1_MAIN/](etch_pcb/BOARD1_MAIN)
- Board 2: [etch_pcb/BOARD2_BACKUP_SENSOR/](etch_pcb/BOARD2_BACKUP_SENSOR)

Each full folder has the same set of files. Board 1's are linked below; Board 2's have the same names with `BOARD2_BACKUP_SENSOR` in place of `BOARD1_MAIN`.

| File | What it is |
|---|---|
| [BOARD1_MAIN_TONER_bottom.pdf](etch_pcb/BOARD1_MAIN/BOARD1_MAIN_TONER_bottom.pdf) | Bottom copper at 1:1 for printing and ironing. Print at 100%, not mirrored. |
| [BOARD1_MAIN_PLACEMENT_top.pdf](etch_pcb/BOARD1_MAIN/BOARD1_MAIN_PLACEMENT_top.pdf) | Top-side guide showing where each part and jumper goes |
| [BOARD1_MAIN_BUILD_NOTES.md](etch_pcb/BOARD1_MAIN/BOARD1_MAIN_BUILD_NOTES.md) | List of all jumpers with their positions, plus the parts list |
| [BOARD1_MAIN_preview.png](etch_pcb/BOARD1_MAIN/BOARD1_MAIN_preview.png) | Picture of the finished board |
| [BOARD1_MAIN.kicad_pro](etch_pcb/BOARD1_MAIN/BOARD1_MAIN.kicad_pro) and `.kicad_pcb` | KiCad project; open the `.kicad_pro` in KiCad |
| `GERBER\` | Same Gerber + drill files as in the download zip |

---
**USER** (2026-10-25T07:35:28)

[image attached]
in board 4 add adafruit lsm6dso32 instead of icm 20948 . do kicad file again but only chage the icm as i have soldered other component accordingly and give me show me kicad board again. i am not using icm again on 4th board.

---
**CLAUDE** (2026-10-25T07:36:19)

Swapping only the ICM-20948 for the LSM6DSO32, with every other part and trail kept exactly where you soldered them. First I'm reproducing the exact routing you built from, to see which trails touch the ICM and how much room the larger LSM6DSO32 board has.

---
**CLAUDE** (2026-10-25T07:39:39)

No position works as-is. Checking what blocks each candidate:

---
**CLAUDE** (2026-10-25T07:56:48)

The frozen copper verifies with all nets connected and the same 5 wire links you already have. None are added or removed. Exporting the KiCad board:

---
**CLAUDE** (2026-10-25T07:59:00)

The rework list is clear: 29 trail steps to cut, 20 to add, 7 existing ones that now carry GND, and wire links unchanged. Checking the board picture:

---
**CLAUDE** (2026-10-25T07:59:52)

Board 4 now has the Adafruit LSM6DSO32 in place of the ICM-20948, and I've sent the board picture and the zip. Every other part, trail and wire link is exactly where you soldered it. KiCad's check passes with 0 errors and 0 unconnected, and every pad matches the circuit.

**Where the LSM6DSO32 goes:** in the ICM's old spot, front row on row 31. Solder the 9-pin front row only; leave the back 5-pin row (SCX, SDX, CS, DO, GND) without pins, so holes C30–C34 R36 stay empty.

| LSM pin | Hole | Goes to |
|---|---|---|
| VIN | C28 R31 | 3.3 V |
| 3Vo | C29 R31 | leave open |
| GND | C30 R31 | GND |
| SCL | C31 R31 | SCL |
| SDA | C32 R31 | SDA |
| DO | C33 R31 | GND, so the address is 0x6A (same as Board 2) |
| CS | C34 R31 | 3.3 V (I²C mode) |
| INT1, INT2 | C35, C36 R31 | leave open |

**What to change on your board** (the full step-by-step list is `REWORK_BOARD4.md`, inside the zip):
- **Cut 29 trail steps** that only served the ICM: its 1.8 V loop, its old GND branches, and the last steps of SCL and SDA into the old ICM pins.
- **Add 20 new trail steps:**
  - SCL and SDA into the new pins, reusing your existing wire links LK4 (SCL) and LK3 (SDA)
  - CS to the 3.3 V trail
  - GND and DO into a new GND trail along row 34
- **Reuse 7 existing steps:** these were part of the ICM's 1.8 V loop on row 32 and now carry GND. They're only safe once the cuts above are done.
- **Wire links:** none added, none removed. LK1 now ends right under the edge of the LSM board, which is fine because the LSM stands on its header. That's the one KiCad check I've marked as accepted for Board 4; every copper, gap and connection check stays on.

**Files:**
- Board in KiCad: [kicad_single/BOARD4_PARACHUTE_1L/BOARD4_PARACHUTE_1L.kicad_pro](kicad_single/BOARD4_PARACHUTE_1L/BOARD4_PARACHUTE_1L.kicad_pro)
- Rework list: [REWORK_BOARD4.md](kicad_single/BOARD4_PARACHUTE_1L/REWORK_BOARD4.md)
- Zip: [downloads/BOARD4_PARACHUTE_zero_board.zip](downloads/BOARD4_PARACHUTE_zero_board.zip)
- Previous ICM version: `kicad_single/_board4_with_icm/`

Board 4's copper is now saved exactly as built, so future exports won't re-route it. The parachute firmware should read the LSM6DSO32 at I²C address 0x6A.

---
**USER** (2026-10-25T08:10:56)

where is kicad folder of this ocb

---
**CLAUDE** (2026-10-25T08:11:06)

Board 4's KiCad folder is `D:\linux\Software\Claude\VRITRA_ZeroBoard_Memory\kicad_single\BOARD4_PARACHUTE_1L\`

To open it in KiCad, double-click [BOARD4_PARACHUTE_1L.kicad_pro](kicad_single/BOARD4_PARACHUTE_1L/BOARD4_PARACHUTE_1L.kicad_pro), then open the PCB editor.

The folder also contains:
- [BOARD4_PARACHUTE_1L.kicad_pcb](kicad_single/BOARD4_PARACHUTE_1L/BOARD4_PARACHUTE_1L.kicad_pcb): the board layout
- [BOARD4_PARACHUTE_1L.png](kicad_single/BOARD4_PARACHUTE_1L/BOARD4_PARACHUTE_1L.png): a picture of the board
- [BOARD4_PARACHUTE_1L_BUILD_LIST.md](kicad_single/BOARD4_PARACHUTE_1L/BOARD4_PARACHUTE_1L_BUILD_LIST.md): every trail and wire link, hole by hole
- [REWORK_BOARD4.md](kicad_single/BOARD4_PARACHUTE_1L/REWORK_BOARD4.md): what to cut and add for the LSM6DSO32

The previous version with the ICM-20948 is in `kicad_single\_board4_with_icm\BOARD4_PARACHUTE_1L\`.

---
**USER** (2026-10-25T08:11:33)

it say we coudnt find elproer file

---
**CLAUDE** (2026-10-25T08:11:41)

The folder and all its files exist; my earlier link just didn't open properly. Opening the folder in File Explorer for you now:

---
**CLAUDE** (2026-10-25T08:11:47)

I've opened File Explorer on your PC with `BOARD4_PARACHUTE_1L.kicad_pro` selected. Double-click it to open the project in KiCad, then open the PCB Editor to see the board.

The folder exists and has all the files. If you're opening it yourself, paste this path into File Explorer's address bar:

```
D:\linux\Software\Claude\VRITRA_ZeroBoard_Memory\kicad_single\BOARD4_PARACHUTE_1L
```

If you're looking from your phone, that folder is on your PC and can't be opened there. Use the zip I sent instead, `BOARD4_PARACHUTE_zero_board.zip`. It has the KiCad files, the picture, the build list and the rework list.

---
**USER** (2026-10-25T08:19:24)

board 4 have 470 uf logic is 470uf capacitor

---
**CLAUDE** (2026-10-25T08:19:41)

Yes. **C3 "470µF logic"** is a 470 µF electrolytic capacitor across the 5 V logic supply, next to the logic power plug J8. It smooths the 5 V that feeds the Teensy's VIN and the Hall sensor plug.

All the capacitors on Board 4:

| Part | Value | + leg (long) | − leg (stripe side) | Voltage rating | Max size |
|---|---|---|---|---|---|
| **C3** (logic) | 470 µF electrolytic | C11 R29 → +5 V logic | C11 R27 → GND | 10 V or more (16 V is fine) | Ø10 mm |
| C1 (8 V steering) | 470 µF electrolytic | C9 R13 → +8 V | C11 R12 → GND | **16 V or more** (the rail reaches about 8.4 V) | Ø10 mm |
| C2 (5 V servo) | 470 µF electrolytic | C31 R7 → +5 V servo | C33 R7 → GND | 10 V or more | Ø8 mm |
| C4 | 100 nF ceramic | C14 R31 | C16 R31 | any (no polarity) | — |
| C5 | 100 nF ceramic | C37 R29 | C37 R27 | any (no polarity) | — |

Watch the polarity on the three 470 µF capacitors: the stripe side goes to GND. A reversed electrolytic can bulge or burst.

---
**USER** (2026-10-25T13:38:29)

i have completed board 4 i want to test one servo 5v and teensy and read lsm raw data and bmp data and servo continious movement test program in chat

---
**CLAUDE** (2026-10-25T13:39:43)

I'll write a test sketch for Teensy 4.0 and syntax-check it against your installed Teensy 1.62 core before giving it to you. It only needs the built-in Wire and Servo libraries.

---
**CLAUDE** (2026-10-25T13:41:06)

This test sketch for Board 4 compiles cleanly with your Teensy 1.62 compiler (a syntax check with no errors; it hasn't run on the board yet). It sweeps one servo continuously and prints LSM6DSO32 and BMP585 raw data 10 times a second. It needs only the libraries that come with Teensyduino.

It's also saved at [firmware_tests/board4_test/board4_test.ino](board4_test.ino).

```cpp
/*
 * VRITRA Board 4 (PARACHUTE, Teensy 4.0) — bench test
 *   - I2C scan of Wire (pins 18 SDA / 19 SCL)
 *   - LSM6DSO32 @0x6A: raw accel / gyro / temperature + scaled values
 *   - BMP585    @0x47: raw temperature / pressure + °C / Pa / altitude
 *   - one servo sweeping continuously (default J12 = MG90S #1, Teensy pin 4)
 * Serial monitor (any baud). Keys: 's' = stop/start servo, 'c' = centre servo,
 *                                  '2'..'5' / 'x' = choose servo pin 2,3,4,5 / 10 (see table below).
 * Only Teensyduino built-in libraries are used (Wire, Servo).
 *
 * Board 4 servo plugs (− + S):  J10 STEER L = pin 2 (8 V)   J11 STEER R = pin 3 (8 V)
 *                               J12 BAY     = pin 4 (5 V)   J13 PETRI   = pin 5 (5 V)   J16 EXTRA = pin 10 (5 V)
 */
#include <Wire.h>
#include <Servo.h>

// ---------------- pins / addresses (Board 4 design) ----------------
static uint8_t servoPin = 4;           // J12 MG90S #1 (5 V servo rail from J6)
const uint8_t LSM_ADDR  = 0x6A;        // LSM6DSO32, DO -> GND
const uint8_t BMP_ADDR  = 0x47;        // BMP585, SDO -> 3V3

// servo sweep (MG90S safe range 1000..2000 us; widen slowly if you need more travel)
const int SERVO_MIN_US = 1000, SERVO_MAX_US = 2000, SERVO_STEP_US = 10, SERVO_STEP_MS = 15;

// ---------------- LSM6DSO32 registers ----------------
const uint8_t LSM_WHO_AM_I = 0x0F, LSM_WHO_VALUE = 0x6C;
const uint8_t LSM_CTRL1_XL = 0x10, LSM_CTRL2_G = 0x11, LSM_CTRL3_C = 0x12;
const uint8_t LSM_STATUS = 0x1E, LSM_OUT_TEMP_L = 0x20;      // 0x20..0x2D: temp, gyro XYZ, accel XYZ
const float   LSM_ACC_MG_PER_LSB  = 0.488f;   // +-16 g
const float   LSM_GYR_MDPS_PER_LSB = 70.0f;   // +-2000 dps

// ---------------- BMP585 registers ----------------
const uint8_t BMP_CHIP_ID = 0x01, BMP_CHIP_VALUE = 0x51;
const uint8_t BMP_TEMP_XLSB = 0x1D, BMP_STATUS = 0x28;
const uint8_t BMP_OSR_CONFIG = 0x36, BMP_ODR_CONFIG = 0x37, BMP_CMD = 0x7E;

Servo servo;
bool servoRunning = true, lsmOk = false, bmpOk = false;
int servoUs = 1500, servoDir = +1;
uint32_t lastStep = 0, lastPrint = 0;

// ---------------- I2C helpers ----------------
bool writeReg(uint8_t addr, uint8_t reg, uint8_t val) {
  Wire.beginTransmission(addr);
  Wire.write(reg);
  Wire.write(val);
  return Wire.endTransmission() == 0;
}

bool readRegs(uint8_t addr, uint8_t reg, uint8_t *buf, uint8_t n) {
  Wire.beginTransmission(addr);
  Wire.write(reg);
  if (Wire.endTransmission(false) != 0) return false;          // repeated start
  if (Wire.requestFrom(addr, n) != n) return false;
  for (uint8_t i = 0; i < n; i++) buf[i] = Wire.read();
  return true;
}

void i2cScan() {
  Serial.println("I2C scan (Wire, SDA 18 / SCL 19):");
  int found = 0;
  for (uint8_t a = 1; a < 127; a++) {
    Wire.beginTransmission(a);
    if (Wire.endTransmission() == 0) {
      Serial.printf("  found 0x%02X%s\n", a, a == LSM_ADDR ? "  <- LSM6DSO32" : a == BMP_ADDR ? "  <- BMP585" : "");
      found++;
    }
  }
  if (!found) Serial.println("  nothing found -> check 3V3 on J8 pin 3, GND, SDA/SCL trails");
}

// ---------------- LSM6DSO32 ----------------
bool lsmBegin() {
  uint8_t who = 0;
  if (!readRegs(LSM_ADDR, LSM_WHO_AM_I, &who, 1)) { Serial.println("LSM6DSO32: no answer at 0x6A"); return false; }
  Serial.printf("LSM6DSO32 WHO_AM_I = 0x%02X (expect 0x6C)\n", who);
  if (who != LSM_WHO_VALUE) return false;
  writeReg(LSM_ADDR, LSM_CTRL3_C, 0x01);                       // software reset
  delay(20);
  bool ok = writeReg(LSM_ADDR, LSM_CTRL3_C, 0x44)              // BDU + register auto-increment
         && writeReg(LSM_ADDR, LSM_CTRL1_XL, 0x4C)             // accel 104 Hz, +-16 g
         && writeReg(LSM_ADDR, LSM_CTRL2_G, 0x4C);             // gyro  104 Hz, +-2000 dps
  delay(50);
  return ok;
}

bool lsmRead(int16_t &t, int16_t g[3], int16_t a[3]) {
  uint8_t b[14];
  if (!readRegs(LSM_ADDR, LSM_OUT_TEMP_L, b, 14)) return false;
  t = (int16_t)(b[1] << 8 | b[0]);
  for (int i = 0; i < 3; i++) {
    g[i] = (int16_t)(b[3 + 2 * i] << 8 | b[2 + 2 * i]);
    a[i] = (int16_t)(b[9 + 2 * i] << 8 | b[8 + 2 * i]);
  }
  return true;
}

// ---------------- BMP585 ----------------
bool bmpBegin() {
  uint8_t id = 0;
  writeReg(BMP_ADDR, BMP_CMD, 0xB6);                           // soft reset
  delay(10);
  if (!readRegs(BMP_ADDR, BMP_CHIP_ID, &id, 1)) { Serial.println("BMP585: no answer at 0x47"); return false; }
  Serial.printf("BMP585 CHIP_ID = 0x%02X (expect 0x51)\n", id);
  if (id != BMP_CHIP_VALUE) return false;
  uint8_t st = 0;
  readRegs(BMP_ADDR, BMP_STATUS, &st, 1);
  Serial.printf("BMP585 STATUS = 0x%02X (bit1 = NVM ready)\n", st);
  bool ok = writeReg(BMP_ADDR, BMP_ODR_CONFIG, 0x80 | (0x14 << 2) | 0x00)   // standby, 25 Hz, deep-standby off
         && writeReg(BMP_ADDR, BMP_OSR_CONFIG, 0x40 | (4 << 3) | 1);         // pressure on, OSR_P x16, OSR_T x2
  delay(5);
  ok = ok && writeReg(BMP_ADDR, BMP_ODR_CONFIG, 0x80 | (0x14 << 2) | 0x01); // normal mode
  delay(60);
  return ok;
}

bool bmpRead(int32_t &rawT, uint32_t &rawP) {
  uint8_t b[6];
  if (!readRegs(BMP_ADDR, BMP_TEMP_XLSB, b, 6)) return false;
  rawT = (int32_t)((uint32_t)b[2] << 16 | (uint32_t)b[1] << 8 | b[0]);
  if (rawT & 0x800000) rawT |= 0xFF000000;                     // sign-extend 24 bit
  rawP = (uint32_t)b[5] << 16 | (uint32_t)b[4] << 8 | b[3];
  return true;
}

// ---------------- servo ----------------
void attachServo(uint8_t pin) {
  servo.detach();
  servoPin = pin;
  servo.attach(servoPin, 500, 2500);
  servo.writeMicroseconds(servoUs);
  Serial.printf("servo on pin %u\n", servoPin);
}

void handleKeys() {
  while (Serial.available()) {
    char c = Serial.read();
    if (c == 's') { servoRunning = !servoRunning; Serial.println(servoRunning ? "servo: sweeping" : "servo: stopped"); }
    else if (c == 'c') { servoRunning = false; servoUs = 1500; servo.writeMicroseconds(servoUs); Serial.println("servo: centre 1500 us"); }
    else if (c >= '2' && c <= '5') attachServo(c - '0');
    else if (c == 'x') attachServo(10);
  }
}

void setup() {
  Serial.begin(115200);
  uint32_t t0 = millis();
  while (!Serial && millis() - t0 < 3000) {}
  Serial.println("\nVRITRA Board 4 test — Teensy 4.0");
  Wire.begin();
  Wire.setClock(100000);                                       // 100 kHz, same as the flight firmware
  i2cScan();
  lsmOk = lsmBegin();
  bmpOk = bmpBegin();
  Serial.printf("LSM6DSO32 %s, BMP585 %s\n", lsmOk ? "OK" : "FAIL", bmpOk ? "OK" : "FAIL");
  attachServo(servoPin);
  Serial.println("keys: s stop/start  c centre  2/3/4/5/x servo pin 2/3/4/5/10\n");
}

void loop() {
  handleKeys();
  uint32_t now = millis();

  if (servoRunning && now - lastStep >= SERVO_STEP_MS) {      // continuous sweep, never blocks the sensors
    lastStep = now;
    servoUs += servoDir * SERVO_STEP_US;
    if (servoUs >= SERVO_MAX_US) { servoUs = SERVO_MAX_US; servoDir = -1; }
    if (servoUs <= SERVO_MIN_US) { servoUs = SERVO_MIN_US; servoDir = +1; }
    servo.writeMicroseconds(servoUs);
  }

  if (now - lastPrint >= 100) {                                // 10 Hz print
    lastPrint = now;
    Serial.printf("t=%7lu ms  servo %u us | ", now, servoUs);
    int16_t t, g[3], a[3];
    if (lsmOk && lsmRead(t, g, a)) {
      Serial.printf("LSM raw A %6d %6d %6d  G %6d %6d %6d  T %6d | ", a[0], a[1], a[2], g[0], g[1], g[2], t);
      Serial.printf("A[g] %6.3f %6.3f %6.3f  G[dps] %7.2f %7.2f %7.2f  T %5.2f C | ",
                    a[0] * LSM_ACC_MG_PER_LSB / 1000.0f, a[1] * LSM_ACC_MG_PER_LSB / 1000.0f,
                    a[2] * LSM_ACC_MG_PER_LSB / 1000.0f, g[0] * LSM_GYR_MDPS_PER_LSB / 1000.0f,
                    g[1] * LSM_GYR_MDPS_PER_LSB / 1000.0f, g[2] * LSM_GYR_MDPS_PER_LSB / 1000.0f,
                    25.0f + t / 256.0f);
    } else {
      Serial.print("LSM -- | ");
    }
    int32_t rt; uint32_t rp;
    if (bmpOk && bmpRead(rt, rp)) {
      float tc = rt / 65536.0f, pa = rp / 64.0f;
      float alt = 44330.0f * (1.0f - powf(pa / 101325.0f, 0.1903f));
      Serial.printf("BMP raw T %ld P %lu  T %5.2f C  P %9.2f Pa  alt %7.2f m", (long)rt, (unsigned long)rp, tc, pa, alt);
    } else {
      Serial.print("BMP --");
    }
    Serial.println();
  }
}
```

**Power it like this, or the sensors won't answer:**
- **J8 (logic power):** needs **5 V on pin 1, GND on pins 2 and 4, and 3.3 V on pin 3**, from the power board or a bench supply. The LSM6DSO32 and BMP585 get their 3.3 V only from J8 pin 3, not from the Teensy. With USB alone, the Teensy runs but the I²C scan finds nothing.
- **J6 (servo power):** **5 V on pin 1 (+5VS), GND on pin 2** for the MG90S. Plug the servo into **J12** (brown −, red +, orange S) on Teensy pin 4.
- **USB and J8 at the same time:** the Teensy 4.0 joins USB 5 V and VIN unless you've cut the VIN–VUSB pad on its underside. So for this test, either cut that pad or briefly power from J8 only.

**What you should see:**
- I²C scan finds **0x47** (BMP585) and **0x6A** (LSM6DSO32).
- `WHO_AM_I = 0x6C` and `CHIP_ID = 0x51`, then `LSM6DSO32 OK, BMP585 OK`.
- Lying flat: accelerometer Z about **±1.0 g** (2049 raw), X/Y near 0, gyro near 0, both temperatures near room temperature.
- BMP pressure about **95 000–101 000 Pa**, depending on your altitude. Lift the board 1 m and the altitude rises by about 1 m.
- The servo sweeps 1000 → 2000 µs and back, about once every 3 seconds.

**Keys in the Serial Monitor:**
- `s`: stop or restart the sweep
- `c`: centre the servo (1500 µs)
- `2`, `3`, `4`, `5`, `x`: move the test to the plug on pin 2, 3, 4, 5 or 10. Pins 2 and 3 are the steering servos on the 8 V plug J1, so only use them with 8 V connected.

**If something fails:**
- **Nothing found on the scan:** check J8 pin 3 for 3.3 V, then the SDA (pin 18) and SCL (pin 19) trails.
- **Only one sensor found:** check that sensor's VIN and GND.
- **Wrong LSM address:** DO is not tied to GND. Check the new GND trail at C33 R31.
- **Servo jitters or the Teensy resets:** the 5 V servo supply is too weak, or GND isn't shared between J6 and J8.

---
**USER** (2026-10-25T13:59:40)

turn servo 90 degree

---
**CLAUDE** (2026-10-25T14:00:41)

In the test sketch you already have, press **`c`** in the Serial Monitor. It stops the sweep and holds the servo at **90°** (1500 µs, the centre of its travel).

If you want a sketch that only moves the servo to 90° and holds it there:

```cpp
#include <Servo.h>

Servo servo;
const uint8_t SERVO_PIN = 4;     // J12 (MG90S #1). J13 = 5, J16 = 10

void setup() {
  servo.attach(SERVO_PIN, 500, 2500);   // 0° = 500 us, 180° = 2500 us
  servo.write(90);                      // 90° = 1500 us, centre
}

void loop() {
  // holds 90° as long as the board is powered
}
```

To watch it actually turn through 90°, from 0° to 90° and back every 2 seconds:

```cpp
#include <Servo.h>

Servo servo;
const uint8_t SERVO_PIN = 4;

void setup() {
  servo.attach(SERVO_PIN, 500, 2500);
}

void loop() {
  servo.write(0);    // 0°
  delay(2000);
  servo.write(90);   // 90°
  delay(2000);
}
```

Each MG90S is a little different, so "90°" may be off by a few degrees. If it stops short of the true middle or past it, change `servo.write(90)` to `servo.writeMicroseconds(1450)` or `1550` until it sits where you want.

---
**USER** (2026-10-25T14:37:49)

Actually the servo is not moving pin 4 give all program but servo rotating 360 degree

---
**CLAUDE** (2026-10-25T14:38:07)

That explains it. If your MG90S is the **360° (continuous rotation)** version, `write(90)` means **stop**, not "go to 90°". A 360° servo has no position; the value sets speed and direction:
- 1500 µs = stop
- below 1500 = turn one way (1000 = full speed)
- above 1500 = turn the other way (2000 = full speed)

Full program for pin 4 (J12). It spins one way, stops, spins the other way, and repeats. You can also control it from the Serial Monitor.

```cpp
#include <Servo.h>

Servo servo;
const uint8_t SERVO_PIN = 4;      // J12 = pin 4, J13 = pin 5, J16 = pin 10

const int STOP_US = 1500;         // adjust (1480..1520) if it creeps when it should stop
const int FWD_US  = 1700;         // spin one way  (up to 2000 = fastest)
const int REV_US  = 1300;         // spin other way (down to 1000 = fastest)

bool autoMode = true;

void setServo(int us, const char *msg) {
  servo.writeMicroseconds(us);
  Serial.printf("%s  (%d us)\n", msg, us);
}

void setup() {
  Serial.begin(115200);
  uint32_t t0 = millis();
  while (!Serial && millis() - t0 < 3000) {}
  servo.attach(SERVO_PIN, 1000, 2000);
  setServo(STOP_US, "start: stopped");
  Serial.println("keys: f = forward  r = reverse  s = stop  a = auto cycle  + / - = faster / slower");
}

void loop() {
  static int us = STOP_US;
  static uint32_t tStep = 0;
  static uint8_t phase = 0;

  while (Serial.available()) {
    char c = Serial.read();
    if (c == 'f') { autoMode = false; us = FWD_US;  setServo(us, "forward"); }
    if (c == 'r') { autoMode = false; us = REV_US;  setServo(us, "reverse"); }
    if (c == 's') { autoMode = false; us = STOP_US; setServo(us, "stop"); }
    if (c == 'a') { autoMode = true;  phase = 0; tStep = 0; Serial.println("auto cycle"); }
    if (c == '+') { autoMode = false; us = constrain(us + 50, 1000, 2000); setServo(us, "speed"); }
    if (c == '-') { autoMode = false; us = constrain(us - 50, 1000, 2000); setServo(us, "speed"); }
  }

  if (autoMode && millis() - tStep >= 2000) {      // 2 s forward, 1 s stop, 2 s reverse, 1 s stop
    tStep = millis();
    switch (phase) {
      case 0: setServo(FWD_US,  "auto: forward"); break;
      case 1: setServo(STOP_US, "auto: stop");    tStep -= 1000; break;
      case 2: setServo(REV_US,  "auto: reverse"); break;
      case 3: setServo(STOP_US, "auto: stop");    tStep -= 1000; break;
    }
    phase = (phase + 1) % 4;
  }
}
```

**If it still doesn't move at all, check in this order:**
1. **Servo power.** Measure **5 V between J6 pin 1 (+5VS) and pin 2 (GND)** with power on. No voltage there means no movement, even though the Teensy runs.
2. **Shared ground.** The Teensy's GND (J8) and the servo supply's GND (J6) must be the same. On the board they're joined by trails; if you power them from two different supplies, connect their grounds together.
3. **Plug orientation on J12.** **Brown/black → −** (bottom pin), **red → +** (middle), **orange/yellow → S** (top, toward the resistors).
4. **Signal path.** Teensy pin 4 → 330 Ω resistor R3 → J12 S pin. With the program in auto mode, a meter on J12 S to GND should read about 0.2–0.4 V DC (the pulses averaged). 0 V means a broken trail or a bad solder joint on R3.
5. **Try another output.** Move the servo plug to J13 and set `SERVO_PIN = 5`. If it works there, the problem is the pin 4 → R3 → J12 path.

---
**USER** (2026-10-25T14:44:02)

Give all servo pin test code

---
**CLAUDE** (2026-10-25T14:44:25)

This program tests all 5 servo plugs on Board 4. It works for both normal (180°) and 360° servos, because it only sends the standard 1000–2000 µs pulses: a 180° servo moves between positions, a 360° servo spins one way, stops, and spins back.

```cpp
/*
 * VRITRA Board 4 — test every servo plug (Teensy 4.0)
 *   J10 = pin 2  (A20CLM LEFT,   8 V rail)
 *   J11 = pin 3  (A20CLM RIGHT,  8 V rail)
 *   J12 = pin 4  (MG90S #1 BAY,  5 V rail)
 *   J13 = pin 5  (MG90S #2 PETRI,5 V rail)
 *   J16 = pin 10 (MG90S #3 EXTRA,5 V rail)
 * Auto mode tests one plug after the other. Serial keys:
 *   1..5 = test only that plug   a = auto (all plugs in turn)   s = stop all (1500 us)
 *   f / r = forward / reverse on the selected plug   + / - = change pulse by 50 us
 */
#include <Servo.h>

struct Ch { uint8_t pin; const char *name; };
const Ch CH[] = {
  {2,  "J10 A20CLM LEFT  (8 V)"},
  {3,  "J11 A20CLM RIGHT (8 V)"},
  {4,  "J12 MG90S #1 BAY (5 V)"},
  {5,  "J13 MG90S #2 PETRI (5 V)"},
  {10, "J16 MG90S #3 EXTRA (5 V)"},
};
const uint8_t N = sizeof(CH) / sizeof(CH[0]);

const int STOP_US = 1500;   // 180° servo: centre (90°) · 360° servo: stop
const int LOW_US  = 1200;   // 180° servo: one side   · 360° servo: one direction
const int HIGH_US = 1800;   // 180° servo: other side · 360° servo: other direction

Servo servo[N];
bool autoMode = true;
uint8_t sel = 0;            // selected plug index
int selUs = STOP_US;

void allStop() {
  for (uint8_t i = 0; i < N; i++) servo[i].writeMicroseconds(STOP_US);
}

void setSel(int us) {
  selUs = constrain(us, 1000, 2000);
  servo[sel].writeMicroseconds(selUs);
  Serial.printf("%s  pin %u  -> %d us\n", CH[sel].name, CH[sel].pin, selUs);
}

void setup() {
  Serial.begin(115200);
  uint32_t t0 = millis();
  while (!Serial && millis() - t0 < 3000) {}
  for (uint8_t i = 0; i < N; i++) servo[i].attach(CH[i].pin, 1000, 2000);
  allStop();
  Serial.println("\nBoard 4 servo test");
  Serial.println("keys: 1..5 select plug, a auto, s stop all, f/r forward/reverse, +/- 50 us");
  for (uint8_t i = 0; i < N; i++) Serial.printf("  %u = %s (pin %u)\n", i + 1, CH[i].name, CH[i].pin);
}

void loop() {
  static uint32_t tStep = 0;
  static uint8_t phase = 0;

  while (Serial.available()) {
    char c = Serial.read();
    if (c >= '1' && c < '1' + N) { autoMode = false; allStop(); sel = c - '1'; setSel(STOP_US); }
    else if (c == 'a') { autoMode = true; sel = 0; phase = 0; tStep = 0; allStop(); Serial.println("auto: all plugs in turn"); }
    else if (c == 's') { autoMode = false; allStop(); selUs = STOP_US; Serial.println("all stopped (1500 us)"); }
    else if (c == 'f') { autoMode = false; setSel(HIGH_US); }
    else if (c == 'r') { autoMode = false; setSel(LOW_US); }
    else if (c == '+') { autoMode = false; setSel(selUs + 50); }
    else if (c == '-') { autoMode = false; setSel(selUs - 50); }
  }

  // auto: each plug gets  HIGH 1.5 s -> STOP 1 s -> LOW 1.5 s -> STOP 1 s, then the next plug
  if (autoMode && millis() - tStep >= (phase % 2 ? 1000UL : 1500UL)) {
    tStep = millis();
    if (phase == 0) Serial.printf("\n--- testing %s (pin %u) ---\n", CH[sel].name, CH[sel].pin);
    const int seq[4] = {HIGH_US, STOP_US, LOW_US, STOP_US};
    setSel(seq[phase]);
    if (++phase == 4) { phase = 0; sel = (sel + 1) % N; }
  }
}
```

**How to use it:**
- In auto mode the Serial Monitor shows which plug is being tested, for example `--- testing J12 MG90S #1 BAY (5 V) (pin 4) ---`. Move one servo from plug to plug and watch it move when its plug's turn comes.
- To test one plug only, press its number in the Serial Monitor:

| Key | Plug | Pin | Power |
|---|---|---|---|
| `1` | J10 | 2 | 8 V |
| `2` | J11 | 3 | 8 V |
| `3` | J12 | 4 | 5 V |
| `4` | J13 | 5 | 5 V |
| `5` | J16 | 10 | 5 V |

  Then press `f` and `r` to drive it, and `s` to stop.
- Plug orientation on every servo header: brown/black on −, red on +, orange/yellow on S (the top pin, nearest the resistors).
- Each servo's power comes from its own input: J10/J11 need 8 V on J1, and J12/J13/J16 need 5 V on J6. A plug with no voltage on its + pin won't move even if the signal is fine.
- If one plug never moves while the others work, the problem is that plug's own path: Teensy pin → its 330 Ω resistor (R1, R2, R3, R4 or R9) → the S pin. Check that solder joint and trail.
- With a 360° servo, if it creeps slowly at "stop", select that plug and press `+` or `-` once or twice to find its true stop point (usually 1450–1550 µs).

The ESC plug (J14, pin 6) is left out on purpose, so the motor can't spin up during a servo test.

---
**USER** (2026-10-25T15:04:42)

I think my resistor is not passing signal to my servo i tested without resistor it work

---
**CLAUDE** (2026-10-25T15:04:59)

Your test shows the servo and the Teensy pin both work, so the fault is in the resistor or its connection. A correct 330 Ω resistor in series doesn't stop a servo signal: the servo input draws almost no current, and 330 Ω drops only a few millivolts. So the part or a joint is wrong. Check in this order:

**1. Check the resistor's value**

| Value | 4-band colours | 5-band colours | Works? |
|---|---|---|---|
| **330 Ω** (correct) | orange orange **brown** gold | orange orange black **black** brown | yes |
| 3.3 kΩ | orange orange **red** | orange orange black **brown** | usually yes |
| **330 kΩ** (wrong) | orange orange **yellow** | orange orange black **orange** | **no**, signal too weak |

A 330 kΩ resistor in place of 330 Ω is the most common cause of exactly what you're seeing.

**2. Measure it on the board (power OFF), meter on Ω**
- Measure across the 2 legs of the resistor for that plug (J12/pin 4 = **R3**). It should read about **330 Ω**. A reading of hundreds of kΩ or open (OL) means a wrong or broken resistor.
- Measure from **Teensy pin 4** (the header pin) to **J12's S pin** (top pin). It should also read about **330 Ω**. Open here, with the resistor itself reading OK, means a cold solder joint or a gap in the trail between the Teensy, the resistor and J12.

**3. Measure with power ON, servo test running, meter on DC V**
- Teensy pin 4 to GND: about 0.2–0.4 V (the pulses averaged).
- J12 S pin to GND: about the same. 0 V here, with the Teensy side OK, means the path is broken.

**Fix:**
- **Wrong value:** fit a **330 Ω** (anything from 100 Ω to 1 kΩ works).
- **Bad joint:** reheat both resistor legs and the trail joints until the solder flows into the hole.
- **Can't find it quickly:** solder a wire link in place of the resistor. The servo works without it. The resistor only protects the Teensy pin if the servo lead shorts, so put a 330 Ω back later for flight.

The same check applies to every servo plug:

| Plug | Teensy pin | Resistor |
|---|---|---|
| J10 | 2 | R1 |
| J11 | 3 | R2 |
| J12 | 4 | R3 |
| J13 | 5 | R4 |
| J16 | 10 | R9 |
| J14 (ESC) | 6 | R5 |

If several plugs fail the same way, it's most likely a wrong-value batch, such as all 330 kΩ.

---
**USER** (2026-10-25T15:32:14)

can you tell me all resistor value on my parachute board

---
**CLAUDE** (2026-10-25T15:32:25)

Board 4 (parachute) has 9 resistors. All are ¼ W.

| Ref | Value | Purpose | Teensy pin → goes to | Holes (leg 1 – leg 2) |
|---|---|---|---|---|
| R1 | **330 Ω** | servo signal, J10 A20CLM LEFT | pin 2 → J10 S | C13 R19 – C13 R15 |
| R2 | **330 Ω** | servo signal, J11 A20CLM RIGHT | pin 3 → J11 S | C16 R19 – C16 R15 |
| R3 | **330 Ω** | servo signal, J12 MG90S parachute bay | pin 4 → J12 S | C19 R19 – C19 R15 |
| R4 | **330 Ω** | servo signal, J13 MG90S petri plate | pin 5 → J13 S | C22 R19 – C22 R15 |
| R9 | **330 Ω** | servo signal, J16 MG90S extra | pin 10 → J16 S | C34 R20 – C34 R16 |
| R5 | **330 Ω** | ESC signal, J14 | pin 6 → J14 S | C28 R21 – C28 R17 |
| R6 | **10 kΩ** | Hall sensor pull-up (OUT to 3.3 V) | pin 9 / J15 OUT ↔ 3.3 V | C33 R26 – C33 R22 |
| R7 | **1 kΩ** | UART TX to MAIN (protection) | pin 8 → J2 pin 1 | C31 R22 – C31 R18 |
| R8 | **1 kΩ** | UART TX to BACKUP (protection) | pin 8 → J3 pin 1 | C36 R16 – C36 R20 |

**Colour codes to check what you fitted:**

| Value | 4-band | 5-band |
|---|---|---|
| 330 Ω | orange, orange, **brown**, gold | orange, orange, black, **black**, brown |
| 1 kΩ | brown, black, **red**, gold | brown, black, black, **brown**, brown |
| 10 kΩ | brown, black, **orange**, gold | brown, black, black, **red**, brown |

If you measure a resistor while it's on the board, the meter can read lower than its value because other parts are connected in parallel. If a reading looks wrong, lift one leg and measure again.

---
**USER** (2026-10-25T16:36:42)

give me all test program for all backup  and everthing there is on board 4  full program simple comment that mention that what that connection does

---
**CLAUDE** (2026-10-25T16:38:39)

This is the full Board 4 test program. It passes a syntax check with your Teensy 1.62 compiler; it hasn't run on the board yet. Every connection on the board can be tested from the Serial Monitor, one item at a time. It's saved at [firmware_tests/board4_full_test/board4_full_test.ino](../board4_full_test/board4_full_test.ino).

```cpp
/*
 * VRITRA BOARD 4 (PARACHUTE, Teensy 4.0) — FULL BENCH TEST
 * Tests everything on Board 4, one item at a time, from the Serial Monitor.
 *
 * WHAT IS CONNECTED WHERE (Board 4 design)
 *   I2C  (Wire)  pin 18 SDA, pin 19 SCL : BMP585 #3 (0x47) + LSM6DSO32 (0x6A)
 *   GNSS         pin 0  (Serial1 RX)    : NMEA from MAIN board J8 -> J5   (listen only)
 *   MAIN link    pin 7  (Serial2 RX)    : data from MAIN board J4 -> J2 pin 2
 *                pin 8  (Serial2 TX)    : data to MAIN (J2 pin 1, via R7 1k) AND to BACKUP (J3 pin 1, via R8 1k)
 *   BACKUP link  pin 15 (Serial3 RX)    : data from BACKUP board J3 -> J3 pin 2
 *   Servos (330 R each) pin 2 J10 steer L (8 V) · pin 3 J11 steer R (8 V)
 *                       pin 4 J12 bay MG90S · pin 5 J13 petri MG90S · pin 10 J16 extra MG90S (5 V)
 *   ESC signal   pin 6  (J14, 330 R)    : Cyclone 45A BLHeli_S, 1000 us = stop
 *   Hall sensor  pin 9  (J15 OUT, 10k pull-up to 3V3) : gyro-wheel speed
 *   Power        J8 = 5 V + 3V3 logic (sensors get 3V3 ONLY from J8 pin 3)
 *                J6 = 5 V servo · J1 = 8 V steering servos
 *
 * KEYS:  h help   i I2C scan   l LSM6DSO32   b BMP585   g GNSS   u UART links
 *        v servo test (all plugs in turn)    1..5 one servo plug    s stop servos
 *        e ESC test (ONLY with the wheel secured!)   k Hall / wheel RPM   x everything off
 */
#include <Wire.h>
#include <Servo.h>

// ----- settings you may need to change -----
const uint32_t GNSS_BAUD = 9600;      // L89 GNSS output rate (same as MAIN firmware)
const uint32_t LINK_BAUD = 115200;    // MAIN / BACKUP UART link speed: must match their firmware
const uint8_t  MAGNETS   = 1;         // magnets on the gyro wheel (Hall pulses per turn)
const int      ESC_TEST_US = 1100;    // ESC test throttle (1000 = stop, keep LOW for the test)

// ----- I2C sensors -----
const uint8_t LSM_ADDR = 0x6A;        // LSM6DSO32: DO -> GND gives 0x6A
const uint8_t BMP_ADDR = 0x47;        // BMP585:    SDO -> 3V3 gives 0x47

// ----- servo plugs: pin, name -----
struct Plug { uint8_t pin; const char *name; };
const Plug SERVO_PLUG[] = {
  {2,  "J10 A20CLM steer LEFT (8 V)"},
  {3,  "J11 A20CLM steer RIGHT (8 V)"},
  {4,  "J12 MG90S #1 parachute bay (5 V)"},
  {5,  "J13 MG90S #2 petri plate (5 V)"},
  {10, "J16 MG90S #3 extra (5 V)"},
};
const uint8_t NS = sizeof(SERVO_PLUG) / sizeof(SERVO_PLUG[0]);
const uint8_t ESC_PIN = 6;            // J14 ESC signal
const uint8_t HALL_PIN = 9;           // J15 Hall OUT

Servo servo[NS], esc;

// what is running
enum Mode { NONE, LSM, BMP, GNSS, LINK, SERVO_AUTO, SERVO_ONE, ESC_TEST, HALL };
Mode mode = NONE;
uint8_t oneServo = 0;

// Hall pulse counter (interrupt)
volatile uint32_t hallPulses = 0;
void hallIsr() { hallPulses++; }

// ---------- small I2C helpers ----------
bool writeReg(uint8_t a, uint8_t r, uint8_t v) {
  Wire.beginTransmission(a); Wire.write(r); Wire.write(v);
  return Wire.endTransmission() == 0;
}
bool readRegs(uint8_t a, uint8_t r, uint8_t *buf, uint8_t n) {
  Wire.beginTransmission(a); Wire.write(r);
  if (Wire.endTransmission(false) != 0) return false;
  if (Wire.requestFrom(a, n) != n) return false;
  for (uint8_t i = 0; i < n; i++) buf[i] = Wire.read();
  return true;
}

// ---------- I2C scan: shows which sensors answer ----------
void i2cScan() {
  Serial.println("\n[I2C] scanning pin 18 SDA / 19 SCL ...");
  int n = 0;
  for (uint8_t a = 1; a < 127; a++) {
    Wire.beginTransmission(a);
    if (Wire.endTransmission() == 0) {
      Serial.printf("  0x%02X %s\n", a, a == LSM_ADDR ? "LSM6DSO32" : a == BMP_ADDR ? "BMP585" : "(unknown)");
      n++;
    }
  }
  if (!n) Serial.println("  nothing -> check 3V3 on J8 pin 3, GND, pins 18/19");
}

// ---------- LSM6DSO32: accelerometer + gyro ----------
bool lsmStart() {
  uint8_t who = 0;
  if (!readRegs(LSM_ADDR, 0x0F, &who, 1) || who != 0x6C) {
    Serial.printf("[LSM] not found (WHO_AM_I 0x%02X, want 0x6C)\n", who);
    return false;
  }
  writeReg(LSM_ADDR, 0x12, 0x01); delay(20);  // reset
  writeReg(LSM_ADDR, 0x12, 0x44);             // safe 16-bit reads, auto address step
  writeReg(LSM_ADDR, 0x10, 0x4C);             // accel 104 Hz, +-16 g
  writeReg(LSM_ADDR, 0x11, 0x4C);             // gyro  104 Hz, +-2000 dps
  delay(50);
  Serial.println("[LSM] OK  (flat on the table: Z about +1 g)");
  return true;
}
void lsmPrint() {
  uint8_t b[14];
  if (!readRegs(LSM_ADDR, 0x20, b, 14)) { Serial.println("[LSM] read failed"); return; }
  int16_t t = b[1] << 8 | b[0], g[3], a[3];
  for (int i = 0; i < 3; i++) { g[i] = b[3 + 2 * i] << 8 | b[2 + 2 * i]; a[i] = b[9 + 2 * i] << 8 | b[8 + 2 * i]; }
  Serial.printf("[LSM] raw A %6d %6d %6d G %6d %6d %6d | A g %6.3f %6.3f %6.3f  G dps %7.1f %7.1f %7.1f  T %.1f C\n",
                a[0], a[1], a[2], g[0], g[1], g[2],
                a[0] * 0.000488f, a[1] * 0.000488f, a[2] * 0.000488f,
                g[0] * 0.070f, g[1] * 0.070f, g[2] * 0.070f, 25.0f + t / 256.0f);
}

// ---------- BMP585: pressure + temperature ----------
bool bmpStart() {
  uint8_t id = 0;
  writeReg(BMP_ADDR, 0x7E, 0xB6); delay(10);  // reset
  if (!readRegs(BMP_ADDR, 0x01, &id, 1) || id != 0x51) {
    Serial.printf("[BMP] not found (CHIP_ID 0x%02X, want 0x51)\n", id);
    return false;
  }
  writeReg(BMP_ADDR, 0x37, 0x80 | (0x14 << 2));          // standby, 25 Hz
  writeReg(BMP_ADDR, 0x36, 0x40 | (4 << 3) | 1);         // pressure on, oversampling P x16, T x2
  delay(5);
  writeReg(BMP_ADDR, 0x37, 0x80 | (0x14 << 2) | 0x01);   // run continuously
  delay(60);
  Serial.println("[BMP] OK");
  return true;
}
void bmpPrint() {
  uint8_t b[6];
  if (!readRegs(BMP_ADDR, 0x1D, b, 6)) { Serial.println("[BMP] read failed"); return; }
  int32_t rt = (int32_t)((uint32_t)b[2] << 16 | (uint32_t)b[1] << 8 | b[0]);
  if (rt & 0x800000) rt |= 0xFF000000;
  uint32_t rp = (uint32_t)b[5] << 16 | (uint32_t)b[4] << 8 | b[3];
  float tc = rt / 65536.0f, pa = rp / 64.0f;
  float alt = 44330.0f * (1.0f - powf(pa / 101325.0f, 0.1903f));
  Serial.printf("[BMP] raw T %ld P %lu | T %.2f C  P %.1f Pa  alt %.2f m\n", (long)rt, (unsigned long)rp, tc, pa, alt);
}

// ---------- servos ----------
void servosStop() {                    // 1500 us = centre (180° servo) / stop (360° servo)
  for (uint8_t i = 0; i < NS; i++) servo[i].writeMicroseconds(1500);
}

// ---------- everything off ----------
void allOff() {
  servosStop();
  esc.writeMicroseconds(1000);         // ESC stop
  mode = NONE;
  Serial.println("everything off (servos 1500 us, ESC 1000 us)");
}

void help() {
  Serial.println("\nKEYS: h help | i I2C scan | l LSM6DSO32 | b BMP585 | g GNSS | u UART links");
  Serial.println("      v all servos in turn | 1..5 one servo | s stop servos | e ESC test | k Hall RPM | x all off");
  for (uint8_t i = 0; i < NS; i++) Serial.printf("      %u = %s (pin %u)\n", i + 1, SERVO_PLUG[i].name, SERVO_PLUG[i].pin);
}

void setup() {
  Serial.begin(115200);
  uint32_t t0 = millis();
  while (!Serial && millis() - t0 < 3000) {}
  Serial.println("\n=== VRITRA BOARD 4 full test ===");

  Wire.begin();                         // pins 18 / 19
  Wire.setClock(100000);
  Serial1.begin(GNSS_BAUD);             // GNSS in on pin 0
  Serial2.begin(LINK_BAUD);             // MAIN link: RX pin 7, TX pin 8 (TX also reaches BACKUP)
  Serial3.begin(LINK_BAUD);             // BACKUP link: RX pin 15

  for (uint8_t i = 0; i < NS; i++) servo[i].attach(SERVO_PLUG[i].pin, 1000, 2000);
  servosStop();
  esc.attach(ESC_PIN, 1000, 2000);
  esc.writeMicroseconds(1000);          // ESC sees "stop" from power-up, so it arms safely

  pinMode(HALL_PIN, INPUT);             // R6 10k already pulls it up to 3V3
  attachInterrupt(digitalPinToInterrupt(HALL_PIN), hallIsr, FALLING);

  i2cScan();
  help();
}

void loop() {
  static uint32_t tPrint = 0, tStep = 0, tLink = 0, tEsc = 0, hallLast = 0, tHall = 0;
  static uint8_t phase = 0, sel = 0;
  static bool lsmOk = false, bmpOk = false;
  uint32_t now = millis();

  // ----- keys -----
  while (Serial.available()) {
    char c = Serial.read();
    if (c == 'h') help();
    else if (c == 'i') i2cScan();
    else if (c == 'l') { lsmOk = lsmStart(); mode = LSM; }
    else if (c == 'b') { bmpOk = bmpStart(); mode = BMP; }
    else if (c == 'g') { mode = GNSS; Serial.println("[GNSS] printing NMEA from MAIN (pin 0). Nothing = check J5 cable / MAIN on"); }
    else if (c == 'u') { mode = LINK; Serial.println("[LINK] sending 'B4 PING n' on pin 8, printing what arrives on pin 7 (MAIN) and pin 15 (BACKUP)"); }
    else if (c == 'v') { servosStop(); mode = SERVO_AUTO; sel = 0; phase = 0; tStep = 0; Serial.println("[SERVO] all plugs in turn"); }
    else if (c >= '1' && c < '1' + NS) { servosStop(); oneServo = c - '1'; mode = SERVO_ONE; phase = 0; tStep = 0;
                                         Serial.printf("[SERVO] only %s\n", SERVO_PLUG[oneServo].name); }
    else if (c == 's') { servosStop(); mode = NONE; Serial.println("[SERVO] stopped"); }
    else if (c == 'e') { mode = ESC_TEST; tEsc = now; esc.writeMicroseconds(ESC_TEST_US);
                         Serial.printf("[ESC] %d us for 2 s, then stop. Wheel must be secured!\n", ESC_TEST_US); }
    else if (c == 'k') { mode = HALL; hallLast = hallPulses; tHall = now; Serial.println("[HALL] spin the wheel / pass a magnet"); }
    else if (c == 'x') allOff();
  }

  // ----- running test -----
  switch (mode) {
    case LSM:  if (lsmOk && now - tPrint >= 200) { tPrint = now; lsmPrint(); } break;
    case BMP:  if (bmpOk && now - tPrint >= 200) { tPrint = now; bmpPrint(); } break;

    case GNSS:                                    // copy GNSS sentences to the screen
      while (Serial1.available()) Serial.write(Serial1.read());
      break;

    case LINK:                                    // UART links to MAIN and BACKUP
      if (now - tLink >= 1000) {
        tLink = now;
        static uint32_t n = 0;
        Serial2.printf("B4 PING %lu\n", (unsigned long)n++);   // goes to MAIN and BACKUP
      }
      while (Serial2.available()) { Serial.print("[from MAIN]   "); Serial.write(Serial2.read()); Serial.println(); }
      while (Serial3.available()) { Serial.print("[from BACKUP] "); Serial.write(Serial3.read()); Serial.println(); }
      break;

    case SERVO_AUTO:                              // each plug: 1800 us, 1500, 1200, 1500, then next plug
    case SERVO_ONE:
      if (now - tStep >= 1200) {
        tStep = now;
        uint8_t i = (mode == SERVO_AUTO) ? sel : oneServo;
        const int seq[4] = {1800, 1500, 1200, 1500};
        servo[i].writeMicroseconds(seq[phase]);
        Serial.printf("[SERVO] %s pin %u -> %d us\n", SERVO_PLUG[i].name, SERVO_PLUG[i].pin, seq[phase]);
        if (++phase == 4) { phase = 0; if (mode == SERVO_AUTO) sel = (sel + 1) % NS; }
      }
      break;

    case ESC_TEST:                                // short low-throttle pulse, then stop
      if (now - tEsc >= 2000) { esc.writeMicroseconds(1000); mode = NONE; Serial.println("[ESC] stop (1000 us)"); }
      break;

    case HALL:                                    // count Hall pulses every second
      if (now - tHall >= 1000) {
        uint32_t p = hallPulses, d = p - hallLast;
        hallLast = p; tHall = now;
        Serial.printf("[HALL] pin 9 = %s  pulses/s %lu  wheel %lu RPM\n", digitalRead(HALL_PIN) ? "HIGH" : "LOW",
                      (unsigned long)d, (unsigned long)(d * 60UL / MAGNETS));
      }
      break;

    default: break;
  }
}
```

**What each key tests:**

| Key | Tests | Good result |
|---|---|---|
| `i` | I²C bus (pins 18/19) | finds 0x47 BMP585 and 0x6A LSM6DSO32 |
| `l` | LSM6DSO32 | flat on the table: Z ≈ 1 g, gyro ≈ 0 |
| `b` | BMP585 | pressure ≈ 95 000–101 000 Pa; altitude changes when you lift the board |
| `g` | GNSS from MAIN (J5, pin 0) | text lines starting with `$G…` (MAIN must be powered, cable J8 → J5) |
| `u` | MAIN and BACKUP links | Board 4 sends `B4 PING n` every second. Text from MAIN appears as `[from MAIN]`, text from BACKUP as `[from BACKUP]`. |
| `v` | all 5 servo plugs in turn | each servo moves (or spins, if 360°) when its plug's turn comes |
| `1`–`5` | one plug only: J10, J11, J12, J13, J16 | that servo moves |
| `e` | ESC on J14 | motor turns slowly for 2 s, then stops. **Secure the wheel first.** |
| `k` | Hall sensor (J15, pin 9) | RPM rises when the wheel spins; pin reads LOW when a magnet passes |
| `s` / `x` | stop servos / stop everything | — |

**Before you test:**
- **Power:**
  - J8 needs 5 V **and** 3.3 V; the sensors get 3.3 V only from J8 pin 3.
  - J6 needs 5 V for the MG90S servos.
  - J1 needs 8 V for the steering servos.
  - All grounds must be connected together.
- **`u` link test:** MAIN and BACKUP must be running firmware that uses **115200 baud** on those links, and something has to send text back for anything to appear. Change `LINK_BAUD` if your firmware uses another speed.
- **ESC:** it arms when it sees 1000 µs for a few seconds after power-up (you'll hear beeps). The `e` test only goes to 1100 µs.

---
**USER** (2026-10-25T19:14:07)

in board 1 tell me all connector and capacitor type and ohm and also of connector and resistor  specailly the abrivision of j1,c1.r1

---
**CLAUDE** (2026-10-25T19:14:32)

Board 1 (MAIN, etched):

**What the letters mean**
| Letter | Means |
|---|---|
| **J** | connector (J = jack). J1, J2… are the plugs |
| **C** | capacitor |
| **R** | resistor |
| **D** | diode or LED |
| **U** | module (Teensy, sensor boards, radio) |
| **W** | wire jumper on the top side (the etched board's jumper wires) |

**Connectors (all JST-XH, 2.5 mm pitch, vertical B#B-XH-A)**
| Ref | Pins | Pin order | Goes to |
|---|---|---|---|
| J1 | 4 | +5V, GND, +3V3, GND | POWER board J5 (logic power in) |
| J2 | 3 | SCL, SDA, GND | POWER board J2 (I²C to the 3 INA260) |
| J3 | 2 | VBAT, GND | POWER board J10 (battery voltage sense) |
| J4 | 3 | RX3, TX3, GND | PARACHUTE board J2 (UART) |
| J5 | 5 | HB, GNSS, MUX_TX, MUX_RX, GND | BACKUP board J2 (heartbeat, GNSS copy, camera link) |
| J7 | 2 | CELL+, GND | GNSS backup coin cell holder |
| J8 | 2 | GNSS, GND | PARACHUTE board J5 (GNSS copy) |

There is no J6 or J9 on the etched Board 1. They were the old sensor-board plugs and were removed.

**Resistors (¼ W axial)**
| Ref | Value | What it does |
|---|---|---|
| R1 | 10 kΩ | LoRa CS pull-up (pin 29 → 3.3 V) |
| R2 | 10 kΩ | flash CS pull-up (pin 9 → 3.3 V) |
| R3 | 1 kΩ | heartbeat out (pin 5 → J5) |
| R4 | 1 kΩ | UART TX3 out (pin 14 → J4) |
| R5 | 1 kΩ | GNSS copy to PARACHUTE (→ J8) |
| R6 | 1 kΩ | GNSS copy to BACKUP (→ J5) |
| R7 | 100 kΩ | battery divider, top (VBAT → pin 20) |
| R8 | 22 kΩ | battery divider, bottom (pin 20 → GND) |
| R9 | 470 Ω | green status LED (pin 31) |
| R10 | 470 Ω | red status LED (pin 32) |
| R11 | 1 kΩ | camera command TX (pin 1 → J5) |
| R12 | 100 kΩ | amplifier GAIN → GND (15 dB) |

**Capacitors**
| Ref | Value | Type | Across | Voltage rating |
|---|---|---|---|---|
| C1 | 470 µF | electrolytic (polarised, Ø8 mm, 5 mm leg spacing) | +5 V / GND at the power plug | ≥10 V (16 V ok) |
| C2 | 100 nF | ceramic disc (no polarity, 5 mm leg spacing) | +5 V / GND | any |
| C3 | 100 nF | ceramic | 3.3 V / GND at the LoRa radio | any |
| C4 | 100 nF | ceramic | 3.3 V / GND at the BMP585 | any |
| C5 | 100 nF | ceramic | 3.3 V / GND at the ICM-20948 | any |
| C6 | 100 µF | electrolytic (polarised, Ø6.3 mm, 2.5 mm leg spacing) | amplifier 5 V / GND | ≥10 V |

**Diodes and LEDs**
| Ref | Part |
|---|---|
| D1 | green LED, 3 mm (status OK) |
| D2 | red LED, 3 mm (fault) |
| D3 | 1N5817 Schottky (3.3 V → GNSS backup) |
| D4 | 1N5817 Schottky (coin cell → GNSS backup) |

For LEDs and diodes the band or short leg is the cathode. For C1 and C6 the stripe side goes to GND.

---
**USER** (2026-10-25T19:21:20)

from parachte board describe all hardware connection

---
**CLAUDE** (2026-10-25T19:21:47)

Board 4 (PARACHUTE), every connection:

**1. Teensy 4.0 pins used**
| Teensy pin | Signal | Goes to |
|---|---|---|
| VIN | +5 V logic | J8 pin 1 (and C3, C4) |
| GND (both) | GND | ground network |
| 3V3 | — | **not connected** (the Teensy's own 3.3 V output) |
| 0 (Serial1 RX) | GNSS in | J5 pin 1 (GNSS from MAIN) |
| 2 | STEER L | R1 330 Ω → J10 S |
| 3 | STEER R | R2 330 Ω → J11 S |
| 4 | BAY servo | R3 330 Ω → J12 S |
| 5 | PETRI servo | R4 330 Ω → J13 S |
| 6 | ESC | R5 330 Ω → J14 S |
| 7 (Serial2 RX) | from MAIN | J2 pin 2 |
| 8 (Serial2 TX) | to MAIN + BACKUP | R7 1 kΩ → J2 pin 1, and R8 1 kΩ → J3 pin 1 |
| 9 | HALL | J15 OUT, and R6 10 kΩ pull-up to 3.3 V |
| 10 | EXTRA servo | R9 330 Ω → J16 S |
| 15 (Serial3 RX) | from BACKUP | J3 pin 2 |
| 18 | SDA | BMP585 SDI, LSM6DSO32 SDA |
| 19 | SCL | BMP585 SCK, LSM6DSO32 SCL |

**2. Sensors (I²C, powered from 3.3 V on J8 pin 3)**

| BMP585 (0x47) pin | Connected to |
|---|---|
| VIN | 3.3 V |
| 3V3 | open (the module's own output) |
| GND | GND |
| SCK | SCL (pin 19) |
| SDO | 3.3 V (sets address 0x47) |
| SDI | SDA (pin 18) |
| CS | 3.3 V (I²C mode) |
| INT | open |

| LSM6DSO32 (0x6A) pin | Connected to |
|---|---|
| VIN | 3.3 V |
| 3Vo | open (the module's own output) |
| GND | GND |
| SCL | pin 19 |
| SDA | pin 18 |
| DO | GND (sets address 0x6A) |
| CS | 3.3 V (I²C mode) |
| INT1, INT2 | open |
| Back 5-pin row | not fitted |

**3. Power plugs (from POWER board, JST-XH)**
| Plug | Pins | Feeds |
|---|---|---|
| J8 logic | 1 +5 V · 2 GND · 3 +3.3 V · 4 GND | Teensy VIN, Hall +5 V, both sensors, R6 |
| J1 8 V | 1 +8 V · 2 +8 V · 3 GND · 4 GND | J10 + J11 (steering servos), C1 |
| J6 5 V servo | 1 +5 V servo · 2 GND | J12 + J13 + J16 (MG90S), C2 |

**4. Servo plugs (2.54 mm header, pins − + S)**
| Plug | Servo | − | + | S |
|---|---|---|---|---|
| J10 | A20CLM steer LEFT | GND | +8 V | pin 2 via R1 |
| J11 | A20CLM steer RIGHT | GND | +8 V | pin 3 via R2 |
| J12 | MG90S #1 parachute bay | GND | +5 V servo | pin 4 via R3 |
| J13 | MG90S #2 petri plate | GND | +5 V servo | pin 5 via R4 |
| J16 | MG90S #3 extra | GND | +5 V servo | pin 10 via R9 |

**5. Other plugs (JST-XH)**
| Plug | Pins | Connects |
|---|---|---|
| J14 ESC | 1 − (GND) · 2 S | ESC's 2 thin wires; S ← pin 6 via R5 |
| J15 Hall sensor | 1 − (GND) · 2 +5 V · 3 OUT | sensor on the body; OUT → pin 9 + R6 pull-up |
| J5 GNSS | 1 GNSS · 2 GND | from MAIN J8; → Teensy pin 0 |
| J2 UART MAIN | 1 TX→A · 2 RX←A · 3 GND | to MAIN J4: pin 8 out (via R7), pin 7 in |
| J3 UART BACKUP | 1 TX→B · 2 RX3←B · 3 GND | to BACKUP J3: pin 8 out (via R8), pin 15 in |

**6. Resistors**
| Ref | Value | Purpose |
|---|---|---|
| R1, R2, R3, R4, R9 | 330 Ω | servo signal protection |
| R5 | 330 Ω | ESC signal protection |
| R6 | 10 kΩ | Hall output pull-up to 3.3 V |
| R7 | 1 kΩ | TX to MAIN protection |
| R8 | 1 kΩ | TX to BACKUP protection |

**7. Capacitors**
| Ref | Value | Type | Across |
|---|---|---|---|
| C1 | 470 µF | electrolytic, ≥16 V | +8 V / GND (steering servos) |
| C2 | 470 µF | electrolytic, ≥10 V | +5 V servo / GND |
| C3 | 470 µF | electrolytic, ≥10 V | +5 V logic / GND |
| C4 | 100 nF | ceramic | +5 V logic / GND at the Teensy VIN |
| C5 | 100 nF | ceramic | +3.3 V / GND near the sensors |

**8. Cables to other boards**
| Cable | Board 4 end | Other end | Carries |
|---|---|---|---|
| W3 | J8 | POWER J7 | 5 V + 3.3 V logic |
| W4 | J1 | POWER J8 | 8 V steering, 2 pins each way |
| W5 | J6 | POWER J9 | 5 V servo |
| W10 | J2 | MAIN J4 | UART both ways |
| W11 | J5 | MAIN J8 | GNSS |
| W12 | J3 | BACKUP J3 | UART both ways |

All grounds on the board are one common GND net. The ESC's thick power wires go to the POWER board, not to Board 4.

---
**USER** (2026-10-25T19:25:57)

for board 4 i want a program at boot the lsm vlaue will be 0,0,0 and then when i rotate the cansat and gyro detect it it will rotate the gyro accordinaly to make my cansat straight proper first reaserch my module their calibration vlaue and then make a full proogram properly

---
**CLAUDE** (2026-10-25T19:28:23)

This program zeroes the attitude at boot (roll = pitch = yaw = 0) and then uses the gyro wheel to turn the CanSat back to its boot heading. It passes a syntax check with your Teensy compiler; it hasn't run on hardware.

**One wheel can only correct rotation around its own axis.** If the wheel shaft points along the can's long axis, the program stops the CanSat spinning or twisting under the parachute. It cannot actively level a tilt. The spinning wheel only resists tilting (gyroscopic stiffness), so "straight" here means "holds its boot heading".

**What I checked about your module:**
- LSM6DSO32 sensitivities used: ±2000 dps → 70 mdps/LSB, and ±16 g → 0.488 mg/LSB. The gyro figures are confirmed by published family values ([nRF Connect / Zephyr binding](https://nrfconnectdocs.nordicsemi.com/ncs/latest/zephyr/build/dts/api/bindings/sensor/st%2Clsm6dso32-i2c.html)). The accelerometer figure follows the binding's note that the LSM6DSO32 is double the LSM6DSO, which I couldn't check against ST's own table.
- Offsets: about **±1 dps gyro zero-rate** and about **±20 mg accelerometer zero-g**. I couldn't get the LSM6DSO32's own table; these come from the sister part LSM6DSOP ([datasheet table](https://www.alldatasheet.net/html-pdf/1211916/STMICROELECTRONICS/LSM6DSOP/40943/18/LSM6DSOP.html)), and ST's product page ([ST LSM6DSO32](https://st.com/en/mems-and-sensors/lsm6dso32.html)) has the full datasheet.
- These offsets differ on every chip, so fixed numbers from a datasheet are no use. The program measures your board's gyro bias at every boot (3 s, CanSat still) and stores that attitude as zero. If you move it during those 3 s, it rejects the reading and tries again.

The full code is saved at [firmware_tests/board4_wheel_stabilise/board4_wheel_stabilise.ino](../board4_wheel_stabilise/board4_wheel_stabilise.ino):
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
