itsmeabirmohanta/Sujal/source/VRITRA_CanSat_025_Handover_2026-10-28/06_chats/oct_2026_board_build/2026-10-26_58e2147c.md

# Chat session 58e2147c-7679-4781-8afd-23879e18e082.jsonl (started 2026-10-26T08:16:02.914Z)

---
**USER** (2026-10-26T08:16:02)

[summary of earlier part of the chat]
This session is being continued from a previous conversation that ran out of context. The summary below covers the earlier portion of the conversation.

<tools-used-before-summary>AskUserQuestion, Bash, Edit, Grep, Monitor, PowerShell, Read, SendUserFile, TaskStop, ToolSearch, WebFetch, WebSearch, Write, mcp__ccd_host__reveal_path, mcp__ccd_turn__update_plan, mcp__ccd_turn__wrap_up</tools-used-before-summary>
Summary:
1. Primary Request and Intent:
   **Project:** Team VRITRA CanSat (IN-SPACe CAN-7USAT 2026, team 2026-INSPACe-CAN-7USAT-025) flight electronics. All data lives under `D:\linux\Software\Claude\VRITRA_ZeroBoard_Memory\` (memory files 01–04, `routing\`, `etch_pcb\`, `kicad_single\`, `downloads\`, `firmware_tests\`).

   **Current board numbering and build method:**
   | Board | Name | Build |
   |---|---|---|
   | 1 | MAIN | etched PCB |
   | 2 | BACKUP + SENSOR | etched PCB |
   | 3 | POWER | zero board |
   | 4 | PARACHUTE | was a Ø110 round zero board; the user has now asked for a single-layer etched PCB version |
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
