itsmeabirmohanta/Sujal/research/extracted/guidelines_page_15.png

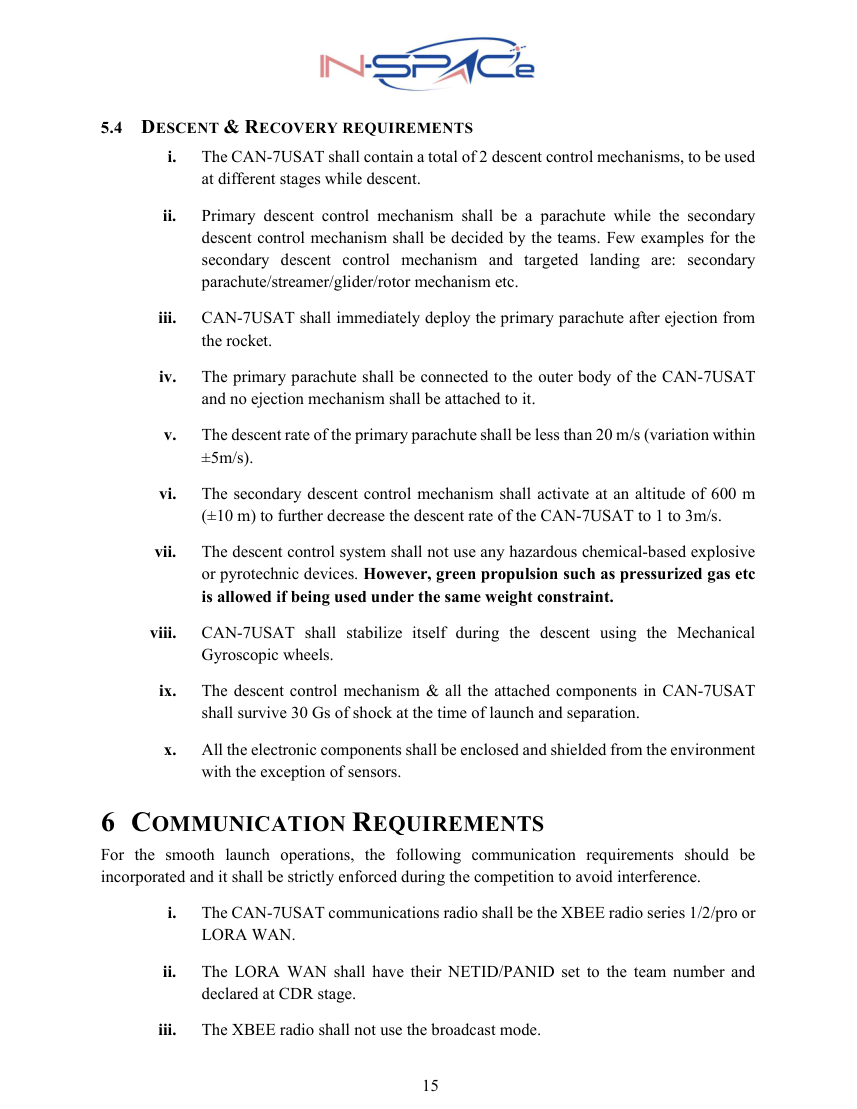
research/extracted/guidelines_page_15.png
