itsmeabirmohanta/Sujal/research/extracted/guidelines_page_16.png

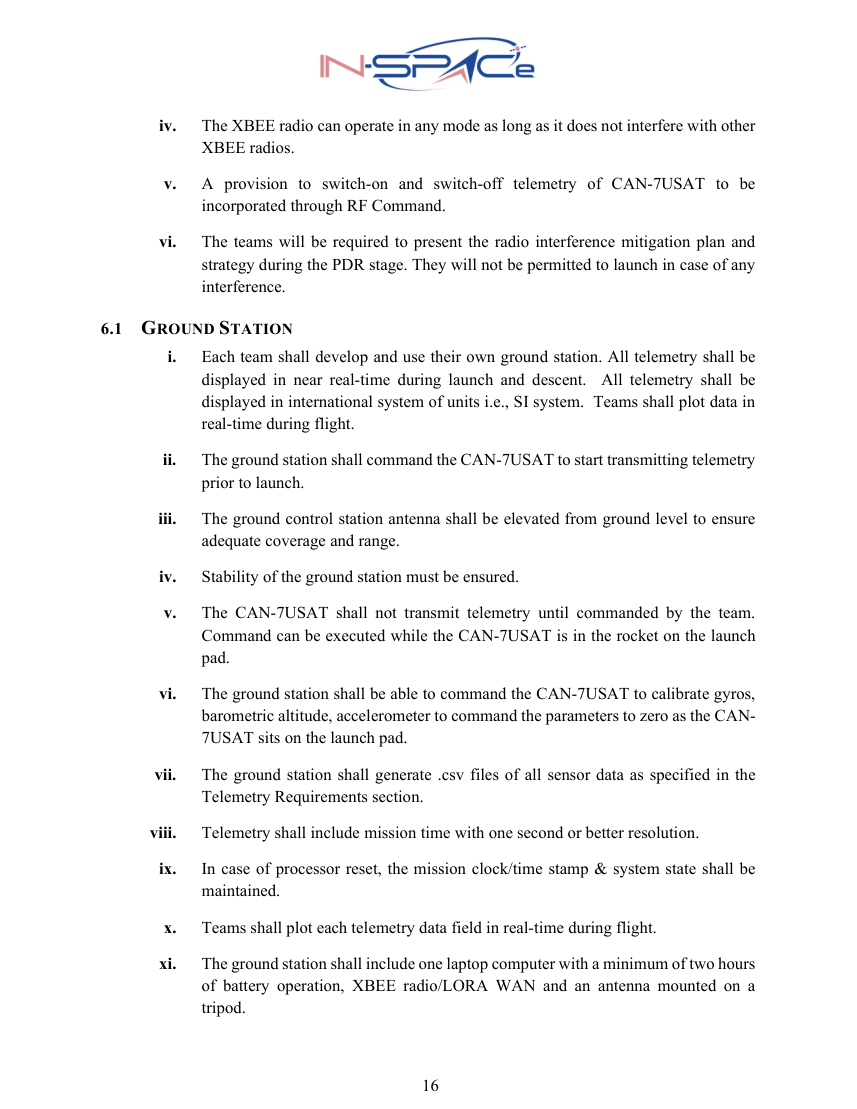
research/extracted/guidelines_page_16.png
