itsmeabirmohanta/Sujal/research/extracted/guidelines_page_17.png

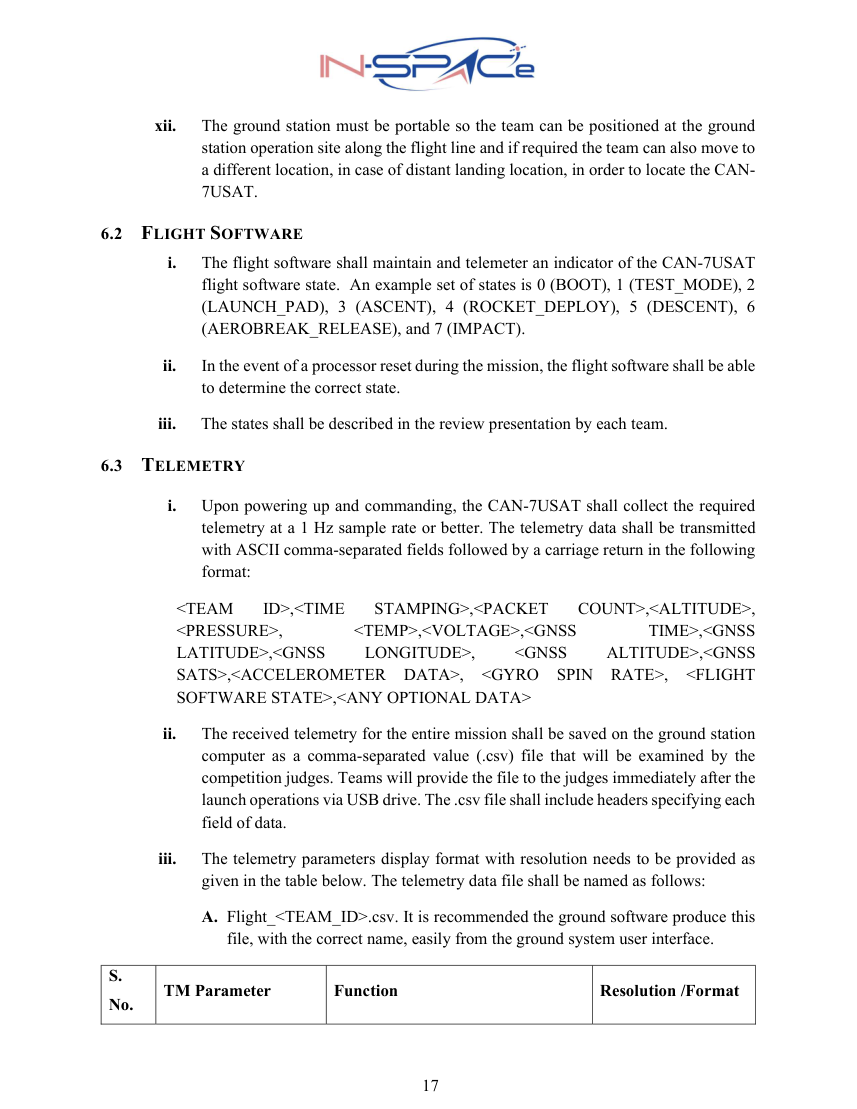
research/extracted/guidelines_page_17.png
