itsmeabirmohanta/Sujal/research/extracted/guidelines_page_18.png

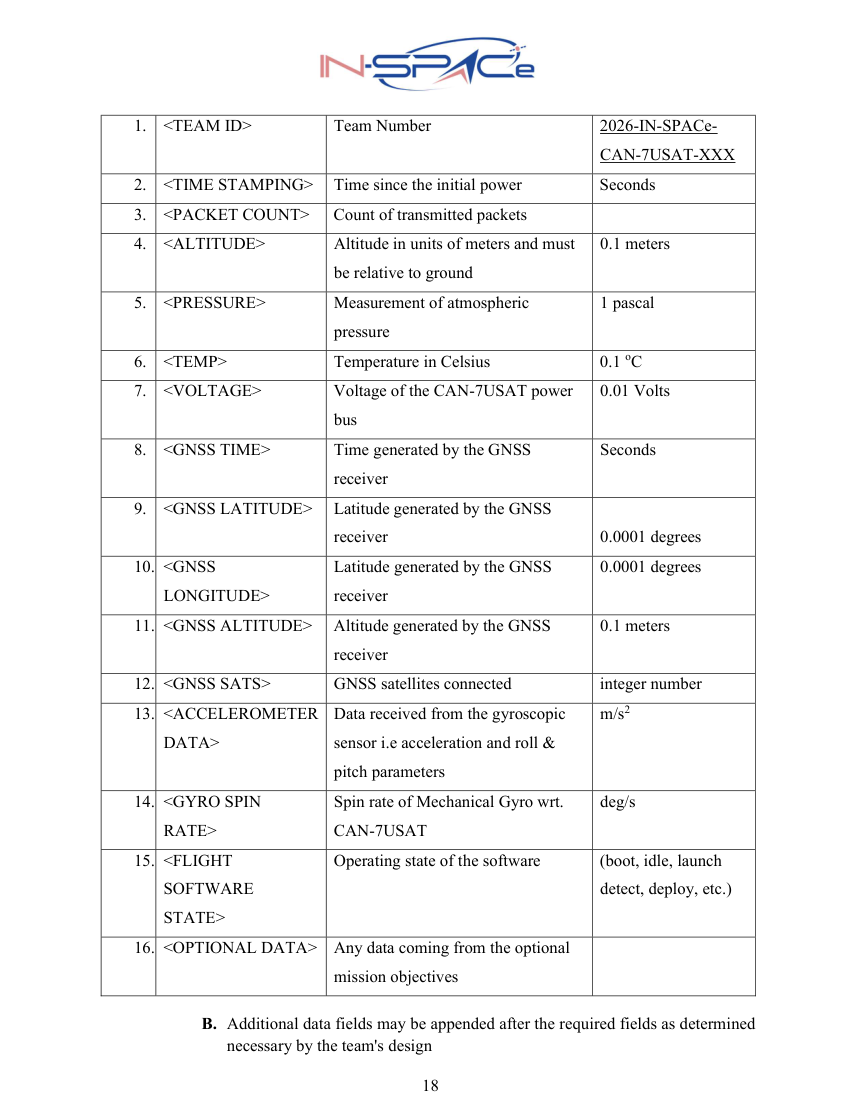
research/extracted/guidelines_page_18.png
