itsmeabirmohanta/Sujal/source/VRITRA_CanSat_025_Handover_2026-10-28/05_code/Cansat_Ground_station_v2_history_(August)/ansys/results/LinkMargin867.csv

off_nadir_deg | antenna_gain_dBi | margin_whip_dB | margin_yagi_dB
0 | -45.64 | 10.6 | 18.0
2 | -27.53 | 28.7 | 36.1
5 | -18.05 | 38.2 | 45.6
10 | -13.70 | 42.5 | 49.9
15 | -9.82 | 46.4 | 53.8
20 | -8.07 | 48.1 | 55.6
30 | -5.20 | 51.0 | 58.4
45 | -2.88 | 53.3 | 60.7
60 | -1.72 | 54.5 | 61.9
90 | 1.21 | 57.4 | 64.8
