itsmeabirmohanta/Sujal/source/VRITRA_CanSat_025_Handover_2026-10-28/05_code/Cansat_Ground_station_v2_history_(August)/ansys/results/CommSweep867.csv

Freq_MHz | S11_dB | VSWR
830.00 | -2.795 | 6.269
831.00 | -2.769 | 6.328
832.00 | -2.742 | 6.387
833.00 | -2.717 | 6.446
834.00 | -2.691 | 6.506
835.00 | -2.666 | 6.566
836.00 | -2.642 | 6.626
837.00 | -2.618 | 6.687
838.00 | -2.594 | 6.747
839.00 | -2.570 | 6.808
840.00 | -2.547 | 6.870
841.00 | -2.524 | 6.931
842.00 | -2.501 | 6.993
843.00 | -2.479 | 7.055
844.00 | -2.457 | 7.118
845.00 | -2.435 | 7.180
846.00 | -2.414 | 7.243
847.00 | -2.393 | 7.306
848.00 | -2.372 | 7.370
849.00 | -2.351 | 7.434
850.00 | -2.331 | 7.498
851.00 | -2.311 | 7.562
852.00 | -2.291 | 7.627
853.00 | -2.271 | 7.692
854.00 | -2.252 | 7.757
855.00 | -2.233 | 7.823
856.00 | -2.214 | 7.889
857.00 | -2.195 | 7.955
858.00 | -2.177 | 8.021
859.00 | -2.159 | 8.088
860.00 | -2.141 | 8.155
861.00 | -2.123 | 8.223
862.00 | -2.106 | 8.290
863.00 | -2.088 | 8.359
864.00 | -2.071 | 8.427
865.00 | -2.054 | 8.496
866.00 | -2.038 | 8.565
867.00 | -2.021 | 8.634
868.00 | -2.005 | 8.704
869.00 | -1.989 | 8.774
870.00 | -1.973 | 8.844
871.00 | -1.957 | 8.915
872.00 | -1.941 | 8.986
873.00 | -1.926 | 9.058
874.00 | -1.910 | 9.130
875.00 | -1.895 | 9.202
876.00 | -1.880 | 9.274
877.00 | -1.866 | 9.347
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
