itsmeabirmohanta/Sujal/source/VRITRA_CanSat_025_Handover_2026-10-28/05_code/Cansat_Ground_station_v2_history_(August)/ansys/results/Pattern867.csv

Phi_deg | Theta_deg | RealizedGainTotal_dBi
0.0 | 0.0 | -47.8819
0.0 | 2.0 | -28.8088
0.0 | 4.0 | -22.7791
0.0 | 6.0 | -19.2567
0.0 | 8.0 | -16.7661
0.0 | 10.0 | -14.8428
0.0 | 12.0 | -13.2799
0.0 | 14.0 | -11.9673
0.0 | 16.0 | -10.8394
0.0 | 18.0 | -9.8539
0.0 | 20.0 | -8.9821
0.0 | 22.0 | -8.2038
0.0 | 24.0 | -7.5040
0.0 | 26.0 | -6.8715
0.0 | 28.0 | -6.2977
0.0 | 29.999999999999996 | -5.7758
0.0 | 32.0 | -5.3004
0.0 | 34.0 | -4.8673
0.0 | 36.0 | -4.4729
0.0 | 38.0 | -4.1143
0.0 | 40.0 | -3.7892
0.0 | 42.0 | -3.4956
0.0 | 44.0 | -3.2316
0.0 | 46.0 | -2.9959
0.0 | 48.0 | -2.7873
0.0 | 50.0 | -2.6045
0.0 | 52.0 | -2.4466
0.0 | 54.0 | -2.3128
0.0 | 56.0 | -2.2021
0.0 | 58.00000000000001 | -2.1139
0.0 | 59.99999999999999 | -2.0473
0.0 | 62.0 | -2.0017
0.0 | 64.0 | -1.9764
0.0 | 66.0 | -1.9706
0.0 | 68.0 | -1.9837
0.0 | 70.0 | -2.0148
0.0 | 72.0 | -2.0633
0.0 | 74.0 | -2.1284
0.0 | 76.0 | -2.2092
0.0 | 78.0 | -2.3048
0.0 | 80.0 | -2.4144
0.0 | 82.0 | -2.5370
0.0 | 84.0 | -2.6715
0.0 | 86.0 | -2.8170
0.0 | 88.0 | -2.9721
0.0 | 90.0 | -3.1358
0.0 | 92.0 | -3.3069
0.0 | 94.0 | -3.4840
0.0 | 96.0 | -3.6658
0.0 | 98.0 | -3.8512
0.0 | 100.0 | -4.0387
0.0 | 102.0 | -4.2273
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
