itsmeabirmohanta/Sujal/source/VRITRA_CanSat_025_Handover_2026-10-28/07_memory/VRITRA_ZeroBoard_Memory/04_DECISIONS_CHANGELOG.md

# 04 — DECISIONS, OPEN QUESTIONS, CHANGE LOG, AI WORKING RULES

## AI working rules (non-negotiable — this is a flight project)
1. Read 01, 02 and 03 in full before answering any wiring/pin/code question.
2. Never assign a pin from memory alone. For every new/changed pin check, in order:
   capability (§0 of 03: UART/SPI/I²C/PWM/analog), conflict with an existing net, shared PWM submodule,
   voltage domain (3.3 V I/O, ICM-20948 1.8 V pins), boot/strapping pins (XIAO GPIO0/3/45/46, Teensy On/Off & Program),
   I²C address collision, power budget of the rail.
3. If a module fact is not verified (status U/Q in 02), say so and ask — do not guess.
4. Before editing code or a schematic: read the WHOLE file first, change only what was asked, log it here.
5. Radio parameters are fixed by the organiser: 866.50 / 865.25 MHz, SF9, BW125, CR4/5, sync 0x99.

## Answers received 2026-10-22 (second message)
A1 Boards stand ON EDGE along the can axis, held in 3D-printed slot mounts; rods Ø8. Boards are 120 W × 150 H rectangles.
A2 Owned: Core1121 ×2 (1 CanSat + 1 ground gateway), L89HA ×1 (on primary), **INA260 ×3 (7Semi)** — replaces INA226,
   AP64500 ×2, AP62301 ×2, XIAO ×1, NavIC GNSS antenna ×1 (SMA, 3–5 V active), T-antenna ×2, LoRa whip ×2,
   KCD1-5-103W rocker ON-OFF-ON ×4, XT60PW-F ×5, red + green LEDs.
A3 Core1121 = Waveshare Core1121 (LF/HF dual-band listing, link sku 31899). Pin labels verified from photo.
A4 microSD module = 6-pin CS/SCK/MOSI/MISO/VCC/GND with 74xx125 buffer + regulator (photo).
A5 RTC = DS3231 "MH" ZS-042 type, CR2032 fitted (photo) → remove charge resistor.
A6 No antenna for the M9N; the NavIC antenna is the only external GNSS antenna.
A7 Battery status: show as many power parameters as possible (FRR demands battery status).
A8 Bucks are fixed; steering servos get a SEPARATE 8 V multi-output buck; 5 V bucks for Teensy/other.
A9 Hall sensor and switch + LED owned. **User: "omit BMS, beacon".**
A10 Will buy a third BMP585. A11 MG90S #1 opens the ram-air bay (drogue stays attached) — rule-compliant.
A12 1.8 V regulator not needed. A13 YES — update radio constants (done 2026-10-22). A14 Power parts near the battery on a 5th board.

## Still open (asked 2026-10-22, third round)
Q15 Inner diameter + rod circle of the NEW structure, and free axial height for 150 mm boards (layout assumes Ø120 usable, rods on 94 mm circle).
Q16 Core1121 variant printed on the module: **HF** (850–930 MHz) is required; LF (410–510 MHz) cannot reach 866.5 MHz.
Q17 8 V multi-output buck model (DFR1015?) + size; Hall sensor model (A3144?); switch current rating printed on it.
Q18 Beacon: rule 5.2.v makes a ≥92 dB beacon MANDATORY and FRR checks "provisions". Omit for now or buy MAX98357A + speaker / active buzzer?
Q19 GNSS antenna: keep it spare (L89 on built-in antennas, D gets an L89 copy) or give it to the M9N?
Q20 Backup B has no radio — accept as logger only, or buy a 3rd Core1121?
Q21 7Semi INA260 A0/A1 pad options (photo of the back) to fix addresses 0x40/0x41/0x45.

A15 (2026-10-22) Structure: OD 130 mm, ID 120 mm, can height 400 mm, rods Ø8 mm. User cut the boards to 120×150 and
    mounts them in 3D-printed slots → layout uses the full board (rod circle still not given; fit inside the can is the user's call).
A16 "Treat the zero board like a real board"; show all connectors incl. GNSS BAT; show how the whole CanSat connects.

## Still open (round 4)
Q22 Diodes owned: are any Schottky (1N5819 / BAT54 / SS14)? D3/D4 on A need low-drop diodes.
Q23 GNSS backup cell: CR2032 or CR1220 holder with leads available? (J7 on A)
Q24 Connector type for the 13 cables: JST-XH 2.5 mm (fits 2.54 holes) or Dupont? Locking connectors recommended for 30 g shock.
Q25 Female headers for both Teensy 4.1 and the Teensy 4.0 (needed for USB/SD access and replacement)?

## Open questions round 1 (all answered above)
Q1 Board geometry: "vertical" = boards standing on edge along the can axis, or the stacked horizontal plates of the CDR? Inner diameter/rod positions in the new structure? Will the 12×15 boards be cut?
Q2 Quantities actually owned: LR1121, L89HA, INA226, AP64500, AP62301, XIAO, active GNSS antennas, T-antennas.
Q3 Exact LR1121 module (Waveshare Core1121-XF? Ebyte? other) — photo of pin labels.
Q4 microSD module type (photo) and which MCU it is for.
Q5 DS3231 module type (ZS-042?) and backup cell (CR2032 or LIR2032).
Q6 NEO-M9N breakout type; does it have its own antenna?
Q7 INA226 module shunt value (R100?) and whether current must be measured or only voltage.
Q8 Servo rail: AP64500 fixed 5 V or adjustable? Accept A20CLM at 5 V (6.8 kg·cm) or provide 7.4–8.4 V?
Q9 Beacon hardware, Hall sensor, power switch + LED, BMS — owned? which parts?
Q10 Third BMP585 for the Teensy 4.0, or let it receive altitude from the primary (single point of failure)?
Q11 MG90S #1 "release drogue": does it cut the primary parachute free at 600 m, or open the parafoil bay lid? (Rule 5.4.iv: primary must stay attached, no ejection mechanism on it.)
Q12 What is the 1.8 V regulator for?
Q13 Approve updating GCS + firmware radio constants to the 19-10 assignment (866.50/865.25, SF9, 0x99)?
Q14 Where do power board components (bucks, BMS, XT30) sit — on one of the 3 middle boards or near the battery?

## Decisions log
| Date | Decision | Source |
|---|---|---|
| 2026-10-22 | Zero-board build = 4 boards 12×15 cm double-sided; primary T4.1 + GNSS on outward-facing board; 1 board for parafoil steering | user |
| 2026-10-22 | Teensy 4.0 = parafoil controller; 2× A20CLM steer; MG90S #1 drogue release, MG90S #2 petri lid | user |
| 2026-10-22 | M9N belongs to the parafoil controller (CDR descent schematic) | CDR p33 |
| 2026-10-22 | Radio assignment changed by organiser to 866.50/865.25 MHz, SF9, sync 0x99 | freq PDF 19-10 |
| 2026-10-22 | **FRR = virtual, 26-10-2026, team 025 slot 10:34 AM** (Webex). Show demo videos + results: Mission GUI, Telemetry, Battery status & provisions; physical CanSat must be present. Launch 31-10 → 03-11-2026. | IN-SPACe mail 19-10 |
| 2026-10-22 | Board A follows the WORKING firmware vritra_fc pin map (LR1121 on SPI1 26/27/39, CS29 BUSY24 RST25 IRQ30; L89 Serial2 7/8 RST6; beacon SAI2 2/3/4 + SD37; VBAT divider A6=20). KiCad rev E pins dropped for the zero board. | AI, FRR timing |
| 2026-10-22 | 3 middle boards: A primary 100 mm wide (y=+24, faces out), B backup 84 mm (centre line, between rods at x=±47), C env 100 mm (y=−12, faces out). D parafoil, E power separate. | geometry calc, assumes Ø120 usable |
| 2026-10-22 | Power-monitor = INA260 ×3: #1 battery/main bus, #2 +8V_STEER, #3 +5V_LOGIC → GCS BUS_V, BUS_I_MA, SOC_PCT, SERVO_V, SERVO_I_MA, P_BUS, ENERGY_WH | user A2/A7 |
| 2026-10-22 | ICM-20948 #1 on A (firmware IMU), LSM6DSO32 on B (I²C 0x6A), ICM-20948 #2 on D | AI |

## Change log
| Date | File | Change |
|---|---|---|
| 2026-10-27 | **Correction: Boards 1/2 as built = `kicad_single/*_1L`** (not etch_pcb) | User's board2.zip Gerbers are BOARD2_BACKUP_SENSOR_1L (120x150). Camera wire picture redrawn from that file (U10 upright, U10B landing row). Board 1 _1L Teensy pins = etch copy (plus spare 16/17/22/23), so the board tests are unchanged; only comments fixed. The mux footprint is the rev E 7Semi SN74LV4052A board (STEP 10072); user says the mux they had was a different 7Semi model — irrelevant now, no mux fitted. |
| 2026-10-27 | **Code moved into the GCS repo** `vritra-gcs-master/firmware/board_tests/` + new `firmware/vritra_cam/` (XIAO camera) + `BOARD2_CAMERA_WIRES.png`; repo cleaned (simulation, drivers copies, PyInstaller build/, logs, old vritra_tx/esp32rec, old-freq backups moved to `Downloads/vritra-gcs_REMOVED_2026-10-27/`; CI simulation step + README tree updated) | User chose the repo as the code home. Camera: no mux, 2 wires on Board 2 U10 pads (TX1 to TX_COM top hole, RX1 to RX_COM). |
| 2026-10-27 | **FINAL FLIGHT BUILD = the 3 etched PCBs** (final PCB order will not arrive) — new `05_FINAL_BUILD_2026-10-27.md`, `firmware_tests/final/board1_main_test`, `board2_backup_test`, `board4_parachute_test` | User: no 7Semi mux (U10 empty), LSM on BACKUP misbehaves → not used (IMU from MAIN), only 1 INA260 (battery), drone drop from ~1 km + guided glide to 26.717535 N 84.301543 E (adjustable), petri open 10 s at 950 m above boot. Radio re-verified against the 19-10 PDF (025: 866.50/865.25 SF9 0x99). Last working code = vritra_fc 6.1.0 + vritra_gs 6.2.0 (Aug 10) + 19-10 freq edit in the GitHub copy. Pin maps dumped from the etched .kicad_pcb files into 05. Test sketches compile (Teensy 1.62 g++, RadioLib 7.7.1). Calibration to be done by the team's own method later — no standard calibration. |
| 2026-10-24 | **NEW NUMBERING + BUILD METHOD (user)** | Board 1 MAIN (key A) and Board 2 BACKUP + SENSOR (key B) = **ETCHED single-sided PCBs** (laser print → iron → etch), max 118 W × 150 H mm, height cut to the parts. Board 3 POWER (key E) and Board 4 PARACHUTE (key D) = **zero boards** (hole-format build lists, no Gerbers). Zero-board build reference: `kicad_single/BOARD<n>_<NAME>_1L/` (all 4 exist, DRC 0/0, pad nets = netlist; zips in `downloads/`). Etched work: `routing/etch_place.py` (real KiCad footprints, JST-XH 2.50 mm, off-grid mux pads with stub tracks), `etch_boards.py` (compact placement; MAIN drops spare J6/J9), `etch_router.py` (1.27 mm grid, 0.7 mm tracks, 1.8 mm servo power, ≥0.5 mm gaps, wire jumpers on the 0.1" grid, jumpers may run under header-mounted modules — fit them first), `kicad_etch.py` (round Ø1.8 pads, all holes 1.0 mm, GND copper fill, `.kicad_dru` etch rules), `fab_etch.py` (DRC, Gerbers B.Cu/B.Mask/F.Silkscreen/Edge.Cuts + drill, 1:1 TONER PDF of B.Cu printed NOT mirrored, placement PDF). |
| 2026-10-26 | **Board 4 as a single-layer etched PCB** (user) — `routing/board4_pcb.py` (netlist + routing search), `routing/kicad_board4_pcb.py` (export), `routing/BOARD4_PCB_ROUTED.json`, `etch_pcb/BOARD4_PARACHUTE_PCB/`, `downloads/BOARD4_PARACHUTE_PCB_GERBER_DRILL.zip` | User: servos unreliable through the 330 Ω parts, Boards 1/2 tracks+pads too thin (scratched open). Changes vs the zero board: NO series resistors on any signal (R1–R5, R9 servo/ESC, R7/R8 UART removed; pins straight to plugs; TX2 pin 8 goes straight to MAIN J2.1 and BACKUP J3.1), R6 10k Hall pull-up kept. Ø110, rod holes Ø8.3 (94 mm circle), ALL component holes 1.4 mm, pads 2.2 mm (pin 1 square), tracks 1.0 signal / 1.5 GND-5V-3V3 / 2.0 servo power, GND fill (islands removed), 4 wire jumpers (seed 37). Checks: KiCad DRC 0/0 (clearance rule 0.3 mm — smallest gap is the 0.34 mm between neighbouring 2.2 mm header pads, every track ≥0.44 mm from foreign pads), 100/100 pads = netlist, 0 F.Cu, GND connected without the fill, drill file T1 1.4 / T2 8.3 only. |
| 2026-10-25 | **Board 4: ICM-20948 → Adafruit LSM6DSO32** (user; rest of the board already soldered) — `routing/rework_d_lsm.py`, `routing/BOARD4_ROUTED.json` (FROZEN copper, `boards.ROUTE_FROZEN`), `REWORK_BOARD4.md`, `kicad_single/BOARD4_PARACHUTE_1L/` (old ICM version in `kicad_single/_board4_with_icm/`) | All other parts, trails and the 5 wire links kept exactly. LSM6DSO32 front row on R31, VIN C28 (3V3) · 3Vo C29 open · GND C30 · SCL C31 · SDA C32 · DO C33 → GND (0x6A) · CS C34 → 3V3 (I²C) · INT1/INT2 open; back 5-pin row not fitted (holes C30..C34 R36 empty). Rework: 29 trail steps cut, 20 added, 7 old ICM-1V8 steps now GND; old links LK3 (SDA) and LK4 (SCL) reused; 0 new links. `board_d(imu="ICM")` reproduces the original build. KiCad DRC 0/0 with `pth_inside_courtyard` ignored for Board 4 only (fitted link LK1 ends under the LSM edge; LSM stands on its header), pad nets = netlist, cables 11/0, audit 0 (D I²C: BMP585 0x47 + LSM6DSO32 0x6A). Firmware TODO: parachute IMU driver = LSM6DSO32 at 0x6A. |
| 2026-10-24 | **Board 4 PARACHUTE = ROUND Ø110 mm zero board** (user) — `routing/boards.py` `board_d` + `PARTS_D`, `kicad_single/BOARD4_PARACHUTE_1L/`, `downloads/BOARD4_PARACHUTE_zero_board.zip` | Grid 43×43 holes (C22 R22 = centre). 4 rod holes Ø8.2 on the 94 mm circle (ASSUMED from the CDR structure — user to confirm the rods pass through this disk; `ROD_ANGLES_D` 0/90/180/270°). Teensy 4.0 lies flat across the middle (pad 1 at C15 R23, USB to the left edge) so pins 0, 2..10 drop straight to the plugs below in pin order; servo headers in one row (S top, + middle, − bottom → straight 8 V / 5 V / GND lines); BMP585 + ICM-20948 + logic power on top; Hall plug, UART-to-BACKUP plug on the right. Servos, Hall sensor, ESC all OFF the board (plugs only). Routing order chosen by multi-start search (`zb_router1.route1(seed=…)`, `ROUTE_SEED = {"D": 24}`): 5 wire links, 553 trail holes. KiCad DRC 0/0, pad nets = netlist, cables 11/0, audit 0. Engine: `zb_engine` round-board support (`b.round`, `b.rods`, `round_fit`, pins must be inside the copper area), exporter draws the circle + NPTH rod holes. Rectangular version archived in `kicad_single/_rect_parachute_before_round/`. |
| 2026-10-24 | `routing/boards.py` (D = Board 4 PARACHUTE, zero board) | **Servo plugs = normal 2.54 mm 3-pin headers** (user), − + S, 3 rows apart: J10 A20CLM LEFT (+8V_STEER, R1 330 → T4.0 pin 2), J11 A20CLM RIGHT (+8V_STEER, R2 → pin 3), J12 MG90S #1 PARACHUTE BAY (+5V_SERVO, R3 → pin 4), J13 MG90S #2 PETRI PLATE (+5V_SERVO, R4 → pin 5), **J16 MG90S #3 EXTRA (new, +5V_SERVO, R9 330 → pin 10)**. ESC J14 (pin 6), Hall J15 (pin 9), power / UART / GNSS plugs stay JST-XH. Table: `routing/SERVO_CHECK.md` (generated from the netlist). Re-routed: 7 wire links, DRC 0/0, pad nets = netlist; cables 11/0; audit 0. Firmware TODO: servo on pin 10. Downloads now one zip per board: `downloads/BOARD1_…GERBER_DRILL.zip`, `BOARD2_…GERBER_DRILL.zip`, `BOARD3_POWER_zero_board.zip`, `BOARD4_PARACHUTE_zero_board.zip` (`routing/make_zips.py`). |
| 2026-10-24 | **ETCHED RESULT** `etch_pcb/BOARD1_MAIN`, `etch_pcb/BOARD2_BACKUP_SENSOR`; download `downloads/VRITRA_BOARD1_BOARD2_GERBER_DRILL.zip` | Board 1 MAIN 118×150 (the very compact layout could not be routed single-sided — 101 jumpers + conflicts — so MAIN uses the proven zero-board placement on etched rules, J6/J9 dropped), 39 jumpers. Board 2 BACKUP+SENSOR 118×92 (mux turned sideways at C8 R27), 35 jumpers. KiCad DRC all severities 0 violations / 0 unconnected; reload: pad nets = netlist, 0 F.Cu. Accepted (severity ignore): silk cosmetics and `pth_inside_courtyard` (jumpers under header-mounted modules — fit jumpers FIRST). Every JST header has ≥1.5 mm free board around it (`jst_room`). One drill size 1.0 mm. Toner print: `*_TONER_bottom.pdf` (1:1, NOT mirrored), jumper list in `*_BUILD_NOTES.md`. |
| 2026-10-24 | `routing/boards.py` (D, E) | Parachute: every plug JST-XH (servo plugs 3 rows apart for the housings); 8 V steer input is 4-pin (+8V, +8V, GND, GND) because one XH contact is 3 A and two A20CLM can stall above that; POWER J8 matches (4-pin JST), J9 5 V servo JST moved to C35 R9. Cables 11/0 mismatches. Backups `boards.py.bak_before_etch`, `.bak_before_zeroD_jst`. The etched parachute version that was made first is parked in `etch_pcb/_not_used/`. |
| 2026-10-24 | **BOARD MERGE (user): 4 boards now.** `routing/boards.py` + helpers; `kicad_single/BOARD<n>_<NAME>_1L/` = BUILD REFERENCE | User: "board 1 is ok … merge board 2 and 3, 4 will be of power and 5 will be of parachute control", only sensors the team owns. **Board 1 MAIN** (old A) unchanged — its J6 (Wire1 I²C) and J9 (analog) are now SPARE, leave unfitted. **Board 2 BACKUP + SENSOR** (old B + C): Teensy 4.1 #2, BMP585 #2 (0x47), LSM6DSO32 (0x6A), **HDC3020 (0x44, cable wires M1L on Wire = pins 18/19, 3V3_B)**, 7Semi mux + camera plug J4, **microSD module U11 moved here from PARACHUTE: CS 10, SCK 13, MOSI 11, MISO 12 (SPI, alone on the bus), VCC 5 V** — the backup Teensy is the black-box logger; PARACHUTE data reaches it over W12 (firmware). Env sensors MQ-131 ozone, UV, spare I²C sockets DROPPED (user does not own them). Dashed 2nd Core1121 removed. **Board 4 POWER** (old E): J11 (5 V to sensor board) removed. **Board 5 PARACHUTE** (old D): SD removed, Teensy 4.0 pins 10–13 now free. Cables W8, W13, W14 deleted (11 cables, all straight-through, 0 mismatches). Old 5-board single-layer set archived in `kicad_single/_old_5_boards/`. Results: links Board1 59, Board2 19, Board4 18, Board5 8; KiCad DRC all severities 0 violations / 0 unconnected on all 4; reloaded pad nets match netlist, 0 F.Cu tracks (`routing/check_single.py`). audit 0 findings. Backup: `boards.py.bak_before_merge`. 2-layer set in `kicad/` NOT regenerated (still the old 5 boards). |
| 2026-10-22 | `vritra-gcs-master/gcs/vritra_gcs.py` | Added COM-port auto-detect (§11b: `probe_port`, `PortAutoDetect`; toolbar **Auto-detect** button; auto-scan when LIVE starts with no port). Read-only probing, gateway banner `[VRITRA-GS]` wins over raw telemetry. Original saved as `vritra_gcs.py.orig_before_autodetect`. Tested: unit tests + offscreen GUI scan/connect PASS. |
| 2026-10-22 | this folder | Created (01–04). Pin map 03 = DRAFT v0.1. |
| 2026-10-22 | GCS `vritra_gcs.py` + firmware `vritra_fc/Config.h`, `vritra_gs.ino`, `esp32rec.ino`, `vritra_tx.ino`, `cdr_tests/test_rf_rx`, `test_rf_tx` | Radio constants → 866.50 / 865.25 MHz, SF9, sync 0x99 (GCS sensitivity −129.5 dBm @ SF9). Airtime comments for SF10 kept and annotated as upper bounds. RF tests backed up as `*.orig_before_freq19-10`. Not yet flashed / not RF-tested. Note: `vritra_tx.ino` and `esp32rec.ino` still use TX_POWER 22 dBm (> +14 dBm allowed) — use vritra_fc / vritra_gs for flight. |
| 2026-10-22 | `layout/make_layout.py` + 7 PNGs | To-scale placement sheets on full 120×150 boards with trim strips, cross-section, harness overview. |
| 2026-10-22 | `03_PIN_MAP_AND_WIRING.md` | Rewritten as v0.2 (firmware-matched board A, boards B–E, power tree, harness). |
| 2026-10-24 | **`kicad_single/ZB_<X>_<NAME>_1L/` = BUILD REFERENCE (user wants SINGLE layer)** | `routing/zb_router1.py` + `kicad_export1.py`: ALL copper on B.Cu (solder trails, straight + 90° only), crossings by straight WIRE LINKS LKn (KiCad footprints with jumper pads, SetDuplicatePadNumbersAreJumpers). Physical link rules (router + checker): link ends only in empty holes ≥ pad radius outside every part; link never passes over a pin or a flat part (only under a Teensy on female headers); no link chained to a link; one link end per hole; no U-turns. LINK_COST 80 (MAIN 62→59 links). Result links: MAIN 59, BACKUP 10, SENSOR 4, PARACHUTE 10, POWER 18. KiCad DRC all severities: 0 violations, 0 unconnected on all 5; reloaded files: pad nets match design, 0 F.Cu tracks. Images `_1L_KiCad.png`, build lists `_1L_BUILD_LIST.md`. The 2-layer set in `kicad/` stays as an alternative. |
| 2026-10-24 | `kicad/ZB_<X>_<NAME>/` (2-layer alternative) | User: images "missed some traces" (single-layer sheets drew power as pale MST wires that looked missing). New `routing/zb_router2.py` routes EVERY net incl. power on 2 layers (B.Cu = bottom solder trail, F.Cu = insulated wire on top along holes, via = wire through an empty hole) and raises instead of leaving anything open. `routing/kicad_export.py` (run with KiCad's python) writes a real KiCad 10 project per board: 120×150 Edge.Cuts rectangle, hole grid on User.Drawings, footprints with pads on the exact holes + pin names, nets, tracks, vias; plus `<board>_BUILD_LIST.md` (hole runs per net) and `<board>_KiCad.png` (exported by kicad-cli). KiCad DRC, all severities: A/B/C/D/E 0 violations, 0 unconnected. Reloaded each .kicad_pcb: pad nets match boards.py exactly (0 mismatches). PARACHUTE servo headers now 1 empty row apart (rows 38/36/34/32/30, Hall 28, R6 row 26) — the stacked headers boxed the "+" pins in. Old single-layer images moved to `routing/old_superseded_single_layer/`. |
| 2026-10-23 | `routing/audit.py` (new) | Independent audit (no router): supply rails per module, no Teensy pin on 5V/8V/VBAT, ≥2 pins per net, no two drivers per net, I²C address uniqueness, MAIN pins vs vritra_fc Config.h (LoRa, GNSS, I²C, beacon). Result 0 findings on all 5 boards. |
| 2026-10-23 | open question | User wants the mux to also hand the SPEAKER to BACKUP when MAIN dies. The 7Semi mux switches only 2 lines (one TX/RX common) and is used by the camera; the MAX98357A needs 3 I²S lines (DIN, LRC, BCLK) + SD. Proposed: 74HC157 (DIP-16 quad 2:1 selector) with amp + selector moved to BACKUP and MAIN's I²S sent over a JST-5 (DIN, LRC, BCLK, SD, GND); or 2 more 7Semi muxes. Awaiting user choice. microSD module = PARACHUTE board U7 (T4.0 pins 10/11/12/13, VCC 5 V) = system black box, CSV log (opens in Excel) — firmware not written. User says Board 1 is soldered — asked for photos to check. |
| 2026-10-23 | `routing/boards.py` (PARACHUTE) | ESC is a **Cyclone 45A BLHeli_S 2–6S** (user; replaces "40 A ESC"). Its 2 thin wires (GND, signal) → new 2-pin plug J14 on PARACHUTE (− at C3 R33, S at C4 R33), S ← 330 Ω R5 ← Teensy 4.0 pin 6. Thick +/− go to POWER board ESC pads (after switch, fuse, INA260 #1) — user currently has it straight on the battery: advised to move it. Motor direction = BLHeli_S setting (normal / reversed / bidirectional 3D), not wiring. Re-verified D 0 problems (4 hops), cables 14/0, `D_COMBINED.png`. Risk: spin-up current vs 10 A fuse / INA260 15 A / rocker switch rating → firmware soft-start ramp + measure. |
| 2026-10-23 | `routing/boards.py` (MAIN + BACKUP) | **Camera + mux + amp.** User: camera never transmits video, MAIN Teensy commands "start recording" and the XIAO keeps recording no matter what; user owns a **7Semi 4-ch UART mux** (BO-10145) and the **Adafruit MAX98357A** amp. Done: (1) MAIN Serial1 = camera command UART: pin 1 TX →1k R11→ J5.3, J5.4 → pin 0 RX. MAIN↔BACKUP cable W9 is now JST-5: HB, GNSS, CAM_TX, CAM_RX, GND. (2) Mux U10 on BACKUP: ch1 TX1/RX1 = MAIN (via W9), ch2 TX2/RX2 = BACKUP Serial8 (35 TX via 1k R2, 34 RX via 1k R3), common TX/RX (bottom row, off-grid → 5 wires to U10B landing holes) → 1k R9/R10 → camera plug J4. Select A=pin5, B=pin6, C=pin9, each 10k pull-down → default ch1 = MAIN even if BACKUP is asleep/dead. Mux 3V3 = +3V3_B, DIP switches OFF, VCC jumper 3V3. ASSUMED 4052-type bidirectional switch, A=B=C=0 → ch1 — verify chip marking / with a meter. (3) MAX98357A U9 on MAIN on the firmware's existing pins: DIN 2, LRC 3, BCLK 4, SD 37, Vin 5V, GAIN → 100k → GND (15 dB), 100 µF on Vin; speaker on the amp's own screw terminal. Verified: A 0 problems (38 hops), B 0 problems (6 hops), cables 14/0. Backup of previous: `boards.py.bak_before_cam_amp`. |
| 2026-10-23 | firmware TODO (not done) | MAIN vritra_fc: drop Serial1 from GNSS auto-detect (GNSS_PORT_B) and PIN_BMP_INT=0 (pin 0/1 are now the camera UART); FLASH_CS 9; UV 22; Serial3 link to PARACHUTE; heartbeat pin 5; LEDs 31/32; INA260 ×3; camera "REC" command. XIAO: Wi-Fi/BT off, start on "REC", never stop once started, also auto-start after boot if no command within N s (decide). BACKUP: heartbeat watch on pin 4, takeover = mux A=1 (ch2) + re-send REC. PARACHUTE: use L89 NMEA (pin 0) + MAIN data (Serial2) + own sensors for precision landing. |
| 2026-10-23 | `routing/boards.py` (BACKUP) | User photo of the Adafruit LSM6DSO32: 9-pin front row (VIN 3Vo GND SCL SDA DO CS I1 I2) + 5-pin back row (SCX SDX CS DO GND) = 14 holes (user said 13). Back row (C33–C37 R49) now placed as unused pins so no trace uses those holes; re-verified B 0 problems, cables 0, back-row holes untouched. Solder only the front row. |
| 2026-10-23 | `routing/combined_view.py` → `A/B/C_COMBINED.png` | ONE picture per middle board (MAIN, BACKUP, SENSOR): parts + every pin + every solder-side line (seen through, NOT mirrored) + power wires + plain-word colour legend. Built from boards.py + router; refuses to draw if verify/fit fails. Sensor-board reserved (future) areas moved to the empty lower half. These three images are the build reference the user asked to keep. |
| 2026-10-23 | `routing/boards.py`, `system_view.py`, `easy_list.py` | All board-to-board connectors are JST-XH 2.5 mm, 2–4 pins (user: "JST 2 to 5"), real housing size (2.45 mm past end pins, 5.75 mm deep) in the fit check. 6-pin MAIN→SENSOR plug split: MAIN J6 / SENSOR J1 = JST-4 (SDA1, SCL1, 3V3, GND), MAIN J9 / SENSOR J7 = JST-3 (O3, UV, GND) → cable W14 added. Moved: DS3231 to C32, R7/R8 one column right, B/D left-edge plugs to column 3. Re-verified: 5 boards 0 problems, 14 cables 0 mismatches. `EASY_CONNECTIONS.md` = plain-language list (MAIN/BACKUP/SENSOR/PARACHUTE/POWER board names). Backup of pre-change boards.py: `boards.py.bak_before_jst`. |
| 2026-10-22 | `routing/pin_tables.py` → `MODULE_PIN_TABLES.md` | Per-module pin tables for all 5 boards, generated from boards.py: every pin, hole, signal, destination; resistors/diodes/caps written leg by leg (hole + far end); unused pins marked "leave open" with reason. |
| 2026-10-22 | `routing/` (new) | Hole-grid placement + router for all 5 boards on full 120×150 boards (`zb_engine.py`, `boards.py`, `system_view.py`). Pads from the team's KiCad footprints (all used modules on the 2.54 grid). Result: A/B/C/D/E 0 problems; hops A 20, B 0, C 3, D 4, E 0; 13 cables, 0 pin mismatches. Pin-map v0.3 deltas listed in 03. Firmware still needs: FLASH_CS=9, UV=22, Serial3 link, heartbeat, INA260 driver, LEDs 31/32. |
| 2026-10-22 | `gcs/VRITRA_GCS.spec` | Fixed exe start-up crash "DLL load failed while importing pyexpat": PyInstaller had bundled `libexpat.dll` from the Oracle DB home on PATH (`Downloads\WINDOWS.X64_213000_db_home\bin`). Spec now puts the Python install's own DLL dirs first on PATH and aborts the build if libexpat comes from anywhere else. Rebuilt exe verified: starts, window up after 15 s. |
| 2026-10-27 | Board 4 Teensy 4.0 died (etched board short) → ESP32-P4-WIFI6 on a rectangular zero board; pin map in 05 | user |
