itsmeabirmohanta/Sujal/research/release_notes.md

The deep-research handoff was checked against the original VRITRA prompt, corrected and organized for cross-team review. Start at the repository README and `deliverables/DELIVERABLE_AUDIT.md`.

Included:45-row prompt coverage, canonical engineering report and HTML, sensor/GNSS design, byte-level ICD, GCS migration brief, module implementation status,32 numeric evidence families,20 requirements, test evidence template, action plan, launch checklist and open questions. Host C++/Python tests and20 package checks passed. All812 supplied source files are preserved byte-for-byte.

Download `VRITRA_RESEARCH_HANDOFF.zip` for the compact deliverables and `VRITRA_CanSat_025_Handover_2026-10-28.zip` for the original supplied archive. The repository also contains its extracted source, including chats and notes as explicitly authorized for public sharing. `SHA256SUMS.txt` identifies the release files.

The code is checked reference logic and integration contracts, not a flight-qualified firmware release. Platform integration, hardware tests and unavailable vendor/component evidence remain explicitly pending. No achieved landing accuracy or physical acceptance result is claimed.
