itsmeabirmohanta/Sujal/source/VRITRA_CanSat_025_Handover_2026-10-28/08_archive_zero_board_workspace/VRITRA_ZeroBoard_Memory/etch_pcb/BOARD4_PARACHUTE_PCB/BOARD4_PARACHUTE_PCB_PLACEMENT_top.pdf

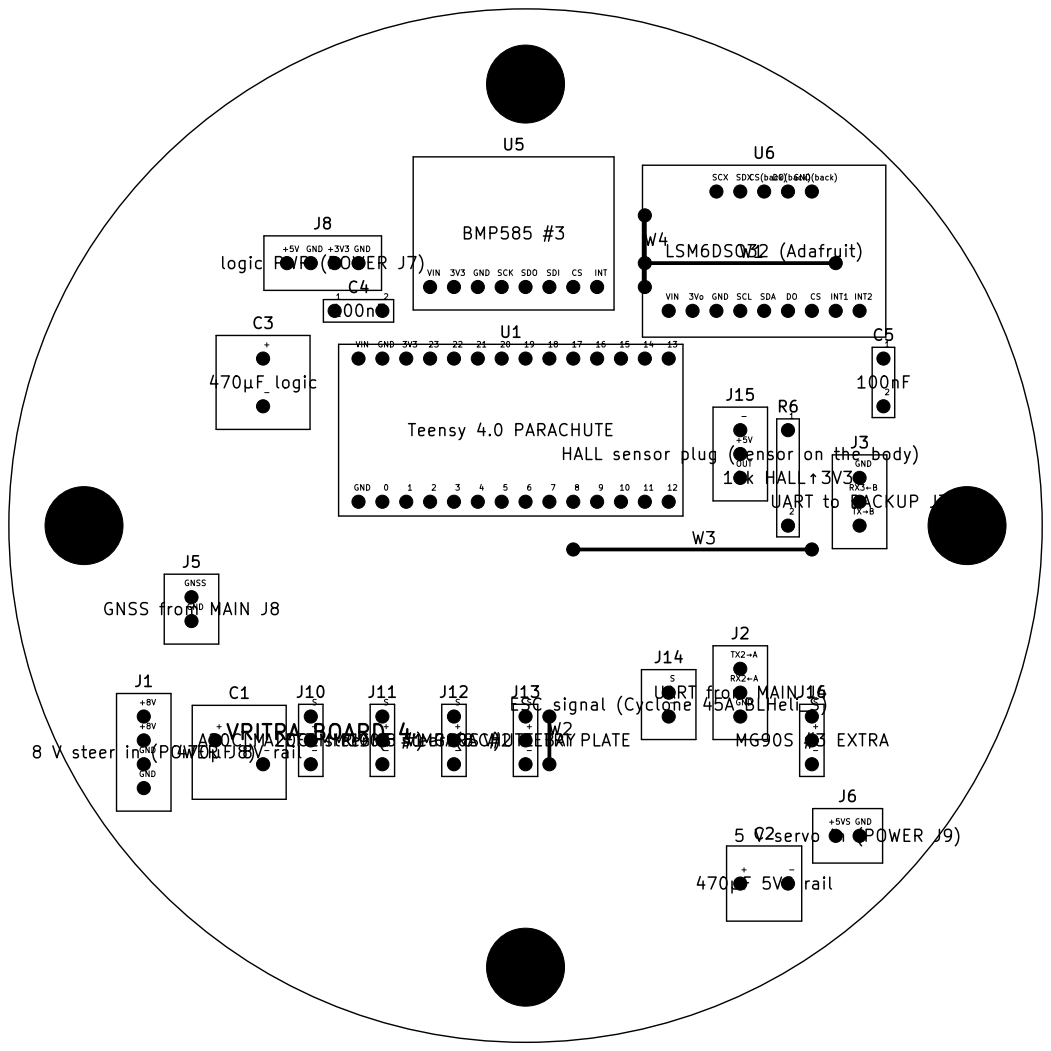
[picture p32: page 1]

GND(back) CS INT1 INT2 GNSS from MAIN J8

SCLCS(back) SDADO(back) DO
SDX

VIN 3V3 GND SCK SDO SDI CS INT ROD3
