itsmeabirmohanta/Sujal/source/VRITRA_CanSat_025_Handover_2026-10-28/08_archive_zero_board_workspace/VRITRA_ZeroBoard_Memory/etch_pcb/_not_used/BOARD4_PARACHUTE_etched_not_used/BOARD4_PARACHUTE_PLACEMENT_top.pdf

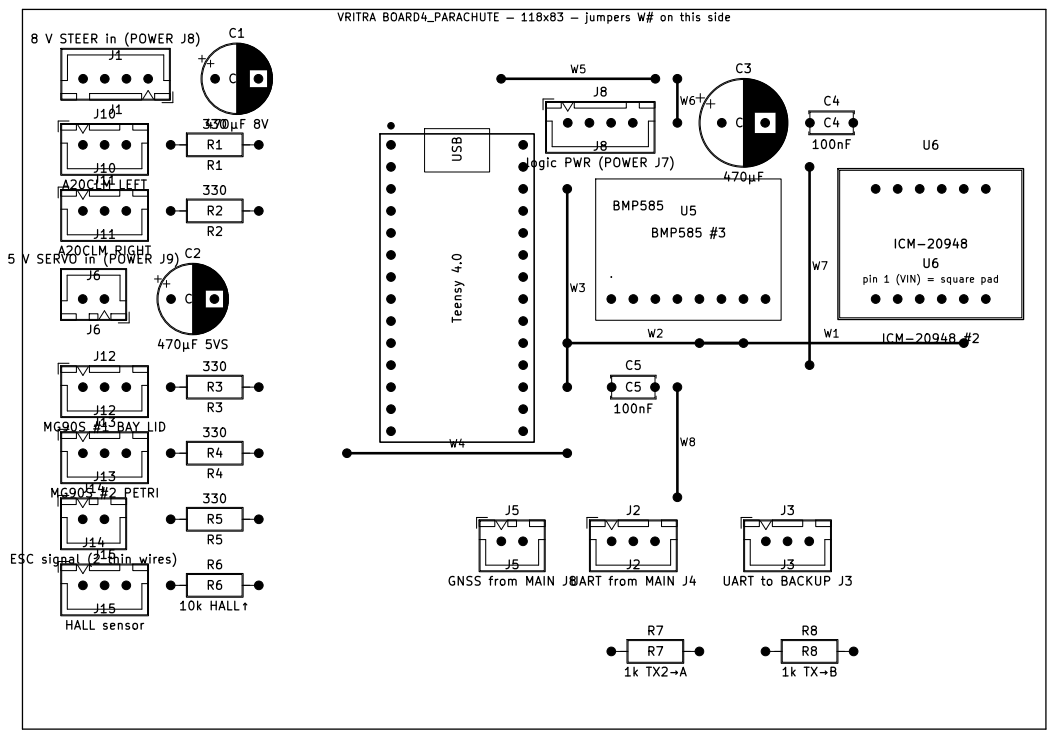
[picture p33: page 1]

VRITRA BOARD4_PARACHUTE — 118x83 — jumpers W# on this side W8

pin 1 (VIN) = square pad 330 R1
