itsmeabirmohanta/Sujal/source/VRITRA_CanSat_025_Handover_2026-10-28/08_archive_zero_board_workspace/VRITRA_ZeroBoard_Memory/etch_pcb/BOARD1_MAIN/BOARD1_MAIN_PLACEMENT_top.pdf

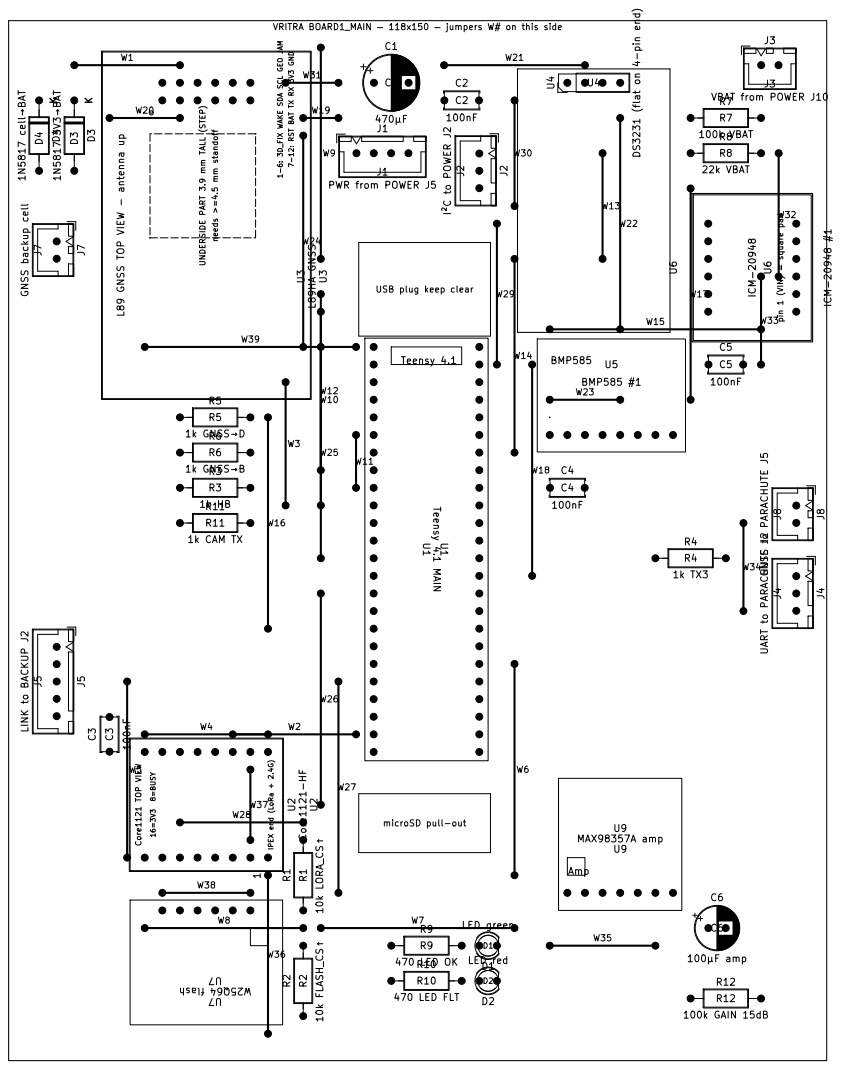
[picture p34: page 1]

USB plug keep clear microSD pull-out
