itsmeabirmohanta/Sujal/source/VRITRA_CanSat_025_Handover_2026-10-28/08_archive_zero_board_workspace/VRITRA_ZeroBoard_Memory/etch_pcb/BOARD2_BACKUP_SENSOR/BOARD2_BACKUP_SENSOR_TONER_bottom.pdf

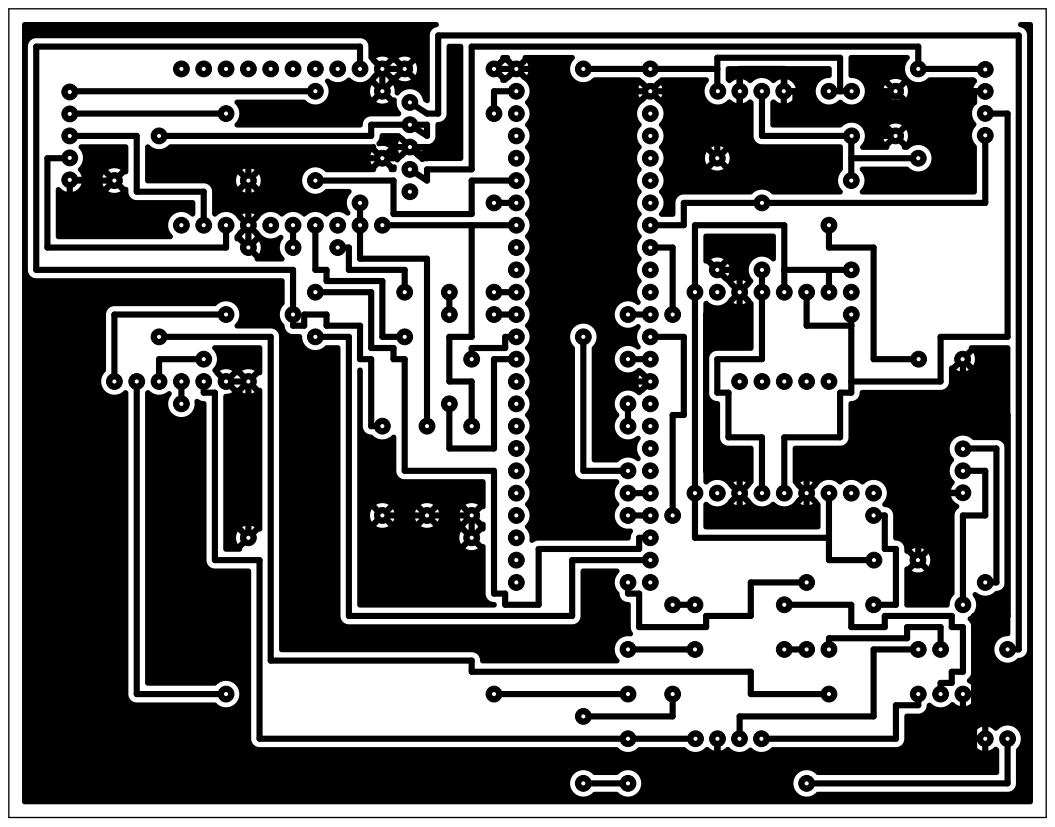
[picture p37: page 1]
