itsmeabirmohanta/Sujal/source/VRITRA_CanSat_025_Handover_2026-10-28/08_archive_zero_board_workspace/VRITRA_ZeroBoard_Memory/etch_pcb/BOARD4_PARACHUTE_PCB/BOARD4_PARACHUTE_PCB_TONER_bottom.pdf

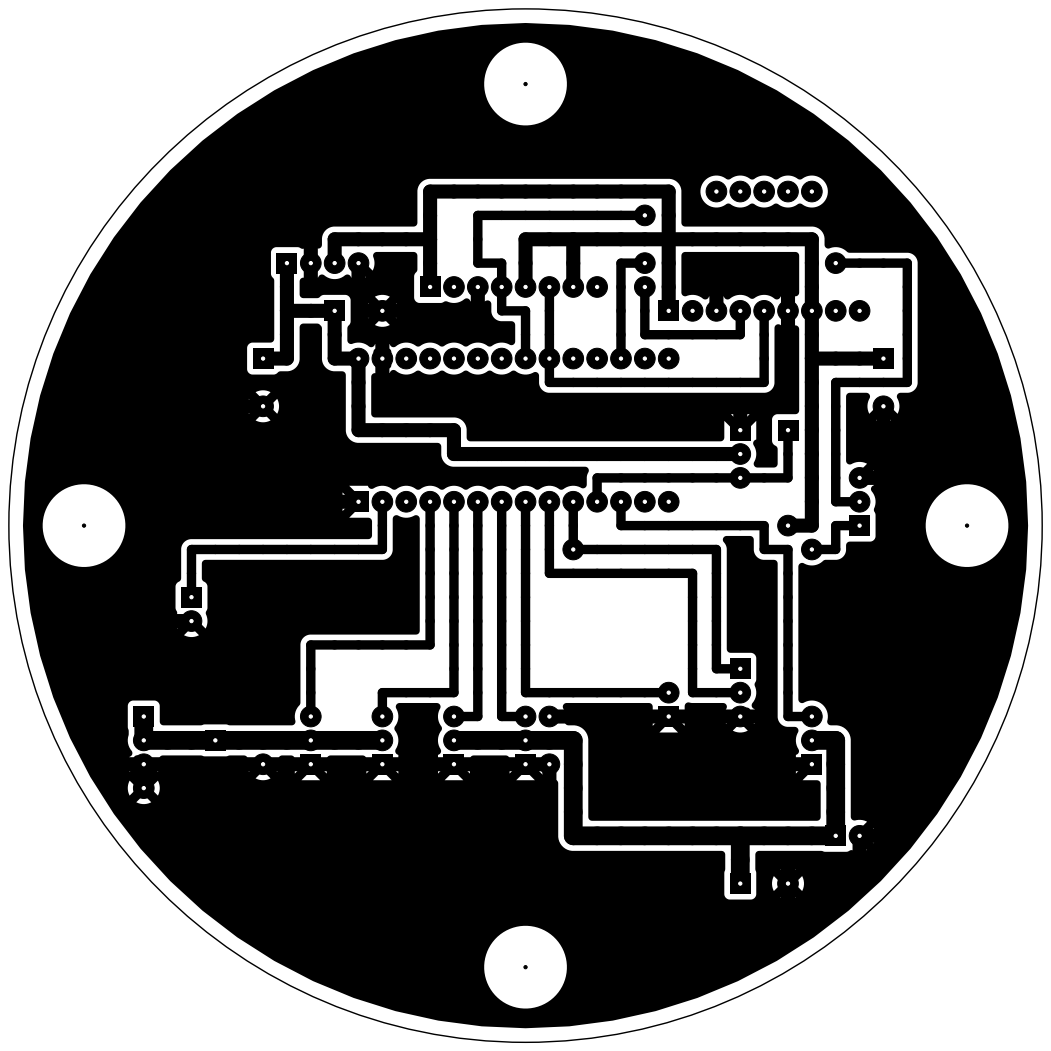
[picture p38: page 1]
