itsmeabirmohanta/Sujal/source/VRITRA_CanSat_025_Handover_2026-10-28/08_archive_zero_board_workspace/VRITRA_ZeroBoard_Memory/etch_pcb/_not_used/BOARD4_PARACHUTE_etched_not_used/BOARD4_PARACHUTE_TONER_bottom.pdf

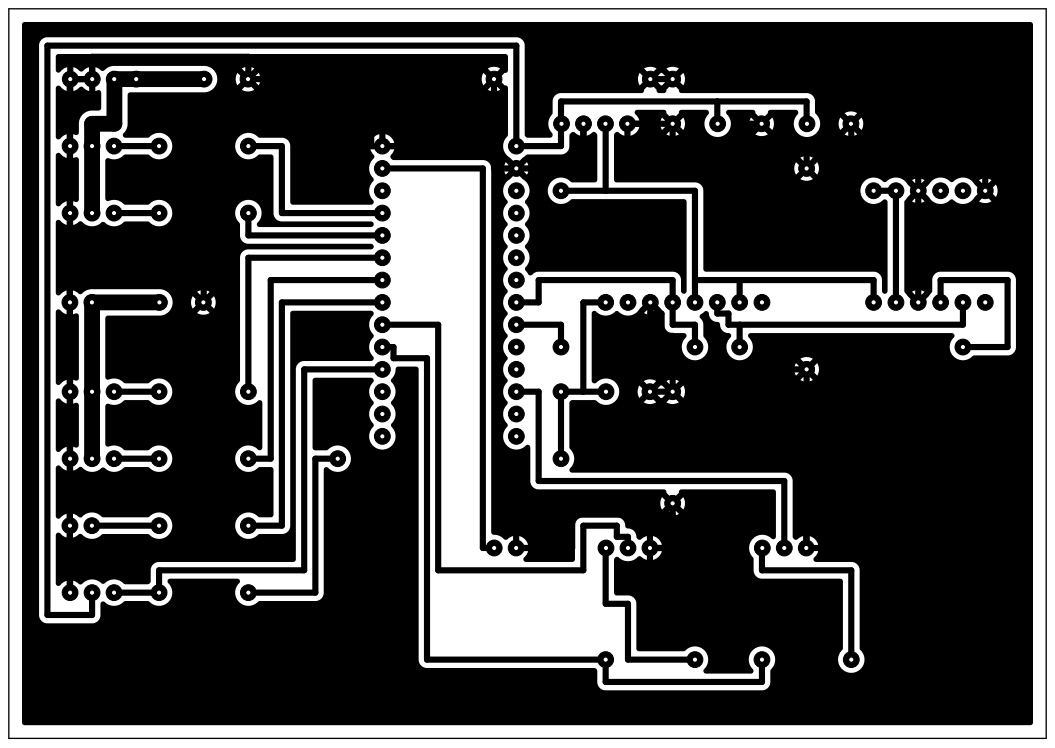
[picture p39: page 1]
