itsmeabirmohanta/Sujal/source/VRITRA_CanSat_025_Handover_2026-10-28/08_archive_zero_board_workspace/VRITRA_ZeroBoard_Memory/etch_pcb/BOARD1_MAIN/BOARD1_MAIN.kicad_pcb

## KiCad design source/VRITRA_CanSat_025_Handover_2026-10-28/08_archive_zero_board_workspace/VRITRA_ZeroBoard_Memory/etch_pcb/BOARD1_MAIN/BOARD1_MAIN.kicad_pcb (2026-10-28, an earlier design)

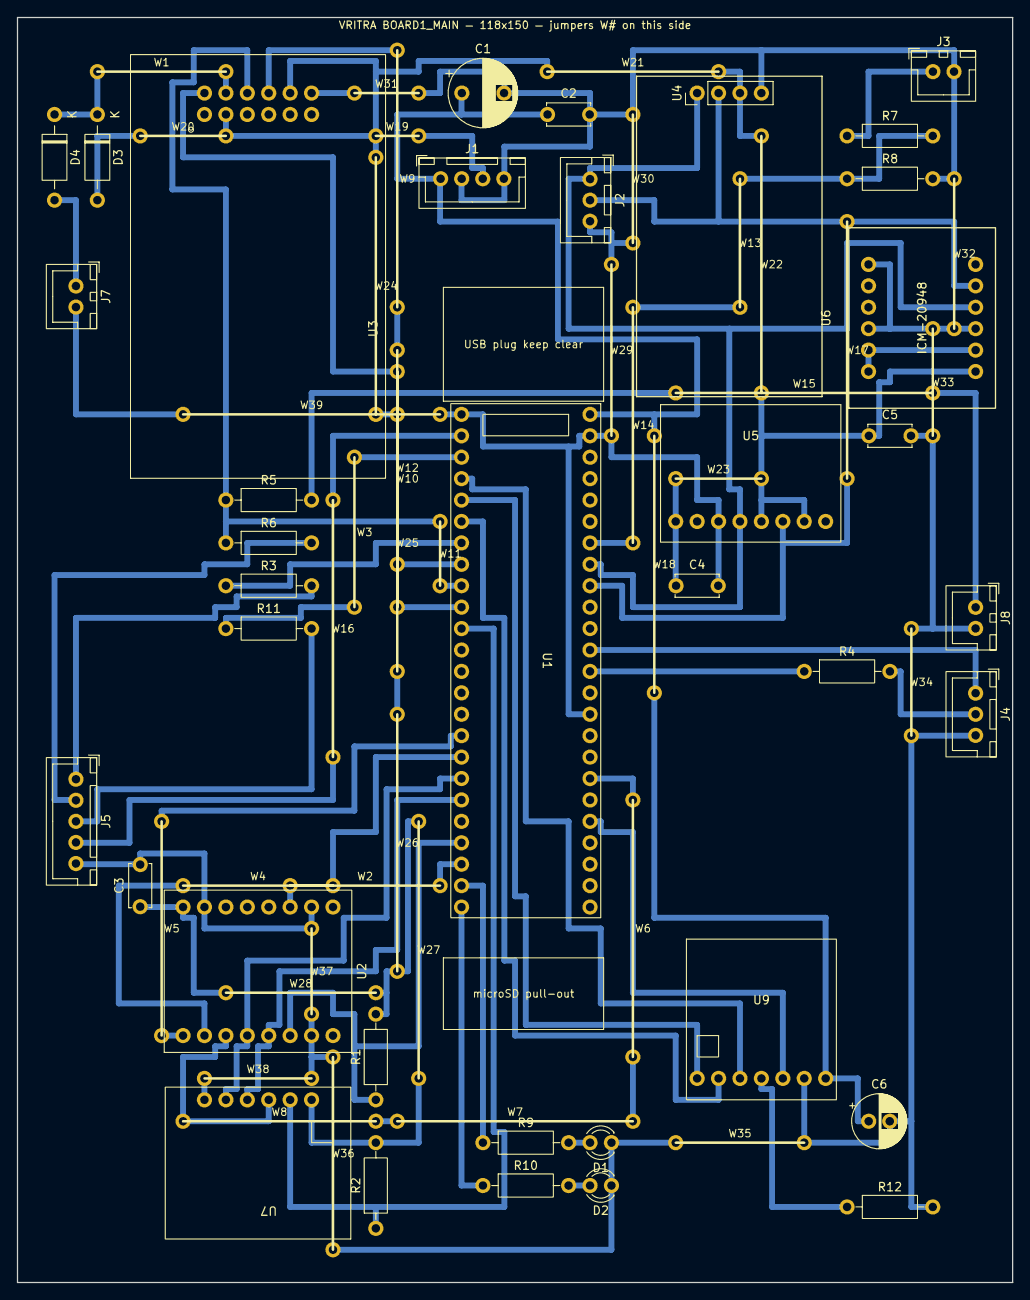
[picture p40: board BOARD1_MAIN.kicad_pcb from above]

Board: 2 copper layers, 118.0 x 150.0 mm, 76 parts (0 on the bottom side), 40 nets.

Parts:
C1: 470µF; CP_Radial_D8.0mm_P5.00mm
C2, C3, C4, C5: 100nF; C_Disc_D5.0mm_W2.5mm_P5.00mm
C6: 100µF amp; CP_Radial_D6.3mm_P2.50mm
D1: LED green; LED_D3.0mm
D2: LED red; LED_D3.0mm
D3: 1N5817 3V3→BAT; D_DO-41_SOD81_P10.16mm_Horizontal
D4: 1N5817 cell→BAT; D_DO-41_SOD81_P10.16mm_Horizontal
J1: PWR from POWER J5; JST_XH_B4B-XH-A_1x04_P2.50mm_Vertical
J2: I²C to POWER J2; JST_XH_B3B-XH-A_1x03_P2.50mm_Vertical
J3: VBAT from POWER J10; JST_XH_B2B-XH-A_1x02_P2.50mm_Vertical
J4: UART to PARACHUTE J2; JST_XH_B3B-XH-A_1x03_P2.50mm_Vertical
J5: LINK to BACKUP J2; JST_XH_B5B-XH-A_1x05_P2.50mm_Vertical
J7: GNSS backup cell; JST_XH_B2B-XH-A_1x02_P2.50mm_Vertical
J8: GNSS to PARACHUTE J5; JST_XH_B2B-XH-A_1x02_P2.50mm_Vertical
R1: 10k LORA_CS↑; R_Axial_DIN0207_L6.3mm_D2.5mm_P10.16mm_Horizontal
R2: 10k FLASH_CS↑; R_Axial_DIN0207_L6.3mm_D2.5mm_P10.16mm_Horizontal
R3: 1k HB; R_Axial_DIN0207_L6.3mm_D2.5mm_P10.16mm_Horizontal
R4: 1k TX3; R_Axial_DIN0207_L6.3mm_D2.5mm_P10.16mm_Horizontal
R5: 1k GNSS→D; R_Axial_DIN0207_L6.3mm_D2.5mm_P10.16mm_Horizontal
R6: 1k GNSS→B; R_Axial_DIN0207_L6.3mm_D2.5mm_P10.16mm_Horizontal
R7: 100k VBAT; R_Axial_DIN0207_L6.3mm_D2.5mm_P10.16mm_Horizontal
R8: 22k VBAT; R_Axial_DIN0207_L6.3mm_D2.5mm_P10.16mm_Horizontal
R9: 470 LED OK; R_Axial_DIN0207_L6.3mm_D2.5mm_P10.16mm_Horizontal
R10: 470 LED FLT; R_Axial_DIN0207_L6.3mm_D2.5mm_P10.16mm_Horizontal
R11: 1k CAM TX; R_Axial_DIN0207_L6.3mm_D2.5mm_P10.16mm_Horizontal
R12: 100k GAIN 15dB; R_Axial_DIN0207_L6.3mm_D2.5mm_P10.16mm_Horizontal
U1: Teensy 4.1 MAIN; Teensy 4.1_hdr
U2: Core1121-HF; Core1121xf Lora
U3: L89HA GNSS; L89_hdr
U4: DS3231 (flat on 4-pin end); PinHeader_1x04_P2.54mm_Vertical
U5: BMP585 #1; BMP585_hdr8
U6: ICM-20948 #1; ICM20948_7Semi_hdr12
U7: W25Q64 flash; W25Q64_hdr6
U9: MAX98357A amp; MAX98357A_hdr7
W1, W2, W3, W4, W5, W6, W7, W8, W9, W10, W11, W12, W13, W14, W15, W16, W17, W18, W19, W20, W21, W22, W23, W24, W25, W26, W27, W28, W29, W30, W31, W32, W33, W34, W35, W36, W37, W38, W39: wire jumper

Connections:
+3V3_A: C3.1, C4.1, C5.1, D3.1, J1.3, R1.2, R2.2, U2.16, U3.2, U3.11, U4.3, U5.1, U5.5, U5.7, U6.1, U7.1, W19.1, W20.1, W21.1, W22.1, W23.1, W24.1, W25.1, W26.1, W27.1, W28.1
+5V_LOGIC: C1.1, C2.1, C6.1, J1.1, U1.VIN, U9.7, W18.1
AMP_BCLK: U1.4, U9.2
AMP_DIN: U1.2, U9.3
AMP_GAIN: R12.1, U9.4
AMP_LRC: U1.3, U9.1
AMP_SD: U1.37, U9.5
BUS_V: R7.2, R8.1, U1.20, W13.1, W14.1
CAM_RX: J5.4, U1.0, W16.1
CAM_TX: R11.1, U1.1, W3.1
CAM_TX_J: J5.3, R11.2
FLASH_CS: R2.1, U1.9, U7.2
GND: C1.2, C2.2, C3.2, C4.2, C5.2, C6.2, D1.2, D2.2, J1.2, J1.4, J2.3, J3.2, J4.3, J5.5, J7.2, J8.2, R8.2, R12.2, U1.GND1, U1.GND2, U1.GND3, U2.2, U2.10, U2.15, U3.12, U4.4, U5.3, U6.3, U6.9, U6.12, U7.6, U9.6, W29.1, W30.1, W31.1, W32.1, W33.1, W34.1, W35.1, W36.1, W37.1, W38.1, W39.1
GNSS_B: J5.2, R6.2
GNSS_CELL: D4.1, J7.1
GNSS_D: J8.1, R5.2, W15.1
GNSS_RST: U1.6, U3.7, W12.1
GNSS_RX: U1.8, U3.10, W9.1, W10.1
GNSS_TX: R5.1, R6.1, U1.7, U3.9, W11.1
GNSS_VBCKP: D3.2, D4.2, U3.8, W1.1
HB_J5: J5.1, R3.2
HB_OUT: R3.1, U1.5
ICM_1V8: U6.2, U6.7, U6.8
LED_FLT: R10.1, U1.32
LED_FLT_A: D2.1, R10.2
LED_OK: R9.1, U1.31
LED_OK_A: D1.1, R9.2
LORA_BUSY: U1.24, U2.8, W5.1
LORA_CS: R1.1, U1.29, U2.3
LORA_IRQ: U1.30, U2.11, W2.1
LORA_RST: U1.25, U2.7, W4.1
MISO1: U1.39, U2.6, U7.3, W6.1, W7.1, W8.1
MOSI1: U1.26, U2.5, U7.5
RX3: J4.1, U1.15
SCK1: U1.27, U2.4, U7.4
SCL: J2.1, U1.19, U4.1, U5.4, U6.4
SDA: J2.2, U1.18, U4.2, U5.6, U6.5, W17.1
TX3: R4.1, U1.14
TX3_J4: J4.2, R4.2
VBAT_SENSE: J3.1, R7.1
