itsmeabirmohanta/Sujal/source/VRITRA_CanSat_025_Handover_2026-10-28/08_archive_zero_board_workspace/VRITRA_ZeroBoard_Memory/kicad_single/_old_5_boards/ZB_B_BACKUP_1L/ZB_B_BACKUP_1L.kicad_pcb

## KiCad design source/VRITRA_CanSat_025_Handover_2026-10-28/08_archive_zero_board_workspace/VRITRA_ZeroBoard_Memory/kicad_single/_old_5_boards/ZB_B_BACKUP_1L/ZB_B_BACKUP_1L.kicad_pcb (2026-10-28, an earlier design)

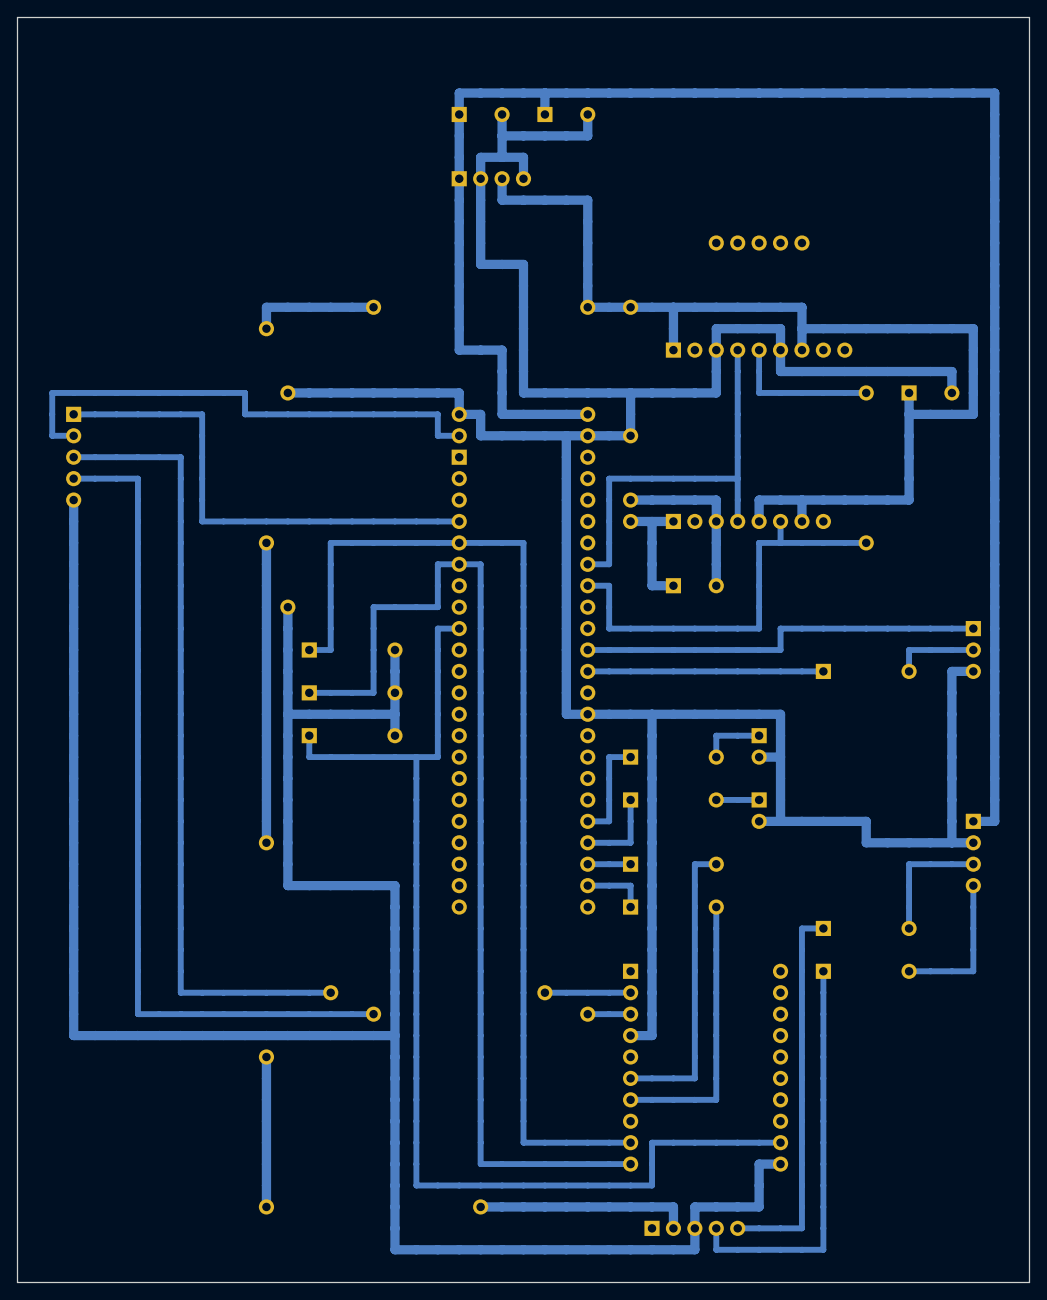
[picture p41: board ZB_B_BACKUP_1L.kicad_pcb from above]

Board: 2 copper layers, 120.0 x 150.0 mm, 35 parts (0 on the bottom side), 27 nets.

Parts:
C1: 470µF
C2, C3, C4: 100nF
D1: LED green
D2: LED red
J1: PWR from E J6
J2: LINK cable from MAIN J5
J3: to D J3
J4: CAMERA plug (the only one)
LK1, LK2, LK3, LK4, LK5, LK6, LK7, LK8, LK9, LK10: wire link
R1: 1k TX3
R2: 1k TX8
R3: 1k RX8
R4: 470 LED OK
R5: 470 LED FLT
R6: 10k MUX_A↓
R7: 10k MUX_B↓
R8: 10k MUX_C↓
R9: 1k cam RX
R10: 1k cam TX
U1: Teensy 4.1 BACKUP
U5: BMP585 #2
U8: LSM6DSO32 (Adafruit)
U10: 7Semi UART mux
U10B: mux bottom-row wires

Connections:
+3V3_B: C3.1, C4.1, J1.3 (+3V3), LK4.1, LK5.1, LK6.1, LK7.1, LK8.1, U5.1 (VIN), U5.5 (SDO), U5.7 (CS), U8.1 (VIN), U8.7 (CS), U10B.2 (3V3)
+5V_LOGIC: C1.1 (+), C2.1, J1.1 (+5V), J4.1 (+5V), U1.VIN
CAM_COM_RX: R10.1, U10B.4 (RX_COM)
CAM_COM_TX: R9.1, U10B.5 (TX_COM)
CAM_FROM_XIAO: J4.4 (from D6), R10.2
CAM_RX: J2.4 (MUX_RX), LK3.1, U10.3 (RX1)
CAM_TO_XIAO: J4.3 (to D7), R9.2
CAM_TX_J: J2.3 (MUX_TX), LK2.1, U10.2 (TX1)
GND: C1.2 (-), C2.2, C3.2, C4.2, D1.2 (K), D2.2 (K), J1.2 (GND), J1.4 (GND), J2.5 (GND), J3.3 (GND), J4.2 (GND), LK9.1, LK10.1, R6.2, R7.2, R8.2, U1.GND1 (GND), U1.GND2 (GND), U1.GND3 (GND), U5.3 (GND), U8.3 (GND), U8.6 (DO), U10.4 (GND), U10.20 (GND), U10B.3 (GND)
GNSS_IN: J2.2 (GNSS), U1.0
HB_IN: J2.1 (HB), U1.4
LED_FLT: R5.1, U1.37
LED_FLT_A: D2.1 (A), R5.2
LED_OK: R4.1, U1.36
LED_OK_A: D1.1 (A), R4.2
MUX_A: R6.1, U1.5, U10.9 (A)
MUX_B: R7.1, U1.6, U10.10 (B)
MUX_C: R8.1, U1.9, U10.19 (C)
RX3: J3.1 (RX3), U1.15
RX8: R3.1, U1.34
RX8_J: R3.2, U10.7 (RX2)
SCL: U1.19, U5.4 (SCK), U8.4 (SCL)
SDA: LK1.1, U1.18, U5.6 (SDI), U8.5 (SDA)
TX3: R1.1, U1.14
TX3_J: J3.2 (TX3), R1.2
TX8: R2.1, U1.35
TX8_J: R2.2, U10.6 (TX2)
