itsmeabirmohanta/Sujal/source/VRITRA_CanSat_025_Handover_2026-10-28/08_archive_zero_board_workspace/VRITRA_ZeroBoard_Memory/kicad/ZB_E_POWER/ZB_E_POWER.kicad_pcb

## KiCad design source/VRITRA_CanSat_025_Handover_2026-10-28/08_archive_zero_board_workspace/VRITRA_ZeroBoard_Memory/kicad/ZB_E_POWER/ZB_E_POWER.kicad_pcb (2026-10-28, an earlier design)

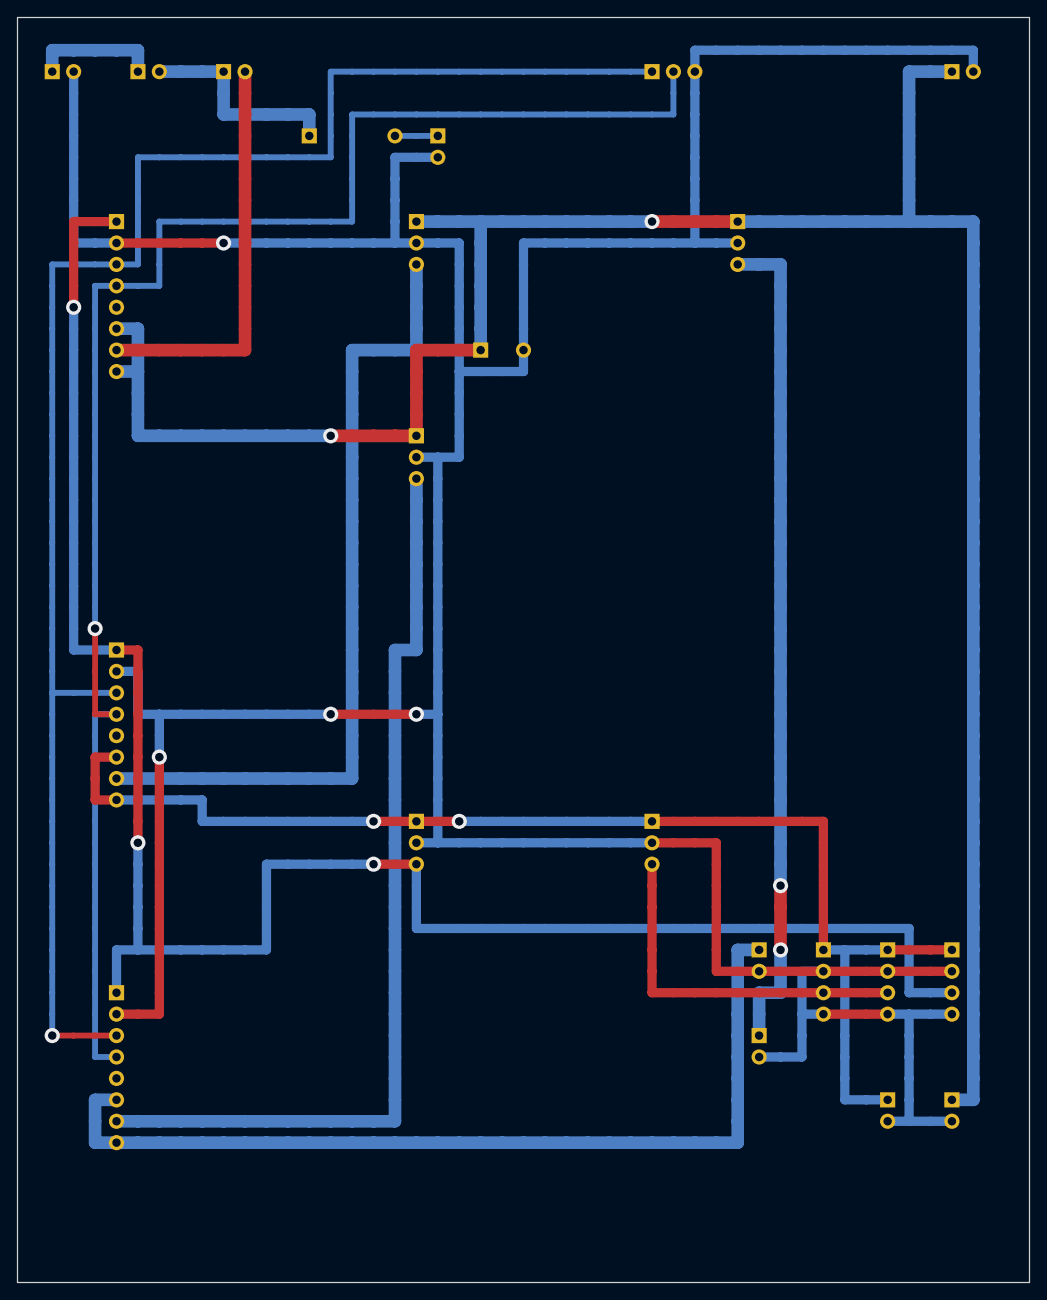
[picture p42: board ZB_E_POWER.kicad_pcb from above]

Board: 2 copper layers, 120.0 x 150.0 mm, 23 parts (0 on the bottom side), 15 nets.

Parts:
C1: 470µF 25V VBAT
D1: PWR LED red
F1: FUSE 10 A (link until fitted)
J1: BATTERY (XT60 lead)
J2: I²C to A J2
J3: rocker switch (shell)
J4: ESC (XT30 lead)
J5: PWR to A J1
J6: PWR to B J1
J7: PWR to D J8
J8: → D J1 (thick)
J9: → D J6 (thick)
J10: VBAT sense to A J3
J11: 5V to C J3
M1L: M1 landing
M2L: M2 landing
M3L: M3 landing
M4L: M4 landing
M5L: M5 landing
R1: 1k LED
U1: INA260 #1 BATTERY
U2: INA260 #2 8V STEER
U3: INA260 #3 5V LOGIC

Connections:
5V_RAW: M1L.3 (OUT), U3.7 (IN+)
8V_RAW: M3L.3 (OUT), U2.7 (IN+)
+3V3_A: J5.3 (+3V3_A), M4L.3 (OUT), U1.1 (VCC), U2.1 (VCC), U3.1 (VCC)
+3V3_B: J6.3 (+3V3_B), J7.3 (+3V3_B), M5L.3 (OUT)
+5V_LOGIC: J5.1 (+5V), J6.1 (+5V), J7.1 (+5V), J11.1 (+5V), M4L.1 (IN), M5L.1 (IN), U3.6 (VBUS), U3.8 (IN-)
+5V_SERVO: J9.1 (+5VS), M2L.3 (OUT)
+8V_STEER: J8.1 (+8V), U2.6 (VBUS), U2.8 (IN-)
BAT+: J1.1 (BAT+), J3.1 (SW_A)
GND: C1.2 (-), D1.2 (K), J1.2 (BAT−), J2.3 (GND), J4.2 (GND), J5.2 (GND), J5.4 (GND), J6.2 (GND), J6.4 (GND), J7.2 (GND), J7.4 (GND), J8.2 (GND), J9.2 (GND), J10.2 (GND), J11.2 (GND), M1L.2 (GND), M2L.2 (GND), M3L.2 (GND), M4L.2 (GND), M5L.2 (GND), U1.2 (GND), U2.2 (GND), U3.2 (GND)
LED_A: D1.1 (A), R1.2
SCL: J2.1 (SCL), U1.3 (SCL), U2.3 (SCL), U3.3 (SCL)
SDA: J2.2 (SDA), U1.4 (SDA), U2.4 (SDA), U3.4 (SDA)
VBAT: C1.1 (+), J4.1 (VBAT), J10.1 (VBAT), M1L.1 (IN), M2L.1 (IN), M3L.1 (IN), U1.6 (VBUS), U1.8 (IN-)
VBAT_F: F1.2 (OUT), U1.7 (IN+)
VBAT_SW: F1.1 (IN), J3.2 (SW_B), R1.1
