itsmeabirmohanta/Sujal/source/VRITRA_CanSat_025_Handover_2026-10-28/08_archive_zero_board_workspace/VRITRA_ZeroBoard_Memory/etch_pcb/BOARD2_BACKUP_SENSOR/BOARD2_BACKUP_SENSOR.kicad_pcb

## KiCad design source/VRITRA_CanSat_025_Handover_2026-10-28/08_archive_zero_board_workspace/VRITRA_ZeroBoard_Memory/etch_pcb/BOARD2_BACKUP_SENSOR/BOARD2_BACKUP_SENSOR.kicad_pcb (2026-10-28, an earlier design)

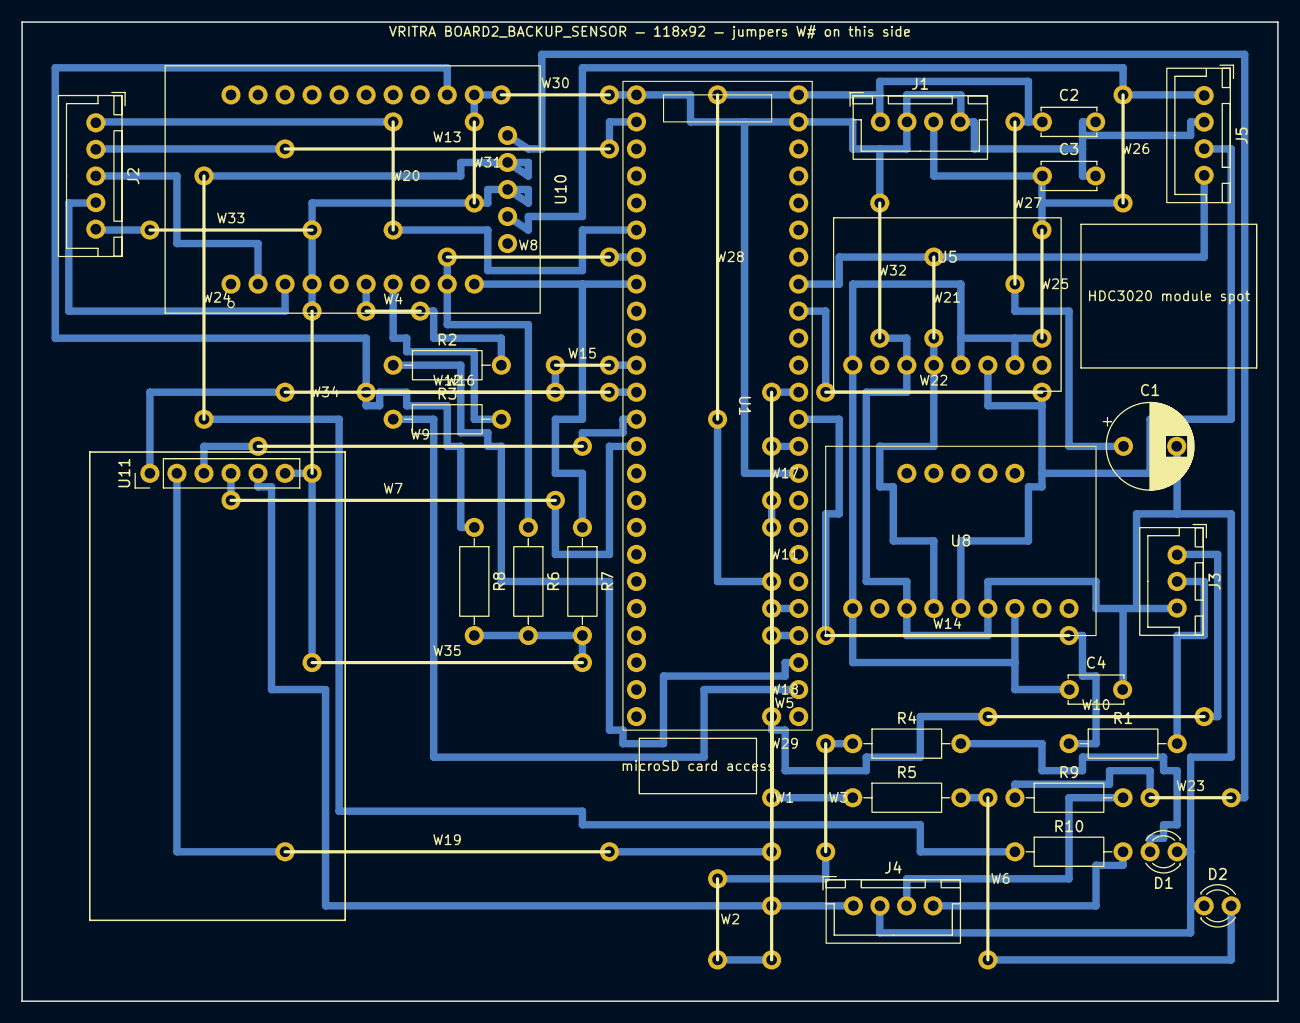
[picture p43: board BOARD2_BACKUP_SENSOR.kicad_pcb from above]

Board: 2 copper layers, 118.0 x 92.0 mm, 61 parts (0 on the bottom side), 31 nets.

Parts:
C1: 470µF; CP_Radial_D8.0mm_P5.00mm
C2, C3, C4: 100nF; C_Disc_D5.0mm_W2.5mm_P5.00mm
D1: LED green; LED_D3.0mm
D2: LED red; LED_D3.0mm
J1: PWR from POWER J6; JST_XH_B4B-XH-A_1x04_P2.50mm_Vertical
J2: LINK from MAIN J5; JST_XH_B5B-XH-A_1x05_P2.50mm_Vertical
J3: UART to PARACHUTE J3; JST_XH_B3B-XH-A_1x03_P2.50mm_Vertical
J4: CAMERA plug (XIAO); JST_XH_B4B-XH-A_1x04_P2.50mm_Vertical
J5: HDC3020 plug (+ − D C); JST_XH_B4B-XH-A_1x04_P2.50mm_Vertical
R1: 1k TX3; R_Axial_DIN0207_L6.3mm_D2.5mm_P10.16mm_Horizontal
R2: 1k TX8; R_Axial_DIN0207_L6.3mm_D2.5mm_P10.16mm_Horizontal
R3: 1k RX8; R_Axial_DIN0207_L6.3mm_D2.5mm_P10.16mm_Horizontal
R4: 470 LED OK; R_Axial_DIN0207_L6.3mm_D2.5mm_P10.16mm_Horizontal
R5: 470 LED FLT; R_Axial_DIN0207_L6.3mm_D2.5mm_P10.16mm_Horizontal
R6: 10k MUX_A↓; R_Axial_DIN0207_L6.3mm_D2.5mm_P10.16mm_Horizontal
R7: 10k MUX_B↓; R_Axial_DIN0207_L6.3mm_D2.5mm_P10.16mm_Horizontal
R8: 10k MUX_C↓; R_Axial_DIN0207_L6.3mm_D2.5mm_P10.16mm_Horizontal
R9: 1k cam RX; R_Axial_DIN0207_L6.3mm_D2.5mm_P10.16mm_Horizontal
R10: 1k cam TX; R_Axial_DIN0207_L6.3mm_D2.5mm_P10.16mm_Horizontal
U1: Teensy 4.1 BACKUP; Teensy 4.1_hdr
U5: BMP585 #2; BMP585_hdr8
U8: LSM6DSO32; LSM6DSO32_hdr
U10: 7Semi UART mux; UART_MUX_7SEMI_25
U11: microSD card module; PinHeader_1x06_P2.54mm_Vertical
W1, W2, W3, W4, W5, W6, W7, W8, W9, W10, W11, W12, W13, W14, W15, W16, W17, W18, W19, W20, W21, W22, W23, W24, W25, W26, W27, W28, W29, W30, W31, W32, W33, W34, W35: wire jumper

Connections:
+3V3_B: C3.1, C4.1, J1.3, J5.1, U5.1, U5.5, U5.7, U8.1, U8.7, U10.22, W25.1, W26.1
+5V_LOGIC: C1.1, C2.1, J1.1, J4.1, U1.VIN, U11.5, W27.1, W28.1, W29.1
CAM_COM_RX: R10.1, U10.24, W24.1
CAM_COM_TX: R9.1, U10.25, W23.1
CAM_FROM_XIAO: J4.4, R10.2
CAM_RX: J2.4, U10.3
CAM_TO_XIAO: J4.3, R9.2
CAM_TX_J: J2.3, U10.2
GND: C1.2, C2.2, C3.2, C4.2, D1.2, D2.2, J1.2, J1.4, J2.5, J3.3, J4.2, J5.2, R6.2, R7.2, R8.2, U1.GND1, U1.GND2, U1.GND3, U5.3, U8.3, U8.6, U10.4, U10.20, U10.23, U11.6, W30.1, W31.1, W32.1, W33.1, W34.1, W35.1
GNSS_IN: J2.2, U1.0, W13.1
HB_IN: J2.1, U1.4, W20.1
LED_FLT: R5.1, U1.37, W5.1
LED_FLT_A: D2.1, R5.2, W6.1
LED_OK: R4.1, U1.36, W1.1, W2.1, W3.1
LED_OK_A: D1.1, R4.2
MUX_A: R6.1, U1.5, U10.9, W8.1
MUX_B: R7.1, U1.6, U10.10
MUX_C: R8.1, U1.9, U10.19, W15.1, W16.1
RX3: J3.1, U1.15, W10.1, W11.1
RX8: R3.1, U1.34
RX8_J: R3.2, U10.7
SCL: J5.4, U1.19, U5.4, U8.4, W21.1
SDA: J5.3, U1.18, U5.6, U8.5, W22.1
SD_CS: U1.10, U11.1, W12.1
SD_MISO: U1.12, U11.4, W7.1
SD_MOSI: U1.11, U11.3, W9.1
SD_SCK: U1.13, U11.2, W17.1, W18.1, W19.1
TX3: R1.1, U1.14, W14.1
TX3_J: J3.2, R1.2
TX8: R2.1, U1.35
TX8_J: R2.2, U10.6, W4.1
