itsmeabirmohanta/Sujal/source/VRITRA_CanSat_025_Handover_2026-10-28/08_archive_zero_board_workspace/VRITRA_ZeroBoard_Memory/kicad_single/_rect_parachute_before_round/BOARD4_PARACHUTE_1L/BOARD4_PARACHUTE_1L.kicad_pcb

## KiCad design source/VRITRA_CanSat_025_Handover_2026-10-28/08_archive_zero_board_workspace/VRITRA_ZeroBoard_Memory/kicad_single/_rect_parachute_before_round/BOARD4_PARACHUTE_1L/BOARD4_PARACHUTE_1L.kicad_pcb (2026-10-28, an earlier design)

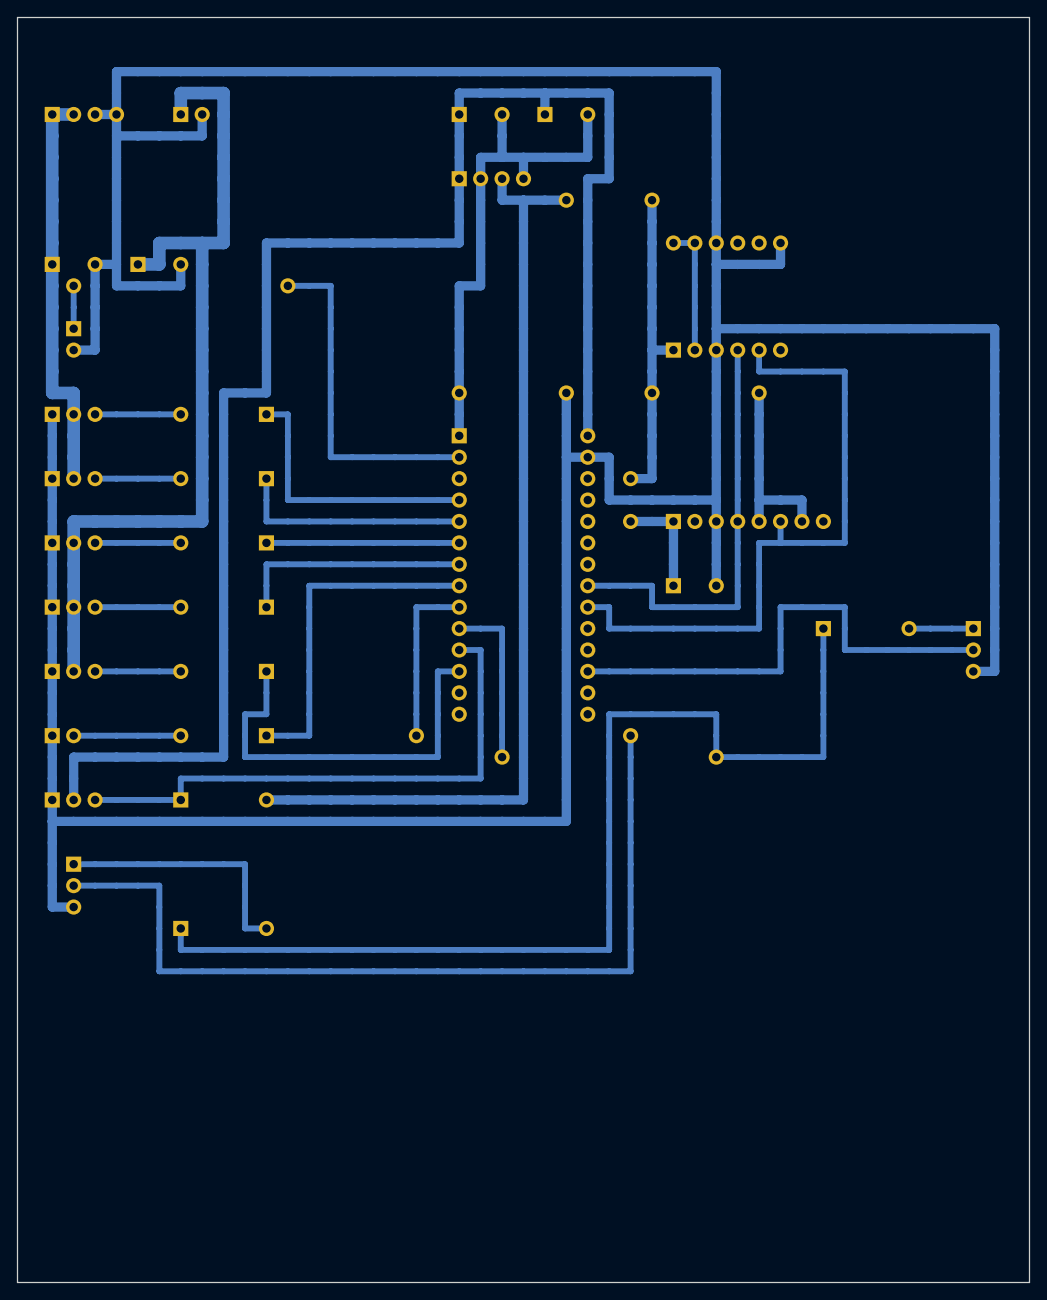
[picture p44: board BOARD4_PARACHUTE_1L.kicad_pcb from above]

Board: 2 copper layers, 120.0 x 150.0 mm, 37 parts (0 on the bottom side), 27 nets.

Parts:
C1: 470µF 8V rail
C2: 470µF 5VS rail
C3: 470µF
C4, C5: 100nF
J1: 8 V steer in (POWER J8)
J2: UART from A J4
J3: to B J3
J5: GNSS from A J8
J6: 5 V servo in (POWER J9)
J8: logic PWR from E J7
J10: A20CLM LEFT steer (8 V)
J11: A20CLM RIGHT steer (8 V)
J12: MG90S #1 PARACHUTE BAY
J13: MG90S #2 PETRI PLATE
J14: ESC signal (Cyclone 45A BLHeli_S)
J15: HALL sensor
J16: MG90S #3 EXTRA
LK1, LK2, LK3, LK4, LK5, LK6, LK7: wire link
R1, R2, R3, R4, R5, R9: 330
R6: 10k HALL↑3V3
R7: 1k TX2→A
R8: 1k TX→B
U1: Teensy 4.0 PARAFOIL
U5: BMP585 #3 (to buy)
U6: ICM-20948 #2

Connections:
+3V3_B: C5.1, J8.3 (+3V3), LK4.1, LK5.1, LK6.1, R6.2, U5.1 (VIN), U5.5 (SDO), U5.7 (CS), U6.1 (VIN)
+5V_LOGIC: C3.1 (+), C4.1, J8.1 (+5V), J15.2 (+5V), U1.28 (VIN)
+5V_SERVO: C2.1 (+), J6.1 (+5VS), J12.2 (+), J13.2 (+), J16.2 (+)
+8V_STEER: C1.1 (+), J1.1 (+8V), J1.2 (+8V), J10.2 (+), J11.2 (+)
BAY_LID: R3.1, U1.6 (4)
BAY_LID_S: J12.3 (S), R3.2
ESC: R5.1, U1.8 (6)
ESC_S: J14.2 (S), R5.2
GND: C1.2 (-), C2.2 (-), C3.2 (-), C4.2, C5.2, J1.3 (GND), J1.4 (GND), J2.3 (GND), J3.3 (GND), J5.2 (GND), J6.2 (GND), J8.2 (GND), J8.4 (GND), J10.1 (−), J11.1 (−), J12.1 (−), J13.1 (−), J14.1 (−), J15.1 (−), J16.1 (−), LK7.1, U1.1 (GND), U1.27 (GND), U5.3 (GND), U6.3 (GND), U6.9 (GND), U6.12 (FSYNC)
GNSS_IN: J5.1 (GNSS), LK1.1, U1.2 (0)
HALL: J15.3 (OUT), R6.1, U1.11 (9)
ICM_1V8: U6.2 (1V8), U6.7 (CS), U6.8 (SDO)
PETRI: R4.1, U1.7 (5)
PETRI_S: J13.3 (S), R4.2
RX2: J2.2 (RX2←A), LK2.1, U1.9 (7)
RX3: J3.2 (RX3←B), U1.17 (15)
SCL: U1.21 (19), U5.4 (SCK), U6.4 (SCL)
SDA: U1.20 (18), U5.6 (SDI), U6.5 (SDA)
SERVO_X: R9.1, U1.12 (10)
SERVO_X_S: J16.3 (S), R9.2
STEER_L: R1.1, U1.4 (2)
STEER_L_S: J10.3 (S), R1.2
STEER_R: R2.1, U1.5 (3)
STEER_R_S: J11.3 (S), R2.2
TX2: LK3.1, R7.1, R8.1, U1.10 (8)
TX2_A: J2.1 (TX2→A), R7.2
TX2_B: J3.1 (TX→B), R8.2
