itsmeabirmohanta/Sujal/source/VRITRA_CanSat_025_Handover_2026-10-28/08_archive_zero_board_workspace/VRITRA_ZeroBoard_Memory/kicad_single/_old_5_boards/ZB_C_SENSOR_1L/ZB_C_SENSOR_1L.kicad_pcb

## KiCad design source/VRITRA_CanSat_025_Handover_2026-10-28/08_archive_zero_board_workspace/VRITRA_ZeroBoard_Memory/kicad_single/_old_5_boards/ZB_C_SENSOR_1L/ZB_C_SENSOR_1L.kicad_pcb (2026-10-28, an earlier design)

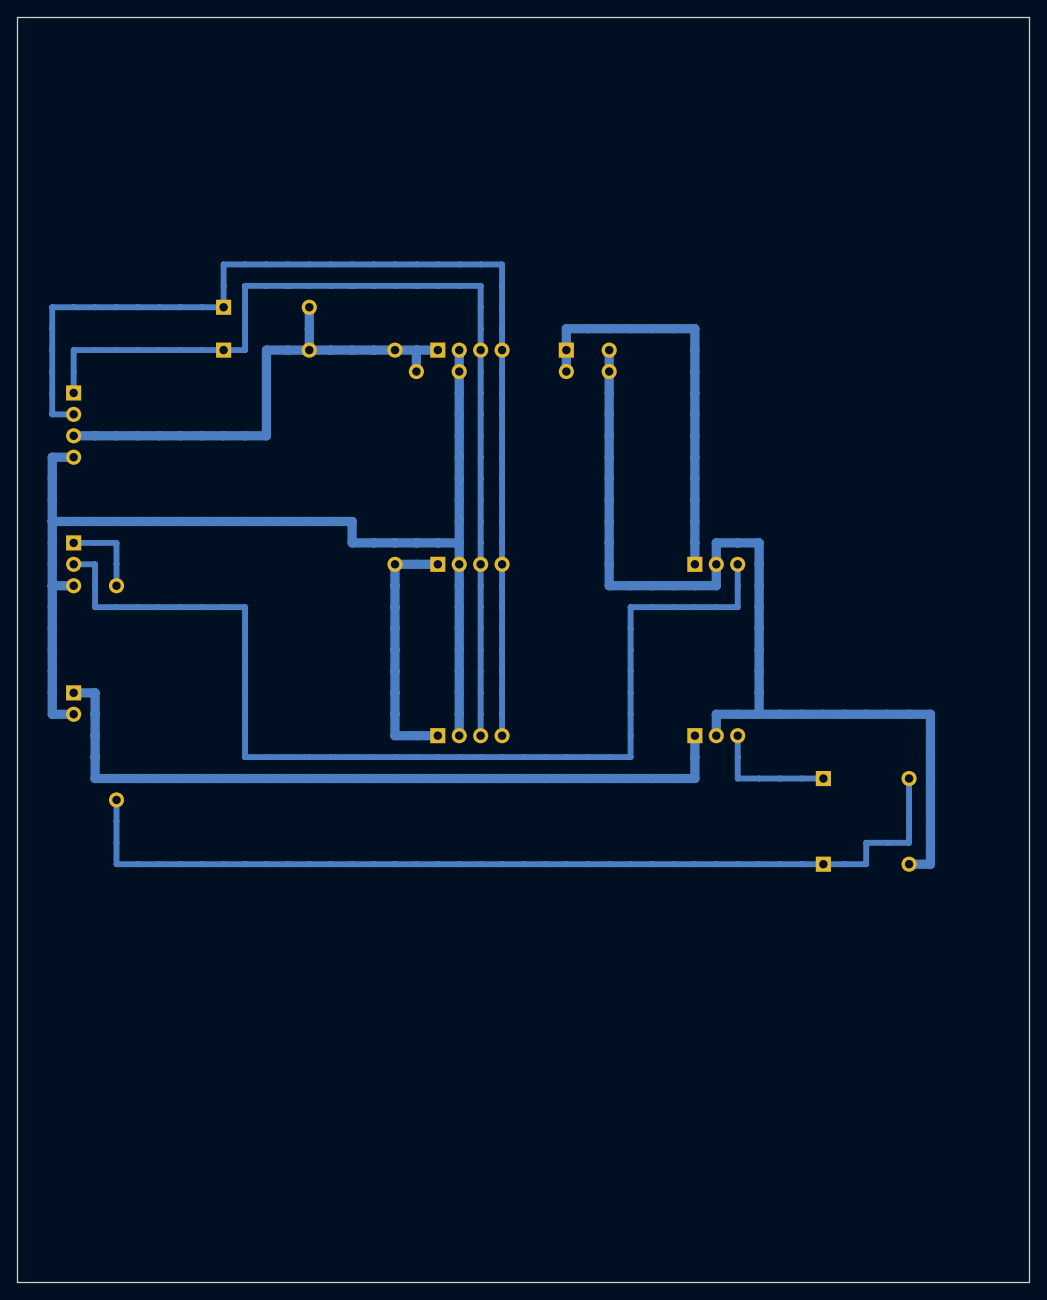
[picture p46: board ZB_C_SENSOR_1L.kicad_pcb from above]

Board: 2 copper layers, 120.0 x 150.0 mm, 17 parts (0 on the bottom side), 8 nets.

Parts:
C1: 100nF
J1: I2C from A J6
J2: HDC3020 cable
J3: 5V from E J11
J4: I²C sensor #1
J5: ML8511 UV
J6: MQ-131
J7: analog from A J9
J8: I²C sensor #2
LK1, LK2, LK3, LK4: wire link
R1: 4.7k SDA1↑ (fit if needed)
R2: 4.7k SCL1↑ (fit if needed)
R4: 10k MQ divider top
R5: 20k (2×10k) bottom

Connections:
+3V3_A: C1.1, J1.3 (3V3), J2.1 (3V3), J4.1 (3V3), J5.1 (3V3), J8.1 (3V3), LK1.1, LK2.1, R1.2, R2.2
+5V_MQ: J3.1 (+5V), J6.1 (+5V)
ENV_O3: J7.1 (O3), LK3.1, R4.2, R5.1
ENV_UV: J5.3 (UV), J7.2 (UV)
GND: C1.2, J1.4 (GND), J2.2 (GND), J3.2 (GND), J4.2 (GND), J5.2 (GND), J6.2 (GND), J7.3 (GND), J8.2 (GND), LK4.1, R5.2
MQ_AO: J6.3 (AO), R4.1
SCL1: J1.2 (SCL1), J2.4 (SCL), J4.4 (SCL), J8.4 (SCL), R2.1
SDA1: J1.1 (SDA1), J2.3 (SDA), J4.3 (SDA), J8.3 (SDA), R1.1
