itsmeabirmohanta/Sujal/source/VRITRA_CanSat_025_Handover_2026-10-28/08_archive_zero_board_workspace/VRITRA_ZeroBoard_Memory/kicad_single/BOARD4_PARACHUTE_P4/BOARD4_PARACHUTE_P4.kicad_pcb

## KiCad design source/VRITRA_CanSat_025_Handover_2026-10-28/08_archive_zero_board_workspace/VRITRA_ZeroBoard_Memory/kicad_single/BOARD4_PARACHUTE_P4/BOARD4_PARACHUTE_P4.kicad_pcb (2026-10-28, an earlier design)

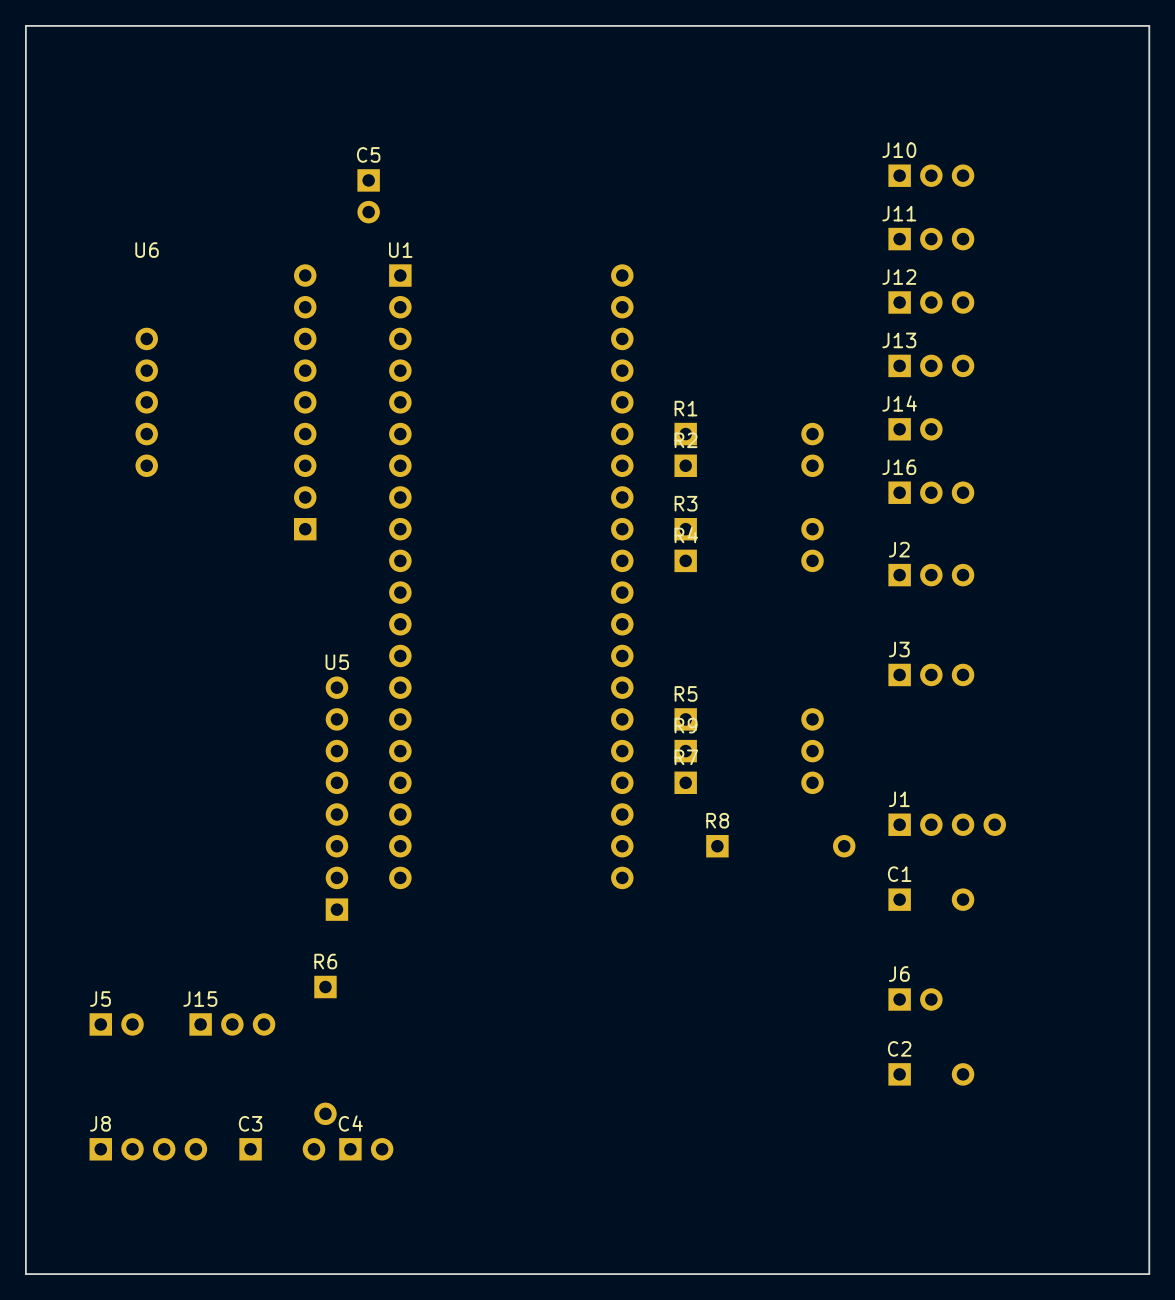
[picture p47: board BOARD4_PARACHUTE_P4.kicad_pcb from above]

Board: 2 copper layers, 90.0 x 100.0 mm, 30 parts (0 on the bottom side), 26 nets, no tracks yet.

Parts:
C1: 470µF 8V rail
C2: 470µF 5VS rail
C3: 470µF logic
C4, C5: 100nF
J1: 8 V steer in (POWER J8)
J2: UART from MAIN J4
J3: UART to BACKUP J3
J5: GNSS from MAIN J8
J6: 5 V servo in (POWER J9)
J8: logic PWR (POWER J7)
J10: A20CLM LEFT steer (8 V)
J11: A20CLM RIGHT steer (8 V)
J12: MG90S #1 PARACHUTE BAY
J13: MG90S #2 PETRI PLATE
J14: ESC signal (Cyclone 45A BLHeli_S)
J15: HALL sensor plug (sensor on the body)
J16: MG90S #3 EXTRA
R1, R2, R3, R4, R5, R9: 330
R6: 10k HALL↑3V3
R7: 1k TX2→A
R8: 1k TX→B
U1: ESP32-P4-WIFI6 PARACHUTE
U5: BMP585 #3
U6: LSM6DSO32 (Adafruit)

Connections:
+3V3_B: C5.1, J8.3 (+3V3), R6.2, U5.1 (VIN), U5.5 (SDO), U5.7 (CS), U6.1 (VIN), U6.7 (CS)
+5V_LOGIC: C3.1 (+), C4.1, J8.1 (+5V), J15.2 (+5V), U1.39 (VSYS)
+5V_SERVO: C2.1 (+), J6.1 (+5VS), J12.2 (+), J13.2 (+), J16.2 (+)
+8V_STEER: C1.1 (+), J1.1 (+8V), J1.2 (+8V), J10.2 (+), J11.2 (+)
BAY_LID: R3.1, U1.32 (GPIO22)
BAY_LID_S: J12.3 (S), R3.2
ESC: R5.1, U1.26 (GPIO32)
ESC_S: J14.2 (S), R5.2
GND: C1.2 (-), C2.2 (-), C3.2 (-), C4.2, C5.2, J1.3 (GND), J1.4 (GND), J2.3 (GND), J3.3 (GND), J5.2 (GND), J6.2 (GND), J8.2 (GND), J8.4 (GND), J10.1 (−), J11.1 (−), J12.1 (−), J13.1 (−), J14.1 (−), J15.1 (−), J16.1 (−), U1.3 (GND), U1.38 (GND), U5.3 (GND), U6.3 (GND), U6.6 (DO)
GNSS_IN: J5.1 (GNSS), U1.11 (GPIO5)
HALL: J15.3 (OUT), R6.1, U1.12 (GPIO4)
PETRI: R4.1, U1.31 (GPIO23)
PETRI_S: J13.3 (S), R4.2
RX2: J2.2 (RX2←A), U1.22 (GPIO47)
RX3: J3.2 (RX3←B), U1.21 (GPIO48)
SCL: U1.16 (GPIO8/SCL), U5.4 (SCK), U6.4 (SCL)
SDA: U1.17 (GPIO7/SDA), U5.6 (SDI), U6.5 (SDA)
SERVO_X: R9.1, U1.25 (GPIO33)
SERVO_X_S: J16.3 (S), R9.2
STEER_L: R1.1, U1.35 (GPIO20)
STEER_L_S: J10.3 (S), R1.2
STEER_R: R2.1, U1.34 (GPIO21)
STEER_R_S: J11.3 (S), R2.2
TX2: R7.1, R8.1, U1.24 (GPIO46)
TX2_A: J2.1 (TX2→A), R7.2
TX2_B: J3.1 (TX→B), R8.2
