itsmeabirmohanta/Sujal/source/VRITRA_CanSat_025_Handover_2026-10-28/03_kicad_current_boards/BOARD1_MAIN_Teensy41/BOARD1_MAIN_1L.kicad_pcb

## KiCad design source/VRITRA_CanSat_025_Handover_2026-10-28/03_kicad_current_boards/BOARD1_MAIN_Teensy41/BOARD1_MAIN_1L.kicad_pcb (2026-10-28)

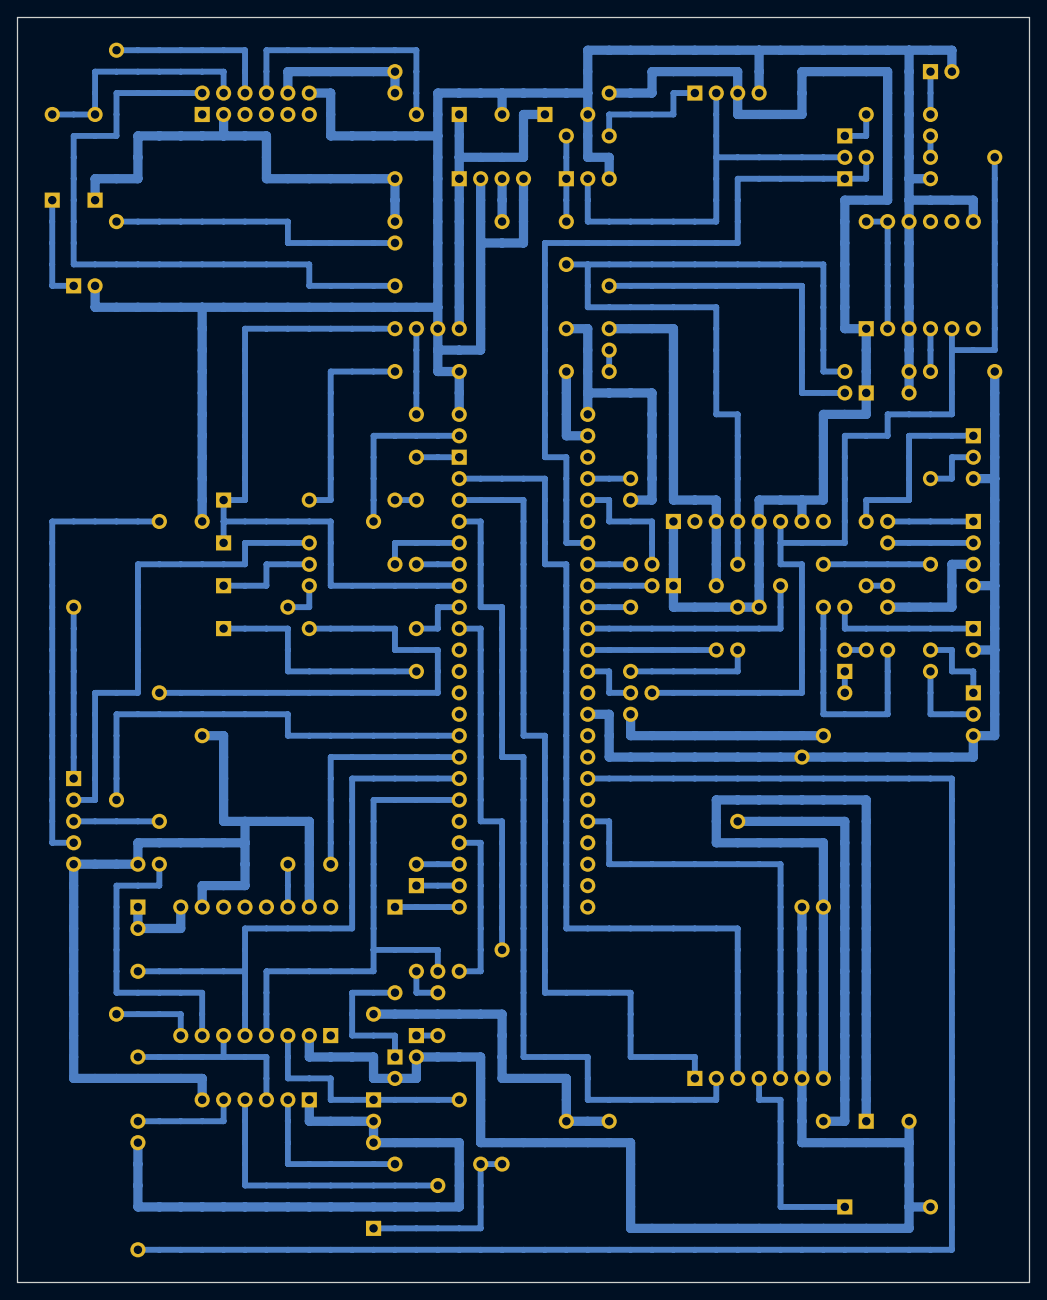
[picture p48: board BOARD1_MAIN_1L.kicad_pcb from above]

Board: 2 copper layers, 120.0 x 150.0 mm, 98 parts (0 on the bottom side), 44 nets.

Parts:
C1: 470µF
C2, C3, C4, C5: 100nF
C6: 100µF amp
D1: LED green
D2: LED red
D3: Schottky 3V3→BAT
D4: Schottky cell→BAT
J1: PWR from E J5
J2: I2C to E J2
J3: VBAT from E J10
J4: UART to D J2
J5: LINK cable to BACKUP J2
J6: I2C to C J1
J7: GNSS backup cell
J8: GNSS to D J5
J9: analog to C J7
LK1, LK2, LK3, LK4, LK5, LK6, LK7, LK8, LK9, LK10, LK11, LK12, LK13, LK14, LK15, LK16, LK17, LK18, LK19, LK20, LK21, LK22, LK23, LK24, LK25, LK26, LK27, LK28, LK29, LK30, LK31, LK32, LK33, LK34, LK35, LK36, LK37, LK38, LK39, LK40, LK41, LK42, LK43, LK44, LK45, LK46, LK47, LK48, LK49, LK50, LK51, LK52, LK53, LK54, LK55, LK56, LK57, LK58, LK59: wire link
R1: 10k LORA_CS↑
R2: 10k FLASH_CS↑
R3: 1k HB
R4: 1k TX3
R5: 1k GNSS→D
R6: 1k GNSS→B
R7: 100k VBAT
R8: 22k VBAT
R9: 470 LED OK
R10: 470 LED FLT
R11: 1k CAM TX
R12: 100k GAIN↓ 15dB
U1: Teensy 4.1 PRIMARY
U2: Core1121-HF
U3: L89HA GNSS
U4: DS3231 (MH ZS-042)
U5: BMP585 #1
U6: ICM-20948 #1
U7: W25Q64 flash
U9: MAX98357A beacon amp

Connections:
+3V3_A: C3.1, C4.1, C5.1, D3.1 (A), J1.3 (+3V3), J6.3 (3V3), LK47.1, LK48.1, LK49.1, LK50.1, LK51.1, LK52.1, LK53.1, LK54.1, R1.2, R2.2, U2.16 (3.3V), U3.2 (WAKE), U3.11 (3V3), U4.3 (VCC), U5.1 (VIN), U5.5 (SDO), U5.7 (CS), U6.1 (VIN), U7.1 (3V3)
+5V_LOGIC: C1.1 (+), C2.1, C6.1 (+), J1.1 (+5V), LK44.1, LK45.1, LK46.1, U1.VIN, U9.7 (Vin)
AMP_BCLK: U1.4, U9.2 (BCLK)
AMP_DIN: U1.2, U9.3 (DIN)
AMP_GAIN: R12.1, U9.4 (GAIN)
AMP_LRC: U1.3, U9.1 (LRC)
AMP_SD: U1.37, U9.5 (SD)
BUS_V: LK31.1, R7.2, R8.1, U1.20
CAM_RX: J5.4 (MUX_RX), LK34.1, U1.0
CAM_TX: LK6.1, R11.1, U1.1
CAM_TX_J: J5.3 (MUX_TX), LK9.1, R11.2
ENV_O3: J9.1 (O3), LK13.1, LK14.1, LK15.1, U1.23
ENV_UV: J9.2 (UV), LK11.1, LK12.1, U1.22
FLASH_CS: LK32.1, LK33.1, R2.1, U1.9, U7.2 (CS)
GND: C1.2 (-), C2.2, C3.2, C4.2, C5.2, C6.2 (-), D1.2 (K), D2.2 (K), J1.2 (GND), J1.4 (GND), J2.3 (GND), J3.2 (GND), J4.3 (GND), J5.5 (GND), J6.4 (GND), J7.2 (GND), J8.2 (GND), J9.3 (GND), LK55.1, LK56.1, LK57.1, LK58.1, LK59.1, R8.2, R12.2, U1.GND1 (GND), U1.GND2 (GND), U1.GND3 (GND), U2.2 (GND), U2.10 (GND), U2.15 (GND), U3.12 (GND), U4.4 (GND), U5.3 (GND), U6.3 (GND), U6.9 (GND), U6.12 (FSYNC), U7.6 (GND), U9.6 (GND)
GNSS_B: J5.2 (GNSS), R6.2
GNSS_CELL: D4.1 (A), J7.1 (CELL+)
GNSS_D: J8.1 (GNSS), LK35.1, LK36.1, LK37.1, R5.2
GNSS_RST: LK29.1, LK30.1, U1.6, U3.7 (RST)
GNSS_RX: LK25.1, LK26.1, U1.8, U3.10 (RX)
GNSS_TX: LK27.1, LK28.1, R5.1, R6.1, U1.7, U3.9 (TX)
GNSS_VBCKP: D3.2 (K), D4.2 (K), U3.8 (BAT)
HB_J5: J5.1 (HB), LK8.1, R3.2
HB_OUT: LK5.1, R3.1, U1.5
ICM_1V8: U6.2 (1V8), U6.7 (CS), U6.8 (SDO)
LED_FLT: R10.1, U1.32
LED_FLT_A: D2.1 (A), R10.2
LED_OK: R9.1, U1.31
LED_OK_A: D1.1 (A), LK1.1, R9.2
LORA_BUSY: LK23.1, U1.24, U2.8 (BUSY)
LORA_CS: LK7.1, R1.1, U1.29, U2.3 (CS)
LORA_IRQ: LK3.1, U1.30, U2.11 (DIO9)
LORA_RST: LK21.1, U1.25, U2.7 (RESET)
MISO1: LK24.1, U1.39, U2.6 (MISO), U7.3 (MISO)
MOSI1: LK22.1, U1.26, U2.5 (MOSI), U7.5 (MOSI)
RX3: J4.1 (RX3), LK10.1, U1.15
SCK1: LK20.1, U1.27, U2.4 (CLK), U7.4 (SCK)
SCL: J2.1 (SCL), LK38.1, LK39.1, LK40.1, LK41.1, U1.19, U4.1 (SCL), U5.4 (SCK), U6.4 (SCL)
SCL1: J6.2 (SCL1), LK18.1, LK19.1, U1.16
SDA: J2.2 (SDA), LK42.1, LK43.1, U1.18, U4.2 (SDA), U5.6 (SDI), U6.5 (SDA)
SDA1: J6.1 (SDA1), LK16.1, LK17.1, U1.17
TX3: LK4.1, R4.1, U1.14
TX3_J4: J4.2 (TX3), R4.2
VBAT_SENSE: J3.1 (VBAT), LK2.1, R7.1
