itsmeabirmohanta/Sujal/source/VRITRA_CanSat_025_Handover_2026-10-28/08_archive_zero_board_workspace/VRITRA_ZeroBoard_Memory/etch_pcb/BOARD4_PARACHUTE_PCB/BOARD4_PARACHUTE_PCB.kicad_pcb

## KiCad design source/VRITRA_CanSat_025_Handover_2026-10-28/08_archive_zero_board_workspace/VRITRA_ZeroBoard_Memory/etch_pcb/BOARD4_PARACHUTE_PCB/BOARD4_PARACHUTE_PCB.kicad_pcb (2026-10-28, an earlier design)

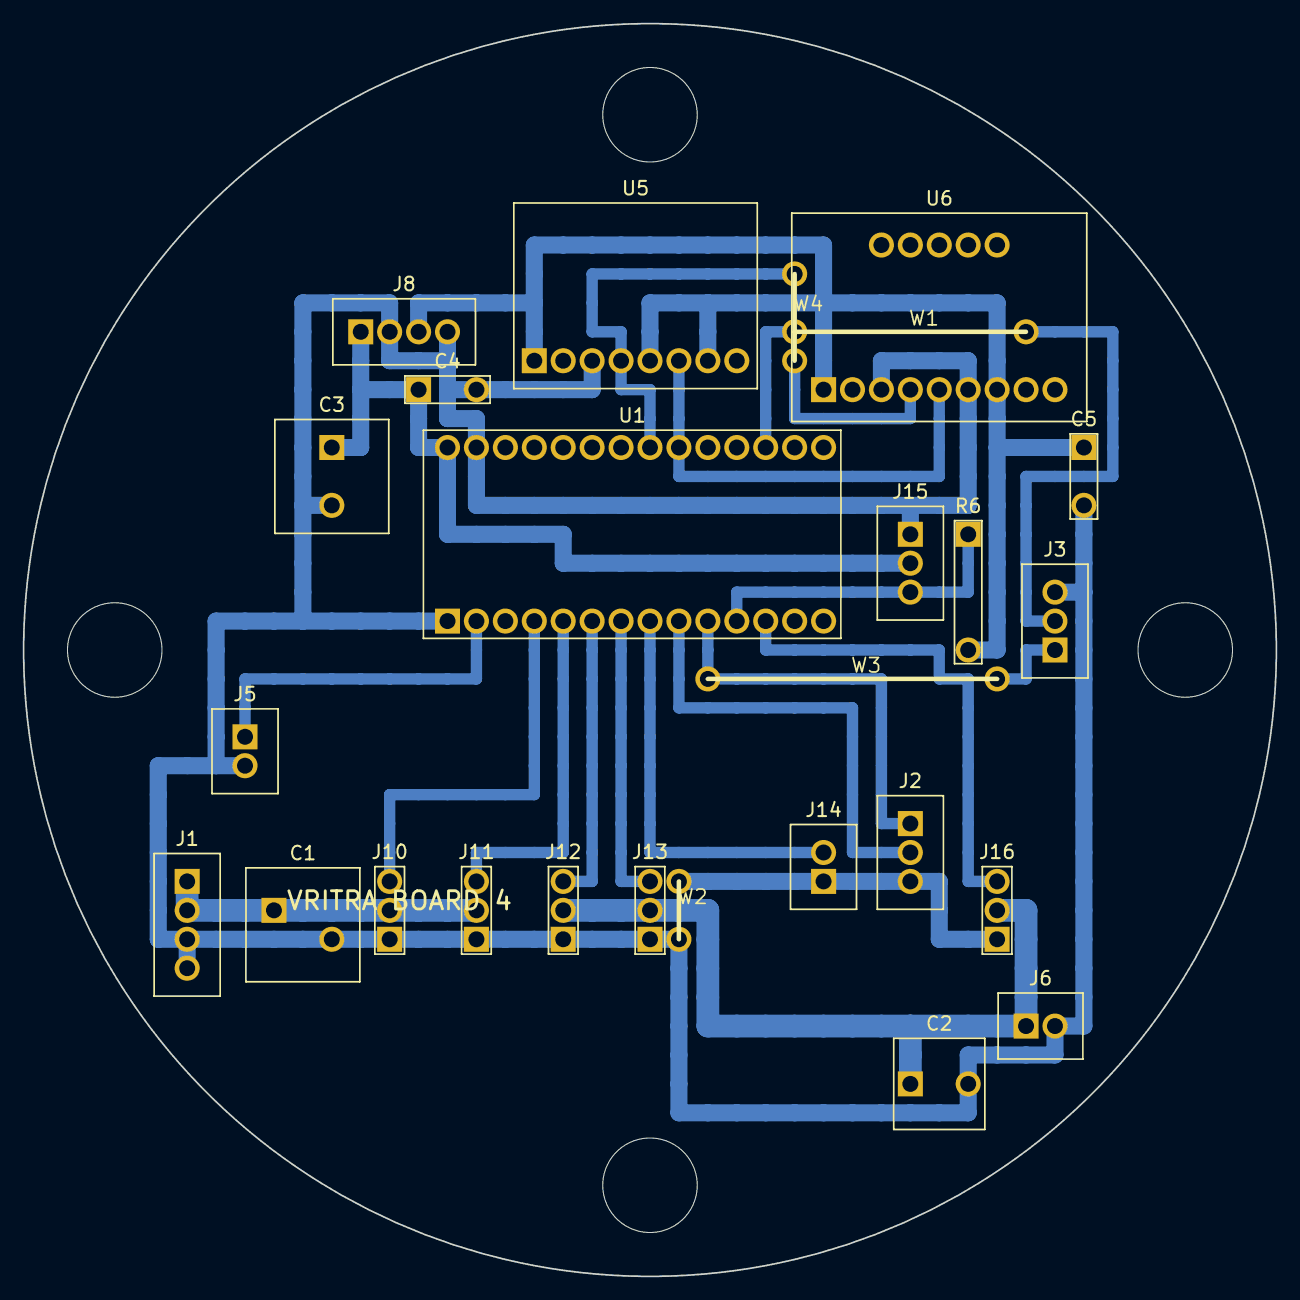
[picture p49: board BOARD4_PARACHUTE_PCB.kicad_pcb from above]

Board: 2 copper layers, 110.0 x 110.0 mm, 30 parts (0 on the bottom side), 18 nets.

Parts:
C1: 470µF 8V rail
C2: 470µF 5VS rail
C3: 470µF logic
C4, C5: 100nF
J1: 8 V steer in (POWER J8)
J2: UART from MAIN J4
J3: UART to BACKUP J3
J5: GNSS from MAIN J8
J6: 5 V servo in (POWER J9)
J8: logic PWR (POWER J7)
J10: A20CLM LEFT steer (8 V)
J11: A20CLM RIGHT steer (8 V)
J12: MG90S #1 PARACHUTE BAY
J13: MG90S #2 PETRI PLATE
J14: ESC signal (Cyclone 45A BLHeli_S)
J15: HALL sensor plug (sensor on the body)
J16: MG90S #3 EXTRA
R6: 10k HALL↑3V3
ROD1, ROD2, ROD3, ROD4: rod Ø8.3
U1: Teensy 4.0 PARACHUTE
U5: BMP585 #3
U6: LSM6DSO32 (Adafruit)
W1, W2, W3, W4: wire jumper

Connections:
+3V3_B: C5.1, J8.3, R6.2, U5.1, U5.5, U5.7, U6.1, U6.7
+5V_LOGIC: C3.1, C4.1, J8.1, J15.2, U1.28
+5V_SERVO: C2.1, J6.1, J12.2, J13.2, J16.2
+8V_STEER: C1.1, J1.1, J1.2, J10.2, J11.2
BAY_LID: J12.3, U1.6
ESC: J14.2, U1.8
GND: C1.2, C2.2, C3.2, C4.2, C5.2, J1.3, J1.4, J2.3, J3.3, J5.2, J6.2, J8.2, J8.4, J10.1, J11.1, J12.1, J13.1, J14.1, J15.1, J16.1, U1.1, U1.27, U5.3, U6.3, U6.6, W2.1
GNSS_IN: J5.1, U1.2
HALL: J15.3, R6.1, U1.11
PETRI: J13.3, U1.7
RX2: J2.2, U1.9
RX3: J3.2, U1.17, W1.1
SCL: U1.21, U5.4, U6.4, W4.1
SDA: U1.20, U5.6, U6.5
SERVO_X: J16.3, U1.12
STEER_L: J10.3, U1.4
STEER_R: J11.3, U1.5
TX2: J2.1, J3.1, U1.10, W3.1
