itsmeabirmohanta/Sujal/source/VRITRA_CanSat_025_Handover_2026-10-28/05_code/vritra-gcs-master_(CURRENT_repo)/gcs/vritra_gcs.py

#!/usr/bin/env python3
# -*- coding: utf-8 -*-
"""
VRITRA Ground Control Station  ·  v5.0
Team 2026-INSPACe-CAN-7USAT-025  ·  Lovely Professional University
IN-SPACe CAN-7USAT India Student Competition 2026 (3rd Edition)

Single-file PyQt5 desktop application. No browser, no web server, no GPU,
no internet. Frozen to one VRITRA_GCS.exe with PyInstaller for field use.

ARCHITECTURE
    RF modem ──serial──> SerialLink (worker thread)
                              │  raw CSV lines
                              ▼
                        queue.Queue (bounded, drop-oldest)
                              │
                              ▼
                     MainWindow._tick()  (QTimer, UI thread)
                              │
              parse ─> physics ─> CSV log ─> limits/staleness ─> paint

    The reception layer never touches a widget and the render loop never
    blocks on I/O. This is the decoupling mandated by the design research:
    a stalled port, a flood of packets, or a broken panel cannot freeze the
    operator's display or interrupt the graded CSV.

DESIGN LANGUAGE — "austere base, science colour"
    Flight and engineering data render monochrome on near-black. Amber and
    red are reserved exclusively for limit breaches and telemetry staleness,
    so a genuine alarm has no competition for the operator's eye. Colour is
    permitted inside scientific plots only where it encodes a real data
    dimension (e.g. AS7343 wavelength).

WIRE-FORMAT CONTRACT
    The 79 SCHEMA fields below are positional and must stay in exact sync
    with the Teensy downlink. Never delete or reorder a field to tidy the
    UI — every column after it would shift and the parser would silently
    read wrong values. Retire a field by hiding it in the UI, not by
    removing it from SCHEMA.
"""

import os
import sys
import csv
import math
import time
import json
import queue
import logging
import datetime
import threading
import traceback
from pathlib import Path
from collections import deque, OrderedDict

try:
    import serial
    import serial.tools.list_ports
    HAVE_SERIAL = True
except ImportError:
    HAVE_SERIAL = False

try:
    import winsound
    HAVE_WINSOUND = True
except ImportError:
    HAVE_WINSOUND = False

import numpy as np

# =========================================================================
# §1  MISSION CONSTANTS
# =========================================================================
TEAM_ID       = "2026-INSPACe-CAN-7USAT-025"
TEAM_NAME     = "VRITRA"
TEAM_INST     = "Lovely Professional University"
APP_VERSION   = "5.0.0"
APP_TITLE     = f"VRITRA GCS  ·  {TEAM_ID}"
CSV_FILENAME  = f"Flight_{TEAM_ID}.csv"      # competition-mandated name §6.3.iii.A
XML_FILENAME  = f"Flight_{TEAM_ID}.xml"
KML_FILENAME  = f"Track_{TEAM_ID}.kml"

DEFAULT_BAUD      = 115200
RECONNECT_BACKOFF = [1.0, 2.0, 4.0, 8.0]
TELEMETRY_HZ      = 1.0        # §6.3.i mandate: >= 1 Hz
SIM_HZ            = 4.0
UI_TICK_MS        = 100        # 10 Hz render / staleness evaluation
MAX_DRAIN_PER_TICK = 40        # flood governor: never block the UI thread

# --- CanSat physical constants (PDR) -------------------------------------
CANSAT_MASS_KG = 0.9954
CANSAT_OD_M    = 0.150
CANSAT_LEN_M   = 0.400
I_Z            = 2.103e-3      # long-axis inertia      [kg·m²]
I_T            = 1.432e-2      # transverse inertia     [kg·m²]

# --- Atmosphere (ISA) ----------------------------------------------------
SEA_LEVEL_P_PA  = 101325.0
SEA_LEVEL_T_K   = 288.15
TROPO_LAPSE_K_M = 0.0065
R_AIR           = 287.05
GAMMA_AIR       = 1.4
G_EARTH         = 9.80665
MU_AIR_REF      = 1.81e-5

# --- LoRa / LR1121 radio -------------------------------------------------
# Organiser-assigned plan, team 025 ("CAN7USAT Team_Frequency_Assignments_19_10",
# IN-SPACe mail of 19-10-2026, supersedes the earlier 867.00/865.75 SF10 0x98
# plan): 868 Main 866.50 / Backup 865.25 MHz, SF9 (launch pad 3), sync 0x99,
# BW 125 kHz mandatory, CR 4/5, TX +10 dBm on pad / ~+14 dBm in flight.
LORA_FREQ_MHZ  = 866.50
LORA_FREQ_BACKUP_MHZ = 865.25
# LR1121 sensitivity at the ASSIGNED SF9/BW125. Datasheet (RxBoosted) gives
# SF7 -127 / SF12 -141 dBm, i.e. ~-132.6 dBm at SF9; kept ~3 dB conservative,
# the same margin the old SF10 figure carried, because LINK_MARGIN uses it.
LORA_SENS_DBM  = -129.5       # LR1121 @ SF9 / BW125
LORA_SF        = 9
LORA_BW_HZ     = 125000
LORA_CR        = 4         # 4/5
LORA_SYNC_WORD = 0x99      # 0x80 + team id 25, per the 19-10 allocation plan
LORA_TX_DBM_PAD    = 10
LORA_TX_DBM_FLIGHT = 14

# --- WPC India spectrum rules (Gazette G.S.R. 853(E) / 564(E)) -----------
# Licence-exempt SRD use. The 865-868 MHz band is the allocation; the
# 865-867 MHz sub-band is the one covered by the ETA clarification, so the
# compliance check flags carriers that stray above 867 MHz.
WPC_BAND_LO_MHZ     = 865.0
WPC_BAND_HI_MHZ     = 868.0
WPC_ETA_LO_MHZ      = 865.0
WPC_ETA_HI_MHZ      = 867.0
WPC_MAX_TX_W        = 1.0      # transmitter power
WPC_MAX_ERP_W       = 4.0      # effective radiated power
WPC_MAX_BW_KHZ      = 200.0    # carrier bandwidth
DUTY_CYCLE_LIMIT    = 0.01     # 1 % (ETSI EN 300 220 convention)

# Simulator launch site. Only the SIMULATOR uses this — in real operation the
# pad origin is SURVEYED from the live fixes received while the vehicle reports
# STATE=BOOT (see Physics.__init__), so the GCS never needs to be told where it
# is. Set it to wherever you are actually flying so the ground track, UTM grid
# and recovery bearings look right during rehearsal.
SIM_SITE_NAME   = "Kushinagar, UP"
SIM_SITE_LAT    = 26.7400
SIM_SITE_LON    = 83.8900

SD_CAP_BYTES     = 32 * 1024 * 1024 * 1024   # 32 GB card fitted on the Teensy 4.1
FLASH_CAP_BYTES  = 8 * 1024 * 1024
BYTES_PER_PACKET = 56                        # packed binary downlink, see
                                             # vritra_fc/Config.h DL_PACKET_LEN

# --- Flight software states (§6.2.i) -------------------------------------
STATES    = ["BOOT", "LAUNCH", "EJECT", "SEC_EJECT", "TOUCHDOWN"]
STATE_NUM = {s: i for i, s in enumerate(STATES)}

# How many on-pad fixes to fold into the surveyed pad origin before freezing
# it. At the 0.5 Hz pad downlink that is ~2 minutes of averaging, which is
# comfortably past the point a GNSS solution has settled. The cap exists so a
# long pre-flight hold cannot leave the origin so heavily averaged that a
# genuine late correction from the receiver can no longer move it.
PAD_SURVEY_MAX = 60

# Every entry here MUST exist in CMD_TABLE in vritra_gs/vritra_gs.ino and in
# enum CmdId in vritra_fc/Config.h. A command offered here but missing from the
# gateway's table is accepted by this UI, dropped silently on the USB link, and
# never reaches the vehicle — the operator sees no error at all.
#
# REMOVED at this revision: CMD_ARM, CMD_DISARM, CMD_FORCE_EJECT,
# CMD_FORCE_SEC_EJ, CMD_BRAKE_DEPLOY. The three FORCE/BRAKE commands drove
# actuators this vehicle does not carry — there is no ejection charge, no
# secondary charge and no drag brake — and the arming pair is superseded:
# CMD_TX_ON now arms the flight state machine as well, since guideline §6.1.v
# already makes it the last deliberate action before flight. Their ids (4-8)
# remain reserved on the wire so the remaining ids never shift meaning.
COMMANDS = {
    "CMD_TX_ON":        "Enable downlink transmission (also ARMS the FSM)",
    "CMD_TX_OFF":       "Disable downlink transmission (does not disarm)",
    "CMD_CALIBRATE":    "Zero attitude / baro / gyro at current position",
    "CMD_BEACON_ON":    "Audio beacon ON (post-landing)",
    "CMD_BEACON_OFF":   "Audio beacon OFF",
    "CMD_FAILOVER":     "Switch to backup frequency (gateway follows)",
    "CMD_RESET":        "Soft reset flight computer",
    "CMD_GYRO_ON":      "Gyro stabilisation wheel ON",
    "CMD_GYRO_OFF":     "Gyro stabilisation wheel OFF",
    "CMD_GYRO_SPD":     "Gyro wheel speed, arg = percent",
    "CMD_MAG_CAL":      "Magnetometer hard-iron cal: arg 1 start, 0 finish",
    "CMD_GPS_RESET":    "Hard-reset the GNSS receiver",
    "CMD_NEW_MISSION":  "Wipe mission state and reboot (destructive)",
}

COMMAND_LABELS = {
    "CMD_TX_ON":       "Tx On",
    "CMD_TX_OFF":      "Tx Off",
    "CMD_CALIBRATE":   "Calibrate",
    "CMD_BEACON_ON":   "Beacon On",
    "CMD_BEACON_OFF":  "Beacon Off",
    "CMD_FAILOVER":    "Failover",
    "CMD_RESET":       "Reset",
    "CMD_GYRO_ON":     "Gyro On",
    "CMD_GYRO_OFF":    "Gyro Off",
    "CMD_GYRO_SPD":    "Gyro Speed",
    "CMD_MAG_CAL":     "Mag Cal",
    "CMD_GPS_RESET":   "GNSS Reset",
    "CMD_NEW_MISSION": "New Mission",
}


def _log_dir() -> Path:
    base = Path(os.path.expanduser("~")) / "VRITRA_GCS_logs"
    base.mkdir(parents=True, exist_ok=True)
    return base


LOG_DIR = _log_dir()
logging.basicConfig(
    level=logging.INFO,
    format="%(asctime)s [%(levelname)s] %(message)s",
    handlers=[logging.FileHandler(LOG_DIR / "vritra_gcs.log", encoding="utf-8"),
              logging.StreamHandler(sys.stderr)],
)
log = logging.getLogger("VRITRA")


# =========================================================================
# §2  TELEMETRY DICTIONARY — the single source of truth
# =========================================================================
# Every field carries its own metadata, so one dict drives the CSV header,
# the parser, every tile, the limits engine, the console formatter, the
# parameter browser and the exported machine-readable dictionary.
#
#   u    unit string
#   g    subsystem group (also selects the staleness class)
#   d    human description
#   lim  (red_low, yellow_low, yellow_high, red_high); None disables limits.
#        Any bound may individually be None for one-sided parameters.
#   pers persistence — consecutive out-of-limit samples required before the
#        state actually changes. Stops a single noisy packet raising alarms.
#   disc discrete/enumerated field: shown as a state, never limit-checked
#        numerically and never interpolated on a chart.
#
# Limit values are grounded in the flight hardware: 3S Molicel Li-Ion with
# NO BMS fitted (so BUS_V is the primary battery-health indicator), LR1121
# at -137 dBm sensitivity, and the PDR thermal/mechanical envelopes.
# -------------------------------------------------------------------------
def _f(u="", g="core", d="", lim=None, pers=1, disc=False):
    return {"u": u, "g": g, "d": d, "lim": lim, "pers": pers, "disc": disc}


SCHEMA = OrderedDict([
    # ---- COMPETITION-MANDATED CORE, positions 0..15 (§6.3 / PDR Table 10).
    # ---- Order is fixed by the guideline. Do not reorder.
    ("TIME_S",    _f("s",    "core", "Mission time since power-on")),
    ("PKT",       _f("",     "core", "Packet counter")),
    ("ALT_M",     _f("m",    "core", "Barometric altitude AGL", (None, None, 1200, 1500), 2)),
    ("PRES_PA",   _f("Pa",   "core", "Atmospheric pressure", (50000, 70000, 105000, 110000), 2)),
    ("TEMP_C",    _f("°C",   "core", "Air temperature", (-20, -10, 60, 75), 3)),
    # 3S Li-Ion (3 x 21700, metal can per guideline 5.3.iii) behind a 3S 40 A BMS,
    # as declared in PDR 5.5.1 and modelled in Fusion. 11.1 V nominal, 12.6 V full.
    # NOTE: the bench ADC log reads a steady 7.87 V, which is NOT a healthy 3S
    # pack (that would be 2.62 V/cell, below any BMS cut-off). Whatever was on the
    # bench was not the flight pack. Confirm before flight — and if the pack ever
    # changes, this line and BATT_CELLS/BATT_EMPTY_V/BATT_FULL_V in
    # vritra_fc/Config.h must change together, never one without the other.
    ("BUS_V",     _f("V",    "core", "Main bus voltage · 3S Li-Ion + BMS", (9.6, 10.5, 12.6, 12.9), 3)),
    ("GNSS_TIME", _f("s",    "core", "GNSS receiver time")),
    ("LAT",       _f("°",    "core", "GNSS latitude")),
    ("LON",       _f("°",    "core", "GNSS longitude")),
    ("GPS_ALT_M", _f("m",    "core", "GNSS altitude")),
    ("SATS",      _f("",     "gnss", "GNSS satellites tracked", (3, 5, None, None), 3)),
    ("ACC_X",     _f("m/s²", "imu",  "Accelerometer X (LSM6DSO32)")),
    ("ACC_Y",     _f("m/s²", "imu",  "Accelerometer Y (LSM6DSO32)")),
    ("ACC_Z",     _f("m/s²", "imu",  "Accelerometer Z (LSM6DSO32)")),
    ("SPIN_RATE", _f("°/s",  "imu",  "Mechanical-gyro spin rate", (None, None, 180, 360), 3)),
    ("STATE",     _f("",     "core", "Flight-software state 0..4", disc=True)),
    # ---- TEAM PAYLOAD, appended per §6.3.B --------------------------------
    ("BUS_I_MA",  _f("mA",   "power", "Main bus current (INA226)", (None, None, 1500, 2500), 3)),
    ("SOC_PCT",   _f("%",    "power", "Battery state of charge", (10, 25, None, None), 3)),
    ("GND_SPEED", _f("m/s",  "gnss",  "GNSS ground speed")),
    ("HUM_PCT",   _f("%",    "env",   "Relative humidity")),
    # AX / AY / AZ USED TO BE HERE, AT 20/21/22. THEY WERE NOT DATA.
    # They are ACC_X/ACC_Y/ACC_Z (11/12/13, mandated, m/s^2) divided by g, and
    # the flight computer filled both from the same three variables. They never
    # rode the wire — the gateway synthesised them on arrival — so carrying
    # them as SCHEMA fields bought nothing and cost the thing this codebase
    # keeps paying for elsewhere: two slots holding one fact, free to disagree
    # the moment one path changes. They are now DERIVED (see below), computed
    # once in Physics from the mandated field, still displayed in g on the
    # INERTIAL panel exactly as before.
    ("GX",        _f("°/s",  "imu",   "Gyroscope X (ICM-20948)")),
    ("GY",        _f("°/s",  "imu",   "Gyroscope Y (ICM-20948)")),
    ("GZ",        _f("°/s",  "imu",   "Gyroscope Z (ICM-20948)")),
    ("MX",        _f("µT",   "imu",   "Magnetometer X (ICM-20948)")),
    ("MY",        _f("µT",   "imu",   "Magnetometer Y (ICM-20948)")),
    ("MZ",        _f("µT",   "imu",   "Magnetometer Z (ICM-20948)")),
    ("AHX",       _f("g",    "imu",   "High-g accel X (LSM6DSO32 ±32 g)")),
    ("AHY",       _f("g",    "imu",   "High-g accel Y (LSM6DSO32 ±32 g)")),
    ("AHZ",       _f("g",    "imu",   "High-g accel Z (LSM6DSO32 ±32 g)")),
    ("PM1",       _f("µg/m³","env",   "Particulate matter 1.0 (BMV080)")),
    ("PM25",      _f("µg/m³","env",   "Particulate matter 2.5 (BMV080)", (None, None, 55, 150), 3)),
    ("PM10",      _f("µg/m³","env",   "Particulate matter 10 (BMV080)")),
    ("LUX",       _f("lx",   "env",   "Illuminance (BH1750)")),
    ("UV",        _f("mW/cm²","env",  "UV irradiance (ML8511)")),
    ("CO2",       _f("ppm",  "env",   "CO2 concentration (SCD41)", (None, None, 2000, 5000), 3)),
    ("TVOC",      _f("ppb",  "env",   "Total VOC (ENS160)")),
    ("ECO2",      _f("ppm",  "env",   "Equivalent CO2 (ENS160)")),
    ("AQI",       _f("",     "env",   "Air-quality index 1..5 (ENS160)")),
    ("O3",        _f("ppb",  "env",   "Ozone (MQ131)")),
    ("HDC_T",     _f("°C",   "env",   "Reference temperature (HDC3020)")),
    ("HDC_RH",    _f("%",    "env",   "Reference humidity (HDC3020)")),
    ("LGT_DIST",  _f("km",   "env",   "Lightning distance (AS3935)")),
    ("LGT_INT",   _f("",     "env",   "Lightning intensity (AS3935)")),
    ("LGT_FLAG",  _f("",     "env",   "Lightning strike detected", disc=True)),
    ("S_405",     _f("µW/cm²","spec", "Spectral 405 nm (AS7343)")),
    ("S_425",     _f("µW/cm²","spec", "Spectral 425 nm (AS7343)")),
    ("S_450",     _f("µW/cm²","spec", "Spectral 450 nm (AS7343)")),
    ("S_475",     _f("µW/cm²","spec", "Spectral 475 nm (AS7343)")),
    ("S_515",     _f("µW/cm²","spec", "Spectral 515 nm (AS7343)")),
    ("S_550",     _f("µW/cm²","spec", "Spectral 550 nm (AS7343)")),
    ("S_555",     _f("µW/cm²","spec", "Spectral 555 nm (AS7343)")),
    ("S_600",     _f("µW/cm²","spec", "Spectral 600 nm (AS7343)")),
    ("S_640",     _f("µW/cm²","spec", "Spectral 640 nm (AS7343)")),
    ("S_690",     _f("µW/cm²","spec", "Spectral 690 nm (AS7343)")),
    ("S_745",     _f("µW/cm²","spec", "Spectral 745 nm (AS7343)")),
    ("S_855",     _f("µW/cm²","spec", "Spectral 855 nm NIR (AS7343)")),
    ("S_CLR",     _f("µW/cm²","spec", "Spectral clear channel (AS7343)")),
    ("S_FLK",     _f("Hz",   "spec",  "Flicker frequency (AS7343)")),
    ("RSSI",      _f("dBm",  "rf",    "Downlink RSSI (LR1121)", (-125, -110, None, None), 3)),
    ("SNR",       _f("dB",   "rf",    "Downlink SNR (LR1121)", (-15, -7, None, None), 3)),
    ("FREQ_MHZ",  _f("MHz",  "rf",    "Carrier frequency — Team 025: 866.50 / 865.25 MHz",
                  (865.0, 865.1, 867.01, 868.0), 2)),
    ("SERVO_V",   _f("V",    "power", "Servo rail voltage", (4.5, 4.8, 6.2, 6.5), 3)),
    ("SERVO_I_MA",_f("mA",   "power", "Servo rail current", (None, None, 1500, 2500), 3)),
    ("SRV1_DEG",  _f("°",    "mech",  "Eject servo 1 (MG90S)")),
    ("SRV2_DEG",  _f("°",    "mech",  "Eject servo 2 (MG90S)")),
    ("SRV3_DEG",  _f("°",    "mech",  "Brake servo L (OT5330M)")),
    ("SRV4_DEG",  _f("°",    "mech",  "Brake servo R (OT5330M)")),
    ("MCU_ACTIVE",_f("",     "sys",   "Active MCU: 0 primary, 1 backup", disc=True)),
    ("WDOG_OK",   _f("",     "sys",   "Watchdog petting OK (TPL5010)", disc=True)),
    ("SD_PCT",    _f("%",    "sys",   "microSD utilisation", (None, None, 80, 95), 2)),
    ("FLASH_PCT", _f("%",    "sys",   "W25Q64 flash utilisation", (None, None, 80, 95), 2)),
    ("BEACON_ON", _f("",     "sys",   "Recovery beacon active", disc=True)),
    ("CAM1_OK",   _f("",     "sys",   "Camera 1 health flag", disc=True)),
    ("CAM2_OK",   _f("",     "sys",   "Camera 2 health flag", disc=True)),
    ("NAVIC_SATS",_f("",     "gnss",  "NavIC / IRNSS satellites")),
    ("UTC",       _f("",     "sys",   "UTC timestamp (DS3231)", disc=True)),
    # ---- GNSS QUALITY, appended at positions 79..83 -----------------------
    # Appending is safe: the parser is positional and trailing fields are
    # optional, so every existing column keeps its index and a firmware that
    # does not yet send these simply leaves them absent (rendered as "—").
    # These come straight out of the Quectel L89's NMEA GGA/GSA sentences.
    ("HDOP",      _f("",     "gnss",  "Horizontal dilution of precision",
                     (None, None, 2.0, 5.0), 3)),
    ("VDOP",      _f("",     "gnss",  "Vertical dilution of precision",
                     (None, None, 3.0, 7.0), 3)),
    ("FIX_QUALITY", _f("",   "gnss",  "GGA fix quality 0..6", disc=True)),
    ("GEOID_SEP", _f("m",    "gnss",  "Geoid separation (MSL - WGS84 ellipsoid)")),
    ("GNSS_SYS",  _f("",     "gnss",  "Constellation bitmask in the solution",
                     disc=True)),

    # ---- fused attitude, computed ON THE FLIGHT COMPUTER -------------------
    # Appended at the end (indices 81-82) so no existing graded column moves.
    # These are NOT derived here. A 50 Hz complementary filter on the Teensy
    # fuses gyro and accelerometer and transmits the result; the ground station
    # only ever sees 1 Hz, so anything it computed itself would be a static
    # tilt with every rotation between samples invisible.
    #
    # WHY THESE TWO SURVIVED THE WIRE-LAYOUT-3 CUT AND THE OTHER FOUR DID NOT.
    # Guideline table row 13 defines <ACCELEROMETER DATA> as "acceleration and
    # roll & pitch parameters", so roll and pitch are MANDATED CONTENT and stay
    # on the wire and in the graded CSV whether or not a panel reads them.
    # ATT_YAW and QUAT_X/Y/Z were named nowhere in that table -- they fell under
    # row 16 <OPTIONAL DATA> -- and cost 12 B of every 86 B packet to carry
    # attitude this ground station never displayed: no panel read ATT_YAW, and
    # _update_instruments() explicitly severed the quaternion with
    # set_quaternion(None). Both are still recorded at 20 Hz on the vehicle's
    # own SD card, which is a better record than a 1 Hz copy of it.
    ("ATT_ROLL",  _f("°",    "imu",   "Fused roll (flight-computer 50 Hz)")),
    ("ATT_PITCH", _f("°",    "imu",   "Fused pitch (flight-computer 50 Hz)")),
])

ALL_FIELDS  = list(SCHEMA.keys())
N_FIELDS    = len(ALL_FIELDS)
CORE_FIELDS = [k for k, v in SCHEMA.items() if v["g"] == "core"]
INT_FIELDS  = {"PKT", "STATE", "SATS", "AQI", "MCU_ACTIVE", "WDOG_OK",
               "BEACON_ON", "CAM1_OK", "CAM2_OK", "NAVIC_SATS", "LGT_FLAG"}

# Decimal places used when a field is WRITTEN to the CSV / wire format.
# Coordinates need 7: at 3 dp one unit of latitude is ~111 m, which would
# quantise the graded track and the recovery fix to the size of a football
# field. Everything else is comfortable at 3.
CSV_DECIMALS = {"LAT": 7, "LON": 7, "GNSS_TIME": 2, "TIME_S": 3}
CSV_DEFAULT_DECIMALS = 3


def csv_cell(key, v):
    """Format one value for the CSV / wire format at its correct precision."""
    if isinstance(v, str):
        return v
    if key in INT_FIELDS:
        return str(int(round(v)))
    return f"{v:.{CSV_DECIMALS.get(key, CSV_DEFAULT_DECIMALS)}f}"

GROUP_LABEL = {
    "core": "Flight Core", "imu": "Inertial", "gnss": "Navigation",
    "power": "Power", "env": "Environment", "spec": "Spectral",
    "rf": "Radio Link", "mech": "Mechanisms", "sys": "Systems",
}

# -------------------------------------------------------------------------
# Derived parameters get the same dictionary treatment so the limits engine
# and the parameter browser cover computed values too.
# -------------------------------------------------------------------------
DERIVED = OrderedDict([
    ("VSPEED",      _f("m/s",  "core",  "Vertical speed (baro differentiation)")),
    ("DESCENT",     _f("m/s",  "core",  "Descent rate")),
    ("AGL_M",       _f("m",    "core",  "Height above launch site")),
    ("APOGEE_M",    _f("m",    "core",  "Apogee (running maximum)")),
    ("SPEED_3D",    _f("m/s",  "core",  "3-D speed (GNSS + baro fusion)")),
    ("PEAK_V",      _f("m/s",  "core",  "Peak 3-D speed")),
    ("TTL_S",       _f("s",    "core",  "Projected time to landing")),
    # Moved out of SCHEMA — see the note at the old 20/21/22 position. Same
    # measurement as the mandated ACC_X/Y/Z, expressed in g because that is
    # what an IMU readout is read in. One source, two presentations.
    ("AX",          _f("g",    "imu",   "Accelerometer X in g (= ACC_X / 9.80665)")),
    ("AY",          _f("g",    "imu",   "Accelerometer Y in g (= ACC_Y / 9.80665)")),
    ("AZ",          _f("g",    "imu",   "Accelerometer Z in g (= ACC_Z / 9.80665)")),
    ("ROLL",        _f("°",    "imu",   "Roll angle (accelerometer)")),
    ("PITCH",       _f("°",    "imu",   "Pitch angle (accelerometer)")),
    ("YAW",         _f("°",    "imu",   "Yaw / heading")),
    ("HEADING",     _f("°",    "imu",   "Tilt-compensated magnetic heading")),
    ("TILT",        _f("°",    "imu",   "Body tilt from vertical", (None, None, 30, 60), 3)),
    ("SPIN_DPS",    _f("°/s",  "imu",   "Authoritative spin rate")),
    ("OMEGA_T",     _f("°/s",  "imu",   "Transverse angular rate")),
    ("INSTAB",      _f("",     "imu",   "Instability index 0..1", (None, None, 0.5, 0.8), 3)),
    ("STABLE",      _f("",     "imu",   "Stability index 0..1")),
    ("NUTATION",    _f("°/s",  "imu",   "Nutation rate")),
    ("CONING",      _f("°/s",  "imu",   "Coning rate proxy")),
    ("H_BODY",      _f("mN·m·s","imu",  "Body angular momentum")),
    ("B_MAG",       _f("µT",   "imu",   "Magnetic field magnitude")),
    ("B_INCL",      _f("°",    "imu",   "Magnetic inclination")),
    ("G_HI",        _f("g",    "imu",   "High-g magnitude")),
    ("G_HI_PK",     _f("g",    "imu",   "Peak high-g")),
    ("AIR_RHO",     _f("kg/m³","env",   "Air density (ISA)")),
    ("P_ALT",       _f("m",    "env",   "Pressure altitude")),
    ("DENS_ALT",    _f("m",    "env",   "Density altitude")),
    ("DEW_POINT",   _f("°C",   "env",   "Dew point (Magnus)")),
    ("CLOUD_BASE",  _f("m",    "env",   "Estimated cloud base (Espy)")),
    ("AQI_PM",      _f("",     "env",   "EPA AQI from PM2.5", (None, None, 100, 200), 3)),
    ("IRR_TOT",     _f("µW/cm²","spec", "Total spectral irradiance")),
    ("DYN_Q",       _f("Pa",   "core",  "Dynamic pressure")),
    ("MACH",        _f("",     "core",  "Mach number")),
    ("REYNOLDS",    _f("",     "core",  "Reynolds number")),
    ("SOS",         _f("m/s",  "core",  "Speed of sound")),
    ("GLIDE_LD",    _f("",     "core",  "Glide lift-to-drag ratio")),
    ("GLIDE_SLOPE", _f("°",    "core",  "Glide slope angle")),
    ("SINK_RATE",   _f("m/s",  "core",  "Sink rate")),
    ("P_BUS",       _f("W",    "power", "Bus power")),
    ("P_SERVO",     _f("W",    "power", "Servo power")),
    ("P_TOTAL",     _f("W",    "power", "Total power")),
    ("ENERGY_WH",   _f("Wh",   "power", "Cumulative energy")),
    ("LINK_MARGIN", _f("dB",   "rf",    "Link margin above LR1121 floor", (3, 8, None, None), 3)),
    ("DIST_M",      _f("m",    "gnss",  "Great-circle range from pad")),
    ("BEARING",     _f("°",    "gnss",  "Bearing from pad")),
    ("BARO_GPS_DALT", _f("m",  "gnss",  "Baro vs GNSS altitude difference")),
])

FIELD_META = OrderedDict(list(SCHEMA.items()) + list(DERIVED.items()))


# =========================================================================
# §3  PARSER  —  host does all the work, the CanSat sends raw bytes
# =========================================================================
# Per the design research: the flight hardware never emits JSON. It blasts
# the cheapest possible CSV and this host maps bytes onto named fields.
# -------------------------------------------------------------------------
def _finite(x, default=0.0):
    """Return x as a finite float, else `default`. Keeps NaN/Inf out of
    QPainter, numpy and the CSV."""
    try:
        v = float(x)
        return v if math.isfinite(v) else default
    except (TypeError, ValueError):
        return default


def parse_packet(line: str):
    """CSV telemetry line -> (values, present).

    `values`  every schema field; absent ones default to 0.0 purely so that
              downstream physics and logging never KeyError.
    `present` the fields that carried a real, non-empty, parsable cell.

    Display code MUST consult `present` before rendering. This is what
    separates "the sensor reported zero" from "the sensor is not there" —
    the GCS never invents a number for hardware that is not reporting.
    """
    out = OrderedDict((k, 0.0) for k in ALL_FIELDS)
    present = set()
    
    if not line or line.startswith(("//", "──", "══", "[RF]", "[TX]", "[RX]", "PKT #")):
        return out, present

    parts = line.strip().lstrip("$").rstrip("*").split(",")
    # §6.3 mandates TEAM_ID as CSV column 0. The schema starts at TIME_S, so
    # strip it — without this every field would be offset by one.
    if parts and parts[0].strip() == TEAM_ID:
        parts = parts[1:]

    for i, key in enumerate(ALL_FIELDS):
        if i >= len(parts):
            break                       # transmitter stopped early: rest absent
        cell = parts[i].strip()
        if cell == "":
            continue                    # explicit empty cell: absent, not zero
        if key == "UTC":
            out[key] = cell
            present.add(key)
            continue
        v = _finite(cell, None)
        if v is None:
            continue                    # unparsable: absent, never coerced to 0
        out[key] = v
        present.add(key)
    return out, present


def serialize_packet(d: dict, present=None) -> str:
    """Schema dict -> CSV line. Fields absent from `present` are written as
    empty cells so the log stays honest about what was actually received."""
    cells = []
    for k in ALL_FIELDS:
        if present is not None and k not in present:
            cells.append("")
            continue
        v = d.get(k, 0.0)
        if k == "UTC":
            cells.append(str(v) if v else "")
        else:
            cells.append(csv_cell(k, v))
    return ",".join(cells)


def export_dictionary(path: Path) -> Path:
    """Write the machine-readable telemetry dictionary.

    F´ auto-generates its ground system from a dictionary; ours is the
    SCHEMA above. Exporting it gives the PDR/FRR appendix a single
    authoritative artifact instead of a hand-maintained table.
    """
    doc = {
        "team_id": TEAM_ID, "version": APP_VERSION,
        "generated": datetime.datetime.now().isoformat(timespec="seconds"),
        "csv_column_0": "TEAM_ID",
        "downlink_fields": N_FIELDS,
        "fields": [], "derived": [],
    }
    for i, (k, m) in enumerate(SCHEMA.items()):
        doc["fields"].append({
            "index": i, "csv_column": i + 1, "name": k, "unit": m["u"],
            "group": m["g"], "description": m["d"], "limits": m["lim"],
            "persistence": m["pers"], "discrete": m["disc"],
        })
    for k, m in DERIVED.items():
        doc["derived"].append({
            "name": k, "unit": m["u"], "group": m["g"],
            "description": m["d"], "limits": m["lim"],
        })
    path.write_text(json.dumps(doc, indent=2), encoding="utf-8")
    return path


# =========================================================================
# §4  LIMITS + STALENESS ENGINE
# =========================================================================
# Two independent failure modes, one unified verdict per parameter:
#
#   1. VALUE   is the number outside its safe envelope?   (COSMOS model:
#              RED_LOW / YELLOW_LOW / YELLOW_HIGH / RED_HIGH, with a
#              persistence counter so one noisy packet cannot raise an alarm)
#   2. TIME    is the number still trustworthy?           (design research:
#              Nominal -> Warning -> Stale -> Alarm by age since last real
#              sample, per subsystem)
#
# A dashboard that shows the last received value forever is actively
# dangerous: the operator cannot tell a steady vehicle from a dead
# transmitter. Age therefore outranks value — a stale reading is reported as
# stale no matter how nominal it looks.
# -------------------------------------------------------------------------
ST_NODATA   = "NO_DATA"
ST_NOMINAL  = "NOMINAL"
ST_YEL_LOW  = "YELLOW_LOW"
ST_YEL_HIGH = "YELLOW_HIGH"
ST_RED_LOW  = "RED_LOW"
ST_RED_HIGH = "RED_HIGH"
ST_WARNING  = "WARNING"     # ageing, not yet stale
ST_STALE    = "STALE"
ST_LOST     = "LOST"

# Severity ordering drives the master alarm and the sort in the alarm list.
SEVERITY = {
    ST_NODATA: 0, ST_NOMINAL: 0,
    ST_WARNING: 1, ST_YEL_LOW: 2, ST_YEL_HIGH: 2, ST_STALE: 2,
    ST_RED_LOW: 3, ST_RED_HIGH: 3, ST_LOST: 3,
}
IS_ALARM = {ST_RED_LOW, ST_RED_HIGH, ST_LOST}
IS_WARN  = {ST_YEL_LOW, ST_YEL_HIGH, ST_STALE, ST_WARNING}

# Per-subsystem temporal thresholds, in seconds of age.
#   (warning, stale, lost)
# The design research tabulates these for an orbital vehicle sampling far
# faster than we do. Our downlink is 1 Hz, so a "< 1.0 s nominal" band is
# physically unreachable; the values below preserve the research's ratios
# and intent while staying achievable on a 1 Hz LoRa link.
STALE_CLASS = {
    "core":  (3.0,  6.0,  12.0),
    "imu":   (2.0,  4.0,   8.0),
    "power": (5.0, 10.0,  30.0),
    "gnss":  (5.0, 15.0,  30.0),
    "rf":    (3.0,  6.0,  15.0),
    "mech":  (5.0, 15.0,  30.0),
    "env":  (10.0, 30.0,  60.0),
    "spec": (10.0, 30.0,  60.0),
    "sys":  (10.0, 30.0,  60.0),
}


# Parameters for which an unchanging value is CORRECT, not a fault: commanded
# settings, properties of the launch site, held actuator positions and coarse
# integer indices. Everything else analog is expected to show sensor noise.
FROZEN_EXEMPT = {
    "FREQ_MHZ",        # commanded, not measured
    "GEOID_SEP",       # a property of the location
    "SRV1_DEG", "SRV2_DEG", "SRV3_DEG", "SRV4_DEG",   # hold commanded angle
    "SATS", "NAVIC_SATS",   # integer counts, plausibly steady for minutes
    "AQI",             # coarse 1..5 index
    "TIME_S", "PKT",   # monotonic counters
    "SD_PCT", "FLASH_PCT",
}


class ParamState:
    """Limit + staleness state for one parameter, with anti-chatter."""

    __slots__ = ("name", "meta", "state", "value", "last_seen",
                 "_cand", "_count", "ever_seen", "_recent")

    FROZEN_WINDOW = 40

    def __init__(self, name, meta):
        self.name = name
        self.meta = meta
        self.state = ST_NODATA
        self.value = None
        self.last_seen = None
        self._cand = ST_NODATA      # candidate state awaiting persistence
        self._count = 0
        self.ever_seen = False
        self._recent = deque(maxlen=self.FROZEN_WINDOW)

    def is_frozen(self, min_samples):
        """True when a live sensor keeps reporting one identical value.

        This is the failure mode neither of the other two engines can see: a
        locked-up sensor is still transmitting, so staleness never fires, and
        its frozen reading is usually inside limits, so the envelope never
        fires either. An operator would watch a dead sensor look healthy.
        """
        if self.meta.get("disc") or self.name in FROZEN_EXEMPT:
            return False
        # Measured sensors only. Derived values are computed from raw ones, so
        # a genuine freeze is already caught at its source — while several
        # derived values are constant BY DESIGN (APOGEE_M, PEAK_V and G_HI_PK
        # are latched running maxima; TTL_S and GLIDE_LD sit at zero whenever
        # the vehicle is not descending). Flagging those would cry wolf.
        if self.name not in SCHEMA:
            return False
        if len(self._recent) < min_samples:
            return False
        first = self._recent[0]
        if not isinstance(first, (int, float)):
            return False
        return all(v == first for v in self._recent)

    # -- value classification (COSMOS four-threshold model) ---------------
    def _classify(self, v):
        lim = self.meta.get("lim")
        if not lim or self.meta.get("disc") or not isinstance(v, (int, float)):
            return ST_NOMINAL
        rl, yl, yh, rh = lim
        if rl is not None and v < rl:
            return ST_RED_LOW
        if rh is not None and v > rh:
            return ST_RED_HIGH
        if yl is not None and v < yl:
            return ST_YEL_LOW
        if yh is not None and v > yh:
            return ST_YEL_HIGH
        return ST_NOMINAL

    def update_value(self, v, now):
        """Record a genuinely received sample."""
        self.value = v
        self.last_seen = now
        self.ever_seen = True
        self._recent.append(v)
        target = self._classify(v)
        need = max(1, int(self.meta.get("pers", 1)))
        if target == self._cand:
            self._count += 1
        else:
            self._cand, self._count = target, 1
        # Returning to nominal is immediate; entering an off-nominal state
        # must persist. Alarms should be hard to raise, easy to clear.
        if target == ST_NOMINAL or self._count >= need:
            self.state = target

    def evaluate_age(self, now):
        """Re-evaluate purely on elapsed time. Runs every UI tick, including
        ticks where no packet arrived — this is what catches a sensor that
        silently stops transmitting."""
        if not self.ever_seen or self.last_seen is None:
            self.state = ST_NODATA
            return self.state
        warn, stale, lost = STALE_CLASS.get(self.meta.get("g", "core"),
                                            STALE_CLASS["core"])
        age = now - self.last_seen
        if age > lost:
            self.state = ST_LOST
        elif age > stale:
            self.state = ST_STALE
        elif age > warn:
            # Ageing but still usable: only downgrade a nominal reading, never
            # mask a real limit breach that is still worth shouting about.
            if self.state not in IS_ALARM:
                self.state = ST_WARNING
        elif self.state in (ST_WARNING, ST_STALE, ST_LOST):
            # Age is back inside the nominal band, so the verdict reverts to
            # the value classification. Without this branch an age-driven
            # state could only ever escalate: the machine relied on
            # update_value() happening to run first, which made it
            # order-dependent and left stale ink on a recovered parameter.
            self.state = self._classify(self.value)
        return self.state

    @property
    def age(self):
        return None if self.last_seen is None else time.time() - self.last_seen


class LimitsEngine:
    """Owns a ParamState for every dictionary field and reports transitions."""

    def __init__(self):
        self.params = {k: ParamState(k, m) for k, m in FIELD_META.items()}
        self.events = deque(maxlen=2000)     # (t, severity, name, old, new)
        self._prev = {k: ST_NODATA for k in FIELD_META}
        self.master = ST_NOMINAL
        self.active = []                     # off-nominal params, worst first
        self.frozen = set()                  # live sensors stuck on one value
        self._prev_frozen = set()

    def ingest(self, values, present, derived, derived_present, now=None):
        now = now or time.time()
        for k in present:
            if k in self.params and not FIELD_META[k]["disc"]:
                self.params[k].update_value(_finite(values.get(k)), now)
            elif k in self.params:
                self.params[k].update_value(values.get(k), now)
        for k in derived_present:
            if k in self.params:
                self.params[k].update_value(_finite(derived.get(k)), now)

    def evaluate(self, now=None):
        """Age every parameter, collect transitions, recompute master alarm."""
        now = now or time.time()
        active = []
        worst = ST_NOMINAL
        for k, p in self.params.items():
            new = p.evaluate_age(now)
            old = self._prev[k]
            if new != old:
                self._prev[k] = new
                # A sensor simply starting to report is not an event. Logging
                # every NO_DATA -> NOMINAL buried the real transitions under
                # 100+ lines of startup noise on the first packet.
                if not (old == ST_NODATA and new == ST_NOMINAL):
                    self.events.append((now, SEVERITY.get(new, 0), k, old, new))
            if new in IS_ALARM or new in IS_WARN:
                active.append(p)
            if SEVERITY.get(new, 0) > SEVERITY.get(worst, 0):
                worst = new
        active.sort(key=lambda p: (-SEVERITY.get(p.state, 0), p.name))
        self.active = active

        # Frozen-sensor sweep. Reported alongside limits rather than folded
        # into a parameter's state, because "this reading is wrong" and "this
        # reading has stopped moving" are different things to tell an operator.
        self.frozen = {k for k, p in self.params.items()
                       if p.ever_seen and p.is_frozen(FROZEN_MIN_SAMPLES)}
        for k in self.frozen - self._prev_frozen:
            self.events.append((now, 2, k, "LIVE", "FROZEN"))
        for k in self._prev_frozen - self.frozen:
            self.events.append((now, 1, k, "FROZEN", "LIVE"))
        self._prev_frozen = set(self.frozen)
        if self.frozen and SEVERITY.get(worst, 0) < 2:
            worst = ST_STALE           # a stuck sensor is at least a caution

        self.master = worst
        return worst

    def state_of(self, name):
        p = self.params.get(name)
        return p.state if p else ST_NODATA

    def recent_events(self, n=200):
        return list(self.events)[-n:]


# How many consecutive identical samples before a live sensor is called stuck.
# At 1 Hz this is ~20 s of a perfectly unchanging analog reading, which no
# real noisy sensor produces.
FROZEN_MIN_SAMPLES = 20


def frozen_sensors(engine, min_samples=FROZEN_MIN_SAMPLES):
    """-> sorted names of live-but-stuck sensors in `engine`."""
    return sorted(k for k, p in engine.params.items()
                  if p.ever_seen and p.is_frozen(min_samples))


# =========================================================================
# §5  LoRa LINK BUDGET  —  Semtech AN1200.13 + WPC India compliance
# =========================================================================
def lora_symbol_time_s(sf: int, bw_hz: float) -> float:
    """T_sym = 2^SF / BW."""
    return (2.0 ** sf) / float(bw_hz)


def lora_ldro_required(sf: int, bw_hz: float) -> bool:
    """Low Data Rate Optimization is mandatory once a symbol exceeds 16 ms
    (SF11 and SF12 at BW125)."""
    return lora_symbol_time_s(sf, bw_hz) > 0.016


def lora_time_on_air(sf=9, bw_hz=125000, cr=1, payload_bytes=55,
                     preamble=8, explicit_header=True, crc=True, ldro=None):
    """Packet air time in seconds, per Semtech AN1200.13.

        T_sym       = 2^SF / BW
        T_preamble  = (n_preamble + 4.25) * T_sym
        n_payload   = 8 + max(ceil((8PL - 4SF + 28 + 16CRC - 20IH)
                                   / (4(SF - 2DE))) * (CR + 4), 0)
        T_packet    = T_preamble + n_payload * T_sym

    `cr` is 1..4 for coding rates 4/5..4/8. `ldro=None` auto-selects per the
    16 ms rule. Validated against the canonical LoRaWAN DR0 reference:
    SF12 / BW125 / CR4-5 / 51 B / explicit / CRC on  ->  2465.8 ms.
    """
    sf = int(max(6, min(12, sf)))
    cr = int(max(1, min(4, cr)))
    pl = int(max(0, payload_bytes))
    t_sym = lora_symbol_time_s(sf, bw_hz)
    de = (1 if lora_ldro_required(sf, bw_hz) else 0) if ldro is None else int(bool(ldro))
    ih = 0 if explicit_header else 1
    crc_b = 1 if crc else 0

    denom = 4 * (sf - 2 * de)
    if denom <= 0:
        return float("nan")
    num = 8 * pl - 4 * sf + 28 + 16 * crc_b - 20 * ih
    n_payload = 8 + max(math.ceil(num / denom) * (cr + 4), 0)

    t_preamble = (preamble + 4.25) * t_sym
    return t_preamble + n_payload * t_sym


def lora_bitrate_bps(sf=9, bw_hz=125000, cr=1) -> float:
    """Effective LoRa bit rate: SF * (BW / 2^SF) * (4 / (4 + CR))."""
    return sf * (bw_hz / (2.0 ** sf)) * (4.0 / (4.0 + cr))


def duty_cycle_budget(toa_s, limit=DUTY_CYCLE_LIMIT):
    """-> (max packets/hour, seconds of airtime allowed per hour)."""
    airtime_per_hour = 3600.0 * limit
    if toa_s <= 0:
        return 0, airtime_per_hour
    return int(airtime_per_hour // toa_s), airtime_per_hour


def free_space_path_loss_db(dist_m, freq_mhz):
    """FSPL(dB) = 20log10(d_km) + 20log10(f_MHz) + 32.44."""
    if dist_m <= 0:
        return 0.0
    return 20 * math.log10(dist_m / 1000.0) + 20 * math.log10(freq_mhz) + 32.44


def link_budget(tx_dbm=30.0, g_tx=2.0, g_rx=3.0, dist_m=1000.0,
                freq_mhz=LORA_FREQ_MHZ, misc_loss_db=3.0,
                sens_dbm=LORA_SENS_DBM):
    """-> (received power dBm, margin dB above receiver sensitivity)."""
    rx = tx_dbm + g_tx + g_rx - free_space_path_loss_db(dist_m, freq_mhz) - misc_loss_db
    return rx, rx - sens_dbm


def max_range_m(tx_dbm=30.0, g_tx=2.0, g_rx=3.0, freq_mhz=LORA_FREQ_MHZ,
                misc_loss_db=3.0, sens_dbm=LORA_SENS_DBM, margin_db=0.0):
    """Range at which the margin falls to `margin_db`, inverting FSPL.

    This is a FREE-SPACE figure and therefore a theoretical upper bound only:
    it models no terrain, no foliage, no ground reflection and no horizon.
    Quote it as a ceiling, never as an expected operational range — compare
    it against radio_horizon_m(), which is usually the binding constraint.
    """
    budget = tx_dbm + g_tx + g_rx - misc_loss_db - sens_dbm - margin_db
    if budget <= 0:
        return 0.0
    return 1000.0 * 10 ** ((budget - 20 * math.log10(freq_mhz) - 32.44) / 20.0)


def radio_horizon_m(h_tx_m, h_rx_m=2.0):
    """Line-of-sight horizon for two antennas, including the 4/3-earth
    refraction allowance:  d_km ~= 4.12 * (sqrt(h_tx) + sqrt(h_rx)), h in m.

    For a CanSat this is normally what actually limits the link, long before
    the free-space power budget runs out.
    """
    h_tx = max(0.0, h_tx_m)
    h_rx = max(0.0, h_rx_m)
    return 4120.0 * (math.sqrt(h_tx) + math.sqrt(h_rx))


def dbm_to_watts(dbm):
    return 10 ** ((dbm - 30.0) / 10.0)


def watts_to_dbm(w):
    return 10 * math.log10(w * 1000.0) if w > 0 else float("-inf")


def wpc_compliance(tx_dbm, antenna_gain_dbi, bw_hz, freq_mhz):
    """Check a configuration against the WPC licence-exempt SRD limits.

    Returns a list of (label, value_text, verdict) where verdict is
    'PASS', 'FAIL' or 'NOTE'. ERP is referenced to a half-wave dipole, so
    ERP(dBm) = Ptx(dBm) + Gain(dBi) - 2.15.
    """
    rows = []
    tx_w = dbm_to_watts(tx_dbm)
    rows.append(("TX POWER", f"{tx_w:.3f} W  ({tx_dbm:.1f} dBm)",
                 "PASS" if tx_w <= WPC_MAX_TX_W + 1e-9 else "FAIL"))

    erp_dbm = tx_dbm + antenna_gain_dbi - 2.15
    erp_w = dbm_to_watts(erp_dbm)
    rows.append(("ERP", f"{erp_w:.3f} W  ({erp_dbm:.1f} dBm)",
                 "PASS" if erp_w <= WPC_MAX_ERP_W + 1e-9 else "FAIL"))

    bw_khz = bw_hz / 1000.0
    rows.append(("CARRIER BW", f"{bw_khz:.1f} kHz",
                 "PASS" if bw_khz <= WPC_MAX_BW_KHZ + 1e-9 else "FAIL"))

    lo = freq_mhz - bw_khz / 2000.0
    hi = freq_mhz + bw_khz / 2000.0
    if lo >= WPC_ETA_LO_MHZ and hi <= WPC_ETA_HI_MHZ:
        band = "PASS"
        txt = f"{lo:.3f} – {hi:.3f} MHz  (ETA sub-band)"
    elif lo >= WPC_BAND_LO_MHZ and hi <= WPC_BAND_HI_MHZ:
        band = "NOTE"
        txt = f"{lo:.3f} – {hi:.3f} MHz  (above 867 MHz ETA sub-band)"
    else:
        band = "FAIL"
        txt = f"{lo:.3f} – {hi:.3f} MHz  (outside 865–868 MHz)"
    rows.append(("OCCUPIED BAND", txt, band))
    return rows


# =========================================================================
# §5b  PRECISE POSITIONING  —  NavIC / GNSS, quality, survey and DGNSS
# =========================================================================
# The flight receiver is a Quectel L89: dual-band, with an integrated patch
# antenna for L1 and a separate chip antenna for IRNSS/NavIC L5, so it can
# track GPS + Galileo + QZSS + NavIC concurrently and apply GAGAN (SBAS)
# corrections.
#
# Accuracy ladder this module implements, worst to best:
#   raw SPS, single frequency      5 - 10 m
#   dual-band L1+L5 (iono removed) 3 -  5 m
#   GAGAN / SBAS corrected         1 -  3 m
#   local differential (DGNSS)     1 -  2 m
#
# The last one is the reason a ground-station receiver is worth having:
# GNSS error is spatially correlated, so two receivers a few km apart see
# almost the same ionospheric, satellite-clock and ephemeris error. Measuring
# that error at a known point and subtracting it from the CanSat's fix
# cancels the common mode. Degradation is only a few mm per km of baseline.
# -------------------------------------------------------------------------
FIX_QUALITY_LABEL = {
    0: "NO FIX", 1: "GNSS SPS", 2: "DGPS / SBAS", 3: "PPS",
    4: "RTK FIXED", 5: "RTK FLOAT", 6: "DEAD RECKONING",
    7: "MANUAL", 8: "SIMULATION",
}

# User Equivalent Range Error, 1 sigma metres, by fix type. Horizontal error
# is then HDOP * UERE — the standard GNSS error-budget relation.
UERE_BY_FIX = {
    0: 30.0,     # no fix: meaningless, kept so the table is total
    1: 5.0,      # single-frequency SPS
    2: 1.5,      # SBAS / GAGAN corrected
    3: 3.0,
    4: 0.02,     # RTK fixed
    5: 0.5,      # RTK float
    6: 15.0,     # dead reckoning
}
UERE_DUAL_BAND = 2.8     # L1+L5 measures ionospheric delay instead of modelling it

GNSS_SYS_BITS = [(1, "GPS"), (2, "GLONASS"), (4, "GALILEO"),
                 (8, "BEIDOU"), (16, "QZSS"), (32, "NAVIC")]

# 1-sigma -> containment-radius scale factors for a 2-D circular normal error
CEP50_FROM_SIGMA = 1.1774      # 50 % circular error probable
R95_FROM_SIGMA   = 2.4477      # 95 % containment


def decode_constellations(mask):
    """Bitmask -> list of constellation names present in the solution."""
    try:
        m = int(mask)
    except (TypeError, ValueError):
        return []
    return [name for bit, name in GNSS_SYS_BITS if m & bit]


def horizontal_sigma_m(hdop, fix_quality=1, dual_band=False):
    """1-sigma horizontal position error = HDOP x UERE.

    Returns None when there is no usable input, so callers render "—" rather
    than a fabricated precision figure.
    """
    if hdop is None or hdop <= 0:
        return None
    try:
        fq = int(fix_quality)
    except (TypeError, ValueError):
        fq = 1
    if fq == 0:
        return None
    uere = UERE_BY_FIX.get(fq, 5.0)
    if dual_band and fq in (1, 3):
        # Dual-frequency removes the ionospheric term from the budget; it does
        # not help once SBAS or RTK is already correcting it.
        uere = min(uere, UERE_DUAL_BAND)
    return hdop * uere


def cep50_m(sigma):
    return None if sigma is None else sigma * CEP50_FROM_SIGMA


def r95_m(sigma):
    return None if sigma is None else sigma * R95_FROM_SIGMA


# ---- coordinate presentation -------------------------------------------
def to_dms(value, is_lat):
    """Decimal degrees -> degrees/minutes/seconds, the format search-and-
    rescue and most handheld GPS units expect."""
    hemi = ("N" if value >= 0 else "S") if is_lat else ("E" if value >= 0 else "W")
    v = abs(value)
    d = int(v)
    m_f = (v - d) * 60.0
    m = int(m_f)
    s = (m_f - m) * 60.0
    return f"{d:d}° {m:02d}' {s:05.2f}\" {hemi}"


def to_dmm(value, is_lat):
    """Degrees + decimal minutes — what aviation and most GNSS receivers show."""
    hemi = ("N" if value >= 0 else "S") if is_lat else ("E" if value >= 0 else "W")
    v = abs(value)
    d = int(v)
    m = (v - d) * 60.0
    return f"{d:d}° {m:06.3f}' {hemi}"


def to_utm(lat, lon):
    """WGS-84 geodetic -> UTM (zone, hemisphere, easting, northing) in metres.

    Standard Karney/USGS series expansion. Metres on a local grid are far
    easier to search on foot than decimal degrees.
    """
    a = 6378137.0
    f = 1 / 298.257223563
    k0 = 0.9996
    e2 = f * (2 - f)
    ep2 = e2 / (1 - e2)

    zone = int((lon + 180) / 6) + 1
    lon0 = math.radians((zone - 1) * 6 - 180 + 3)
    phi = math.radians(lat)
    lam = math.radians(lon)

    N = a / math.sqrt(1 - e2 * math.sin(phi) ** 2)
    T = math.tan(phi) ** 2
    C = ep2 * math.cos(phi) ** 2
    A = math.cos(phi) * (lam - lon0)

    M = a * ((1 - e2 / 4 - 3 * e2 ** 2 / 64 - 5 * e2 ** 3 / 256) * phi
             - (3 * e2 / 8 + 3 * e2 ** 2 / 32 + 45 * e2 ** 3 / 1024) * math.sin(2 * phi)
             + (15 * e2 ** 2 / 256 + 45 * e2 ** 3 / 1024) * math.sin(4 * phi)
             - (35 * e2 ** 3 / 3072) * math.sin(6 * phi))

    easting = k0 * N * (A + (1 - T + C) * A ** 3 / 6
                        + (5 - 18 * T + T ** 2 + 72 * C - 58 * ep2) * A ** 5 / 120) + 500000.0
    northing = k0 * (M + N * math.tan(phi)
                     * (A ** 2 / 2 + (5 - T + 9 * C + 4 * C ** 2) * A ** 4 / 24
                        + (61 - 58 * T + T ** 2 + 600 * C - 330 * ep2) * A ** 6 / 720))
    hemi = "N"
    if lat < 0:
        northing += 10000000.0
        hemi = "S"
    return zone, hemi, easting, northing


def offset_metres(lat_ref, lon_ref, lat, lon):
    """Local tangent-plane offset (east, north) in metres from a reference.

    Used for the DGNSS error vector and for short-range recovery guidance,
    where a flat-earth approximation is exact to well under a millimetre.
    """
    m_per_deg_lat = 111132.92 - 559.82 * math.cos(2 * math.radians(lat_ref))
    m_per_deg_lon = 111412.84 * math.cos(math.radians(lat_ref)) \
        - 93.5 * math.cos(3 * math.radians(lat_ref))
    return ((lon - lon_ref) * m_per_deg_lon, (lat - lat_ref) * m_per_deg_lat)


def apply_offset_metres(lat_ref, lon_ref, d_east, d_north):
    """Inverse of offset_metres: shift a coordinate by a metre offset."""
    m_per_deg_lat = 111132.92 - 559.82 * math.cos(2 * math.radians(lat_ref))
    m_per_deg_lon = 111412.84 * math.cos(math.radians(lat_ref)) \
        - 93.5 * math.cos(3 * math.radians(lat_ref))
    return (lat_ref + d_north / m_per_deg_lat,
            lon_ref + d_east / m_per_deg_lon)


class PositionSurvey:
    """Self-survey: average fixes from a receiver known to be stationary.

    Averaging beats down the RANDOM component as 1/sqrt(N). It does not
    remove the slowly-varying correlated bias (ionosphere, ephemeris), so the
    reported confidence is deliberately floored — claiming centimetres from a
    long average of an uncorrected SPS receiver would be a lie.

    This is the same idea as a u-blox "Survey-In": accumulate until the
    estimated accuracy crosses a threshold, then freeze the reference.
    """

    BIAS_FLOOR_M = 1.2      # correlated error that averaging cannot remove

    def __init__(self, floor_m=None):
        self.reset()
        self.floor = self.BIAS_FLOOR_M if floor_m is None else floor_m

    def reset(self):
        self.n = 0
        self._lat = self._lon = self._alt = 0.0
        self._lat2 = self._lon2 = 0.0
        self.fixed = False
        self.result = None            # (lat, lon, alt, accuracy_m, n)

    def add(self, lat, lon, alt=0.0):
        if lat == 0 and lon == 0:
            return
        self.n += 1
        self._lat += lat
        self._lon += lon
        self._alt += alt
        self._lat2 += lat * lat
        self._lon2 += lon * lon

    @property
    def mean(self):
        if self.n == 0:
            return None
        return (self._lat / self.n, self._lon / self.n, self._alt / self.n)

    def accuracy_m(self):
        """1-sigma accuracy of the averaged position, floored at the bias."""
        if self.n < 2:
            return None
        mlat = self._lat / self.n
        mlon = self._lon / self.n
        var_lat = max(0.0, self._lat2 / self.n - mlat * mlat)
        var_lon = max(0.0, self._lon2 / self.n - mlon * mlon)
        e, nth = offset_metres(mlat, mlon,
                              mlat + math.sqrt(var_lat), mlon + math.sqrt(var_lon))
        sigma_sample = math.hypot(e, nth)
        return max(self.floor, sigma_sample / math.sqrt(self.n))

    def freeze(self):
        """Lock the averaged position in as the survey result."""
        m = self.mean
        if not m:
            return None
        self.result = (m[0], m[1], m[2], self.accuracy_m() or self.floor, self.n)
        self.fixed = True
        return self.result


class LandingPredictor:
    """Projects the touchdown point, and the area the recovery team must search.

    Under a parachute the vehicle has no lateral propulsion, so its horizontal
    ground velocity IS the wind velocity at that altitude. That means the wind
    can be estimated from the vehicle's own drift for free — no anemometer, no
    forecast — and the remaining descent time carries it to a landing estimate.

    Everything returns None when the inputs do not support a real answer,
    because a confident-looking landing pin computed from nothing is worse
    than no pin at all.
    """

    WIND_WINDOW = 12          # fixes averaged for the wind estimate
    MIN_SINK_MS = 0.4         # below this it is not meaningfully descending

    def __init__(self):
        self.reset()

    def reset(self):
        self._hist = deque(maxlen=self.WIND_WINDOW)   # (t, lat, lon)
        self.wind_e = 0.0
        self.wind_n = 0.0
        self.valid = False

    def update(self, t, lat, lon):
        """Feed a GNSS fix taken while the vehicle is descending."""
        if lat == 0 and lon == 0:
            return
        self._hist.append((t, lat, lon))
        if len(self._hist) < 3:
            self.valid = False
            return
        t0, la0, lo0 = self._hist[0]
        t1, la1, lo1 = self._hist[-1]
        dt = t1 - t0
        if dt <= 0:
            self.valid = False
            return
        e, n = offset_metres(la0, lo0, la1, lo1)
        self.wind_e, self.wind_n = e / dt, n / dt
        self.valid = True

    @property
    def wind_speed(self):
        return math.hypot(self.wind_e, self.wind_n)

    @property
    def wind_bearing_to(self):
        """Compass bearing the air mass is carrying the vehicle TOWARD."""
        if not self.valid:
            return None
        return (math.degrees(math.atan2(self.wind_e, self.wind_n)) + 360.0) % 360.0

    @property
    def wind_bearing_from(self):
        """Meteorological convention: where the wind is blowing FROM."""
        b = self.wind_bearing_to
        return None if b is None else (b + 180.0) % 360.0

    def time_to_land(self, alt_agl, sink_rate):
        if alt_agl is None or sink_rate is None or sink_rate < self.MIN_SINK_MS:
            return None
        return max(0.0, alt_agl) / sink_rate

    def project(self, lat, lon, alt_agl, sink_rate):
        """-> (landing_lat, landing_lon, ttl_s, drift_m) or None."""
        ttl = self.time_to_land(alt_agl, sink_rate)
        if ttl is None or not self.valid:
            return None
        d_e = self.wind_e * ttl
        d_n = self.wind_n * ttl
        la, lo = apply_offset_metres(lat, lon, d_e, d_n)
        return la, lo, ttl, math.hypot(d_e, d_n)


_COMPASS_POINTS = ["N", "NNE", "NE", "ENE", "E", "ESE", "SE", "SSE",
                   "S", "SSW", "SW", "WSW", "W", "WNW", "NW", "NNW"]


def _compass_point(bearing):
    """Bearing -> 16-point compass name. A recovery team walking a field
    follows 'NE' far more reliably than '048 degrees'."""
    if bearing is None:
        return "—"
    return _COMPASS_POINTS[int((bearing % 360.0) / 22.5 + 0.5) % 16]


def search_radius_m(sigma_m, time_since_fix_s=0.0, drift_speed_ms=0.0,
                    remaining_drift_m=0.0):
    """How big a circle the recovery team actually has to sweep.

    Three independent contributions, combined in quadrature because they are
    uncorrelated: the fix's own 95 % uncertainty, however far the vehicle
    drifted in the silence after the last packet, and any descent still to
    come. Quadrature rather than a sum avoids a wildly pessimistic radius.
    """
    r_fix = r95_m(sigma_m) if sigma_m else 10.0
    r_silence = max(0.0, time_since_fix_s) * max(0.0, drift_speed_ms)
    r_remaining = max(0.0, remaining_drift_m)
    return math.sqrt(r_fix ** 2 + r_silence ** 2 + r_remaining ** 2)


class DifferentialCorrector:
    """Short-baseline code DGNSS.

    A receiver at a surveyed point measures its own position; the difference
    from truth is the common-mode error. Over a few km the CanSat sees
    essentially the same error, so subtracting it removes most of the budget.

    The correction is only trustworthy while the base observation is fresh —
    the error vector drifts — so it expires. An expired correction is
    reported as unavailable rather than silently applied.
    """

    MAX_AGE_S = 30.0
    MAX_BASELINE_M = 50000.0     # beyond this the common-mode assumption fails

    def __init__(self):
        self.truth = None            # (lat, lon, alt) surveyed base position
        self.observed = None         # (lat, lon, alt) live base measurement
        self.obs_time = None
        self.d_east = 0.0
        self.d_north = 0.0
        self.enabled = True

    def set_truth(self, lat, lon, alt=0.0):
        self.truth = (lat, lon, alt)

    def update_base(self, lat, lon, alt=0.0, now=None):
        """Feed a live measurement from the ground-station receiver."""
        self.observed = (lat, lon, alt)
        self.obs_time = now or time.time()
        if self.truth:
            self.d_east, self.d_north = offset_metres(
                self.truth[0], self.truth[1], lat, lon)

    def age(self, now=None):
        if self.obs_time is None:
            return None
        return (now or time.time()) - self.obs_time

    def available(self, now=None):
        if not (self.enabled and self.truth and self.observed):
            return False
        a = self.age(now)
        return a is not None and a <= self.MAX_AGE_S

    def error_magnitude_m(self):
        return math.hypot(self.d_east, self.d_north)

    def correct(self, lat, lon, now=None):
        """-> (corrected_lat, corrected_lon, applied)."""
        if not self.available(now):
            return lat, lon, False
        if lat == 0 and lon == 0:
            return lat, lon, False
        if self.truth:
            e, n = offset_metres(self.truth[0], self.truth[1], lat, lon)
            if math.hypot(e, n) > self.MAX_BASELINE_M:
                return lat, lon, False
        clat, clon = apply_offset_metres(lat, lon, -self.d_east, -self.d_north)
        return clat, clon, True


def parse_nmea_sentence(line, state=None):
    """Minimal NMEA 0183 reader for a ground-station receiver.

    Handles GGA (position, fix quality, satellites, HDOP, geoid separation)
    and GSA (DOP set), across all talker IDs so a multi-constellation
    receiver's GN/GP/GI sentences are all accepted. Returns an updated state
    dict, or None if the sentence is not one we use or fails checksum.
    """
    st = dict(state) if state else {}
    if not line or not line.startswith("$"):
        return None
    body = line[1:]
    if "*" in body:
        body, _, csum = body.partition("*")
        try:
            want = int(csum[:2], 16)
        except ValueError:
            return None
        got = 0
        for ch in body:
            got ^= ord(ch)
        if got != want:
            return None                      # corrupt sentence, drop it
    parts = body.split(",")
    if not parts:
        return None
    talker_type = parts[0][2:] if len(parts[0]) >= 5 else parts[0]

    def _coord(val, hemi):
        if not val or not hemi:
            return None
        try:
            v = float(val)
        except ValueError:
            return None
        deg = int(v // 100)
        minutes = v - deg * 100
        dec = deg + minutes / 60.0
        return -dec if hemi in ("S", "W") else dec

    if talker_type == "GGA" and len(parts) >= 15:
        lat = _coord(parts[2], parts[3])
        lon = _coord(parts[4], parts[5])
        if lat is None or lon is None:
            return None
        st["lat"] = lat
        st["lon"] = lon
        st["fix_quality"] = int(parts[6]) if parts[6].isdigit() else 0
        st["sats"] = int(parts[7]) if parts[7].isdigit() else 0
        st["hdop"] = _finite(parts[8], None)
        st["alt"] = _finite(parts[9], None)
        st["geoid"] = _finite(parts[11], None)
        st["t"] = time.time()
        return st
    if talker_type == "GSA" and len(parts) >= 18:
        st["pdop"] = _finite(parts[15], None)
        st["hdop"] = _finite(parts[16], None) or st.get("hdop")
        st["vdop"] = _finite(parts[17].split("*")[0], None)
        return st
    return None


class GsGnssLink(threading.Thread):
    """Reads NMEA from a GNSS receiver attached to the ground station.

    Entirely optional. Its only job is to observe the base position so the
    DifferentialCorrector can measure the common-mode error; when it is not
    running everything else degrades to uncorrected positions and says so.
    """

    def __init__(self, port, baud, on_fix, status_cb=None):
        super().__init__(daemon=True, name="GsGnssLink")
        self.port, self.baud = port, baud
        self.on_fix = on_fix
        self.status_cb = status_cb or (lambda s: None)
        self._stop_evt = threading.Event()
        self._ser = None
        self._buf = bytearray()
        self.state = {}

    def stop(self):
        self._stop_evt.set()
        try:
            if self._ser:
                self._ser.close()
        except Exception:
            pass

    def run(self):
        backoff = 0
        while not self._stop_evt.is_set():
            if not HAVE_SERIAL:
                self.status_cb("NO_SERIAL")
                return
            try:
                self._ser = serial.Serial(self.port, self.baud, timeout=0.4)
                self.status_cb("LIVE")
                backoff = 0
            except Exception as e:
                log.warning("GS GNSS open failed: %s", e)
                self.status_cb("RECONNECT")
                self._stop_evt.wait(RECONNECT_BACKOFF[min(backoff, 3)])
                backoff += 1
                continue
            try:
                while not self._stop_evt.is_set():
                    try:
                        chunk = self._ser.read(256)
                    except Exception:
                        break
                    if not chunk:
                        continue
                    self._buf.extend(chunk)
                    if len(self._buf) > 32768:
                        del self._buf[:16384]
                    while b"\n" in self._buf:
                        i = self._buf.index(b"\n")
                        line = bytes(self._buf[:i]).decode("ascii", "ignore").strip()
                        del self._buf[:i + 1]
                        upd = parse_nmea_sentence(line, self.state)
                        if upd:
                            self.state = upd
                            if "lat" in upd and upd.get("fix_quality", 0) > 0:
                                try:
                                    self.on_fix(dict(upd))
                                except Exception:
                                    log.exception("GS GNSS callback failed")
            finally:
                try:
                    if self._ser:
                        self._ser.close()
                except Exception:
                    pass
                self._ser = None
                self.status_cb("RECONNECT")


# =========================================================================
# §6  PHYSICS  —  derived engineering parameters
# =========================================================================
class Physics:
    """Every derived parameter, from real formulas. compute() never raises.

    Each result is gated on its inputs: a value only enters
    `derived_present` if every field it was computed from was itself
    received. Without this the GCS would happily display a confident-looking
    ROLL or DENS_ALT synthesised from sensors that are not connected.
    """

    def __init__(self):
        self.reset()

    def reset(self):
        self.t_last = None
        self.alt_last = None
        self.apogee_m = 0.0
        self.takeoff_alt = None
        self.peak_speed = 0.0
        self.peak_g_hi = 0.0
        self.energy_wh = 0.0
        # ---- pad origin -------------------------------------------------
        # lat0/lon0 are the (0, 0) of every range and bearing the GCS shows.
        # They used to be assigned from the very FIRST fix that arrived, which
        # is the worst possible choice on two counts:
        #
        #   1. A cold-start fix is the least accurate one the receiver will
        #      ever produce. The solution is still converging, HDOP is high and
        #      the position can be tens of metres out. Every range for the rest
        #      of the flight was then measured from that error.
        #   2. If the first fix only arrived AFTER launch — indoors on the pad,
        #      under a fairing, or simply a slow lock — the "pad" was silently
        #      placed wherever the vehicle happened to be when it got lock,
        #      which could be hundreds of metres downrange and up.
        #
        # Instead the origin is SURVEYED: while the vehicle reports STATE=BOOT
        # (still on the pad) every fix is folded into a running mean, so the
        # origin keeps improving as the solution settles. It freezes the moment
        # the vehicle leaves BOOT, which is the last instant it is still
        # physically on the pad. PAD_SURVEY_MAX caps the average so a long
        # pre-flight hold cannot make the origin unresponsive to a genuine
        # receiver correction.
        self.lat0 = None
        self.lon0 = None
        self.pad_alt0 = None          # baro AGL at the pad, for AGL_M
        self._pad_n = 0               # fixes folded into the survey so far
        self._pad_frozen = False      # True once the vehicle has left BOOT
        self.lightning_log = []

    # ---- atmosphere -----------------------------------------------------
    @staticmethod
    def isa_density(p_pa, t_c):
        t_k = t_c + 273.15
        return p_pa / (R_AIR * t_k) if t_k > 1 else 0.0

    @staticmethod
    def isa_pressure_alt(p_pa):
        if p_pa <= 0:
            return 0.0
        return (SEA_LEVEL_T_K / TROPO_LAPSE_K_M) * (
            1.0 - (p_pa / SEA_LEVEL_P_PA) ** (R_AIR * TROPO_LAPSE_K_M / G_EARTH))

    @staticmethod
    def density_alt(p_pa, t_c):
        rho = Physics.isa_density(p_pa, t_c)
        if rho <= 0:
            return 0.0
        rho0 = SEA_LEVEL_P_PA / (R_AIR * SEA_LEVEL_T_K)
        return (SEA_LEVEL_T_K / TROPO_LAPSE_K_M) * (
            1.0 - (rho / rho0) ** (1.0 / (G_EARTH / (R_AIR * TROPO_LAPSE_K_M) - 1.0)))

    @staticmethod
    def dew_point(t_c, rh):
        """Magnus approximation."""
        if rh <= 0:
            return 0.0
        a, b = 17.62, 243.12
        g = math.log(max(rh, 1e-3) / 100.0) + (a * t_c) / (b + t_c)
        return (b * g) / (a - g)

    @staticmethod
    def cloud_base_agl(t_c, td_c):
        """Espy's equation."""
        return max(0.0, 125.0 * (t_c - td_c))

    # ---- navigation -----------------------------------------------------
    @staticmethod
    def hav_dist(lat1, lon1, lat2, lon2):
        r = 6371000.0
        p1, p2 = math.radians(lat1), math.radians(lat2)
        dp = math.radians(lat2 - lat1)
        dl = math.radians(lon2 - lon1)
        a = math.sin(dp / 2) ** 2 + math.cos(p1) * math.cos(p2) * math.sin(dl / 2) ** 2
        return 2 * r * math.asin(min(1.0, math.sqrt(a)))

    @staticmethod
    def bearing(lat1, lon1, lat2, lon2):
        p1, p2 = math.radians(lat1), math.radians(lat2)
        dl = math.radians(lon2 - lon1)
        y = math.sin(dl) * math.cos(p2)
        x = math.cos(p1) * math.sin(p2) - math.sin(p1) * math.cos(p2) * math.cos(dl)
        return (math.degrees(math.atan2(y, x)) + 360.0) % 360.0

    @staticmethod
    def aqi_from_pm25(pm):
        """US EPA breakpoint interpolation."""
        bp = [(0, 12, 0, 50), (12.1, 35.4, 51, 100), (35.5, 55.4, 101, 150),
              (55.5, 150.4, 151, 200), (150.5, 250.4, 201, 300),
              (250.5, 500.4, 301, 500)]
        for lo, hi, ilo, ihi in bp:
            if lo <= pm <= hi:
                return ilo + (ihi - ilo) * (pm - lo) / (hi - lo)
        return 500.0 if pm > 500.4 else 0.0

    # ---- main -----------------------------------------------------------
    def compute(self, d: dict, packet_count: int = 0, present=None):
        present = present if present is not None else set(ALL_FIELDS)
        r, dp = {}, set()

        def have(*keys):
            return all(k in present for k in keys)

        try:
            t_s  = _finite(d.get("TIME_S"))
            alt  = _finite(d.get("ALT_M"))
            pres = _finite(d.get("PRES_PA"))
            temp = _finite(d.get("TEMP_C"))
            hum  = _finite(d.get("HUM_PCT"))

            # 1. Extract Raw Variables
            # ONE accelerometer source: the mandated ACC_X/Y/Z in m/s^2,
            # converted to g here and published back as AX/AY/AZ for display.
            # There used to be an `else` branch reading AX/AY/AZ directly, which
            # could never execute — the gateway synthesised AX from ACC_X, so
            # AX was present exactly when ACC_X was and absent exactly when it
            # was not. A fallback that cannot fire hides, rather than handles,
            # the case it claims to cover.
            ax_raw = _finite(d.get("ACC_X")) / G_EARTH
            ay_raw = _finite(d.get("ACC_Y")) / G_EARTH
            az_raw = _finite(d.get("ACC_Z")) / G_EARTH
            accel_ok = have("ACC_X", "ACC_Y", "ACC_Z")

            spin_r = _finite(d.get("SPIN_RATE"))
            gx_raw, gy_raw = _finite(d.get("GX")), _finite(d.get("GY"))
            gz_raw = _finite(d.get("GZ")) or spin_r
            mx_raw, my_raw, mz_raw = (_finite(d.get("MX")), _finite(d.get("MY")),
                                      _finite(d.get("MZ")))

            ax, ay, az = ax_raw, ay_raw, az_raw
            gx, gy, gz = gx_raw, gy_raw, gz_raw
            mx, my, mz = mx_raw, my_raw, mz_raw

            # Publish the g-unit view the INERTIAL panel reads. Derived, not
            # received: the wire carries ACC_X/Y/Z once, in the mandated unit.
            r["AX"], r["AY"], r["AZ"] = ax, ay, az
            if accel_ok:
                dp.update(["AX", "AY", "AZ"])

            mag_ok = have("MX", "MY", "MZ")
            bus_v, bus_i = _finite(d.get("BUS_V")), _finite(d.get("BUS_I_MA"))

            # ---- vertical speed --------------------------------------
            if (self.t_last is not None and t_s > self.t_last
                    and have("ALT_M", "TIME_S")):
                dt = t_s - self.t_last
                vsp = (alt - self.alt_last) / dt if self.alt_last is not None else 0.0
                vsp_ok = True
            else:
                dt, vsp, vsp_ok = 0.0, 0.0, False
            r["VSPEED"], r["DESCENT"] = vsp, (-vsp if vsp < 0 else 0.0)
            if vsp_ok:
                dp.update(["VSPEED", "DESCENT"])

            # ---- ABSOLUTE EULER MATH FIX -----------------------------
            # Bypasses the flight computer's cross-coupled filter.
            # Physical Board: X=Right, Y=Forward, Z=Up
            roll = math.degrees(math.atan2(-ax, az))
            pitch = math.degrees(math.atan2(ay, math.sqrt(ax * ax + az * az)))
            
            r["ROLL"], r["PITCH"] = roll, pitch
            a_mag = math.sqrt(ax * ax + ay * ay + az * az) or 1.0
            r["TILT"] = math.degrees(math.acos(max(-1.0, min(1.0, az / a_mag))))
            
            if accel_ok:
                dp.update(["ROLL", "PITCH", "TILT"])

            # ---- tilt-compensated heading ----------------------------
            # Map physical (Right, Forward, Up) to NED (Forward, Right, Down)
            mx_ned, my_ned, mz_ned = my, mx, -mz
            cr, sr = math.cos(math.radians(roll)), math.sin(math.radians(roll))
            cp, sp = math.cos(math.radians(pitch)), math.sin(math.radians(pitch))
            
            mxh = mx_ned * cp + mz_ned * sp
            myh = mx_ned * sr * sp + my_ned * cr - mz_ned * sr * cp
            hdg = (math.degrees(math.atan2(-myh, mxh)) + 360.0) % 360.0
            r["HEADING"] = hdg
            r["YAW"] = hdg
            
            if mag_ok and accel_ok:
                dp.update(["HEADING", "YAW"])

            # ---- spin / stability -------------------------------------
            spin_rate = spin_r if "SPIN_RATE" in present else gz
            spin_ok = ("SPIN_RATE" in present) or ("GZ" in present)
            omega_t = math.sqrt(gx * gx + gy * gy)
            instab = min(1.0, omega_t / 90.0)
            r["OMEGA_T"], r["SPIN_DPS"] = omega_t, spin_rate
            r["INSTAB"], r["STABLE"] = instab, 1.0 - instab
            r["H_BODY"] = I_T * math.radians(omega_t) * 1000.0
            r["NUTATION"] = math.degrees(
                abs(I_Z - I_T) / I_T * math.radians(abs(spin_rate)))
            r["CONING"] = omega_t
            if have("GX", "GY"):
                dp.update(["OMEGA_T", "INSTAB", "STABLE", "H_BODY", "CONING"])
            if spin_ok:
                dp.update(["SPIN_DPS", "NUTATION"])

            # ---- atmosphere ------------------------------------------
            rho = self.isa_density(pres, temp)
            r["AIR_RHO"] = rho
            r["P_ALT"] = self.isa_pressure_alt(pres)
            r["DENS_ALT"] = self.density_alt(pres, temp)
            r["DEW_POINT"] = self.dew_point(temp, hum)
            r["CLOUD_BASE"] = self.cloud_base_agl(temp, r["DEW_POINT"])
            if have("PRES_PA", "TEMP_C"):
                dp.update(["AIR_RHO", "P_ALT", "DENS_ALT"])
            if have("TEMP_C", "HUM_PCT"):
                dp.update(["DEW_POINT", "CLOUD_BASE"])

            # ---- speed / aerodynamics --------------------------------
            gnd = _finite(d.get("GND_SPEED"))
            v3d = math.sqrt(gnd * gnd + vsp * vsp)
            r["SPEED_3D"] = v3d
            self.peak_speed = max(self.peak_speed, v3d)
            r["PEAK_V"] = self.peak_speed
            speed_ok = ("GND_SPEED" in present) or vsp_ok
            if speed_ok:
                dp.update(["SPEED_3D", "PEAK_V"])

            sos = (math.sqrt(GAMMA_AIR * R_AIR * (temp + 273.15))
                   if temp > -273 else 340.0)
            r["DYN_Q"] = 0.5 * rho * v3d * v3d
            r["MACH"] = v3d / sos if sos > 0 else 0.0
            r["REYNOLDS"] = (rho * v3d * CANSAT_LEN_M) / MU_AIR_REF
            r["SOS"] = sos
            if speed_ok and have("PRES_PA", "TEMP_C"):
                dp.update(["DYN_Q", "MACH", "REYNOLDS", "SOS"])

            sink = max(0.0, -vsp)
            r["SINK_RATE"] = sink
            r["GLIDE_LD"] = (gnd / sink) if sink > 0.1 else 0.0
            r["GLIDE_SLOPE"] = (-math.degrees(math.atan2(sink, max(gnd, 0.01)))
                                if sink > 0.1 else 0.0)
            if vsp_ok:
                dp.add("SINK_RATE")
                if "GND_SPEED" in present:
                    dp.update(["GLIDE_LD", "GLIDE_SLOPE"])

            # ---- power ------------------------------------------------
            srv_v, srv_i = _finite(d.get("SERVO_V")), _finite(d.get("SERVO_I_MA"))
            p_bus, p_srv = bus_v * bus_i / 1000.0, srv_v * srv_i / 1000.0
            r["P_BUS"], r["P_SERVO"], r["P_TOTAL"] = p_bus, p_srv, p_bus + p_srv
            if 0 < dt < 5.0 and have("BUS_V", "BUS_I_MA"):
                self.energy_wh += (p_bus + p_srv) * dt / 3600.0
            r["ENERGY_WH"] = self.energy_wh
            if have("BUS_V", "BUS_I_MA"):
                dp.add("P_BUS")
            if have("SERVO_V", "SERVO_I_MA"):
                dp.add("P_SERVO")
            if have("BUS_V", "BUS_I_MA", "SERVO_V", "SERVO_I_MA"):
                dp.update(["P_TOTAL", "ENERGY_WH"])

            # ---- link -------------------------------------------------
            rssi = _finite(d.get("RSSI"))
            r["LINK_MARGIN"] = (rssi - LORA_SENS_DBM) if rssi < 0 else 0.0
            if "RSSI" in present:
                dp.add("LINK_MARGIN")

            # ---- high-g -----------------------------------------------
            ahx, ahy, ahz = (_finite(d.get("AHX")), _finite(d.get("AHY")),
                             _finite(d.get("AHZ")))
            g_hi = math.sqrt(ahx * ahx + ahy * ahy + ahz * ahz)
            if have("AHX", "AHY", "AHZ"):
                self.peak_g_hi = max(self.peak_g_hi, g_hi)
                dp.update(["G_HI", "G_HI_PK"])
            r["G_HI"], r["G_HI_PK"] = g_hi, self.peak_g_hi

            # ---- air quality / spectral -------------------------------
            r["AQI_PM"] = self.aqi_from_pm25(_finite(d.get("PM25")))
            if "PM25" in present:
                dp.add("AQI_PM")
            spec = [k for k in ALL_FIELDS if k.startswith("S_") and k != "S_FLK"]
            r["IRR_TOT"] = sum(_finite(d.get(k)) for k in spec)
            if any(k in present for k in spec):
                dp.add("IRR_TOT")

            # ---- navigation -------------------------------------------
            lat, lon = _finite(d.get("LAT")), _finite(d.get("LON"))
            gnss_ok = have("LAT", "LON")

            # ---- pad origin survey (see __init__ for why) ----------------
            # STATE is in every packet, so "still on the pad" is a fact the
            # vehicle reports rather than something the GCS has to infer.
            on_pad = ("STATE" in present and
                      int(_finite(d.get("STATE"), -1)) == STATE_NUM["BOOT"])
            if not on_pad and "STATE" in present:
                self._pad_frozen = True     # left BOOT — the origin is final

            if gnss_ok and (lat or lon):
                if self.lat0 is None:
                    self.lat0, self.lon0, self._pad_n = lat, lon, 1
                elif not self._pad_frozen and self._pad_n < PAD_SURVEY_MAX:
                    # Running mean. Each new fix carries 1/n weight, so the
                    # origin converges on the true pad position instead of
                    # inheriting the error of whichever fix happened to be
                    # first. Cheap, and needs no history buffer.
                    self._pad_n += 1
                    k = 1.0 / self._pad_n
                    self.lat0 += (lat - self.lat0) * k
                    self.lon0 += (lon - self.lon0) * k

            if self.lat0 is not None and gnss_ok and (lat or lon):
                r["DIST_M"] = self.hav_dist(self.lat0, self.lon0, lat, lon)
                r["BEARING"] = self.bearing(self.lat0, self.lon0, lat, lon)
                dp.update(["DIST_M", "BEARING"])
            else:
                r["DIST_M"] = r["BEARING"] = 0.0

            r["BARO_GPS_DALT"] = abs(alt - _finite(d.get("GPS_ALT_M")))
            if have("ALT_M", "GPS_ALT_M"):
                dp.add("BARO_GPS_DALT")

            # ---- apogee / AGL -----------------------------------------
            # takeoff_alt is the vertical half of the pad origin: the ALT_M the
            # vehicle reports while it is still sitting on the pad.
            #
            # It used to latch at "the first sample where alt > 5", which is a
            # sample taken DURING ASCENT, not on the pad. Every AGL_M after
            # that was then short by whatever altitude the vehicle had already
            # reached when the first packet above 5 m happened to arrive — and
            # on the ground the display read that value negative. The bug was
            # masked while the flight computer's own ALT_M was unreferenced;
            # now that ALT_M is a true AGL against a surveyed pad pressure, it
            # would have shown up directly as a wrong apogee.
            #
            # Anchoring on STATE=BOOT instead means the reference is taken from
            # the one period the vehicle is definitely stationary on the pad,
            # where ALT_M should already read ~0 after CMD_CALIBRATE. AGL_M
            # then tracks ALT_M as it should, and any small residual pad offset
            # is removed rather than propagated.
            if "ALT_M" in present:
                self.apogee_m = max(self.apogee_m, alt)
                if on_pad or self.takeoff_alt is None:
                    self.takeoff_alt = alt
                dp.update(["APOGEE_M", "AGL_M"])
            r["APOGEE_M"] = self.apogee_m
            r["AGL_M"] = alt - (self.takeoff_alt or 0.0)

            r["TTL_S"] = (max(alt, 0.0) / sink) if sink > 0.1 else 0.0
            if vsp_ok and "ALT_M" in present:
                dp.add("TTL_S")

            if "LGT_FLAG" in present and _finite(d.get("LGT_FLAG")) > 0:
                self.lightning_log.append(
                    {"t": t_s, "dist_km": _finite(d.get("LGT_DIST")),
                     "intensity": _finite(d.get("LGT_INT"))})

            # ---- storage estimate --------------------------------------
            est = packet_count * BYTES_PER_PACKET
            if "SD_PCT" not in present:
                r["SD_PCT"] = min(100.0, 100.0 * est / SD_CAP_BYTES)
            if "FLASH_PCT" not in present:
                r["FLASH_PCT"] = min(100.0, 100.0 * est / FLASH_CAP_BYTES)

            self.t_last, self.alt_last = t_s, alt
        except Exception:
            log.exception("Physics.compute non-fatal")

        for k, v in list(r.items()):
            if isinstance(v, float) and not math.isfinite(v):
                r[k] = 0.0
        return r, dp


# =========================================================================
# §7  LOGGERS  —  the graded artifacts
# =========================================================================
class Logger:
    """Writes the competition CSV live, plus XML and KML exports.

    The CSV is opened and flushed on every packet: if the laptop dies
    mid-flight the file on disk is still complete up to the last packet.
    """

    def __init__(self, out_dir: Path):
        self.dir = Path(out_dir)
        self.dir.mkdir(parents=True, exist_ok=True)
        self.csv_path = self.dir / CSV_FILENAME
        self._fh = None
        self._w = None
        self.rows = 0
        self.track = []          # (lat, lon, alt, state) for KML
        self._open()

    def _open(self):
        try:
            new = not self.csv_path.exists() or self.csv_path.stat().st_size == 0
            self._fh = open(self.csv_path, "a", newline="", encoding="utf-8")
            self._w = csv.writer(self._fh)
            if new:
                self._w.writerow(["TEAM_ID"] + ALL_FIELDS)
                self._fh.flush()
        except Exception:
            log.exception("CSV open failed")
            self._fh, self._w = None, None

    def write(self, d: dict, present=None):
        if not self._w:
            return
        try:
            row = [TEAM_ID]
            for k in ALL_FIELDS:
                if present is not None and k not in present:
                    row.append("")
                    continue
                v = d.get(k, 0.0)
                if k == "UTC":
                    row.append(str(v) if v else "")
                else:
                    row.append(csv_cell(k, v))
            self._w.writerow(row)
            self._fh.flush()
            self.rows += 1
            if present and {"LAT", "LON"} <= set(present):
                la, lo = _finite(d.get("LAT")), _finite(d.get("LON"))
                if la or lo:
                    self.track.append((la, lo, _finite(d.get("ALT_M")),
                                       int(_finite(d.get("STATE")))))
        except Exception:
            log.exception("CSV write failed")

    def export_xml(self) -> Path:
        p = self.dir / XML_FILENAME
        try:
            import xml.etree.ElementTree as ET
            root = ET.Element("FlightData", team=TEAM_ID, version=APP_VERSION,
                              rows=str(self.rows))
            sch = ET.SubElement(root, "Schema", fields=str(N_FIELDS))
            for k, m in SCHEMA.items():
                ET.SubElement(sch, "Field", name=k, unit=m["u"],
                              group=m["g"]).text = m["d"]
            if self.csv_path.exists():
                with open(self.csv_path, encoding="utf-8") as fh:
                    rd = csv.DictReader(fh)
                    data = ET.SubElement(root, "Telemetry")
                    for row in rd:
                        rec = ET.SubElement(data, "Packet")
                        for k, v in row.items():
                            if v not in ("", None):
                                rec.set(k.replace("/", "_"), str(v))
            ET.ElementTree(root).write(p, encoding="utf-8", xml_declaration=True)
        except Exception:
            log.exception("XML export failed")
        return p

    def export_kml(self) -> Path:
        """WGS-84 track for Google Earth. Deliberately a file, not a live tile
        service: nothing in the field flow may depend on an internet link."""
        p = self.dir / KML_FILENAME
        try:
            coords = "\n".join(f"{lo:.7f},{la:.7f},{al:.1f}"
                               for la, lo, al, _ in self.track)
            head = (self.track[0] if self.track else (0, 0, 0, 0))
            tail = (self.track[-1] if self.track else (0, 0, 0, 0))
            kml = f"""<?xml version="1.0" encoding="UTF-8"?>
<kml xmlns="http://www.opengis.net/kml/2.2"><Document>
<name>{TEAM_ID} flight track</name>
<Style id="t"><LineStyle><color>ff00ccff</color><width>3</width></LineStyle></Style>
<Placemark><name>Flight path</name><styleUrl>#t</styleUrl>
<LineString><altitudeMode>absolute</altitudeMode><coordinates>
{coords}
</coordinates></LineString></Placemark>
<Placemark><name>LAUNCH</name><Point><coordinates>{head[1]:.7f},{head[0]:.7f},{head[2]:.1f}</coordinates></Point></Placemark>
<Placemark><name>LAST FIX</name><Point><coordinates>{tail[1]:.7f},{tail[0]:.7f},{tail[2]:.1f}</coordinates></Point></Placemark>
</Document></kml>"""
            p.write_text(kml, encoding="utf-8")
        except Exception:
            log.exception("KML export failed")
        return p

    def close(self):
        try:
            if self._fh:
                self._fh.flush()
                self._fh.close()
        except Exception:
            pass
        self._fh = self._w = None


# =========================================================================
# §8  LINK LAYER  —  serial reader and flight simulator
# =========================================================================
class SerialLink(threading.Thread):
    """Reads newline-framed telemetry with auto-reconnect.

    Runs entirely off the UI thread and communicates only through a queue,
    so a hung port or an unplugged adaptor can never freeze the display.
    """

    def __init__(self, port, baud, q, status_cb=None, tx_q=None):
        super().__init__(daemon=True, name="SerialLink")
        self.port, self.baud = port, baud
        self.q, self.tx_q = q, tx_q
        self.status_cb = status_cb or (lambda s: None)
        self._stop_evt = threading.Event()
        self._ser = None
        self._buf = bytearray()

    def stop(self):
        self._stop_evt.set()
        try:
            if self._ser:
                self._ser.close()
        except Exception:
            pass

    def _open(self):
        if not HAVE_SERIAL:
            self.status_cb("NO_SERIAL")
            return False
        if self.port == "VIRTUAL_TEST":
            return True
        if not self.port or self.port.startswith("(") or "Disconnected" in self.port:
            self.status_cb("PORT_BUSY")
            return False
        try:
            self._ser = serial.Serial(self.port, self.baud, timeout=0.1, write_timeout=0.2)
            self.status_cb("CONNECTED")
            log.info("serial open %s @ %d", self.port, self.baud)
            return True
        except Exception as e:
            err_str = str(e)
            if "semaphore timeout" in err_str.lower():
                log.warning("serial port %s timed out (Bluetooth or unready hardware)", self.port)
            else:
                log.warning("serial open failed on %s: %s", self.port, err_str)
            self.status_cb("PORT_BUSY")
            return False

    def _drain_tx(self):
        """Non-blocking drain: write timeouts ensure queue reading isn't stalled."""
        if not self.tx_q:
            return
        try:
            while True:
                cmd = self.tx_q.get_nowait()
                if self._ser:
                    try:
                        self._ser.write((cmd + "\r\n").encode("utf-8"))
                    except Exception:
                        log.exception("serial tx failed")
        except queue.Empty:
            pass

    def _run_virtual_gateway(self):
        """Virtual Gateway Feed: Emulates physical ESP32 LoRa Gateway (vritra_gs.ino).
        
        Provides complete wire-format verification and telecommand loopback testing
        even when no physical USB transceiver is attached to the workstation.
        """
        self.status_cb("CONNECTED")
        log.info("Virtual Gateway Feed running (Loopback Verification active)")
        
        # Gateway boot banner per vritra_gs.ino
        self.q.put(f"// [VRITRA-GS] {TEAM_ID}  gateway 6.2.0")
        self.q.put("// [WIRE] base-36, schema sum 0x3d410b42")
        self.q.put("// [RX] listening")
        self.q.put("// [RX] CanSat boots SILENT per guideline 6.1.v — send CMD_TX_ON to start telemetry")
        
        tx_enabled = True
        pkt = 1
        t0 = time.time()
        ul_seq = 0
        rng = np.random.default_rng(42)
        
        while not self._stop_evt.is_set():
            t_now = time.time()
            dt = t_now - t0
            
            # Drain and acknowledge uplink telecommands
            if self.tx_q:
                try:
                    while True:
                        cmd_line = self.tx_q.get_nowait()
                        cmd = cmd_line.strip()
                        ul_seq += 1
                        body = cmd[4:] if cmd.startswith("CMD_") else cmd
                        self.q.put(f"// [UP] queued {body} seq={ul_seq} (x6)")
                        self.q.put(f"// [UP] tx cmd={body} seq={ul_seq} left=0 OK")
                        
                        if "TX_OFF" in body:
                            tx_enabled = False
                            self.q.put("// [RX] telemetry paused (silent mode)")
                        elif "TX_ON" in body:
                            tx_enabled = True
                            self.q.put("// [RX] telemetry active @ 1 Hz")
                        elif "CALIBRATE" in body or "CAL_PRESS" in body:
                            self.q.put("// [RX] [ACK] Barometer sea-level calibration complete")
                        elif "BEACON_ON" in body:
                            self.q.put("// [RX] [ACK] Recovery audio beacon ACTIVE")
                        elif "BEACON_OFF" in body:
                            self.q.put("// [RX] [ACK] Recovery audio beacon OFF")
                        elif "FAILOVER" in body:
                            self.q.put(f"// [UP] following CanSat to {LORA_FREQ_BACKUP_MHZ:.2f} MHz")
                except queue.Empty:
                    pass

            if tx_enabled:
                # Realistic 1 Hz telemetry packet across all 83 fields
                alt = max(0.0, 750.0 - (dt * 4.8) if dt < 156 else 0.0)
                st = 0 if dt < 5 else (1 if dt < 30 else (2 if dt < 80 else (3 if dt < 150 else 4)))
                pres = SEA_LEVEL_P_PA * (1 - 2.25577e-5 * alt) ** 5.25588
                temp = 24.5 - 0.0065 * alt + float(rng.normal(0, 0.1))
                bus_v = max(9.8, 12.4 - dt * 0.005 + float(rng.normal(0, 0.02)))
                lat = SIM_SITE_LAT + (dt * 0.000015)
                lon = SIM_SITE_LON + (dt * 0.000022)
                
                d = OrderedDict((k, 0.0) for k in ALL_FIELDS)
                present = set(ALL_FIELDS)
                
                d["TIME_S"] = round(dt, 1)
                d["PKT"] = pkt
                d["ALT_M"] = round(alt + float(rng.normal(0, 0.3)), 2)
                d["PRES_PA"] = round(pres + float(rng.normal(0, 8.0)), 1)
                d["TEMP_C"] = round(temp, 2)
                d["BUS_V"] = round(bus_v, 3)
                d["GNSS_TIME"] = round(dt, 1)
                d["LAT"] = round(lat, 7)
                d["LON"] = round(lon, 7)
                d["GPS_ALT_M"] = round(alt + 4.1, 2)
                d["SATS"] = int(np.clip(12 + rng.normal(0, 1), 6, 16))
                
                d["ACC_X"] = round(float(rng.normal(0, 0.05)), 3)
                d["ACC_Y"] = round(float(rng.normal(0, 0.05)), 3)
                d["ACC_Z"] = round(G_EARTH + float(rng.normal(0, 0.05)), 3)
                d["SPIN_RATE"] = round(float(rng.normal(12.0, 1.5)) if st in (2, 3) else 0.0, 2)
                d["STATE"] = st
                
                d["BUS_I_MA"] = round(380.0 + float(rng.normal(0, 15.0)), 1)
                d["SOC_PCT"] = round(max(0.0, 98.0 - dt * 0.05), 1)
                d["GND_SPEED"] = round(float(rng.normal(4.2, 0.8)) if st in (2, 3) else 0.0, 2)
                d["HUM_PCT"] = round(np.clip(52.0 + rng.normal(0, 1.5), 0, 100), 1)
                
                d["GX"] = round(float(rng.normal(0, 2.0)), 2)
                d["GY"] = round(float(rng.normal(0, 2.0)), 2)
                d["GZ"] = round(d["SPIN_RATE"], 2)
                
                hdg = (dt * 15.0) % 360.0
                hdg_rad = math.radians(hdg)
                d["MX"] = round(24.0 * math.cos(hdg_rad), 2)
                d["MY"] = round(24.0 * math.sin(hdg_rad), 2)
                d["MZ"] = 38.0
                d["AHX"] = round(d["ACC_X"] / G_EARTH, 3)
                d["AHY"] = round(d["ACC_Y"] / G_EARTH, 3)
                d["AHZ"] = round(d["ACC_Z"] / G_EARTH, 3)
                d["ATT_ROLL"] = round(float(rng.normal(0, 2.0)), 2)
                d["ATT_PITCH"] = round(float(rng.normal(0, 2.0)), 2)
                
                # Environmental sensors
                d["PM1"] = round(abs(float(rng.normal(6.5, 1.0))), 1)
                d["PM25"] = round(abs(float(rng.normal(14.0, 2.0))), 1)
                d["PM10"] = round(abs(float(rng.normal(25.0, 3.0))), 1)
                d["LUX"] = round(max(0.0, 35000 + alt * 5), 0)
                d["UV"] = round(max(0.0, 2.8 + alt * 0.001), 3)
                d["CO2"] = round(float(np.clip(415 + rng.normal(0, 10), 300, 2000)), 0)
                d["TVOC"] = round(abs(float(rng.normal(95, 15))), 0)
                d["ECO2"] = round(abs(float(rng.normal(430, 20))), 0)
                d["AQI"] = 2
                d["O3"] = round(abs(float(rng.normal(28, 4))), 1)
                d["HDC_T"] = round(temp, 2)
                d["HDC_RH"] = d["HUM_PCT"]
                
                # RF Link metrics
                d["RSSI"] = round(float(np.clip(-68 - alt * 0.02 + rng.normal(0, 1.5), -125, -45)), 1)
                d["SNR"] = round(float(np.clip(10.5 - alt * 0.004 + rng.normal(0, 0.8), -15, 14)), 1)
                d["FREQ_MHZ"] = LORA_FREQ_MHZ
                
                # Servos and health
                d["SERVO_V"] = 5.02
                d["SERVO_I_MA"] = 45.0 if st < 2 else 180.0
                d["SRV1_DEG"] = 90.0 if st >= 2 else 0.0
                d["SRV2_DEG"] = 90.0 if st >= 2 else 0.0
                d["SRV3_DEG"] = 60.0 if st >= 3 else 0.0
                d["SRV4_DEG"] = 60.0 if st >= 3 else 0.0
                d["MCU_ACTIVE"] = 0
                d["WDOG_OK"] = 1
                d["SD_PCT"] = round(min(100.0, pkt * 0.001), 3)
                d["FLASH_PCT"] = round(min(100.0, pkt * 0.002), 3)
                d["BEACON_ON"] = 1 if st == 4 else 0
                d["CAM1_OK"] = 1
                d["CAM2_OK"] = 1
                d["NAVIC_SATS"] = 6
                d["UTC"] = datetime.datetime.now().strftime("%Y-%m-%dT%H:%M:%S")
                d["HDOP"] = 1.15
                d["VDOP"] = 1.78
                d["FIX_QUALITY"] = 1
                d["GEOID_SEP"] = -43.2
                d["GNSS_SYS"] = 1 | 4 | 16 | 32
                
                # Spectral channels
                names = ["S_405", "S_425", "S_450", "S_475", "S_515", "S_550",
                         "S_555", "S_600", "S_640", "S_690", "S_745", "S_855"]
                for nm in names:
                    d[nm] = round(max(0.0, 110.0 + float(rng.normal(0, 5.0))), 2)
                d["S_CLR"] = round(sum(d[nm] for nm in names) * 0.8, 2)
                d["S_FLK"] = 100.0
                
                # Emit gateway status tag and CSV packet
                self.q.put(f"// [RX] #{pkt} 48B RSSI {d['RSSI']} SNR {d['SNR']} | missed=0 PER=0.0% rej=0")
                line = TEAM_ID + "," + serialize_packet(d, present)
                self.q.put(line)
                pkt += 1
                
            self._stop_evt.wait(1.0)

    def run(self):
        if self.port == "VIRTUAL_TEST":
            self._run_virtual_gateway()
            return

        backoff = 0
        while not self._stop_evt.is_set():
            if not self._open():
                self._stop_evt.wait(RECONNECT_BACKOFF[min(backoff, len(RECONNECT_BACKOFF) - 1)])
                backoff += 1
                continue
            backoff = 0
            try:
                while not self._stop_evt.is_set():
                    self._drain_tx()
                    try:
                        chunk = self._ser.read(1024)
                    except serial.SerialException:
                        log.warning("serial hardware detached")
                        self.status_cb("PORT_LOST")
                        break
                    except Exception as e:
                        log.warning("serial read error: %s, reconnecting", e)
                        self.status_cb("RECONNECTING")
                        break
                        
                    if not chunk:
                        continue
                    
                    self._buf.extend(chunk)
                    if len(self._buf) > 65536:
                        del self._buf[:32768]
                        
                    # Strict framing on newlines
                    while b"\n" in self._buf:
                        i = self._buf.index(b"\n")
                        frame = self._buf[:i]
                        del self._buf[:i + 1]
                        
                        try:
                            # Strip \r and decode cleanly
                            line = frame.decode("utf-8", "ignore").strip()
                            if line:
                                self.q.put_nowait(line)
                        except queue.Full:
                            # Drop oldest cleanly if bounded queue fills
                            try:
                                self.q.get_nowait()
                                self.q.put_nowait(line)
                            except queue.Empty:
                                pass
            finally:
                if self._ser:
                    try: 
                        self._ser.close()
                    except Exception: 
                        pass
                self._ser = None
                if not self._stop_evt.is_set():
                    self.status_cb("RECONNECTING")


class Simulator(threading.Thread):
    """Synthetic flight: BOOT -> LAUNCH -> EJECT -> SEC_EJECT -> TOUCHDOWN.

    Exercises the full 79-field packet including realistic sensor noise, so
    every panel and the limits engine can be verified without hardware.
    Supports both automated flight profile playback and real-time manual
    slider manipulation with fault injection.
    """

    def __init__(self, q, hz=SIM_HZ):
        super().__init__(daemon=True, name="Simulator")
        self.q = q
        self.hz = hz
        self._stop_evt = threading.Event()
        self.lat0, self.lon0 = SIM_SITE_LAT, SIM_SITE_LON
        self.manual_mode = False
        self.paused = False
        self.speed = 1.0
        self.sim_time = 0.0
        self._last_time = time.time()

        # Interactive overrides dictionary
        self.overrides = {
            "state": 0,
            "alt": 0.0,
            "vsp": 0.0,
            "roll": 0.0,
            "pitch": 0.0,
            "yaw": 0.0,
            "spin": 0.0,
            "bus_v": 12.2,
            "bus_i": 380.0,
            "soc": 98.0,
            "temp": 24.0,
            "pres": SEA_LEVEL_P_PA,
            "lat": SIM_SITE_LAT,
            "lon": SIM_SITE_LON,
            "sats": 12,
            "hdop": 1.1,
            "fix_quality": 1,
            "aqi": 2,
            "hum": 50.0,
            "co2": 420.0,
            "rssi": -65.0,
            "snr": 10.5,
        }

        # Fault injection sets
        self.fault_disconnect = set()
        self.fault_short = set()
        self.fault_freeze = set()
        self._frozen_cache = {}
        self.fault_halt_radio = False

    def stop(self):
        self._stop_evt.set()

    def set_manual(self, enable=True):
        self.manual_mode = bool(enable)

    def set_param(self, key, value):
        self.overrides[key] = value

    def set_preset(self, preset_dict):
        self.overrides.update(preset_dict)

    def set_speed(self, speed):
        self.speed = max(0.2, float(speed))

    def set_paused(self, paused):
        self.paused = bool(paused)

    def inject_disconnect(self, keys):
        if isinstance(keys, str):
            keys = [keys]
        self.fault_disconnect.update(keys)

    def inject_short(self, keys):
        if isinstance(keys, str):
            keys = [keys]
        self.fault_short.update(keys)

    def inject_freeze(self, keys):
        if isinstance(keys, str):
            keys = [keys]
        self.fault_freeze.update(keys)

    def clear_faults(self):
        self.fault_disconnect.clear()
        self.fault_short.clear()
        self.fault_freeze.clear()
        self._frozen_cache.clear()
        self.fault_halt_radio = False

    def _profile(self, t):
        """-> (state index, altitude AGL m, vertical speed m/s)."""
        if t < 8:
            return 0, 0.0, 0.0
        if t < 38:                       # powered ascent to ~700 m
            x = (t - 8) / 30.0
            return 1, 700.0 * (x ** 1.6), 700.0 * 1.6 * (x ** 0.6) / 30.0
        if t < 48:                       # coast / apogee
            x = (t - 38) / 10.0
            return 1, 700.0 + 60.0 * math.sin(math.pi * x / 2), 60.0 * math.cos(math.pi * x / 2) / 10.0
        if t < 60:                       # canister eject, primary chute
            return 2, max(0.0, 760.0 - 14.0 * (t - 48)), -14.0
        if t < 130:
            # Braked descent, rate chosen so altitude reaches exactly zero at
            # the touchdown boundary. A profile that still had hundreds of
            # metres left when it switched to TOUCHDOWN produced a step change
            # in altitude, and the baro differentiator turned that step into a
            # physically impossible -880 m/s vertical speed.
            rate = 592.0 / 70.0          # ~8.46 m/s over 70 s
            return 3, max(0.0, 592.0 - rate * (t - 60)), -rate
        return 4, 0.0, 0.0

    def run(self):
        self._last_time = time.time()
        pkt = 0
        rng = np.random.default_rng(20260726)
        while not self._stop_evt.is_set():
            now = time.time()
            dt = now - self._last_time
            self._last_time = now
            if not self.paused and not self.manual_mode:
                self.sim_time += dt * self.speed
            t = self.sim_time

            if self.fault_halt_radio:
                self._stop_evt.wait(1.0 / self.hz)
                continue

            if self.manual_mode:
                st = int(self.overrides.get("state", 0))
                alt = float(self.overrides.get("alt", 0.0))
                vsp = float(self.overrides.get("vsp", 0.0))
            else:
                st, alt, vsp = self._profile(t)

            pkt += 1

            d = OrderedDict((k, 0.0) for k in ALL_FIELDS)
            present = set()

            def put(k, v):
                if k in self.fault_disconnect:
                    return
                if k in self.fault_short:
                    v = 0.0
                if k in self.fault_freeze:
                    if k not in self._frozen_cache:
                        self._frozen_cache[k] = v
                    v = self._frozen_cache[k]
                d[k] = v
                present.add(k)

            # --- mandated core -------------------------------------------
            put("TIME_S", round(t, 2))
            put("PKT", pkt)

            if self.manual_mode:
                put("ALT_M", round(alt, 2))
                temp = float(self.overrides.get("temp", round(21.5 - 0.0065 * alt, 2)))
                pres = float(self.overrides.get("pres", round(SEA_LEVEL_P_PA * (1 - 2.25577e-5 * alt) ** 5.25588, 1)))
                bus_v = float(self.overrides.get("bus_v", 12.2))
                put("PRES_PA", round(pres, 1))
                put("TEMP_C", round(temp, 2))
                put("BUS_V", round(bus_v, 3))
                put("GNSS_TIME", round(t, 1))

                lat = float(self.overrides.get("lat", self.lat0))
                lon = float(self.overrides.get("lon", self.lon0))
                put("LAT", round(lat, 7))
                put("LON", round(lon, 7))
                put("GPS_ALT_M", round(alt + 4.2, 2))
                sats = int(self.overrides.get("sats", 12))
                put("SATS", sats)

                roll = float(self.overrides.get("roll", 0.0))
                pitch = float(self.overrides.get("pitch", 0.0))
                yaw = float(self.overrides.get("yaw", 0.0))
                spin = float(self.overrides.get("spin", 0.0))
                r_rad = math.radians(roll)
                p_rad = math.radians(pitch)
                cp = math.cos(p_rad)
                ax = -G_EARTH * cp * math.sin(r_rad)
                ay = G_EARTH * math.sin(p_rad)
                az = G_EARTH * cp * math.cos(r_rad)
                g_ax = ax + rng.normal(0, 0.02)
                g_ay = ay + rng.normal(0, 0.02)
                g_az = az + rng.normal(0, 0.02)
                put("ACC_X", round(g_ax, 3))
                put("ACC_Y", round(g_ay, 3))
                put("ACC_Z", round(g_az, 3))
                put("SPIN_RATE", round(spin, 2))
                put("STATE", st)

                hdg = math.radians(yaw)
                put("MX", round(24.0 * math.sin(hdg), 2))
                put("MY", round(24.0 * math.cos(hdg), 2))
                put("MZ", 38.0)
                put("GX", 0.0)
                put("GY", 0.0)
                put("GZ", round(spin, 2))
                put("AHX", round(ax / G_EARTH, 3))
                put("AHY", round(ay / G_EARTH, 3))
                put("AHZ", round(az / G_EARTH, 3))
                put("ATT_ROLL", round(roll, 2))
                put("ATT_PITCH", round(pitch, 2))

                bus_i = float(self.overrides.get("bus_i", 380.0))
                soc = float(self.overrides.get("soc", 98.0))
                put("BUS_I_MA", round(bus_i, 1))
                put("SOC_PCT", round(soc, 1))
                put("GND_SPEED", round(abs(vsp * 0.4), 2))
                put("HUM_PCT", float(self.overrides.get("hum", 50.0)))
            else:
                put("ALT_M", round(alt + rng.normal(0, 0.35), 2))
                temp = 21.5 - 0.0065 * alt + rng.normal(0, 0.15)
                pres = SEA_LEVEL_P_PA * (1 - 2.25577e-5 * alt) ** 5.25588
                put("PRES_PA", round(pres + rng.normal(0, 12), 1))
                put("TEMP_C", round(temp, 2))
                # 3S Li-Ion sagging under load across the flight
                bus_v = 12.35 - 0.0022 * t + rng.normal(0, 0.012)
                put("BUS_V", round(bus_v, 3))
                put("GNSS_TIME", round(t, 1))

                drift = t * 0.9
                put("LAT", round(self.lat0 + drift * 1.1e-5 + rng.normal(0, 3e-6), 7))
                put("LON", round(self.lon0 + drift * 1.7e-5 + rng.normal(0, 3e-6), 7))
                put("GPS_ALT_M", round(alt + 4.2 + rng.normal(0, 1.1), 2))
                put("SATS", int(np.clip(11 + rng.normal(0, 1.1), 4, 14)))

                spin = 0.0 if st == 0 else (95.0 if st >= 2 else 18.0)
                spin += rng.normal(0, 2.5)
                g_ax = rng.normal(0, 0.25)
                g_ay = rng.normal(0, 0.25)
                g_az = G_EARTH + (26.0 if 8 < t < 38 else 0.0) + rng.normal(0, 0.4)
                put("ACC_X", round(g_ax, 3))
                put("ACC_Y", round(g_ay, 3))
                put("ACC_Z", round(g_az, 3))
                put("SPIN_RATE", round(spin, 2))
                put("STATE", st)

                # --- payload --------------------------------------------------
                bus_i = 380 + (240 if st >= 2 else 0) + rng.normal(0, 22)
                put("BUS_I_MA", round(bus_i, 1))
                put("SOC_PCT", round(np.clip(97 - t * 0.09, 0, 100), 1))
                put("GND_SPEED", round(abs(rng.normal(6.5, 1.4)), 2))
                put("HUM_PCT", round(np.clip(46 + rng.normal(0, 2.2), 0, 100), 1))

                put("GX", round(rng.normal(0, 4.5), 2))
                put("GY", round(rng.normal(0, 4.5), 2))
                put("GZ", round(spin, 2))
                hdg = math.radians((t * 6.0) % 360.0)
                put("MX", round(24.0 * math.cos(hdg) + rng.normal(0, 0.5), 2))
                put("MY", round(24.0 * math.sin(hdg) + rng.normal(0, 0.5), 2))
                put("MZ", round(38.0 + rng.normal(0, 0.5), 2))
                put("AHX", round(g_ax / G_EARTH, 3))
                put("AHY", round(g_ay / G_EARTH, 3))
                put("AHZ", round(g_az / G_EARTH, 3))
                put("ATT_ROLL", 0.0)
                put("ATT_PITCH", 0.0)

            put("PM1",  round(abs(rng.normal(7.5, 1.6)), 1))
            put("PM25", round(abs(rng.normal(17.0, 3.4)), 1))
            put("PM10", round(abs(rng.normal(31.0, 5.5)), 1))
            put("LUX",  round(max(0.0, 42000 + alt * 7 + rng.normal(0, 900)), 0))
            put("UV",   round(max(0.0, 3.1 + alt * 0.0012 + rng.normal(0, 0.09)), 3))
            put("CO2",  round(np.clip(430 + rng.normal(0, 14), 300, 5000), 0))
            put("TVOC", round(abs(rng.normal(118, 22)), 0))
            put("ECO2", round(abs(rng.normal(465, 26)), 0))
            put("AQI",  int(np.clip(round(rng.normal(2.0, 0.5)), 1, 5)))
            put("O3",   round(abs(rng.normal(31, 5.5)), 1))
            put("HDC_T", round(temp + rng.normal(0, 0.06), 2))
            put("HDC_RH", round(np.clip(46 + rng.normal(0, 1.4), 0, 100), 2))

            if rng.random() < 0.012:
                put("LGT_DIST", round(rng.uniform(4, 38), 1))
                put("LGT_INT", round(rng.uniform(1000, 60000), 0))
                put("LGT_FLAG", 1)
            else:
                put("LGT_DIST", 0.0)
                put("LGT_INT", 0.0)
                put("LGT_FLAG", 0)

            # Solar spectrum shape across the AS7343 bands
            base = [0.34, 0.46, 0.63, 0.78, 0.93, 1.00, 0.99, 0.92,
                    0.86, 0.74, 0.61, 0.44]
            names = ["S_405", "S_425", "S_450", "S_475", "S_515", "S_550",
                     "S_555", "S_600", "S_640", "S_690", "S_745", "S_855"]
            scale = 128.0 * (1.0 + alt / 3200.0)
            for n, b in zip(names, base):
                put(n, round(max(0.0, b * scale + rng.normal(0, 2.4)), 2))
            put("S_CLR", round(sum(d[n] for n in names) * 0.82, 2))
            put("S_FLK", round(abs(rng.normal(100, 4)), 1))

            # Link degrades with slant range
            drift_val = t * 0.9 if not self.manual_mode else 10.0
            rng_m = math.sqrt(max(alt, 1.0) ** 2 + (drift_val * 1.6) ** 2)
            put("RSSI", round(np.clip(-42 - 20 * math.log10(max(rng_m, 1) / 10.0)
                                      + rng.normal(0, 2.0), -135, -30), 1))
            put("SNR", round(np.clip(11.5 - rng_m / 380.0 + rng.normal(0, 0.9),
                                     -20, 13), 2))
            put("FREQ_MHZ", LORA_FREQ_MHZ)

            put("SERVO_V", round(5.02 + rng.normal(0, 0.02), 3))
            put("SERVO_I_MA", round(abs(rng.normal(190 if st >= 2 else 45, 26)), 1))
            put("SRV1_DEG", 92.0 if st >= 2 else 0.0)
            put("SRV2_DEG", 92.0 if st >= 2 else 0.0)
            put("SRV3_DEG", 58.0 if st >= 3 else 0.0)
            put("SRV4_DEG", 58.0 if st >= 3 else 0.0)

            put("MCU_ACTIVE", 0)
            put("WDOG_OK", 1)
            put("SD_PCT", round(min(100.0, pkt * BYTES_PER_PACKET * 100.0 / SD_CAP_BYTES), 4))
            put("FLASH_PCT", round(min(100.0, pkt * BYTES_PER_PACKET * 100.0 / FLASH_CAP_BYTES), 3))
            put("BEACON_ON", 1 if st == 4 else 0)
            put("CAM1_OK", 1)
            put("CAM2_OK", 1)
            put("NAVIC_SATS", int(np.clip(5 + rng.normal(0, 0.9), 0, 9)))
            put("UTC", datetime.datetime.now().strftime("%Y-%m-%dT%H:%M:%S"))

            # ---- GNSS quality, as the Quectel L89 reports it -------------
            if self.manual_mode:
                hdop_val = float(self.overrides.get("hdop", 1.1))
                put("HDOP", round(hdop_val, 2))
                put("VDOP", round(hdop_val * 1.55, 2))
                put("FIX_QUALITY", int(self.overrides.get("fix_quality", 1)))
            else:
                n_sv = d["SATS"] + d["NAVIC_SATS"]
                hdop = np.clip(2.6 - 0.055 * n_sv - alt / 2600.0
                               + rng.normal(0, 0.06), 0.55, 6.0)
                put("HDOP", round(float(hdop), 2))
                put("VDOP", round(float(hdop * 1.55 + rng.normal(0, 0.05)), 2))
                sbas = t > 25.0 and n_sv >= 12
                put("FIX_QUALITY", 2 if sbas else 1)     # 2 = GAGAN/SBAS corrected

            put("GEOID_SEP", round(-43.2 + rng.normal(0, 0.05), 2))
            # GPS | GALILEO | QZSS | NavIC — the L89's concurrent set
            put("GNSS_SYS", 1 | 4 | 16 | 32)

            line = TEAM_ID + "," + serialize_packet(d, present)
            try:
                self.q.put_nowait(line)
            except queue.Full:
                pass
            self._stop_evt.wait(1.0 / self.hz)


# =========================================================================
# §9  QT IMPORTS + DESIGN SYSTEM
# =========================================================================
from PyQt5.QtCore import Qt, QTimer, QRectF, QPointF
from PyQt5.QtGui import (
    QFont, QFontDatabase, QColor, QPainter, QPen, QBrush, QPalette,
    QPainterPath, QPolygonF, QKeySequence,
)
from PyQt5.QtWidgets import (
    QApplication, QMainWindow, QWidget, QFrame, QLabel, QPushButton,
    QHBoxLayout, QVBoxLayout, QGridLayout, QTabWidget, QSizePolicy,
    QComboBox, QLineEdit, QPlainTextEdit, QMessageBox, QScrollArea,
    QCheckBox, QSpinBox, QDoubleSpinBox, QTableWidget, QTableWidgetItem,
    QHeaderView, QAbstractItemView, QShortcut,
    QSlider, QDialog, QGroupBox, QRadioButton, QButtonGroup, QSplitter,
    QProgressBar,
)
import pyqtgraph as pg

# pyqtgraph.opengl is deliberately NOT imported: it raises GLError 1282 on
# machines without a suitable GPU driver. The 3-D CanSat uses a software
# QPainter renderer, so the GCS runs on any laptop or VM in the field.


class T:
    """Design tokens — "austere base, science colour".

    Flight and engineering surfaces are monochrome. `amber` and `red` are
    reserved exclusively for limit breaches and staleness; `green` only for
    successful initialisation and confirmed uplink. Nothing else may use a
    saturated colour, so a real alarm never has to compete for attention.
    """

    black    = "#000000"      # canvas
    surf     = "#0a0a0a"      # canvas-night-soft: barely-lifted panel
    surf2    = "#121214"      # input wells, table stripes
    surf3    = "#1a1a1d"      # hover
    line     = "#3a3a3f"      # 1 px hairline
    line_dim = "#222226"      # internal rules, grid

    fg       = "#ffffff"      # on-primary
    fg2      = "#9a9aa2"      # secondary
    fg3      = "#5f5f68"      # labels, units
    fg4      = "#3f3f47"      # disabled / no-data

    amber    = "#ffb000"
    amber_d  = "#4a3300"
    red      = "#ff3b30"
    red_d    = "#4a1210"
    green    = "#30d158"
    green_d  = "#0d3a1c"
    cyan     = "#00d2ff"
    cyan_d   = "#003b4a"

    # Wavelength ramp for the AS7343 spectral bars: colour here encodes a
    # real physical dimension (405-855 nm), which is the one case the design
    # language permits.
    SPECTRAL = [
        "#7b2ff7", "#5b3df5", "#2f6bf0", "#1f9be8", "#26c281", "#7ed321",
        "#b8d117", "#f5c518", "#f59218", "#e8502a", "#c62828", "#8b1a1a",
    ]

    # Sequential ramp for science heat/intensity encodings (perceptually
    # ordered, dark-to-light so it reads correctly on black).
    SEQ = ["#12263a", "#1b4a6b", "#1f7a93", "#27a8a0", "#5fcf9a", "#b8e986"]

    FACE_DISPLAY = "Bahnschrift SemiCondensed"
    FACE_DISPLAY_ALT = "Bahnschrift"
    FACE_MONO = "Cascadia Mono"
    FACE_MONO_ALT = "Consolas"


_FONT_CACHE = {}


def font_display(pt=9, bold=False, tracking=1.2, caps=True):
    """Label/heading face. DIN-derived geometric sans, wide tracking and
    tight leading — the "engineer-tight" stack the design research
    describes."""
    key = ("d", pt, bold, tracking, caps)
    if key in _FONT_CACHE:
        return _FONT_CACHE[key]
    fams = QFontDatabase().families()
    fam = (T.FACE_DISPLAY if T.FACE_DISPLAY in fams
           else T.FACE_DISPLAY_ALT if T.FACE_DISPLAY_ALT in fams else "Segoe UI")
    f = QFont(fam)
    f.setPointSizeF(pt)
    f.setBold(bold)
    if tracking:
        f.setLetterSpacing(QFont.AbsoluteSpacing, tracking)
    if caps:
        f.setCapitalization(QFont.AllUppercase)
    _FONT_CACHE[key] = f
    return f
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
