itsmeabirmohanta/Sujal/(notices)

Notices in the files:
source/VRITRA_CanSat_025_Handover_2026-10-28/05_code/vritra-gcs-master_(CURRENT_repo)/README.md:
License: MIT
source/VRITRA_CanSat_025_Handover_2026-10-28/06_chats/aug_2026_ground_station_and_firmware/2026-08-02_1391088d.md:
install: check your student/commercial license entitlement file (or Ansys Licensing portal) to confirm which of these modules are actually authorized under your license — selecting a product you're not licensed for just wastes install space since it won't run anyway.
